frc971/electrical/README.md

This repo contains the electrical files for the 971 FRC team.
The files include PCBs and the electrical system diagrams.
The PCBs are created using KiCad.
