frc971/electrical/circuit-boards/Orin-NX-PCBs/MIPI2HDMI/README.md

Step file is made for mm and has .01mm accuracy.

Last Revision made on Nov 17 2023

For questions regarding the pcb or schematic contact Alex Lenkov or Scott Berman
