frc971/electrical/circuit-boards/IMU-2X-v3/IAM-20680HP-Orientation.png

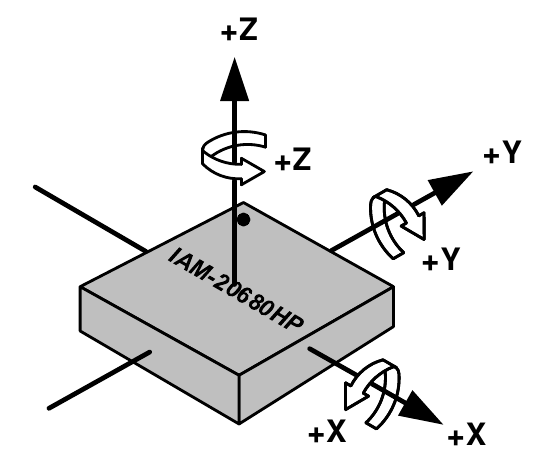
circuit-boards/IMU-2X-v3/IAM-20680HP-Orientation.png
