frc971/electrical/circuit-boards/IMU-2X-v3/SCHA63T-K03-Orientation.png

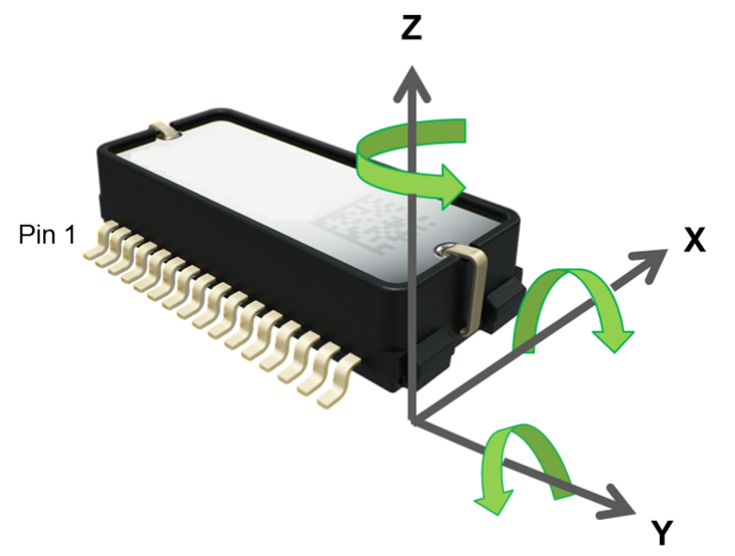
circuit-boards/IMU-2X-v3/SCHA63T-K03-Orientation.png
