frc971/electrical/circuit-boards/IMU-2X-v3/STM32G374CET6-Config.png

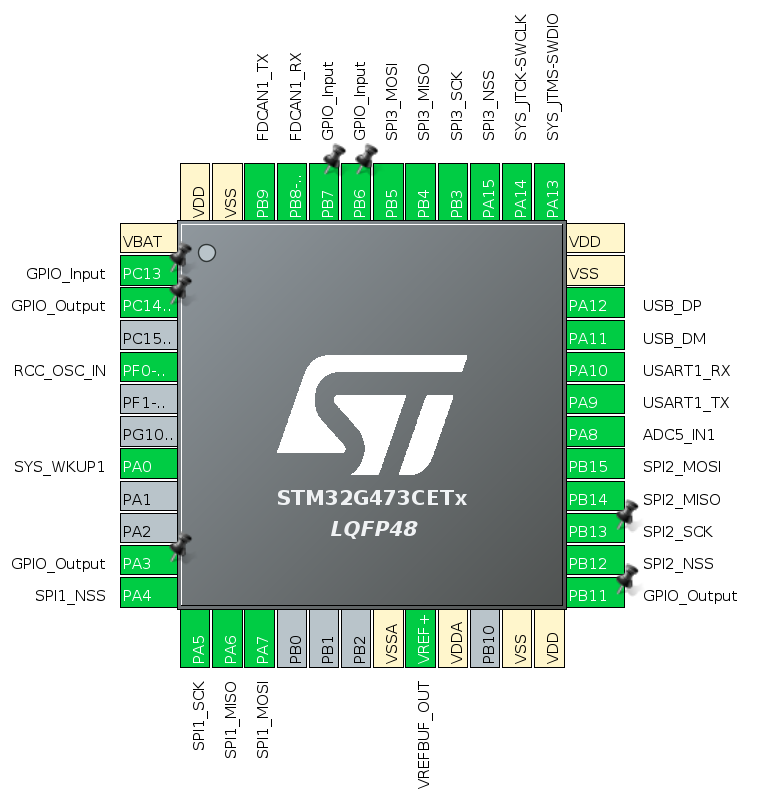
circuit-boards/IMU-2X-v3/STM32G374CET6-Config.png
