frc971/electrical/robots/2025/Driver Station/Harness Drawings/TX16S-Joystick-Input.png

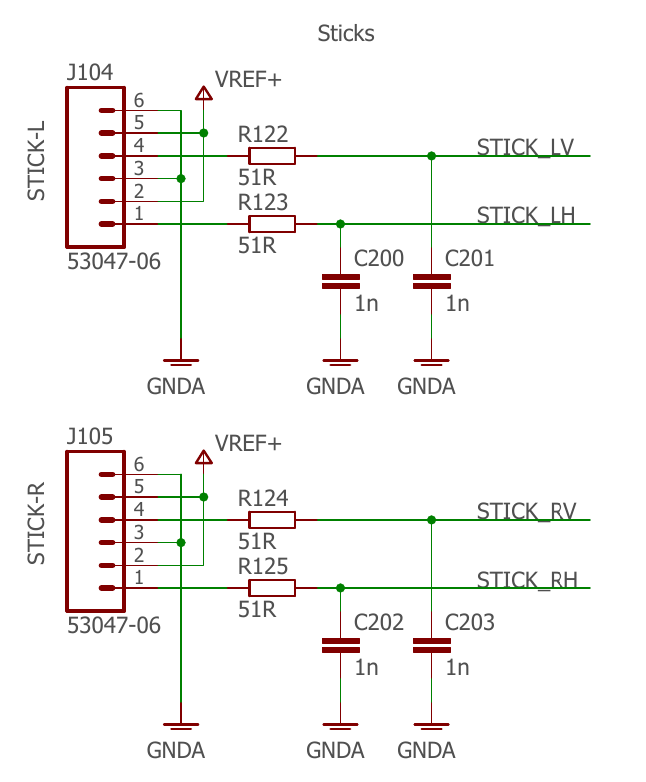
robots/2025/Driver Station/Harness Drawings/TX16S-Joystick-Input.png
