frc971/electrical/circuit-boards/IMU-2X-v3/Components/stm32-usb-c-pd-solutions-presentation.pdf

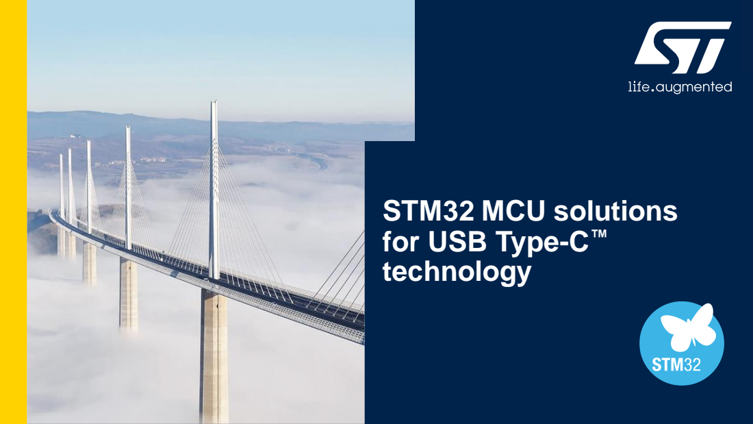
[picture p14: page 1]

STM32 MCU solutions
for USB Type-C™
technology

# Introduction to USB Type-C™ technology

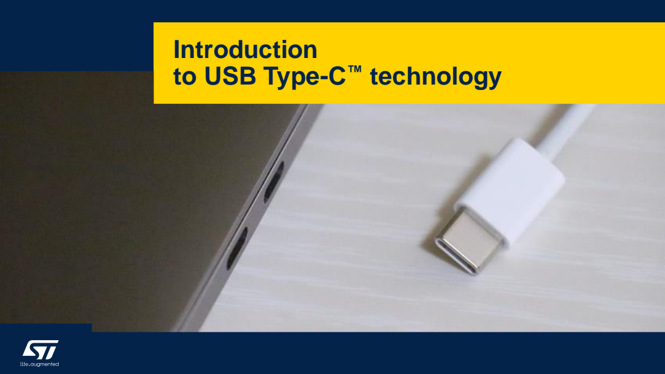
[picture p15: page 2]

# Visit our Wiki page on USB Type-C™

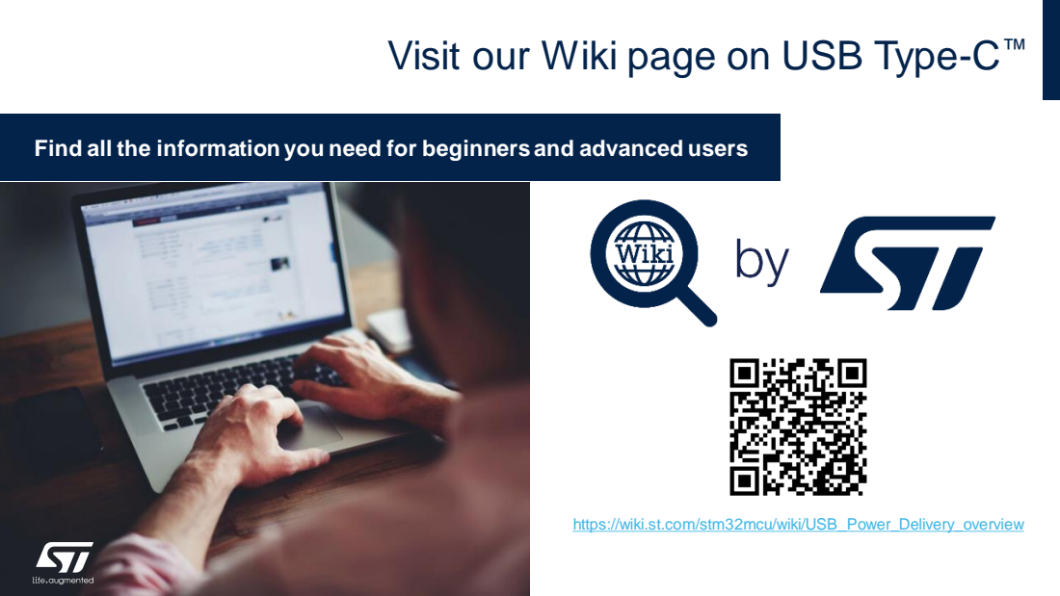
[picture p16: page 3]

Find all the information you need for beginners and advanced users

https://wiki.st.com/stm32mcu/wiki/USB_Power_Delivery_overview

# Main reasons to use USB Type-C™ in embedded devices

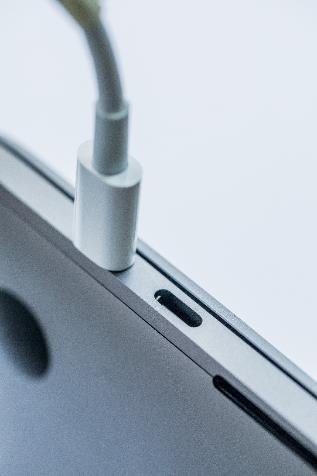
[picture p17: figure]

- Reversible, thinner and robust newest USB Type-C™ connector
- More interoperability: sink, source or dual role, while being host or device
- 15W @ 5V with Type-C only
- Up to 100W with USB Power Delivery (USB PD) 3.0 protocol
- Extend Power Range up to 240W @ 48V with USB PD 3.1
- Universal fast charging capability with PPS (Programming Power Supply)
- Separate channels for USB 2.0 (LS/FS/HS) and USB 3.x (SuperSpeed)
- Proprietary protocols are supported (DP, HDMI, Ethernet, Thunderbolt…)
- Device/source Authentication via USB PD (Vendor Define Messages)
- Firmware Update or Secure Firmware Install (SFI)
- Power swap capability (from sink to source or vise-versa)
- USB data swap capability (from device to host or vise versa as for OTG)

Purpose of the CC Channels: (Configuration & Communication channels): ➔ Manage the attachment of the
USB Type-C™ connector:
- Attach/detach and role management (Sink, Source, Dual Role Power) between two devices
- Discover and configure VBUS, VCONN
- Resolve cable orientation and twist connections to establish USB data bus routing
➔ Handle USB Power Delivery protocol

# USB Type-C™ pin outs functions

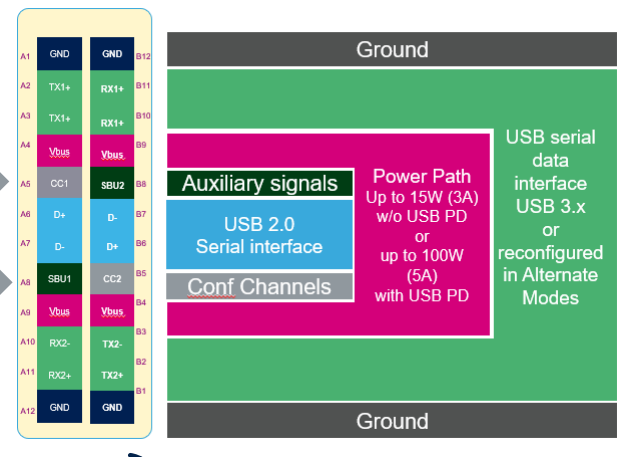
[picture p18: figure]

24-pin reversible USB Type-C™ receptacle

# USB Power Delivery

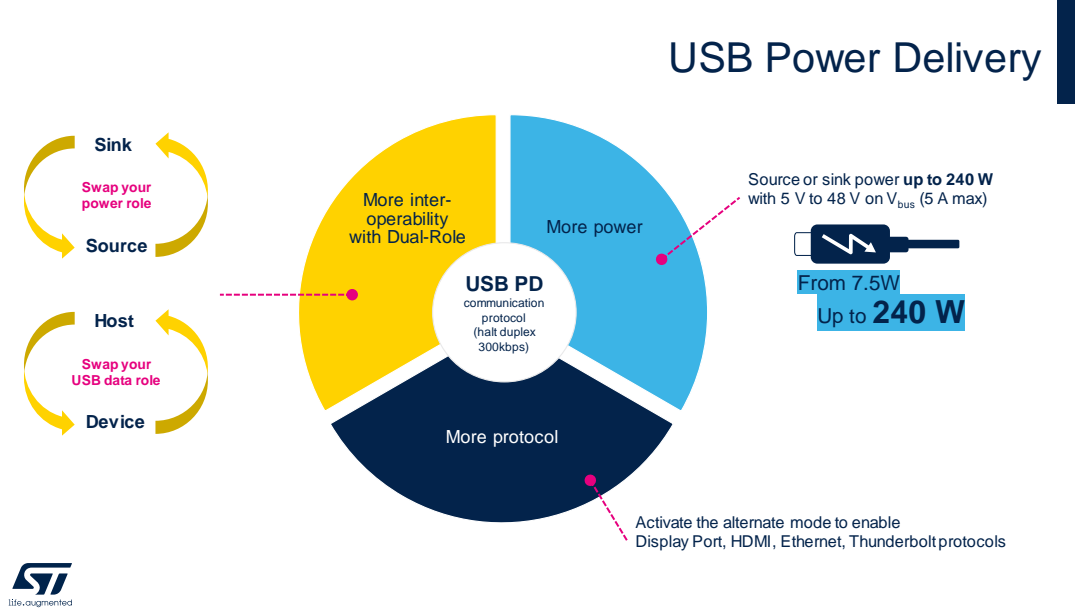
[picture p19: page 6]
More power; More protocol; USB PD; communication protocol (halt duplex 300kbps); Sink; Source; Swap your power role; Host; Device; From 7.5W

Source or sink power up to 240 W
with 5 V to 48 V on Vbus (5 A max)

More inter-
operability
with Dual-Role

Swap your
USB data role

Activate the alternate mode to enable
Display Port, HDMI, Ethernet, Thunderbolt protocols

# Main use-cases

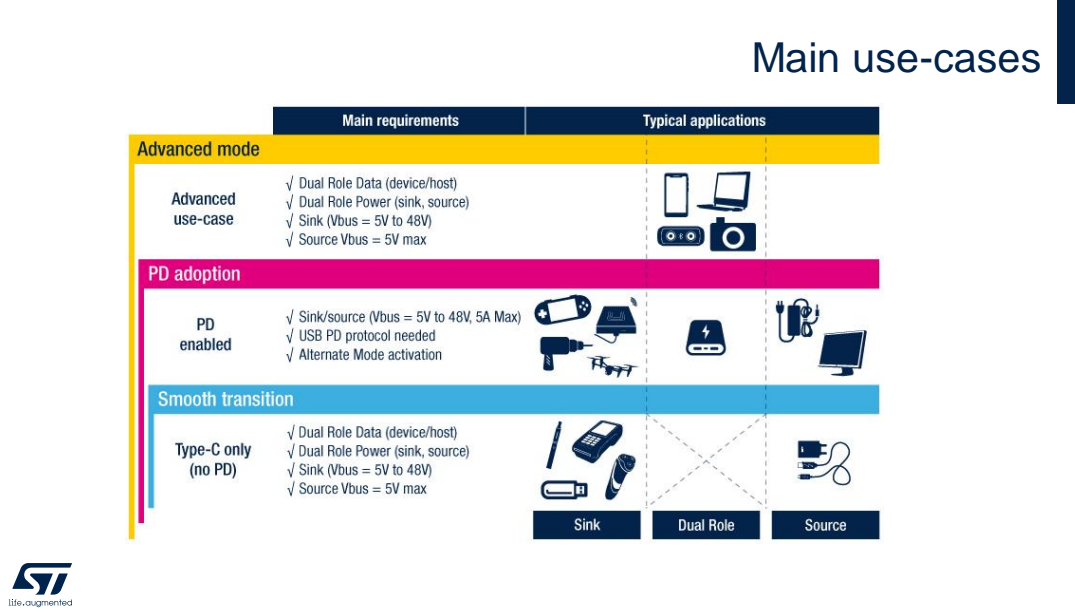
[picture p20: page 7]
Advanced mode; PD adoption; Smooth transition; Main requirements; Typical applications; Advanced use- case

• Dual Role Data (device/host) • Dual Role Power (sink, source) • Sink (Vbus = 5V to 48V) • Source Vbus = 5V max

PD enabled | • Sink/source (Vbus = 5v to 20v, 3A Max) • USB PD protocol needed • Alternate Mode activation

Type-C only (no PD) | • Connector reversibility • Attachment • Sink/source (Vbus = 5V, 3A Max) • USB 2.0 device or Host FS/HS Data

Sink | Dual Role | Source

- DRD is a category of devices such as smartphones and notebooks that can act as source or sink while being host or device for USB data communication purpose.
- It allows to extend interoperability by supporting advanced use-cases.
- Swap between power and data roles are done independently by using USB PD swap commands.
- DRD replaces and enhances “On-The-Go” becoming obsolete

# Dual Role Device (DRD)

Your Dual Role Device

Charger

no data

source

sink

Supply/recharge your device

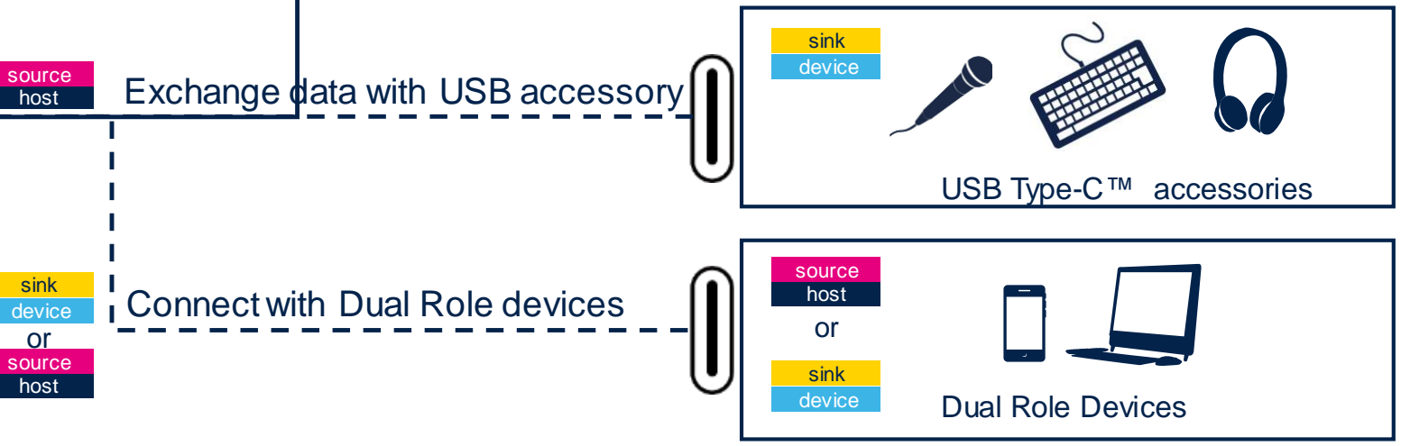
[picture p21: figure]
USB Type-C™ accessories; Dual Role Devices; device; sink; host; source; Exchange data with USB accessory; Connect with Dual Role devices

Sink

Source

Swap your
power role

Host

Device

Swap your
USB data role

# STM32 USB Type-C™ Solutions overview

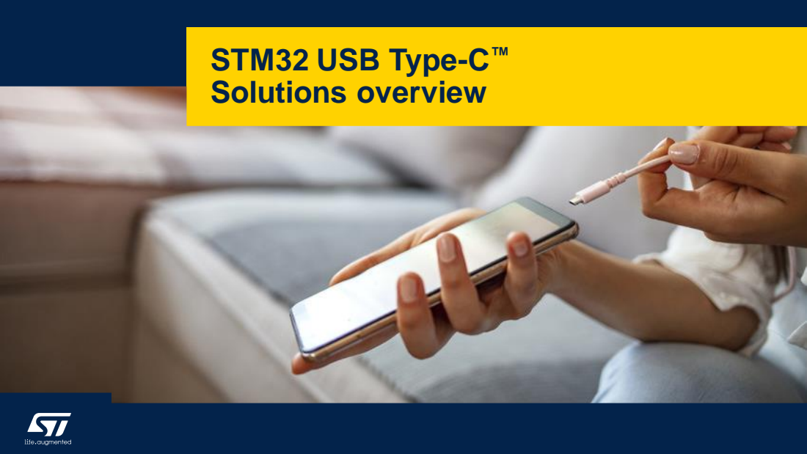
[picture p22: page 9]

# USB Type-C™ + PD3.1 Two solutions

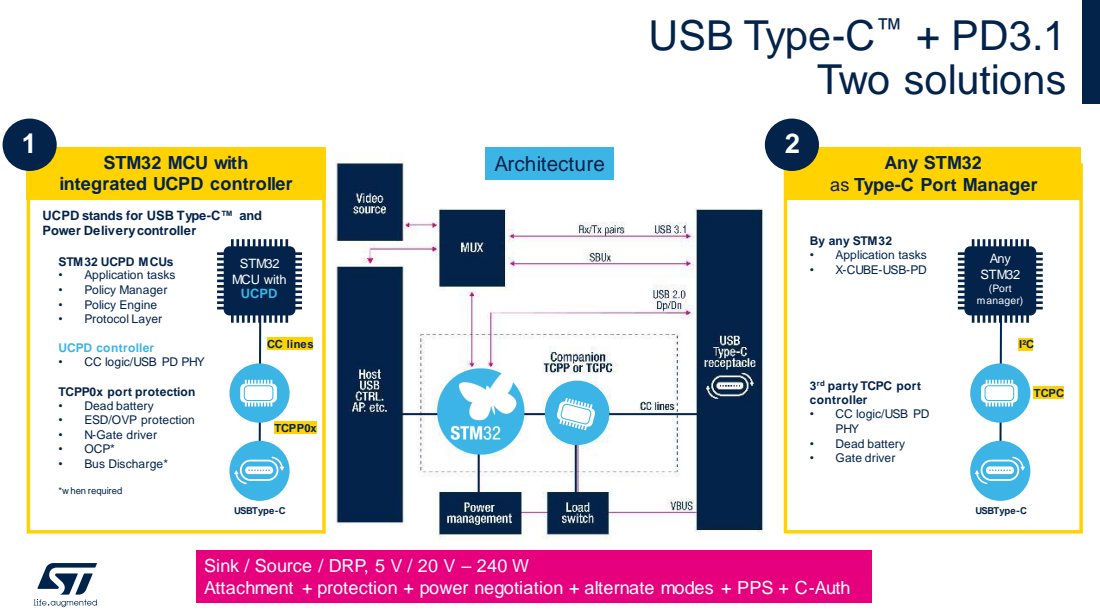
[picture p23: page 10]
Any STM32; STM32 UCPD MCUs • Application tasks • Policy Manager • Policy Engine • Protocol Layer; *w hen required; STM32 MCU with UCPD; CC lines; USBType-C; (Port manager); I²C; Architecture; TCPC; TCPP0x

STM32 MCU with
integrated UCPD controller

as Type-C Port Manager

UCPD stands for USB Type-C™ and
Power Delivery controller

By any STM32
• Application tasks
• X-CUBE-USB-PD

UCPD controller
• CC logic/USB PD PHY

TCPP0x port protection
• Dead battery
• ESD/OVP protection
• N-Gate driver
• OCP*
• Bus Discharge*

rd party TCPC port
controller
• CC logic/USB PD
PHY
• Gate driver

Sink / Source / DRP, 5 V / 20 V – 240 W
Attachment + protection + power negotiation + alternate modes + PPS + C-Auth

# Solution N°1: using STM32 MCU with integrated UCPD* controller

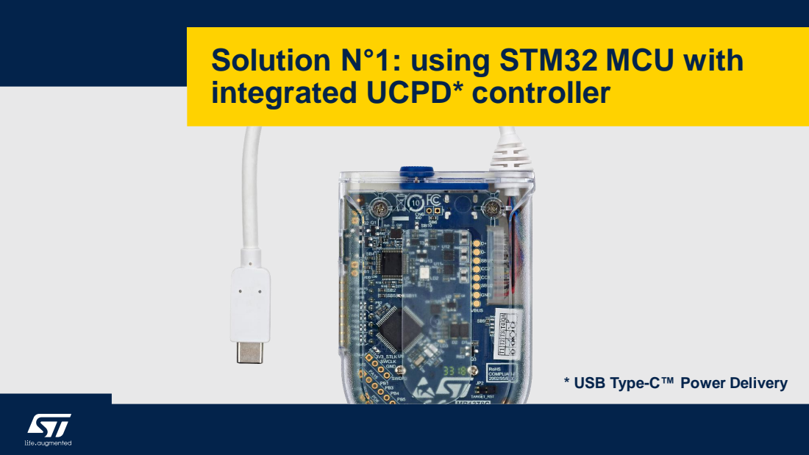
[picture p24: page 11]

* USB Type-C™ Power Delivery

# STM32, World 1st MCU with built-in UCPD controller

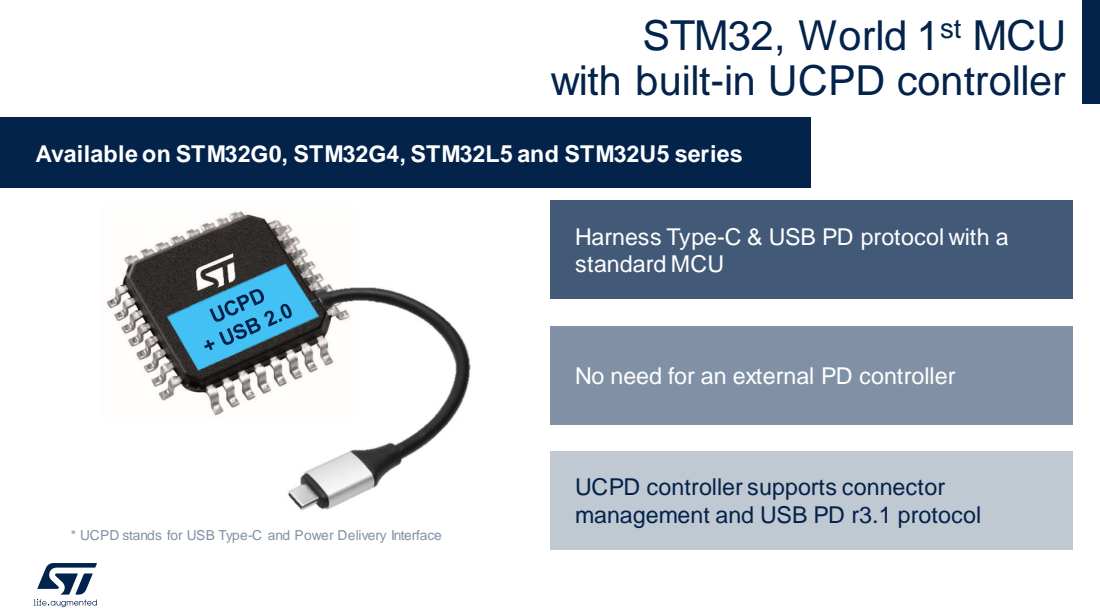
[picture p25: page 12]

Available on STM32G0, STM32G4, STM32L5 and STM32U5 series

Harness Type-C & USB PD protocol with a
standard MCU

No need for an external PD controller

UCPD controller supports connector
management and USB PD r3.1 protocol

* UCPD stands for USB Type-C and Power Delivery Interface

# Wide Range of STM32 UCPD MCUs

More than 411 Part Numbers propose UCPD
among STM32G0, STM32G4, STM32L5, STM32U5 series

1

st High Perf.
120 MHz, 90nm

2010

STM32F2

1

st High Perf.
Cortex-M4
168 MHz

2011

STM32F4

1

st Mixed Signal
DSP + Analog
STM32F3
Cortex-M4

Entry Cost
STM32F0
Cortex-M0

2012

STM32F0

STM32F3

Entry Cost
Ultra-low-power

2013

STM32L0

World 1st
Cortex-M7

2014

STM32F7

Leadership
Ultra-low-power
Cortex-M4
#1 ULP

447 ULPBench™

2015

STM32L4

#1

Performance
3224 CoreMark

Ultra-low-power
Excellence

2016

STM32L4+

STM32H7

Dual-core,
multiprotocol
and open radio

Introduction of
M33 Excellence
in ULP with
more security

Mainstream
Cortex-M0+
MCUs Efficiency
at its best!

2017/2018

STM32WB

STM32L5

STM32G0

2019

Dual-core
Microprocessor
among the STM32

World’s Most
Powerful MCU

STM32H7

STM32G4

STM32MP1

Mixed-signal
Cortex-M4
MCUs

2020

The world’s first
LoRa®-enabled
System-on-Chip

STM32WL

2007*/2009

World 1st
Cortex-M MCU

STM32F1*

World 1st
Cortex-M
Ultra-low-power

STM32L1

The flagship
ultra-low-power
MCUs

STM32U5

2021

# Find UCPD ready STM32 easily with STM32Finder app

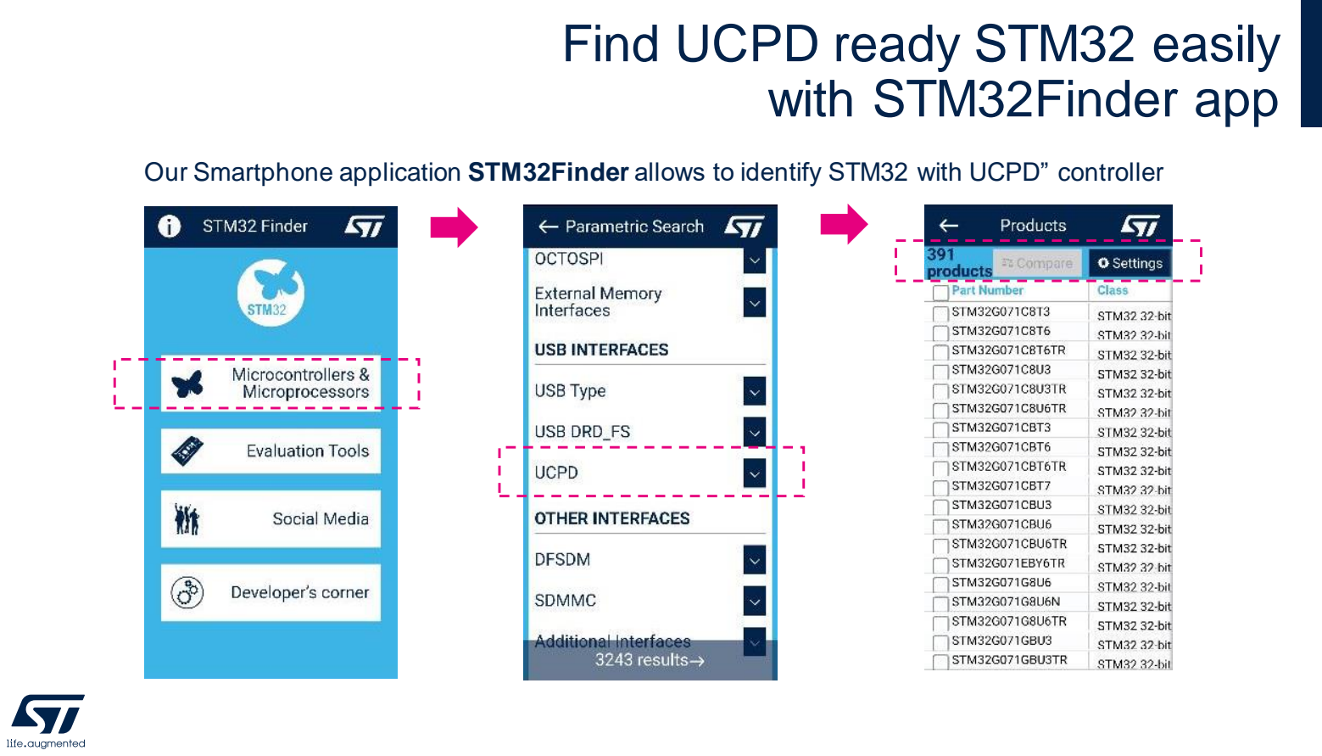
[picture p26: page 14]

Our Smartphone application STM32Finder allows to identify STM32 with UCPD” controller

# UCPD highlights

Example in STM32G0x1 access line

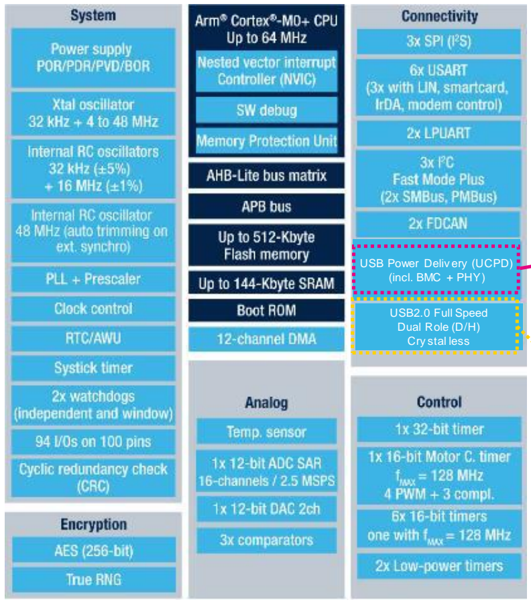
[picture p27: figure]
USB Power Deliv ery (UCPD) (incl. BMC + PHY); USB2.0 Full Speed Dual Role (D/H) Cry stal less

- Dual port certified solution (TID 227)
- Support sink, source and Dual Role
- CC logic control and voltage monitoring
- Built-in Rp/Rd and dead battery resistors
- USB PD transceiver PHY
- Digital BMC / CRC encoding/decoding
- Support Programming Power Supply (PPS)
- Enable Fast Role Swap signaling (FRS)

USB2.0 Dual Role Data interface

UCPD main features

- USB2.0 data interface (FS, HS)
- Dual-Role mode supported (Device/Host)
- Crystal-less

x 2

# Cost effective partitioning with USB Type-C™ Port Protection devices

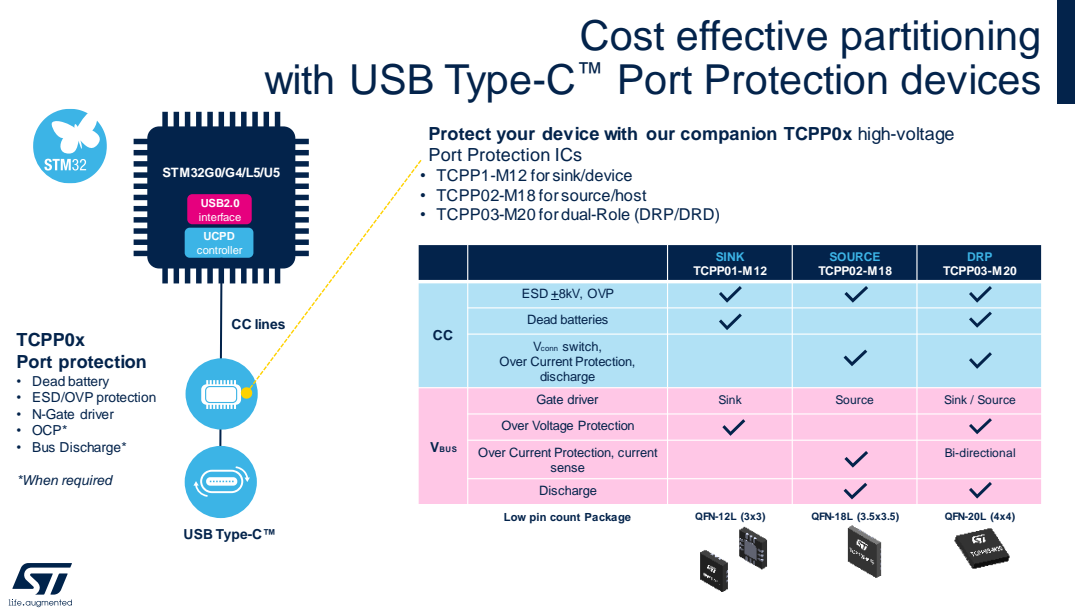
[picture p28: page 16]
STM32G0/G4/L5/U5; USB2.0 interface; UCPD controller; CC lines; USB Type-C™; *When required

Protect your device with our companion TCPP0x high-voltage
Port Protection ICs
• TCPP1-M12 for sink/device
• TCPP02-M18 for source/host
• TCPP03-M20 for dual-Role (DRP/DRD)

SINK TCPP01-M12 | SOURCE TCPP02-M18 | DRP TCPP03-M20

CC | ESD +8kV, OVP

Dead batteries

TCPP0x
Port protection
• Dead battery
• ESD/OVP protection
• N-Gate driver
• OCP*
• Bus Discharge*

Vconn switch, Over Current Protection, discharge

VBUS | Gate driver | Sink | Source | Sink / Source

Over Voltage Protection

Over Current Protection, current sense | | | Bi-directional

Discharge

Low pin count Package | QFN-12L (3x3) | QFN-18L (3.5x3.5) | QFN-20L (4x4)

# Sink with TCPP01-M12

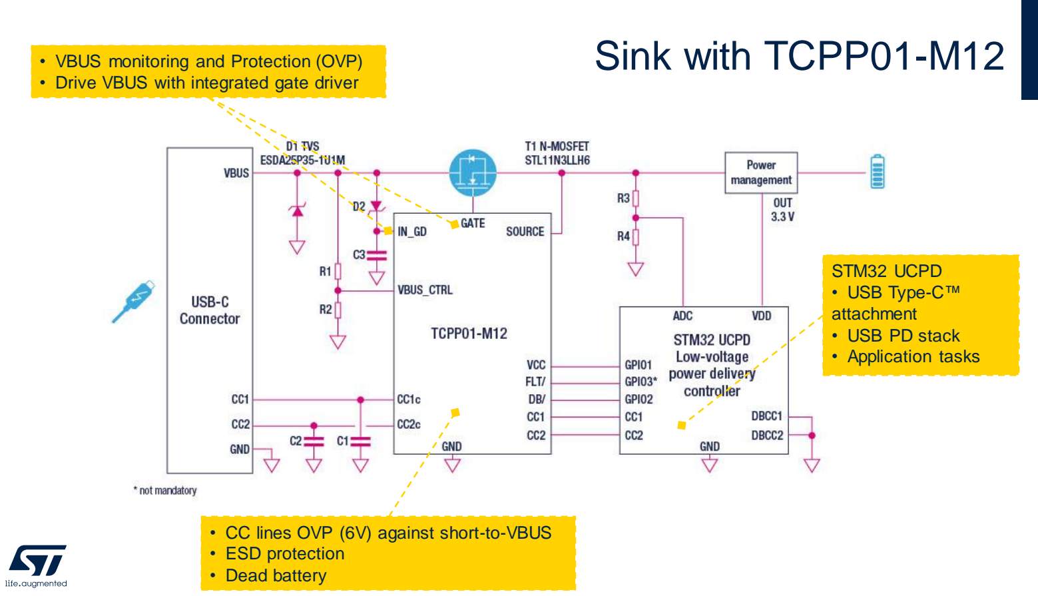
[picture p29: page 17]

- CC lines OVP (6V) against short-to-VBUS
- ESD protection
- Dead battery
- VBUS monitoring and Protection (OVP)
- Drive VBUS with integrated gate driver

STM32 UCPD
- USB Type-C™
attachment
- USB PD stack
- Application tasks

# Dual Role with TCPP03-M20

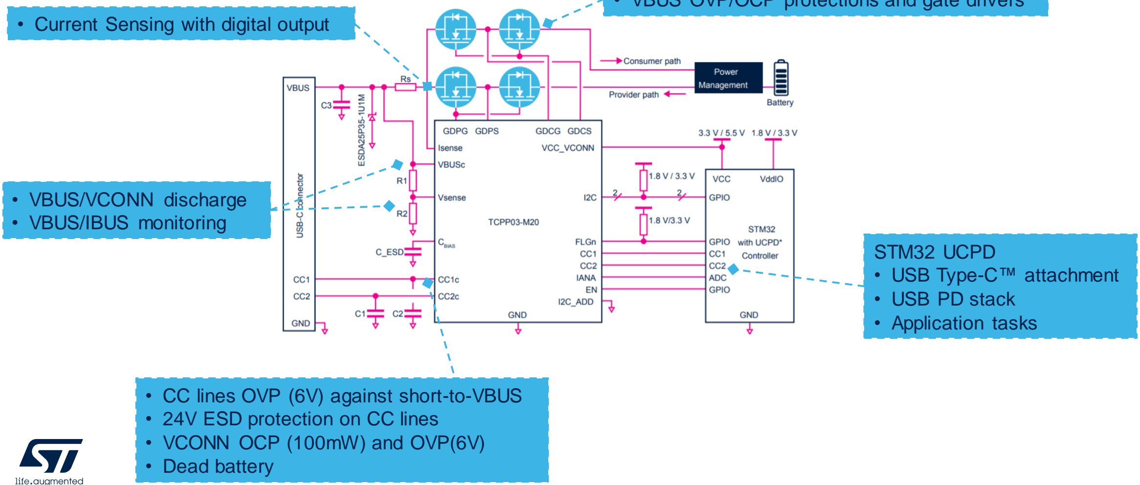
[picture p30: figure]
• 24V ESD protection on CC lines • VCONN OCP (100mW) and OVP(6V) • Dead battery; STM32 UCPD • USB Type-C™ attachment • USB PD stack • Application tasks; • VBUS/VCONN discharge • VBUS/IBUS monitoring; • Current Sensing with digital output

- CC lines OVP (6V) against short-to-VBUS
- VBUS OVP/OCP protections and gate drivers

# Source with TCPP02-M18

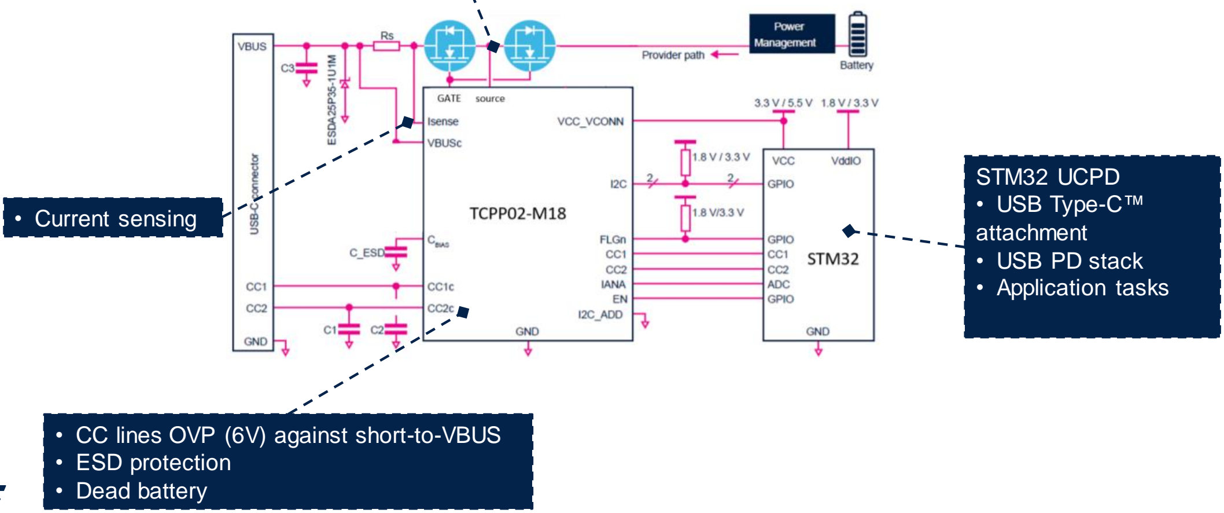
[picture p31: figure]
• ESD protection • Dead battery; STM32 UCPD • USB Type-C™ attachment • USB PD stack • Application tasks; • Current sensing

- CC lines OVP (6V) against short-to-VBUS
- VBUS monitoring, OVP/OCP protections
- Integrated gate driver
- Integrated discharge for VBUS and VCONN

# Quick evaluation with STM32 Nucleo USB Type-C™ expansion boards

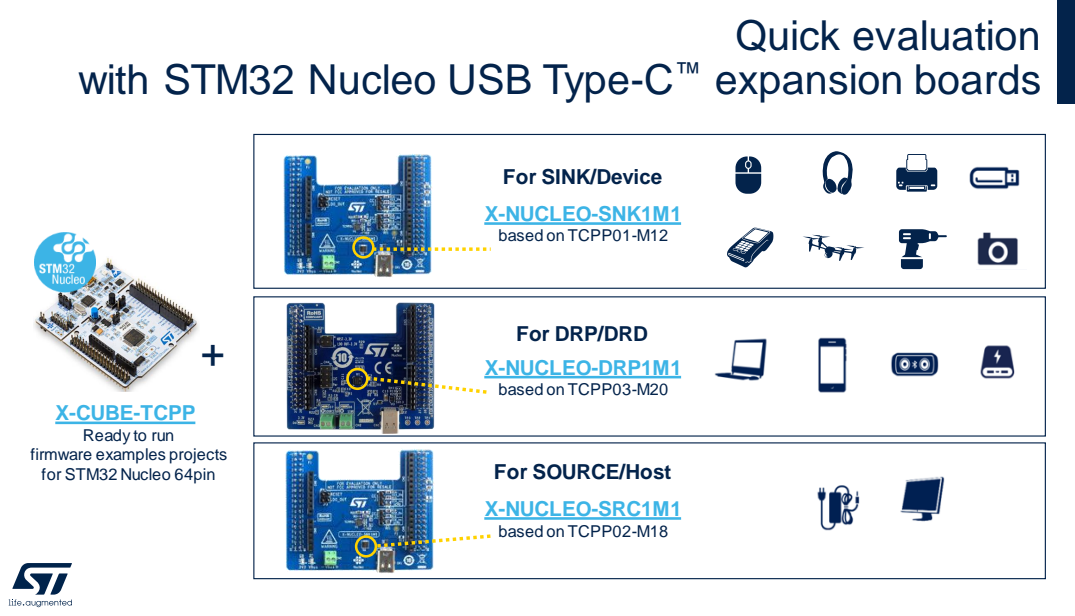
[picture p32: page 20]

For SINK/Device
X-NUCLEO-SNK1M1 (https://www.st.com/en/ecosystems/x-nucleo-snk1m1.html)
based on TCPP01-M12

For DRP/DRD
X-NUCLEO-DRP1M1 (https://www.st.com/content/st_com/en/products/ecosystems/stm32-open-development-environment/stm32-nucleo-expansion-boards/stm32-ode-connect-hw/x-nucleo-drp1m1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)
based on TCPP03-M20

X-CUBE-TCPP (https://www.st.com/en/embedded-software/x-cube-tcpp.html)
Ready to run

firmware examples projects
for STM32 Nucleo 64pin

For SOURCE/Host
X-NUCLEO-SRC1M1 (https://www.st.com/content/ccc/resource/technical/document/user_manual/group2/bf/f2/69/55/78/a6/47/1a/DM00841905/files/DM00841905.pdf/jcr:content/translations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)
based on TCPP02-M18

# Fast development with STM32Cube USB Type-C™ ecosystem

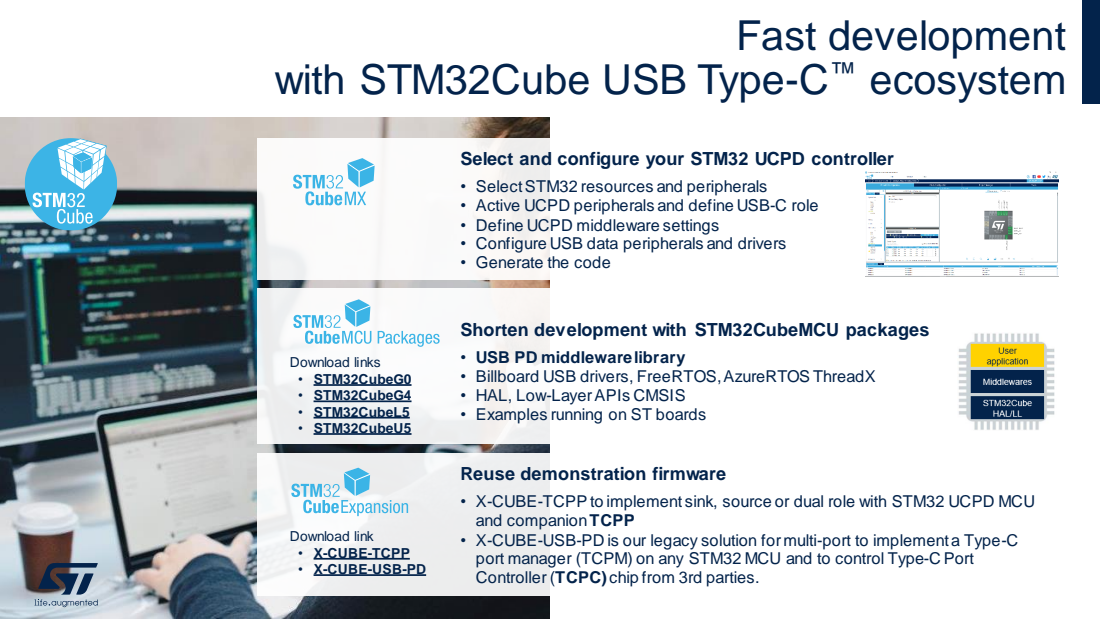
[picture p33: page 21]
Download links • STM32CubeG0 • STM32CubeG4 • STM32CubeL5 • STM32CubeU5; Controller (TCPC) chip from 3rd parties.

Select and configure your STM32 UCPD controller
• Select STM32 resources and peripherals
• Active UCPD peripherals and define USB-C role
• Define UCPD middleware settings
• Configure USB data peripherals and drivers
• Generate the code

Shorten development with STM32CubeMCU packages
• USB PD middleware library
• Billboard USB drivers, FreeRTOS, AzureRTOS ThreadX
• HAL, Low-Layer APIs CMSIS
• Examples running on ST boards

Reuse demonstration firmware
• X-CUBE-TCPP to implement sink, source or dual role with STM32 UCPD MCU
and companion TCPP
• X-CUBE-USB-PD is our legacy solution for multi-port to implement a Type-C
port manager (TCPM) on any STM32 MCU and to control Type-C Port

Download link
• X-CUBE-TCPP (https://www.st.com/en/embedded-software/x-cube-tcpp.html)
• X-CUBE-USB-PD (https://www.st.com/content/st_com/en/products/embedded-software/mcu-mpu-embedded-software/stm32-embedded-software/stm32cube-expansion-packages/x-cube-usb-pd.h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)

# Monitor your design with STM32 USB Type-C™ tools

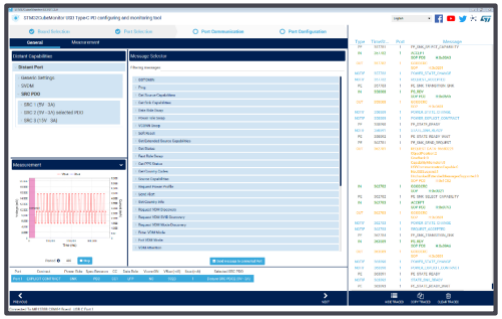
[picture p34: figure]

STM32CubeMonUCPD, (https://www.st.com/en/development-tools/stm32cubemonucpd.html) a free software monitoring and configuring tools for USB Type-C™ applications

- Support of USB Type-C™1.2 and USB PD r3.1
- Port configuration pane for PD setting, VDM, SOP, Source and Sink Capabilities
- Port communication pane for VBUS and IBUS monitoring, distant port capabilities, message selector, and real-time traces

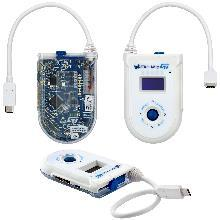
[picture p35: figure]

STM32G071B-DISCO (https://www.st.com/en/evaluation-tools/stm32g071b-disco.html) is a USB Type-C™ and PD sniffer

- Discover, display USB Type-C™power and feature capabilities of any host.
- Sniff USB PD data packets and display Vbus voltage, Ibus current
- Debug, configure and inject USB PD3.1 packet using STM32CubeMonitor UCPD

# Hardware tools & reference designs

SOLUTIONS | STM32F0 | STM32G0 | STM32G4 | STM32L5 | STM32U5
USB Type-C™ to DisplayPort™ adapter | STEVAL-USBC2DP (https://www.st.com/content/st_com/en/products/evaluation-tools/solution-evaluation-tools/communication-and-connectivity-solution-eval-boards/steval-usbc2dp.html)
TCPM/TCPC | ON-FUSB3-STM32 (https://www.st.com/content/st_com/en/products/evaluation-tools/product-evaluation-tools/mcu-mpu-eval-tools/stm32-mcu-mpu-eval-tools/stm32-3rd-party-evaluation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) (with 3rd party TCPC)
AC/DC USB PD Power Adapter | STEVAL-USBPD45C (https://www.st.com/content/st_com/en/products/evaluation-tools/solution-evaluation-tools/psu-and-converter-solution-eval-boards/steval-usbpd45c.html) (45W) | STEVAL-USBPD27S (https://www.st.com/content/st_com/en/products/evaluation-tools/solution-evaluation-tools/psu-and-converter-solution-eval-boards/steval-usbpd27s.html) (27W / PPS ready) STEVAL-2STPD01 (https://www.st.com/en/evaluation-tools/steval-2stpd01.html) (2x 60W)
USB Type-C™ Discovery kits | | STM32G071B-DISCO (https://www.st.com/content/st_com/en/products/evaluation-tools/product-evaluation-tools/mcu-mpu-eval-tools/stm32-mcu-mpu-eval-tools/stm32-discovery-kits/stm32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) (USB-C Sniffer/Analyzer) | B-G474E-DPOW1 (https://www.st.com/content/st_com/en/products/evaluation-tools/product-evaluation-tools/mcu-mpu-eval-tools/stm32-mcu-mpu-eval-tools/stm32-discovery-kits/b-g47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) 1 port DRP | STM32L562E-DK (https://www.st.com/en/evaluation-tools/stm32l562e-dk.html) 1 port SNK | B-U585I-IOT02A (https://www.st.com/en/evaluation-tools/b-u585i-iot02a.html) 1 port DRP
Evaluation boards | | STM32G0C1E-EV (https://www.st.com/content/st_com/en/products/evaluation-tools/product-evaluation-tools/mcu-mpu-eval-tools/stm32-mcu-mpu-eval-tools/stm32-eval-boards/stm32g08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) 1 port 45W DRP 1 port Sink | STM32G474E-EVAL (https://www.st.com/content/st_com/en/products/evaluation-tools/product-evaluation-tools/mcu-mpu-eval-tools/stm32-mcu-mpu-eval-tools/stm32-eval-boards/stm32g47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) featuring 1 port DRP | STM32L552E-EVAL (https://www.st.com/en/evaluation-tools/stm32l552e-ev.html) 1 port SNK | STM32U575I-EV (https://www.st.com/en/evaluation-tools/stm32u575i-ev.html) 1 port DRP
Nucleo board Nucleo shield | P-NUCLEO-USB002 (https://www.st.com/content/st_com/en/products/evaluation-tools/solution-evaluation-tools/communication-and-connectivity-solution-eval-boards/p-nucleo-usb002.h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) 1 port DRP with STM32F072RBT6 + STUSB1602 | X-NUCLEO-SNK1M1 (https://www.st.com/content/st_com/en/products/ecosystems/stm32-open-development-environment/stm32-nucleo-expansion-boards/stm32-ode-power-drive-hw/x-nucleo-us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) X-NUCLEO-DRP1M1 (https://www.st.com/content/st_com/en/products/ecosystems/stm32-open-development-environment/stm32-nucleo-expansion-boards/stm32-ode-connect-hw/x-nucleo-drp1m1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) X-NUCLEO-SRC1M1 (https://www.st.com/en/ecosystems/x-nucleo-src1m1.html) | X-NUCLEO-SNK1M1 X-NUCLEO-DRP1M1 (https://www.st.com/content/st_com/en/products/ecosystems/stm32-open-development-environment/stm32-nucleo-expansion-boards/stm32-ode-connect-hw/x-nucleo-drp1m1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) X-NUCLEO-SRC1M1 (https://www.st.com/en/ecosystems/x-nucleo-src1m1.html) | NUCLEO-L552ZE-Q (https://www.st.com/content/st_com/en/products/evaluation-tools/product-evaluation-tools/mcu-mpu-eval-tools/stm32-mcu-mpu-eval-tools/stm32-nucleo-boards/nucleo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) 1 port SNK | NUCLEO-U575ZI-Q (https://www.st.com/en/evaluation-tools/nucleo-u575zi-q.html) 1 port SNK

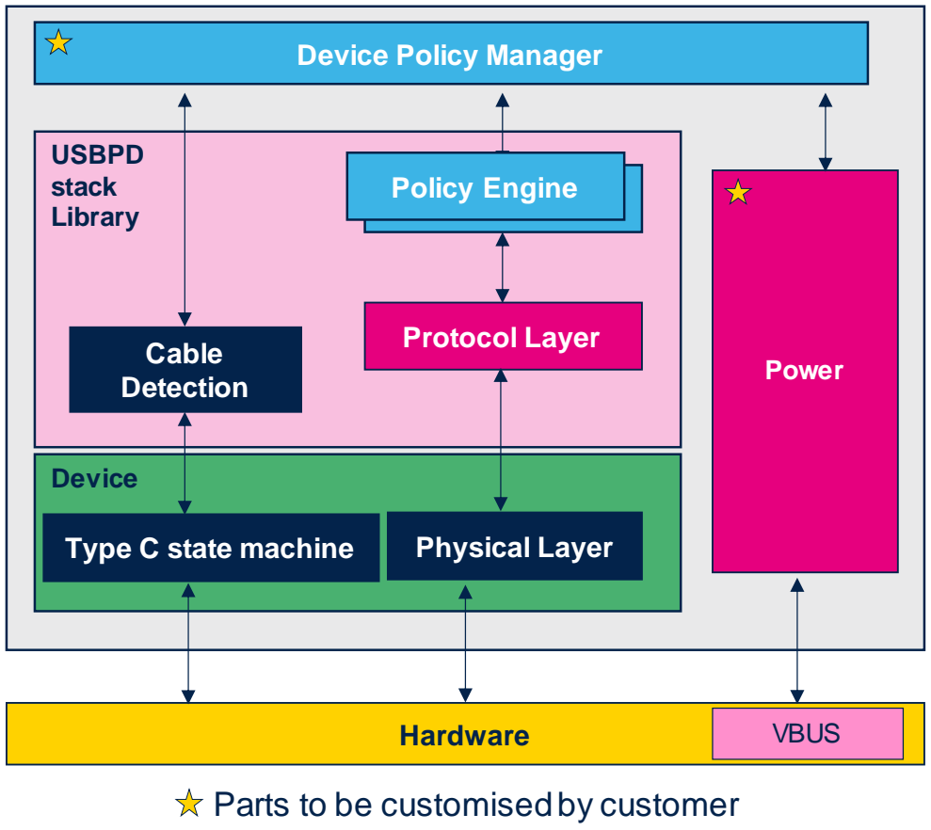
[picture p36: figure]
Device; Power; USBPD stack Library; Device Policy Manager; Policy Engine; Protocol Layer; Hardware; VBUS; Cable Detection; Type C state machine; Physical Layer; Parts to be customisedby customer

- Available in STM32CubeMCU packages
- Compliant with USB Type-C™ 1.2 and USB PD r3.1
- Embeds the Policy Engine, Protocol Layer, Physical Layer, USB-C port Control
- Applies for STM32 UCPD or TCPM/TCPC implementation
- Policy engine includes 3 state machines (SRC, SNK, cable).
- User application customization is done in the Device Policy manager
- A set of API (get VBUS, set VBUS) and utilities (tracer, low power manager, power monitor) are available for maximum of usability

# High level of customization with ST USBPD Middleware

# USB PD power adapter

### 27 W PD3.0/PPS Power adapter with STM32G0

Key Features
- Universal input mains voltage range
- Two fixed PDOs: 5V @ 5A, 9V @ 3A
- Two APDOs for PPS
- Adaptive synchronous rectification, MCU-driven
- Energy efficiency compliant with CoC Tier 2 and DoE Level VI
- Full Load Efficiency 89,4% at 230VAC input
- < 40 mW no-load standby power

Key Products
- Primary Side Controller: STCH03
- USB PD and SR Controller: STM32G0
- Primary MOSFET: STD7N65M6, Load Switch: STL11N3LLH6
- ESD and CC Lines protections + Gate Driver: TCPP01-M12

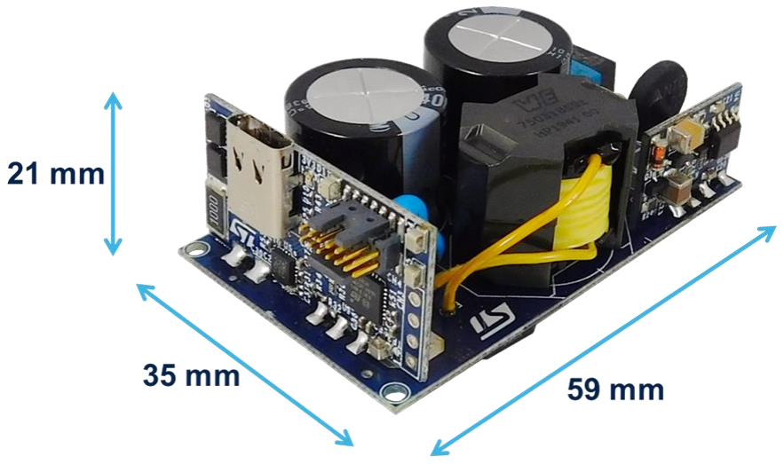
[picture p37: figure]

- High performance LDO: LDK320 | Board ref: STEVAL-USBPD27S (https://www.st.com/en/evaluation-tools/steval-2stpd01.html)

# Step by Step tutorial

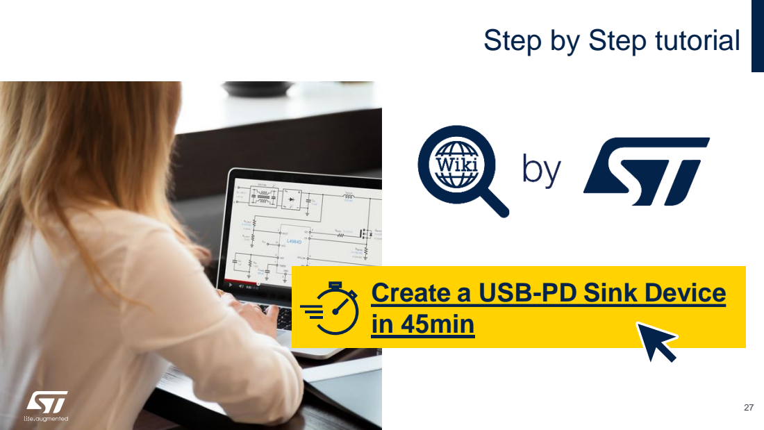
[picture p38: page 26]

Create a USB-PD Sink Device
in 45min (https://wiki.st.com/stm32mcu/wiki/STM32StepByStep:STM32_Advance_USB-Power_Delivery_Sink)

# Solution N°2 STM32 as Type-C Port Manager

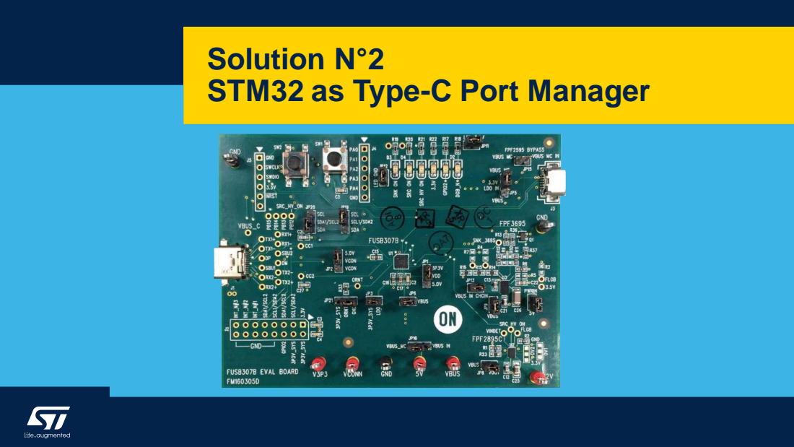
[picture p39: page 27]

# X-CUBE-USB-PD for Type-C Port Manager on any STM32

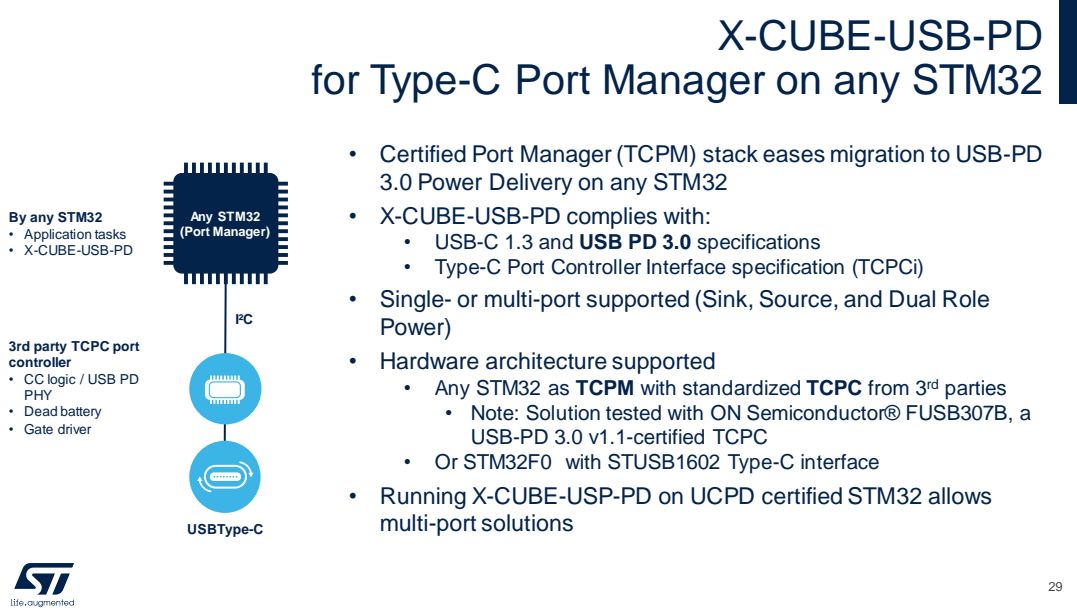
[picture p40: page 28]
Any STM32 (Port Manager); I²C; USBType-C

• Certified Port Manager (TCPM) stack eases migration to USB-PD
3.0 Power Delivery on any STM32
• X-CUBE-USB-PD complies with:
• USB-C 1.3 and USB PD 3.0 specifications
• Type-C Port Controller Interface specification (TCPCi)
• Single- or multi-port supported (Sink, Source, and Dual Role
Power)
• Hardware architecture supported
• Any STM32 as TCPM with standardized TCPC from 3rd parties
• Note: Solution tested with ON Semiconductor® FUSB307B, a
USB-PD 3.0 v1.1-certified TCPC

By any STM32
• Application tasks
• X-CUBE-USB-PD

3rd party TCPC port
controller
• CC logic / USB PD
PHY
• Dead battery
• Gate driver

• Or STM32F0 with STUSB1602 Type-C interface
• Running X-CUBE-USP-PD on UCPD certified STM32 allows
multi-port solutions

# Benefits of TCPM / TCPC split

Optimized HW/SW partitioning for single- or multi-port

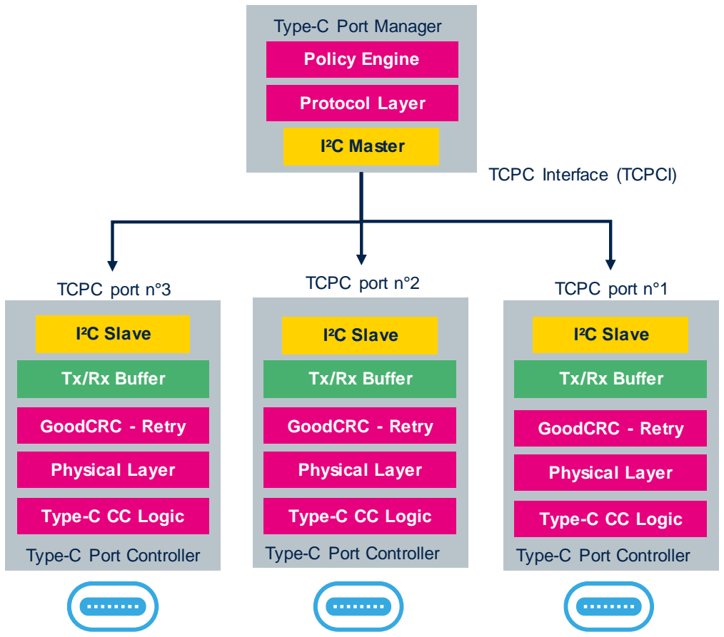
[picture p41: figure]
TCPC port n; TCPC port n°1; °2 TCPC port n°3; Tx/Rx Buffer; GoodCRC - Retry; Physical Layer; Type-C CC Logic; I²C Slave; Type-C Port Controller; I²C Master; Policy Engine; Protocol Layer; Type-C Port Manager; TCPC Interface (TCPCI)

- The STM32 provides a high customization and
flexibility to manage power policy, application layers.
- TCPCI interface provides a low pin count interconnect using Fast-Mode Plus I²C (1 MHz) bus, plus one alert line, and a comprehensive set of TCPC registers making stack porting across STM32 platform easier.
- TCPC provides the “Power Path” and integrate components with fast latency requirements as well as USB-C/PD PHY, Vconn, dead battery and protection.

# Features and memory footprint

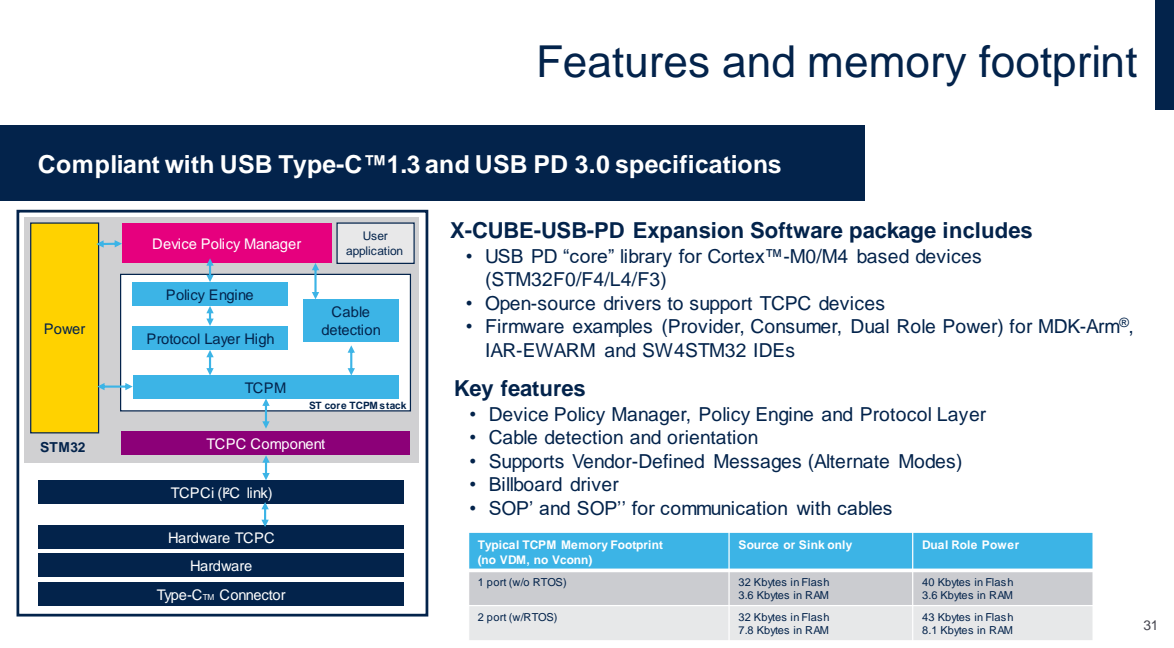
[picture p42: page 30]
Power; Device Policy Manager; User; application; TCPC Component; Hardware TCPC; Hardware; Policy Engine; Cable detection; TCPM; STM32

Compliant with USB Type-C™1.3 and USB PD 3.0 specifications

X-CUBE-USB-PD Expansion Software package includes
• USB PD “core” library for Cortex™-M0/M4 based devices
(STM32F0/F4/L4/F3)
• Open-source drivers to support TCPC devices
• Firmware examples (Provider, Consumer, Dual Role Power) for MDK-Arm®,
IAR-EWARM and SW4STM32 IDEs
Key features
• Device Policy Manager, Policy Engine and Protocol Layer
• Cable detection and orientation
• Supports Vendor-Defined Messages (Alternate Modes)
• Billboard driver
• SOP’ and SOP’’ for communication with cables

Protocol Layer High

ST core TCPM stack

TCPCi (I²C link)

Typical TCPM Memory Footprint (no VDM, no Vconn) | Source or Sink only | Dual Role Power

1 port (w/o RTOS) | 32 Kbytes in Flash 3.6 Kbytes in RAM | 40 Kbytes in Flash 3.6 Kbytes in RAM

Type-CTM Connector

2 port (w/RTOS) | 32 Kbytes in Flash 7.8 Kbytes in RAM | 43 Kbytes in Flash 8.1 Kbytes in RAM

# STM32F072 Type-C port manager evaluation board

TCPM/TCPC evaluation board

Key features

- 1 USB Type-C™ port
- Sink, Source, and DRP capability
- STM32F072CBT6, 32-bit Arm® Cortex®-M0 MCU as TCPM
- ON Semiconductor® FUSB307B Type-C port controller
- On-board power management and dedicated power connector to interface with an external power supply
- Order one kit (149$ range): Click here (https://www.onsemi.com/support/evaluation-board/fusb307bgevb)

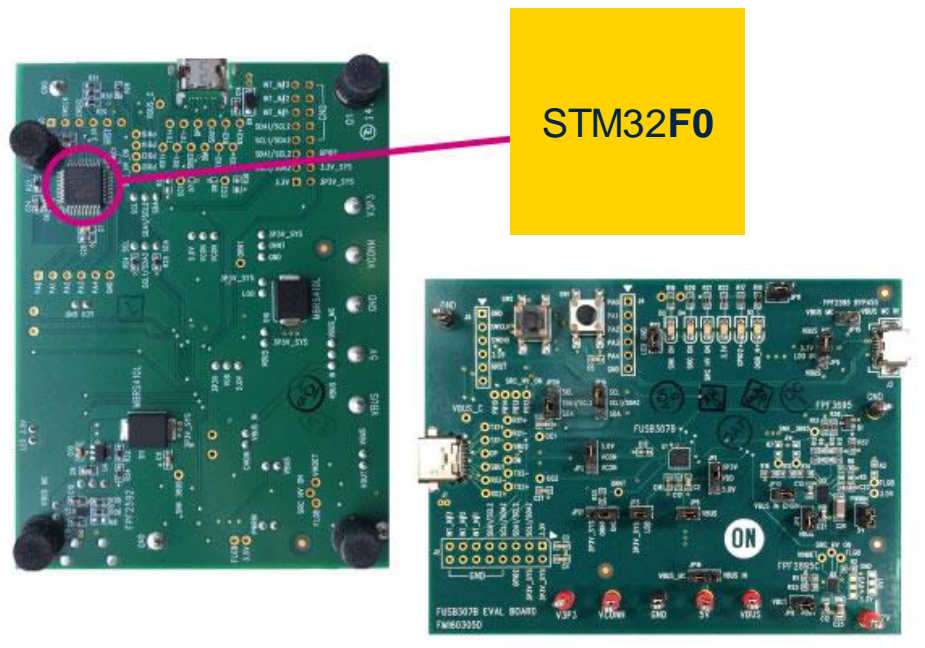
[picture p43: figure]
STM32F0

Board ref: ON-FUSB3-STM32 (https://www.st.com/en/evaluation-tools/on-fusb3-stm32.html)

# Releasing your creativity

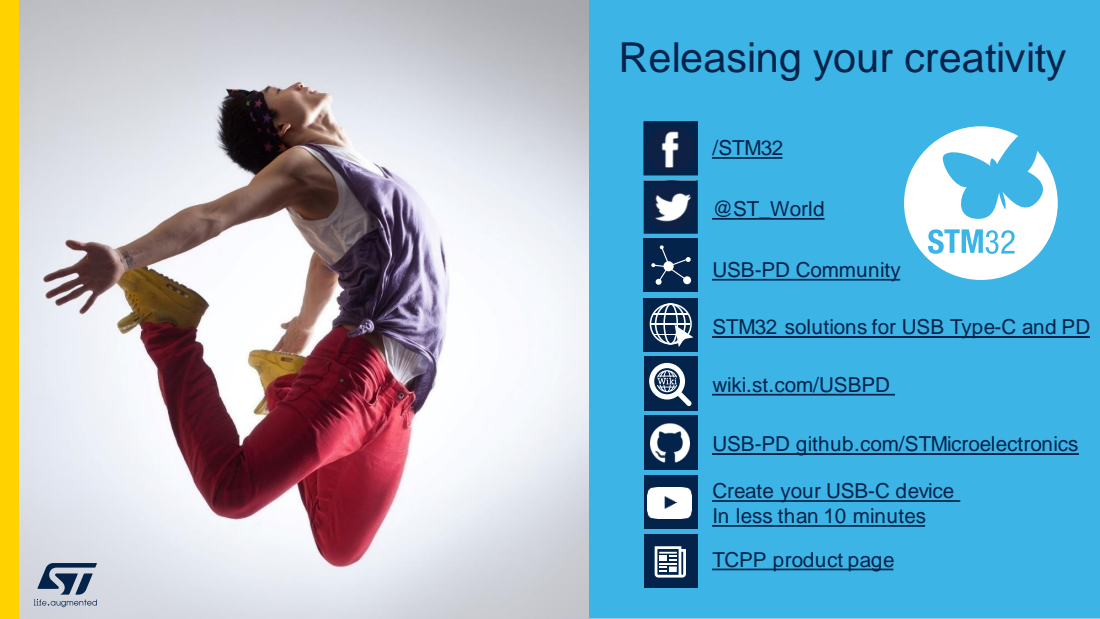
[picture p44: page 32]
@ST_World; /STM32

USB-PD Community (https://community.st.com/s/topic/0TO0X0000003bIOWAY/usb-pd)

STM32 solutions for USB Type-C and PD (https://www.st.com/content/st_com/en/ecosystems/stm32-usb-c.html?ecmp=tt21056_gl_link_may2021)

wiki.st.com/USBPD (https://wiki.st.com/stm32mcu/wiki/Category:USB_Power_Delivery)

USB-PD github.com/STMicroelectronics (https://github.com/STMicroelectronics/x-cube-usb-pd)

Create your USB-C device
In less than 10 minutes (https://www.youtube.com/watch?v=Z_Sn6CBbz-k)

TCPP product page (https://www.st.com/content/st_com/en/products/protection-devices/esd-protection/usb-port-protection/tcpp01-m12.html)

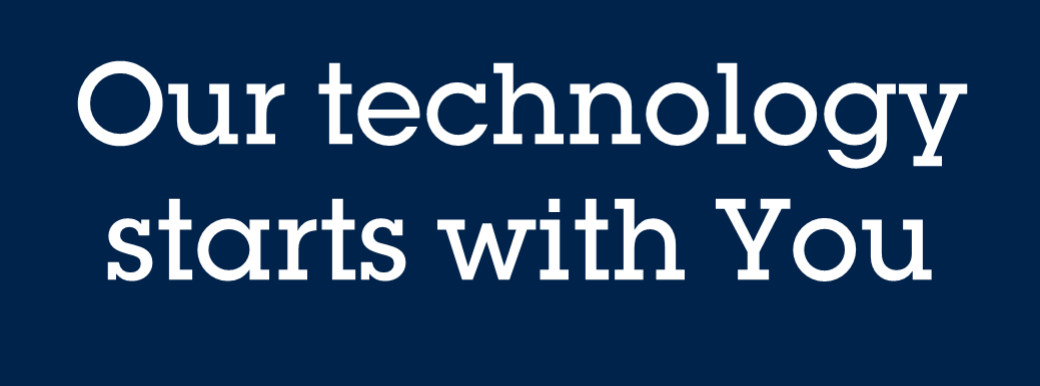
[picture p45: figure]
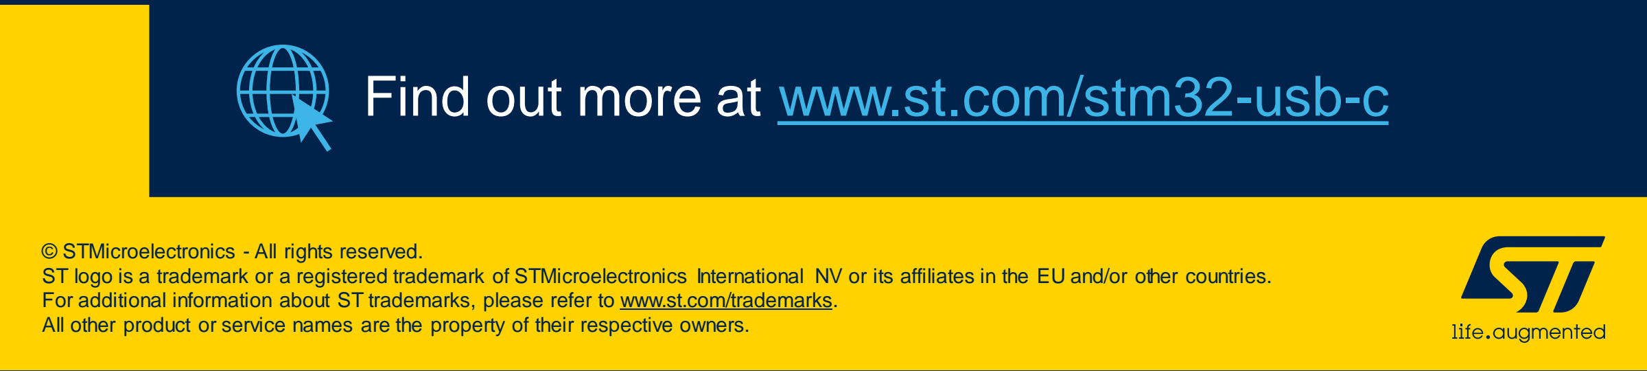
[picture p46: figure]
Find out more at www.st.com/stm32-usb-c

© STMicroelectronics - All rights reserved.
ST logo is a trademark or a registered trademark of STMicroelectronics International NV or its affiliates in the EU and/or other countries. For additional information about ST trademarks, please refer to www.st.com/trademarks.
All other product or service names are the property of their respective owners.
