frc971/electrical/circuit-boards/led-ring-driver/kicad/led-ring-driver-BOM.xlsx

Source: | /home/scott/dev/git/971-Robot-Code/motors/led-ring-driver/kicad/led-ring-driver.kicad_sch
Date: | Sun 23 Jan 2022 02:52:23 PM PST
Tool: | Eeschema 6.0.1-79c1e3a40b~116~ubuntu20.04.1
Generator: | /usr/share/kicad/plugins/bom_csv_grouped_by_value.py
Component Count: | 101
Individual Components:
Item | Qty | Reference(s) | Value | LibPart | Footprint | Datasheet | MFG | P/N | Distributor | Link
1 | 1 | C1 | 270uF 25V | Device:C_Polarized_US | led-ring-driver:CAPPRD500W60D1000H950 | https://industrial.panasonic.com/cdbs/www-data/pdf/RDD0000/RDD0000C1240.pdf | Panasonic | EEH-AZF1E271 | Digikey | https://www.digikey.com/en/products/detail/panasonic-electronic-components/EEH-AZF1E271/9603602
2 | 8 | C2, C3, C14, C16, C17, C18, C19, C20 | 10uF | Device:C | Capacitor_SMD:C_1206_3216Metric | https://ds.yuden.co.jp/TYCOMPAS/ut/detail?pn=MSAST319LB5106MTNA01&u=M | Taiyo Yuden | TMK316ABJ106MD-T | Digikey | https://www.digikey.com/en/products/detail/taiyo-yuden/TMK316ABJ106MD-T/6563537
3 | 2 | C4, C11 | 470pF | Device:C | Capacitor_SMD:C_0805_2012Metric | ~ | KYOCERA AVX | 08055A471JAT2A | Digikey | https://www.digikey.com/en/products/detail/kyocera-avx/08055A471JAT2A/563434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
4 | 1 | C5 | DNI | Device:C | Capacitor_SMD:C_0805_2012Metric | ~
5 | 5 | C6, C7, C8, C9, C10 | 0.1uF | Device:C | Capacitor_SMD:C_0805_2012Metric | ~ | TDK | C2012X7R2A104K125AA | Digikey | https://www.digikey.com/en/products/detail/tdk-corporation/C2012X7R2A104K125AA/569044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
6 | 3 | C12, C13, C15 | 1.0uF | Device:C | Capacitor_SMD:C_0805_2012Metric | ~ | TDK Corporation | CGA4J3X7R1E105K125AB | Digikey | https://www.digikey.com/en/products/detail/tdk-corporation/CGA4J3X7R1E105K125AB/2443165
7 | 1 | D1 | B330-13-F | Device:D_Schottky | Diode_SMD:D_SMC | https://www.diodes.com/assets/Datasheets/ds30923.pdf | Diodes Inc | B330-13-F | Digikey | https://www.digikey.com/en/products/detail/diodes-incorporated/B330-13-F/725014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
8 | 1 | D2 | 12V | Device:D_Zener | Diode_SMD:D_SMB | https://www.mccsemi.com/pdf/Products/SMBJ5338B-SMBJ5388B(SMB).pdf | Micro Commercial | SMBJ5349B-TP | Digikey | https://www.digikey.com/en/products/detail/micro-commercial-co/SMBJ5349B-TP/1636171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
9 | 16 | D3, D4, D5, D6, D7, D8, D9, D10, D11, D12, D13, D14, D15, D16, D17, D18 | GREEN | Device:LED | LED_SMD:LED_PLCC_2835 | https://www.inolux-corp.com/datasheet/SMDLED/Mono%20Color%20Top%20View/IN-P23CTKG_V1.0.pdf | Inolux | IN-P23CTKG | Digikey | https://www.digikey.com/en/products/detail/inolux/IN-P23CTKG/14555716?s=N4IgTCBcDaIJIDkC0AFMBmAwgFQNIHEQBdAXyA
10 | 1 | D19 | PWM | Device:LED | LED_SMD:LED_1206_3216Metric | ~ | Wurth Elektronik | 150120RS75000 | Digikey | https://www.digikey.com/en/products/detail/w%C3%BCrth-elektronik/150120RS75000/4489939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
11 | 1 | D20 | DIS | Device:LED | LED_SMD:LED_1206_3216Metric | ~ | Wurth Elektronik | 150120RS75000 | Digikey | https://www.digikey.com/en/products/detail/w%C3%BCrth-elektronik/150120RS75000/4489939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
12 | 1 | D21 | PWR | Device:LED | LED_SMD:LED_1206_3216Metric | ~ | Wurth Elektronik | 150120RS75000 | Digikey | https://www.digikey.com/en/products/detail/w%C3%BCrth-elektronik/150120RS75000/4489939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
13 | 2 | D22, D23 | CDBW0520L-G | Device:D_Schottky | Diode_SMD:D_SOD-123 | https://www.comchiptech.com/admin/files/product/CDBW0520L-HF%20Thru824572.%20CDBW0540-HF%20RevA.pdf | Comchip | CDBW0520L-G | Digikey | https://www.digikey.com/en/products/detail/comchip-technology/CDBW0520L-G/1979670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
14 | 1 | J1 | 430450601 | led-ring-driver:430450601 | led-ring-driver:430450601 | https://media.digikey.com/pdf/Data%20Sheets/Molex%20PDFs/PK-70873-05xx_1_N3.pdf | Molex | 430450601 | Digikey | https://www.digikey.com/en/products/detail/molex/0430450601/2421555?s=N4IgTCBcDaICwGYAMcCsSBsSCMIC6AvkA
15 | 1 | L1 | 6.8uH | Device:L_Iron | led-ring-driver:SRP3020C-1R0M | https://www.bourns.com/docs/product-datasheets/srp3020c.pdf | Bourns | SRP3020C-6R8M | Digikey | https://www.digikey.com/en/products/detail/bourns-inc/SRP3020C-6R8M/11633628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
16 | 1 | Q1 | SI4116DY-T1-GE3 | Device:Q_NMOS_SGD | Package_SO:SO-8_3.9x4.9mm_P1.27mm | https://www.vishay.com/docs/69837/si4116dy.pdf | Vishay | SI4116DY-T1-GE3 | Digikey | https://www.digikey.com/en/products/detail/vishay-siliconix/SI4116DY-T1-GE3/1978839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
17 | 8 | Q2, Q4, Q5, Q6, Q8, Q9, Q10, Q11 | SMMBT3904LT3G | Device:Q_NPN_BEC | Package_TO_SOT_SMD:SOT-23 | https://www.onsemi.com/pdf/datasheet/mmbt3904lt1-d.pdf | onsemi | SMMBT3904LT3G | Digikey | https://www.digikey.com/en/products/detail/onsemi/SMMBT3904LT3G/4849075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
18 | 1 | Q3 | SI4143DY-T1-GE3 | Device:Q_PMOS_SGD | Package_SO:SOIC-8_3.9x4.9mm_P1.27mm | https://www.vishay.com/docs/63242/si4143dy.pdf | Vishay | SI4143DY-T1-GE3 | Digikey | https://www.digikey.com/en/products/detail/vishay-siliconix/SI4143DY-T1-GE3/6834464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
19 | 1 | Q7 | 2N7002 | Device:Q_NMOS_GSD | Package_TO_SOT_SMD:SOT-23 | https://ww1.microchip.com/downloads/en/DeviceDoc/2N7002-N-Channel-Enhancement-Mode-Vertical-DMOS-FET-Data-Sheet-20005797A.pdf | Microchip | 2N7002-G | Digikey | https://www.digikey.com/en/products/detail/microchip-technology/2N7002-G/4902722
20 | 22 | R1, R4, R6, R7, R8, R9, R10, R11, R12, R13, R14, R15, R18, R19, R23, R24, R25, R27, R29, R30, R36, R38 | 1.0k | Device:R | Resistor_SMD:R_0805_2012Metric | ~ | Stackpole Electronics | RMCF0805FT1K00 | Digikey | https://www.digikey.com/en/products/detail/stackpole-electronics-inc/RMCF0805FT1K00/1760090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
21 | 1 | R2 | 90m | Device:R | Resistor_SMD:R_1206_3216Metric | ~ | Vishay Dale | WSL1206R0900FEA | Digikey | https://www.digikey.com/en/products/detail/vishay-dale/WSL1206R0900FEA/712500
22 | 2 | R3, R5 | 30k | Device:R | Resistor_SMD:R_0805_2012Metric | ~ | Stackpole Electronics | RMCF0805FT30K0 | Digikey | https://www.digikey.com/en/products/detail/stackpole-electronics-inc/RMCF0805FT30K0/1760543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
23 | 1 | R16 | 9.09k | Device:R | Resistor_SMD:R_0805_2012Metric | ~ | Stackpole Electronics Inc | RMCF0805FG9K09 | Digikey | https://www.digikey.com/en/products/detail/stackpole-electronics-inc/RMCF0805FG9K09/1713416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
24 | 3 | R17, R20, R21 | 100k | Device:R | Resistor_SMD:R_0805_2012Metric | ~ | Stackpole Electronics Inc | RMCF0805FG100K | Digikey | https://www.digikey.com/en/products/detail/stackpole-electronics-inc/RMCF0805FG100K/1712614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
25 | 4 | R22, R28, R31, R32 | 10.0R | Device:R | Resistor_SMD:R_0805_2012Metric | ~ | Stackpole Electronics Inc | RNCP0805FTD10R0 | Digikey | https://www.digikey.com/en/products/detail/stackpole-electronics-inc/RNCP0805FTD10R0/2240197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
26 | 4 | R26, R33, R35, R39 | 10k | Device:R | Resistor_SMD:R_0805_2012Metric | ~ | Stackpole Electronics Inc | RMCF0805FT10K0 | Digikey | https://www.digikey.com/en/products/detail/stackpole-electronics-inc/RMCF0805FT10K0/1760676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
27 | 1 | R34 | 909R | Device:R | Resistor_SMD:R_0805_2012Metric | ~ | Stackpole Electronics Inc | RMCF0805FT909R | Digikey | https://www.digikey.com/en/products/detail/stackpole-electronics-inc/RMCF0805FT909R/1760266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
28 | 1 | R37 | 100R | Device:R | Resistor_SMD:R_0805_2012Metric | ~ | Stackpole Electronics Inc | RMCF0805FT100R | Digikey | https://www.digikey.com/en/products/detail/stackpole-electronics-inc/RMCF0805FT100R/1760711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
29 | 1 | U1 | MIC2196YM | led-ring-driver:MIC2196YM | Package_SO:SO-8_3.9x4.9mm_P1.27mm | https://ww1.microchip.com/downloads/en/DeviceDoc/mic2196.pdf | Microchip | MIC2196YM | Digikey | https://www.digikey.com/en/products/detail/microchip-technology/MIC2196YM/1028178
30 | 4 | U2, U3, U4, U5 | TLV272QDRG4Q1 | Amplifier_Operational:LM358 | Package_SO:SO-8_3.9x4.9mm_P1.27mm | https://www.ti.com/lit/ds/symlink/tlv272-q1.pdf?HQS=dis-dk-null-digikeymode-dsf-pf-null-wwe&ts=1642359927314 | Texas Instruments | TLV272QDRG4Q1 | Digikey | https://www.digikey.com/en/products/detail/texas-instruments/TLV272QDRG4Q1/1906768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
31 | 1 | U6 | TL751L05CD | led-ring-driver:TL751L05CD | Package_SO:SO-8_3.9x4.9mm_P1.27mm | https://www.ti.com/lit/ds/slvs017u/slvs017u.pdf | Texas Instruments | TL751L05CD | Digikey | https://www.digikey.com/en/products/detail/texas-instruments/TL751L05CD/373210
