frc971/electrical/circuit-boards/RPI-Power-Boards/RspBuckBoost/bom/pi4Power.ods

QTY | RefDes | Value | Part Number | Manufacturer
4 | C100 | 68uF 25V | 870025574003 | Wurth Electronik
 | C108 | 68uF 25V | 870025574003 | Wurth Electronik
 | C109 | 68uF 25V | 870025574003 | Wurth Electronik
 | C200 | 68uF 25V | 870025574003 | Wurth Electronik
2 | C102 | 10nF 10% | C0805C103K3RACTU | Kemet
 | C202 | 10nF 10% | C0805C103K3RACTU | Kemet
1 | C103 | 22pF 5% | C0805C220J5GACTU | Kemet
4 | C104 | 6.8nF 10% | C0805C682K5RACTU | Kemet
 | C110 | 6.8nF 10% | C0805C682K5RACTU | Kemet
 | C111 | 6.8nF 10% | C0805C682K5RACTU | Kemet
 | C112 | 6.8nF 10% | C0805C682K5RACTU | Kemet
3 | C106 | 0.1uF 10% | GMK212BJ104KGHT | Taiyo Yuden
 | C201 | 0.1uF 10% | GMK212BJ104KGHT | Taiyo Yuden
 | C203 | 0.1uF 10% | GMK212BJ104KGHT | Taiyo Yuden
7 | C101 | 4.7uF 10% | GRM219R6YA475KA73D | Murata
 | C101 | 4.7uF 10% | GRM219R6YA475KA73D | Murata
 | C105 | 4.7uF 10% | GRM219R6YA475KA73D | Murata
 | C107 | 4.7uF 10% | GRM219R6YA475KA73D | Murata
 | C300 | 4.7uF 10% | GRM219R6YA475KA73D | Murata
 | C301 | 4.7uF 10% | GRM219R6YA475KA73D | Murata
 | C302 | 4.7uF 10% | GRM219R6YA475KA73D | Murata
1 | C204 | 330uF 16V | RL81C331MDN1KX | Nichicon
1 | D101 | 5.6V | 3SMAJ5919B-TP | Micro Commercial
2 | D104 | Green LED | LG R971-KN-1 | OSRAM
 | D202 | Green LED | LG R971-KN-1 | OSRAM
3 | D102 | MBRB4030G | MBRB4030G | On Semi
 | D103 | MBRB4030G | MBRB4030G | On Semi
 | D201 | MBRB4030G | MBRB4030G | On Semi
1 | D100 | 16V | SMDJ16A | Littelfuse
1 | D300 | Schottky 30V,1A | SS13FL | On Semi
1 | J100 |  | 1824440000 | Weidmuller
1 | J200 | HEADER40_2 | ESQ-120-44-T-D | Samtec
1 | L100 | 2.8uH | SPM12565XT-2R8M150 | TDK
1 | L200 | 13uH | 7443551131 | Wurth Electronik
1 | L300 | CLF7045NIT-330M-D | 33 uH | TDK
1 | Q100 | Si4842BDY | Si4842BDY | Vishay Siliconix
4 | R102 | 10.0k 1% | RC0805FR-0710KL | Yageo
 | R104 | 10.0k 1% | RC0805FR-0710KL | Yageo
 | R200 | 10.0k 1% | RC0805FR-0710KL | Yageo
 | R300 | 10.0k 1% | RC0805FR-0710KL | Yageo
1 | R103 | 22.0k 1% | RC0805FR-0722KL | Yageo
1 | R100 | 26.1k 1% | RC0805FR-0726K1L | Yageo
1 | R107 | 2.00k 1% | RC0805FR-072KL | Yageo
1 | R201 | 499R 1% | RC0805FR-07499RL | Yageo
1 | R101 | 71.5k 1% | RC0805FR-0771K5L | Yageo
1 | R105 | 80.6k 1% | RC0805FR-0780K6L | Yageo
1 | R106 | 10 mOhm | WSL1206R0100FEA | Vishay-Dale
1 | R301 | 0R150 | WSL1206R1500FEA | Vishay-Dale
1 | U100 |  | LTC1871EMS | Analog Devices
1 | U200 |  | LM2678S-5.0 | Texas Instruments
1 | U300 |  | AL8808WT-7 | Diodes Inc.
