frc971/electrical/circuit-boards/Orin-NX-PCBs/NX-ButtonInterface-v3/Output-Files/Assembly-Files/NX-ButtonInterface-bom.csv

Item | QUANTITY | Reference | Value | MFG | MFG P/N | DIST | DIST P/N
1 | 1 | J1 | NX CONTROL & UART | Sullins Connector Solutions | PPTC181LFBN-RC | Digikey | S7016-ND
2 | 2 | J2,J4 | -- mixed values --
