frc971/electrical/circuit-boards/driver-station/driver-station-button-connector/Output-Files/Assembly-Files/button_adapter-bom-11Feb2024.csv

Item | Qty | Reference(s) | Value | DIST | DIST P/N | MFG | MFG P/N
1 | 1 | J1 | BUTTON |  |  | Sanwa | OBSF-30
2 | 1 | J2 | MOLEX 2PIN | Digikey | WM14786-ND | Molex | 0705550071
