frc971/electrical/circuit-boards/connector_boards/CAN_Terminator/Output-Files/Assembly-Files/CAN_terminator-bom-28Jan2024.csv

Item | Qty | Reference(s) | Value | DIST | DIST P/N | MFG | MFG P/N
1 | 1 | J1 | 2 pin molex sl right angle | Digikey | WM4175-ND | Molex | 70555-0036
2 | 1 | R1 | 120 ohm | Digikey | 311-120CRCT-ND | YAGEO | RC0805FR-07120RL
