frc971/electrical/circuit-boards/IMU-2X-v3/Components/E-SWITCH-TL3301AF260QG.pdf

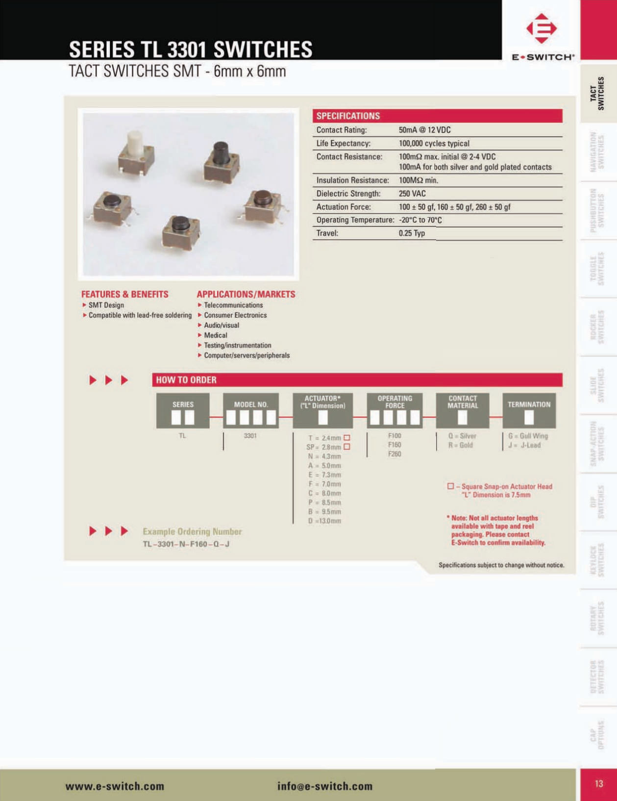
[picture p59: page 1]
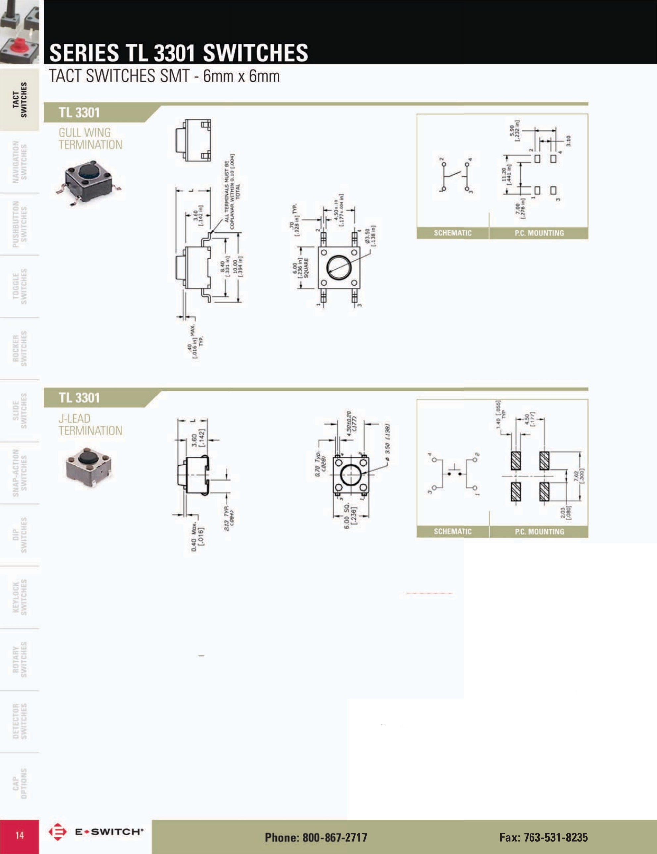
[picture p60: page 2]
