frc971/electrical/circuit-boards/connector_boards/TEE-CAN-SL/Output-Files/Assembly-Files/TEE-CAN-SL-bom.csv

Item | QUANTITY | Reference | Value | MFG | MFG P/N | DIST | DIST P/N
1 | 4 | J1-J4 | 0705410036 | MOLEX | 0705410036 | DIGIKEY | WM14049-ND
