frc971/electrical/circuit-boards/tools/kraken-pwm-controller/Output-Files/Assembly-Files/kraken-pwm-controller-bom.csv

Item | QUANTITY | Reference | Value | MFG | MFG P/N | DIST | DIST P/N
1 | 17 | C1,C3,H1-H4,J1-J5,RV1-RV3,U1,U2,U4 | -- mixed values -- | -- mixed values --
