frc971/electrical/tools/CNC-router/RouterEstop/Components/7i37tacolo-500x500.png

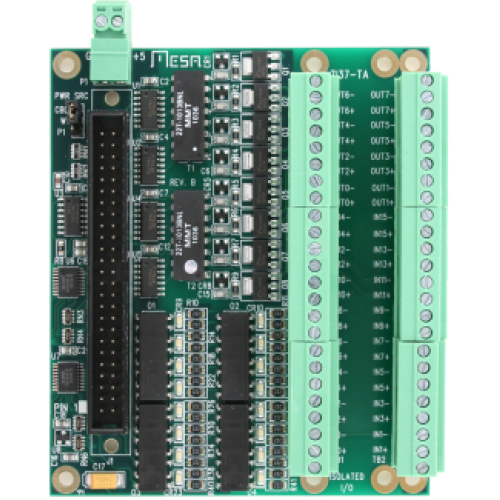
tools/CNC-router/RouterEstop/Components/7i37tacolo-500x500.png
