frc971/electrical/circuit-boards/connector_boards/CAN_Terminator/CAN_terminator-drl_map.dxf

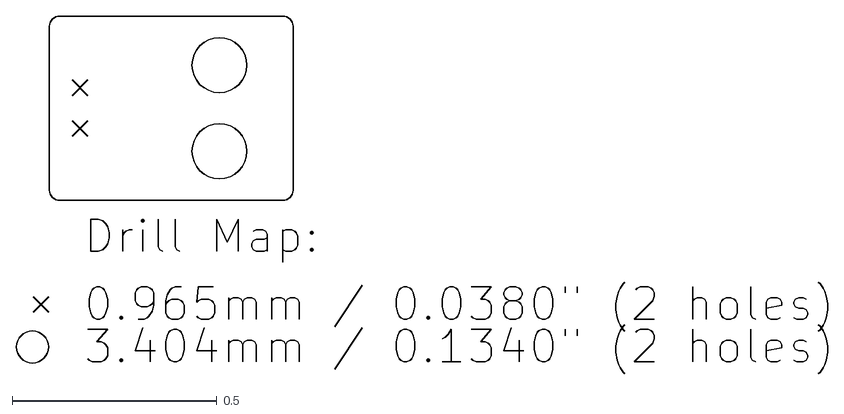
[picture p62: CAD file, 2024-01-29]
circuit-boards/connector_boards/CAN_Terminator/CAN_terminator-drl_map.dxf
1.98 x 0.874
