frc971/electrical/circuit-boards/connector_boards/encoder_adapter/3d-model/CRCW08051K20FKEAC.STEP

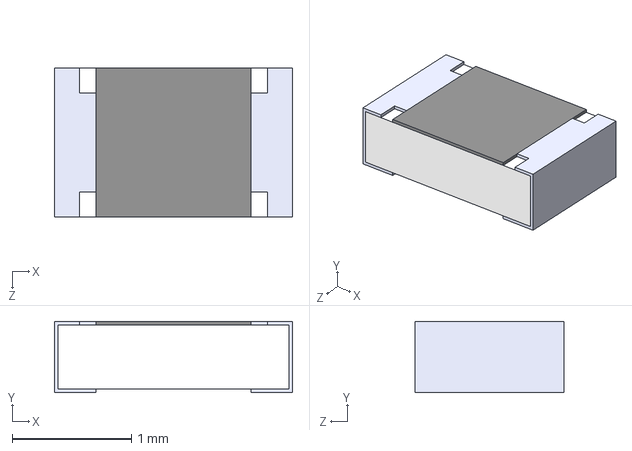
[picture p63: CAD file, 2023-12-23]
circuit-boards/connector_boards/encoder_adapter/3d-model/CRCW08051K20FKEAC.STEP
2.00 x 0.6 x 1.25 mm
