frc971/electrical/circuit-boards/connector_boards/kraken-can-adapter-V2/kraken-can-adapter-drl_map.dxf

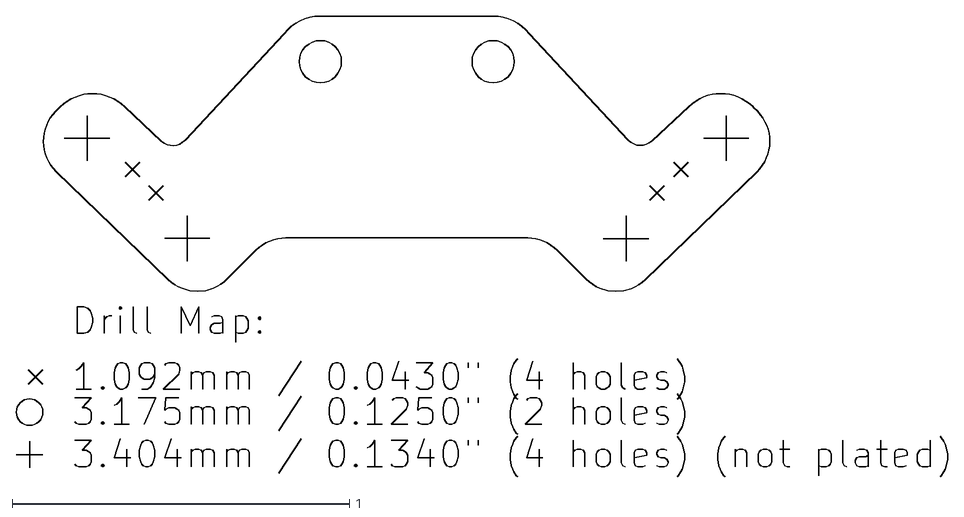
[picture p64: CAD file, 2024-06-22]
circuit-boards/connector_boards/kraken-can-adapter-V2/kraken-can-adapter-drl_map.dxf
2.76 x 1.37
