frc971/electrical/circuit-boards/connector_boards/kraken-power-adapter/kraken-power-adapter-drl_map.dxf

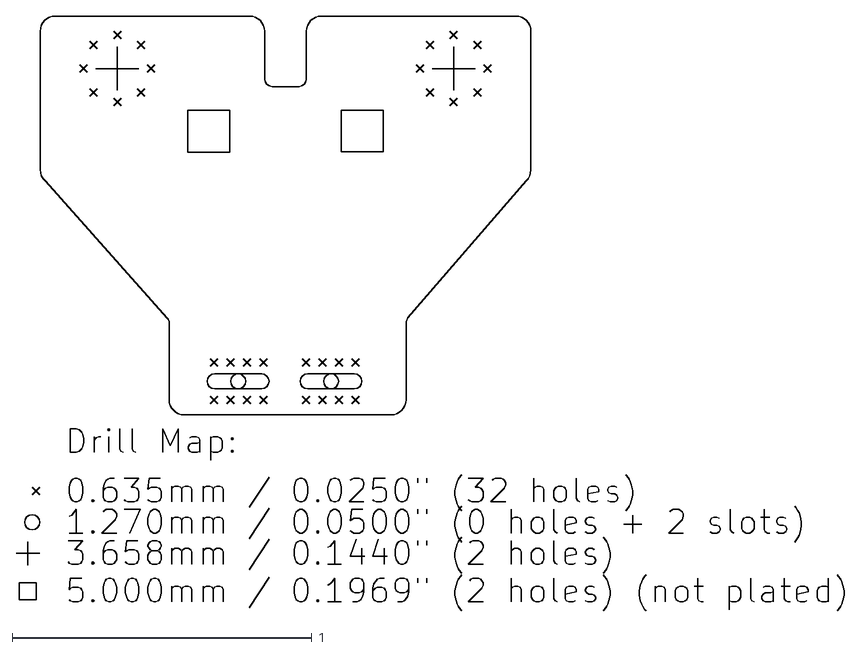
[picture p65: CAD file, 2024-01-02]
circuit-boards/connector_boards/kraken-power-adapter/kraken-power-adapter-drl_map.dxf
2.76 x 1.98
