frc971/electrical/circuit-boards/connector_boards/Kraken_Adapter_Boards_V3/Kraken_Adapter_Boards_V3.step

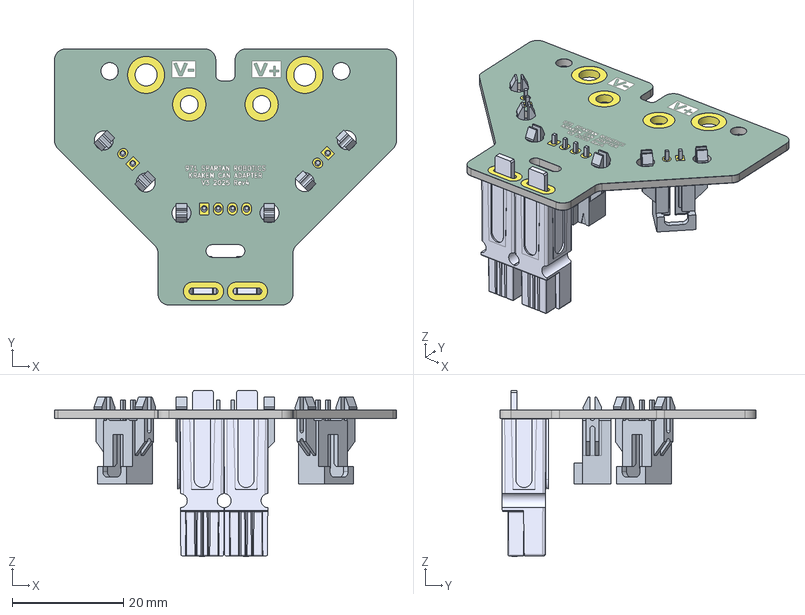
[picture p66: CAD file, 2026-10-19]
circuit-boards/connector_boards/Kraken_Adapter_Boards_V3/Kraken_Adapter_Boards_V3.step
61.4 x 46.0 x 29.8 mm
Kraken_Adapter_Boards_V3_copper
Kraken_Adapter_Boards_V3_silkscreen
Kraken_Adapter_Boards_V3_soldermask
Kraken_Adapter_Boards_V3_PCB
