frc971/electrical/circuit-boards/connector_boards/MiniPowerDistribution-V2/PowerDistribution-drl_map.dxf

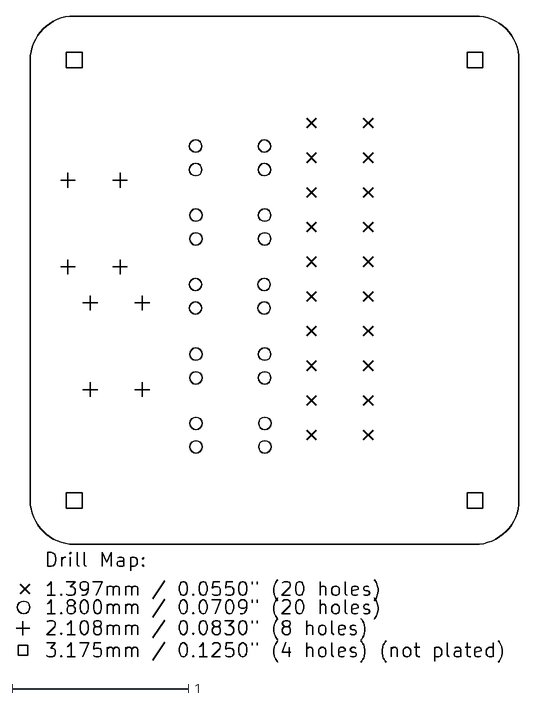
[picture p67: CAD file, 2024-10-12]
circuit-boards/connector_boards/MiniPowerDistribution-V2/PowerDistribution-drl_map.dxf
2.86 x 3.67
