frc971/electrical/circuit-boards/connector_boards/potentiometer_adapter/3d models/Bourns-3547.step

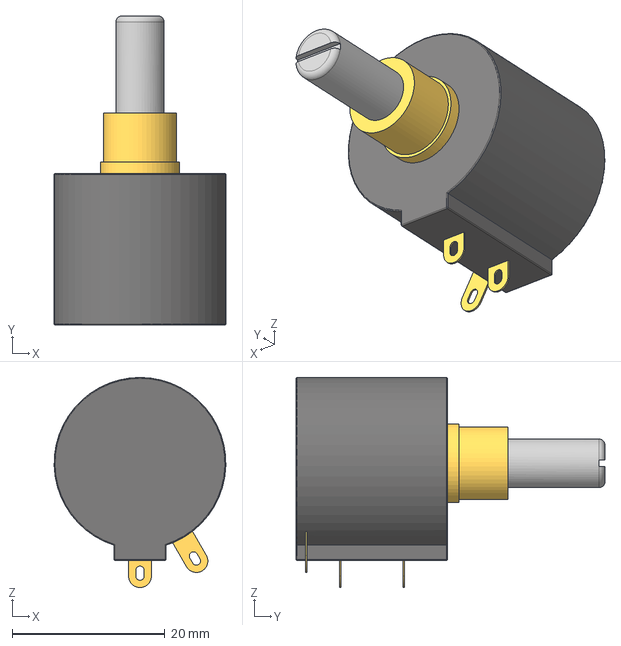
[picture p68: CAD file, 2023-12-23]
circuit-boards/connector_boards/potentiometer_adapter/3d models/Bourns-3547.step
22.5 x 40.4 x 27.5 mm
