frc971/electrical/circuit-boards/connector_boards/TEE-CAN-SL/TEE-CAN-SL-drl_map.dxf

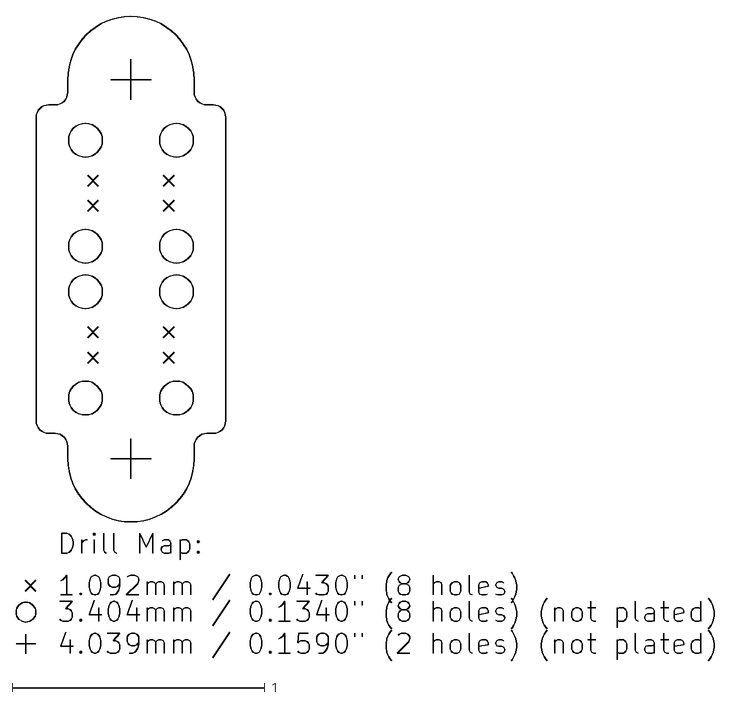
[picture p69: CAD file, 2024-10-12]
circuit-boards/connector_boards/TEE-CAN-SL/TEE-CAN-SL-drl_map.dxf
2.76 x 2.55
