frc971/electrical/circuit-boards/driver-station/driver-station-button-connector/3dModels/sanwa obsf-30-g.STEP

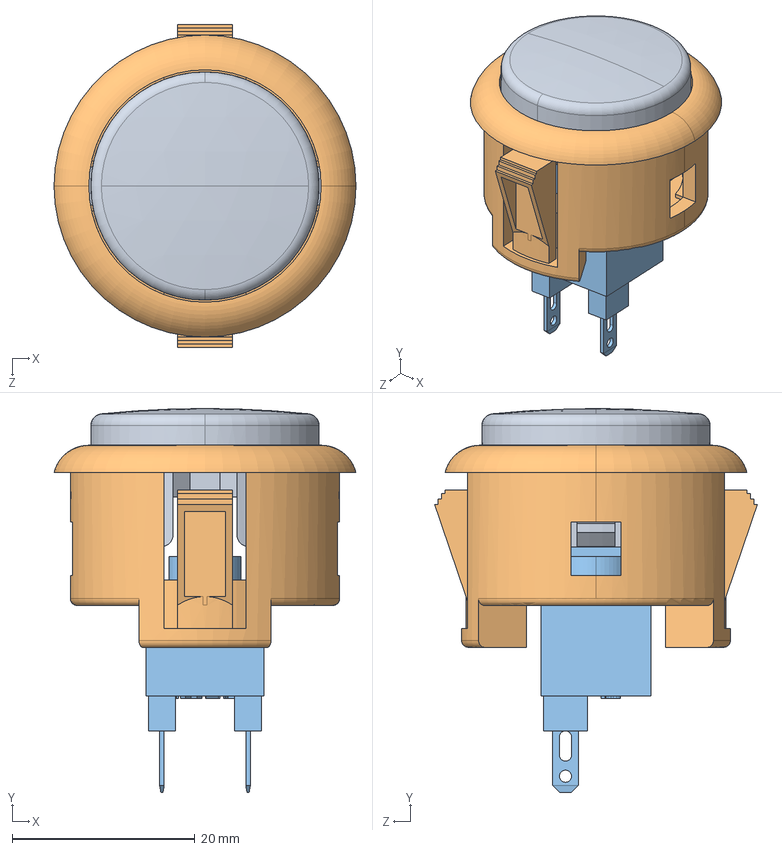
[picture p70: CAD file, 2024-02-12]
circuit-boards/driver-station/driver-station-button-connector/3dModels/sanwa obsf-30-g.STEP
33.0 x 42.0 x 35.3 mm
top_cap
base
microswitch
