frc971/electrical/circuit-boards/hall-switch-v2/HallSwitch-drl_map.dxf

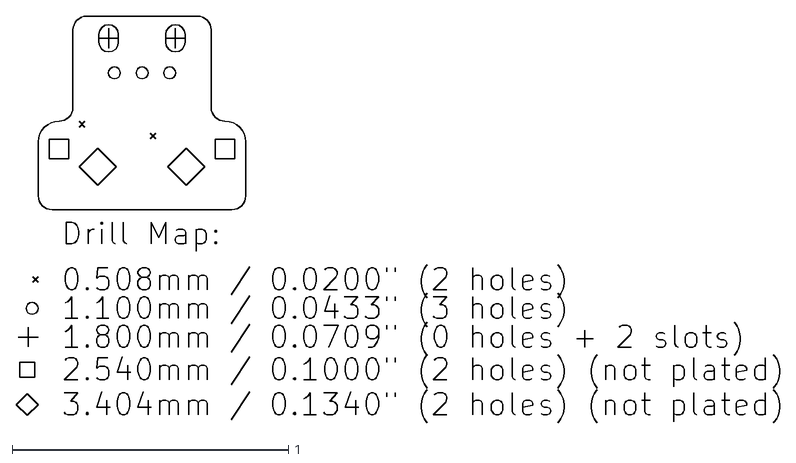
[picture p71: CAD file, 2024-10-12]
circuit-boards/hall-switch-v2/HallSwitch-drl_map.dxf
2.76 x 1.47
