frc971/electrical/circuit-boards/IMU-2X-v3/IMU-2X-drl_map.dxf

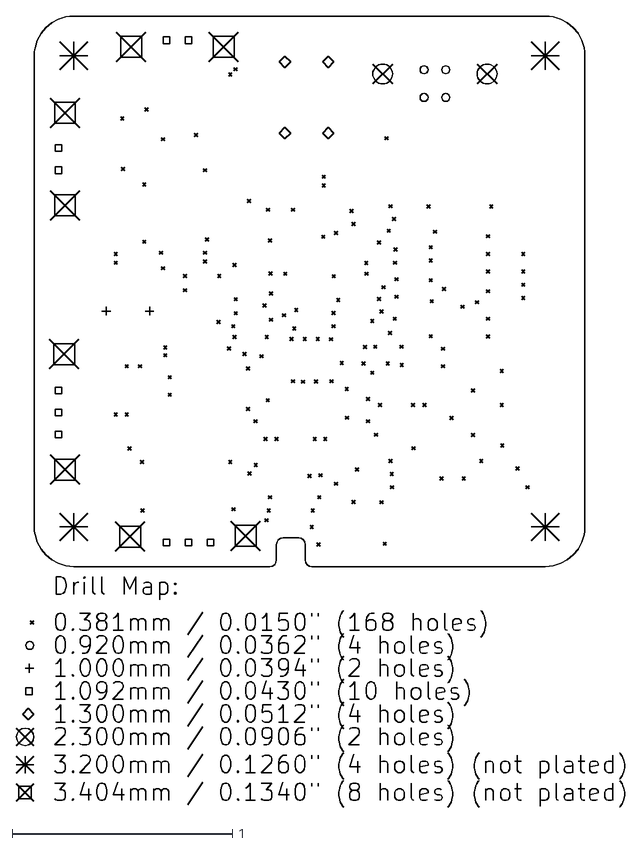
[picture p72: CAD file, 2023-12-31]
circuit-boards/IMU-2X-v3/IMU-2X-drl_map.dxf
2.76 x 3.59
