frc971/electrical/circuit-boards/led-ring-driver/kicad/components/3D_Step/SRP3020C-1R0M_BRN.step

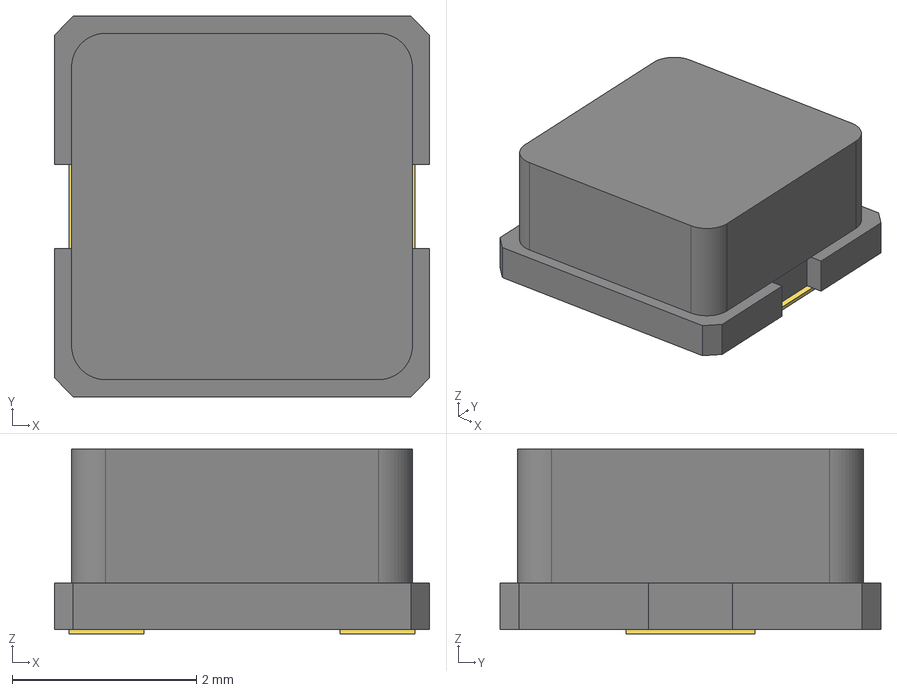
[picture p73: CAD file, 2023-12-23]
circuit-boards/led-ring-driver/kicad/components/3D_Step/SRP3020C-1R0M_BRN.step
4.07 x 4.13 x 2.01 mm
