frc971/electrical/circuit-boards/Orin-NX-PCBs/NX-ButtonInterface-v3/NX-ButtonInterface-drl_map.dxf

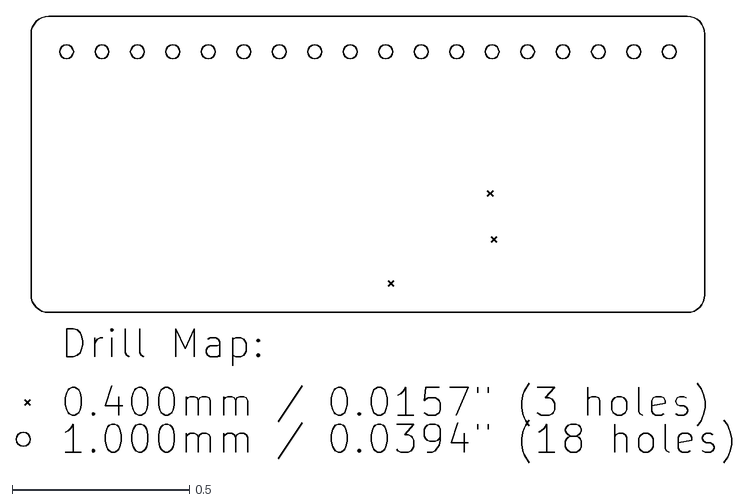
[picture p74: CAD file, 2024-08-17]
circuit-boards/Orin-NX-PCBs/NX-ButtonInterface-v3/NX-ButtonInterface-drl_map.dxf
2.02 x 1.26
