frc971/electrical/circuit-boards/Orin-NX-PCBs/NX-IndicatorBoard-V2/3dModels/Lumex-LPF-C012303S.stp

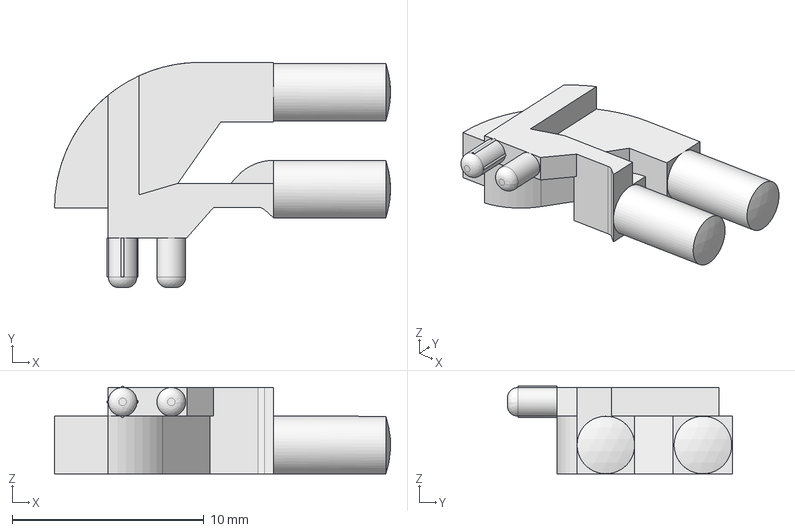
[picture p75: CAD file, 2024-07-28]
circuit-boards/Orin-NX-PCBs/NX-IndicatorBoard-V2/3dModels/Lumex-LPF-C012303S.stp
17.5 x 11.8 x 4.56 mm
