frc971/electrical/circuit-boards/Orin-NX-PCBs/NX-J401-Adapter-v3/3dModels/Dialight.step

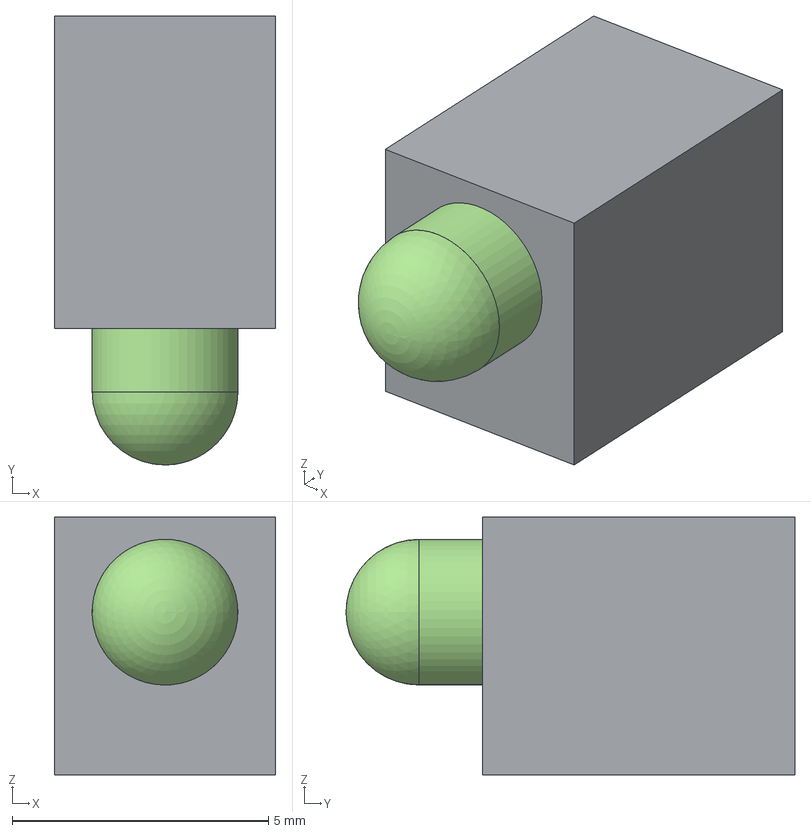
[picture p76: CAD file, 2024-08-05]
circuit-boards/Orin-NX-PCBs/NX-J401-Adapter-v3/3dModels/Dialight.step
4.32 x 8.76 x 5.03 mm
