frc971/electrical/circuit-boards/Orin-NX-PCBs/NX-J401-Adapter-v3/Components/1-1734248-5/1-1734248-5.step

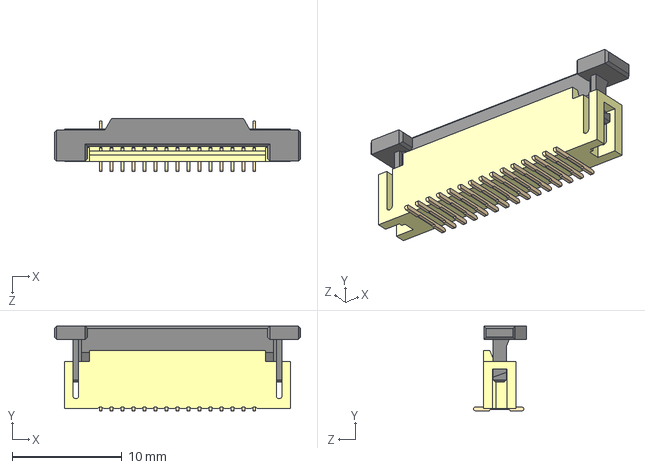
[picture p77: CAD file, 2023-12-22]
circuit-boards/Orin-NX-PCBs/NX-J401-Adapter-v3/Components/1-1734248-5/1-1734248-5.step
22.4 x 7.70 x 4.85 mm
