frc971/electrical/circuit-boards/Orin-NX-PCBs/NX-J401-Adapter-v3/Components/IHLP6767GZER4R7M11/STEP/IHLP6767GZ.step

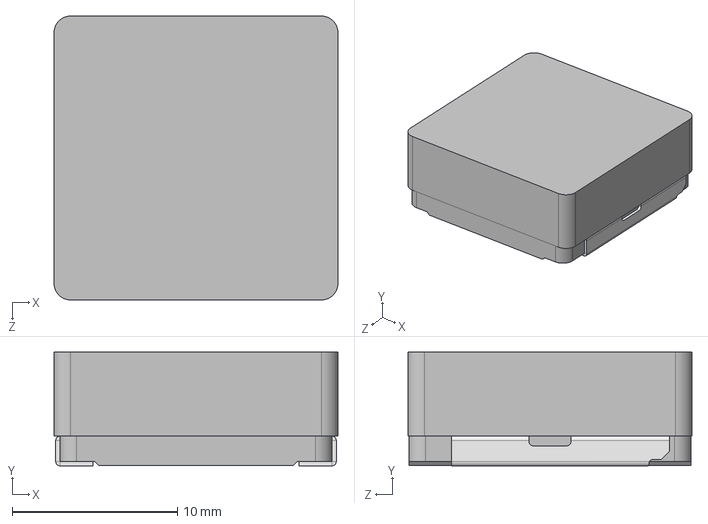
[picture p78: CAD file, 2023-12-22]
circuit-boards/Orin-NX-PCBs/NX-J401-Adapter-v3/Components/IHLP6767GZER4R7M11/STEP/IHLP6767GZ.step
17.2 x 6.88 x 17.2 mm
