frc971/electrical/circuit-boards/Orin-NX-PCBs/NX-J401-Adapter-v3/NX-J401-Adapter-drl_map.dxf

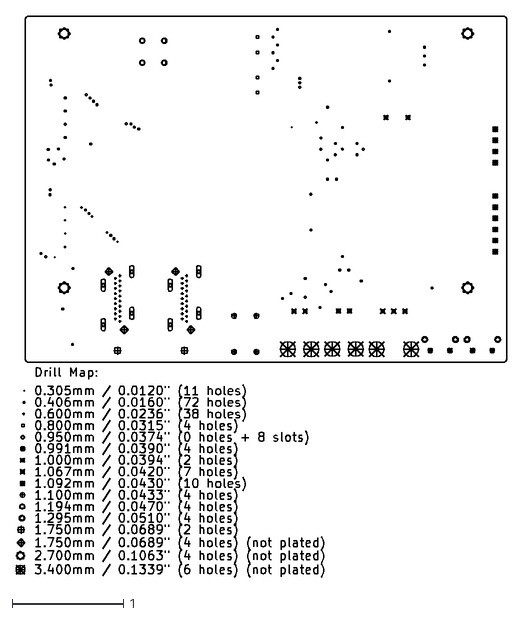
[picture p79: CAD file, 2024-08-18]
circuit-boards/Orin-NX-PCBs/NX-J401-Adapter-v3/NX-J401-Adapter-drl_map.dxf
4.41 x 5.04
