frc971/electrical/circuit-boards/RPI-Power-Boards/RockPI-Power-Board/3dModels/IHLP2020CZ.step

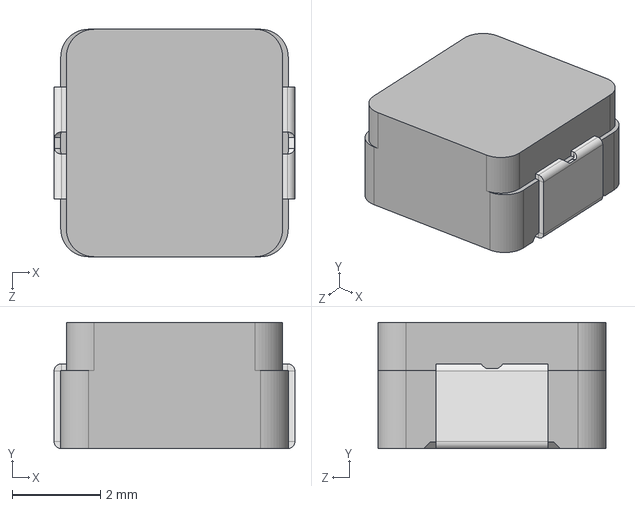
[picture p80: CAD file, 2023-12-23]
circuit-boards/RPI-Power-Boards/RockPI-Power-Board/3dModels/IHLP2020CZ.step
5.45 x 2.86 x 5.15 mm
