frc971/electrical/circuit-boards/RPI-Power-Boards/RockPI-Power-Board/Components/heatsink-1225-al-1.stp

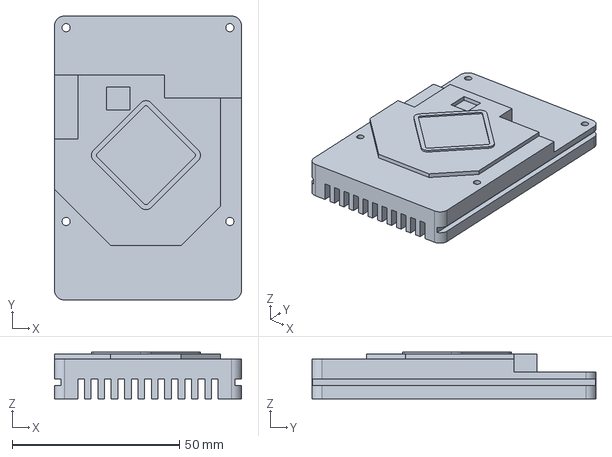
[picture p81: CAD file, 2023-12-23]
circuit-boards/RPI-Power-Boards/RockPI-Power-Board/Components/heatsink-1225-al-1.stp
56.0 x 85.0 x 14.0 mm
