frc971/electrical/circuit-boards/shaft-encoders/mag-encoder/mag-encoder-drl_map.dxf

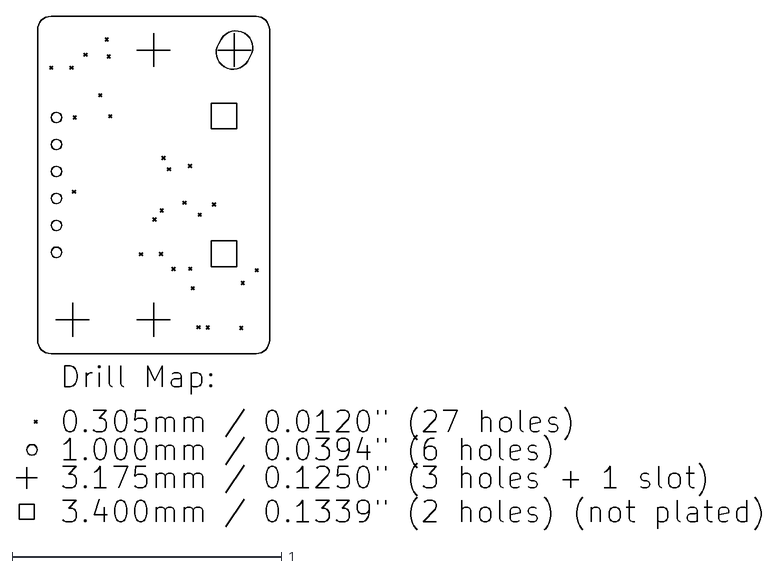
[picture p82: CAD file, 2024-08-26]
circuit-boards/shaft-encoders/mag-encoder/mag-encoder-drl_map.dxf
2.76 x 1.90
