frc971/electrical/circuit-boards/shaft-encoders/mag-encoder2/mag-encoder-drl_map.dxf

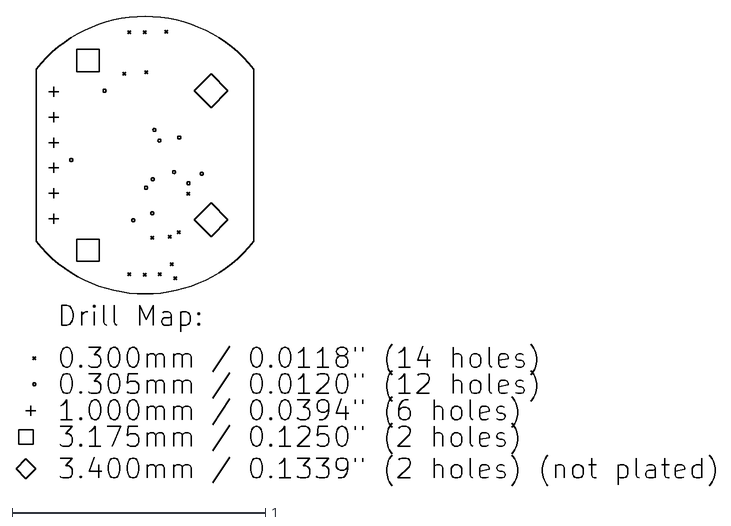
[picture p84: CAD file, 2024-08-31]
circuit-boards/shaft-encoders/mag-encoder2/mag-encoder-drl_map.dxf
2.76 x 1.85
