frc971/electrical/circuit-boards/shaft-encoders/mag-encoder3/mag-encoder-NPTH-drl_map.dxf

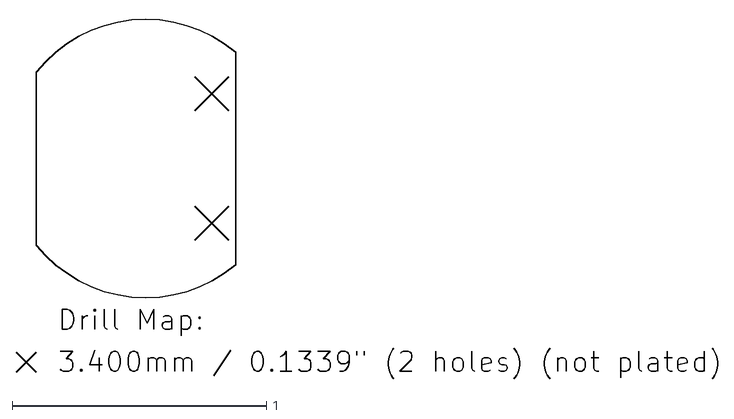
[picture p85: CAD file, 2024-10-25]
circuit-boards/shaft-encoders/mag-encoder3/mag-encoder-NPTH-drl_map.dxf
2.76 x 1.43
