frc971/electrical/circuit-boards/shaft-encoders/mag-encoder4/3dModels/BQA0014A.stp

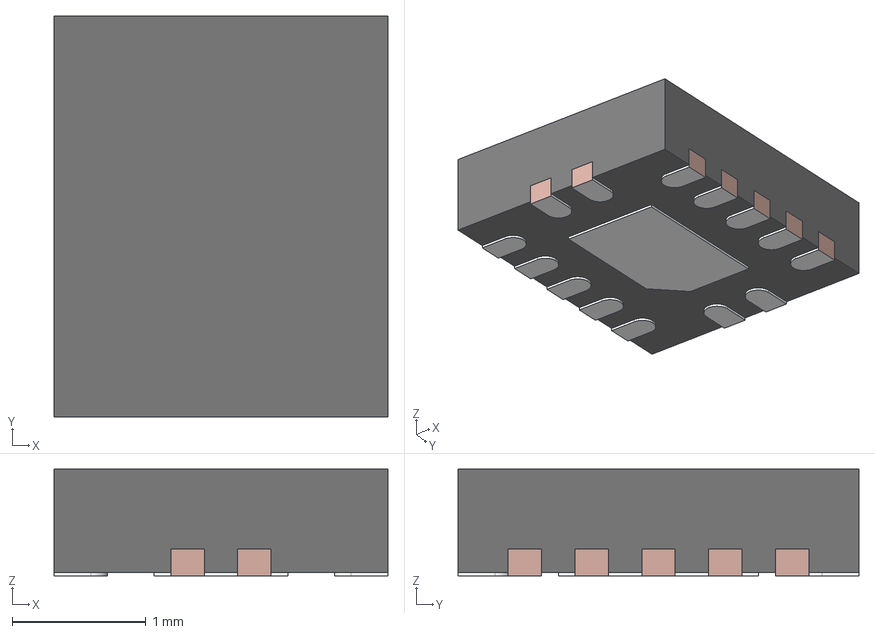
[picture p86: CAD file, 2024-11-25]
circuit-boards/shaft-encoders/mag-encoder4/3dModels/BQA0014A.stp
2.50 x 3.00 x 0.8 mm
FRAME
