frc971/electrical/circuit-boards/tools/kraken-pwm-controller/3dmodels/PJ-102AH.step

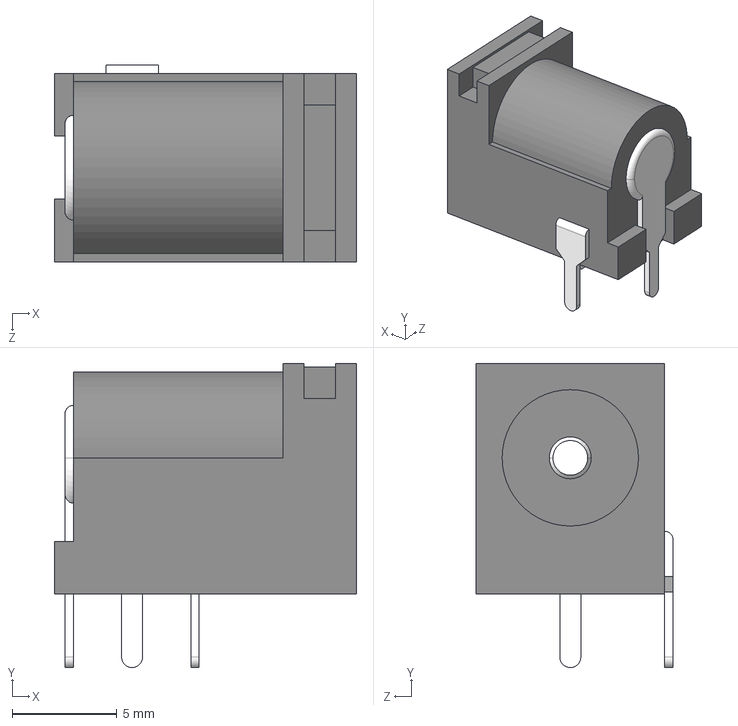
[picture p87: CAD file, 2024-07-30]
circuit-boards/tools/kraken-pwm-controller/3dmodels/PJ-102AH.step
14.4 x 14.5 x 9.40 mm
