frc971/electrical/circuit-boards/connector_boards/encoder_adapter/3d-model/S1-X-250-X-B-D.STEP

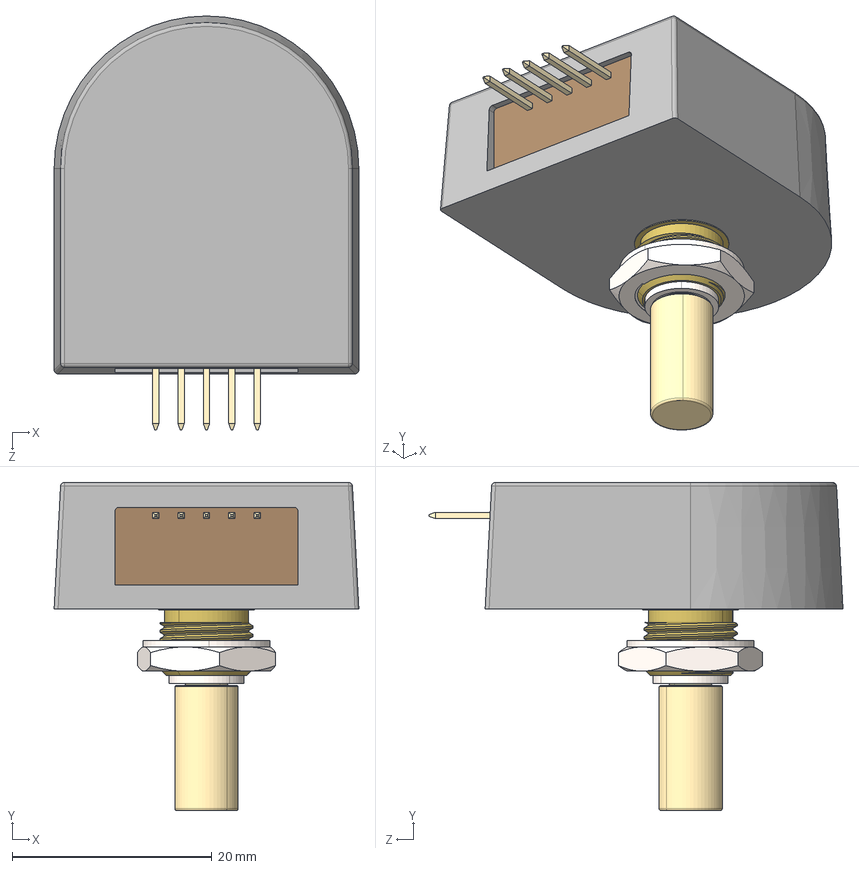
[picture p88: CAD file, 2023-12-23]
circuit-boards/connector_boards/encoder_adapter/3d-model/S1-X-250-X-B-D.STEP
30.5 x 32.8 x 41.4 mm
