frc971/electrical/circuit-boards/connector_boards/kraken-can-adapter-V2/Kraken-back.dxf

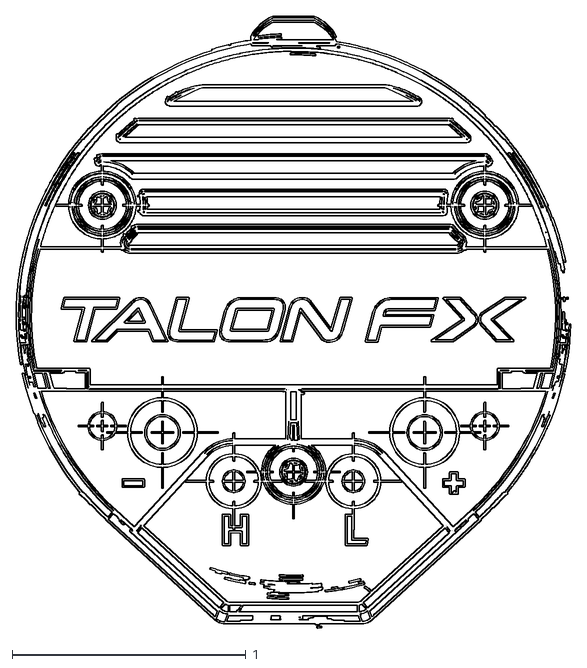
[picture p89: CAD file, 2023-12-31]
circuit-boards/connector_boards/kraken-can-adapter-V2/Kraken-back.dxf
2.37 x 2.62
