frc971/electrical/circuit-boards/connector_boards/kraken-power-adapter/kraken-power-adapter.step

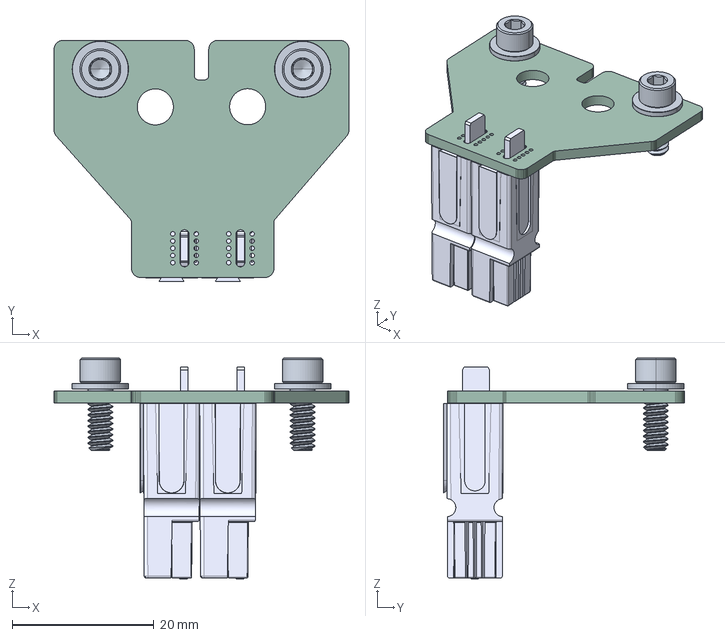
[picture p90: CAD file, 2023-12-31]
circuit-boards/connector_boards/kraken-power-adapter/kraken-power-adapter.step
41.6 x 34.0 x 31.1 mm
kraken-power-adapter PCB
