frc971/electrical/circuit-boards/IMU-2X-v3/3D-Models/SOD128.step

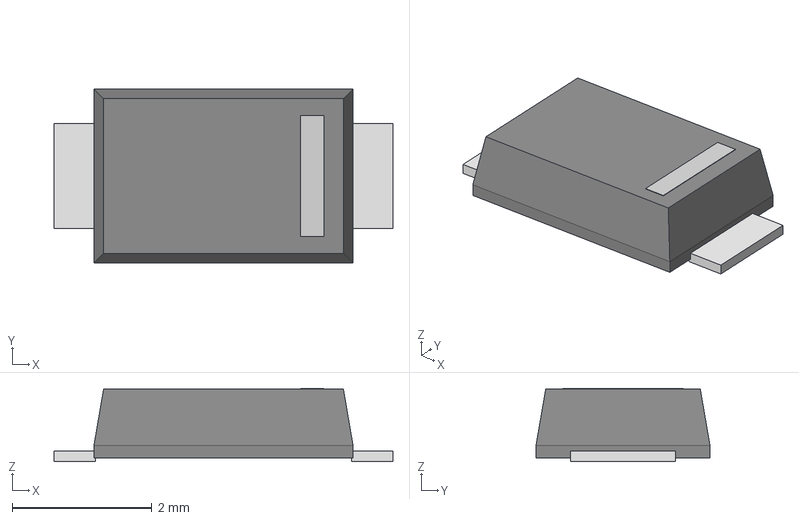
[picture p92: CAD file, 2023-12-23]
circuit-boards/IMU-2X-v3/3D-Models/SOD128.step
4.85 x 2.49 x 1.05 mm
