frc971/electrical/circuit-boards/Orin-NX-PCBs/NX-ButtonInterface-v3/3dModels/IHLP1212BZ-11.step

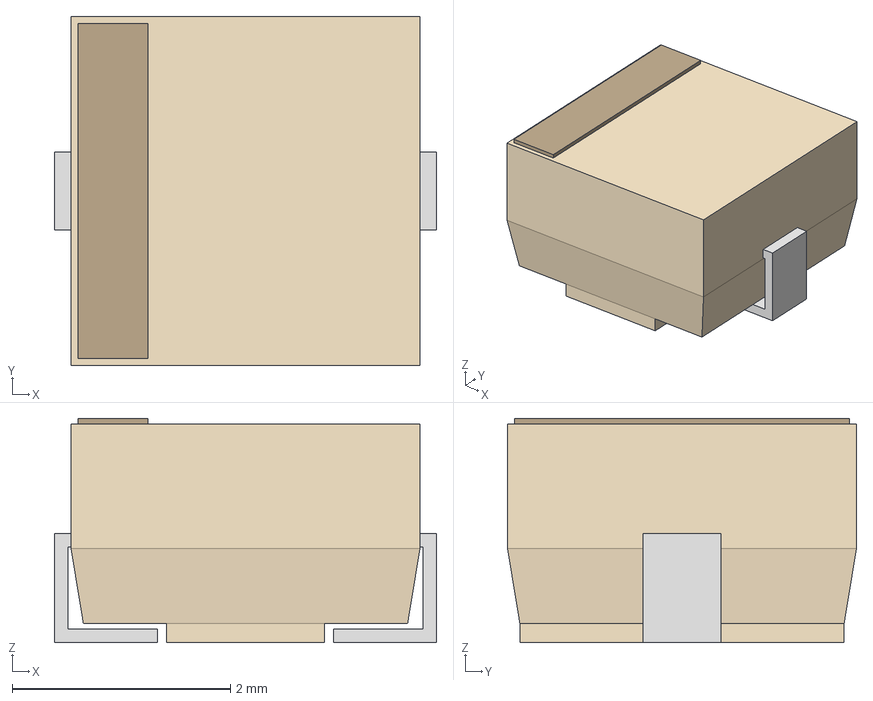
[picture p93: CAD file, 2023-12-23]
circuit-boards/Orin-NX-PCBs/NX-ButtonInterface-v3/3dModels/IHLP1212BZ-11.step
3.51 x 3.20 x 2.06 mm
