frc971/electrical/circuit-boards/Orin-NX-PCBs/NX-IndicatorBoard-V2/3dModels/Microchip-VDFN14_QBB_MCH.step

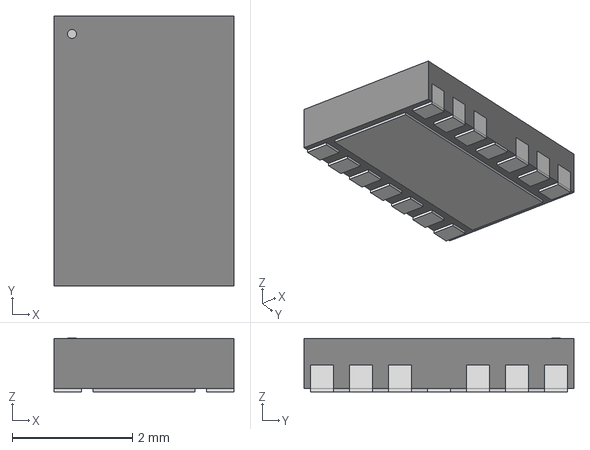
[picture p94: CAD file, 2024-07-14]
circuit-boards/Orin-NX-PCBs/NX-IndicatorBoard-V2/3dModels/Microchip-VDFN14_QBB_MCH.step
3.00 x 4.50 x 0.892 mm
