frc971/electrical/circuit-boards/Orin-NX-PCBs/NX-J401-Adapter-v3/3dModels/Vishay-IHLE5050FH.STEP

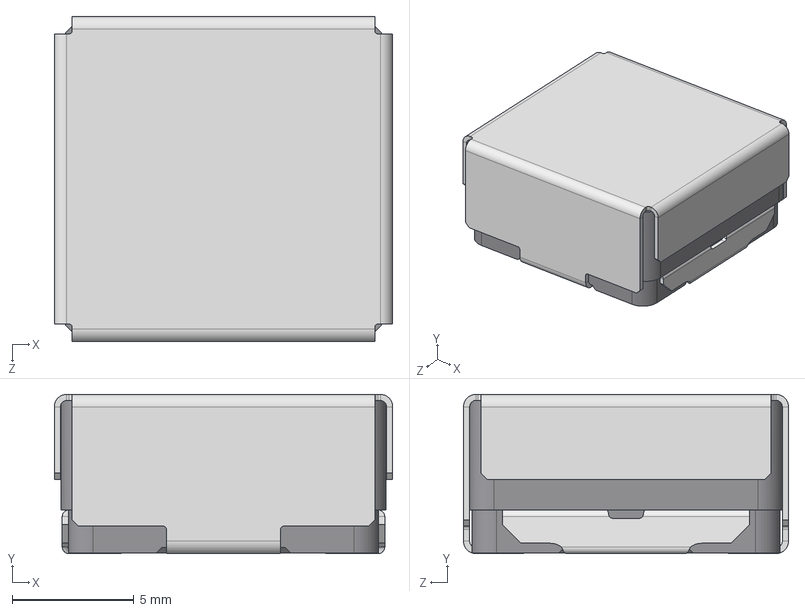
[picture p95: CAD file, 2024-07-20]
circuit-boards/Orin-NX-PCBs/NX-J401-Adapter-v3/3dModels/Vishay-IHLE5050FH.STEP
13.9 x 6.55 x 13.4 mm
