frc971/electrical/circuit-boards/shaft-encoders/mag-encoder3/mag-encoder-PTH-drl_map.dxf

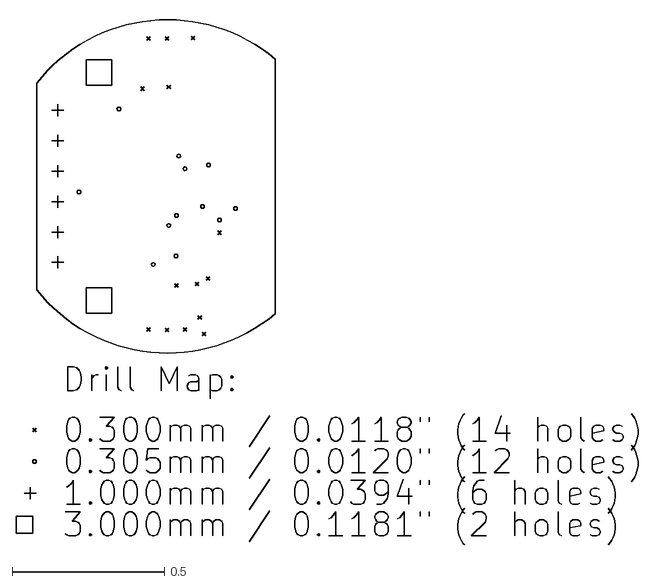
[picture p96: CAD file, 2024-10-25]
circuit-boards/shaft-encoders/mag-encoder3/mag-encoder-PTH-drl_map.dxf
2.04 x 1.74
