frc971/electrical/circuit-boards/shaft-encoders/mag-encoder4/3dModels/onsemi-SC75.step

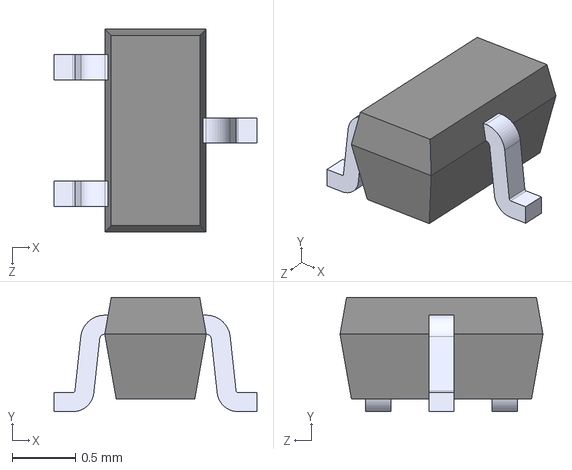
[picture p97: CAD file, 2024-08-26]
circuit-boards/shaft-encoders/mag-encoder4/3dModels/onsemi-SC75.step
1.60 x 0.9 x 1.60 mm
