frc971/electrical/circuit-boards/tools/kraken-pwm-controller/3dmodels/PTV09A-4020F-B104.stp

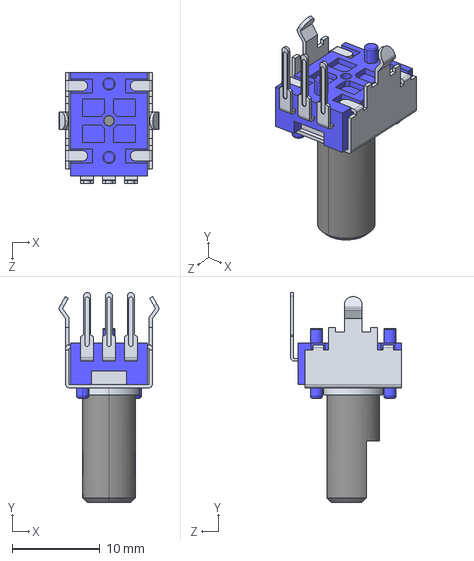
[picture p98: CAD file, 2024-07-30]
circuit-boards/tools/kraken-pwm-controller/3dmodels/PTV09A-4020F-B104.stp
11.4 x 24.0 x 12.7 mm
PTV09A-4X20F-XXXCX_2
PTV09A-4X20F-XXXCX
