frc971/electrical/circuit-boards/connector_boards/kraken-can-adapter-V2/3dModels/1335G1 IN HSG.STEP

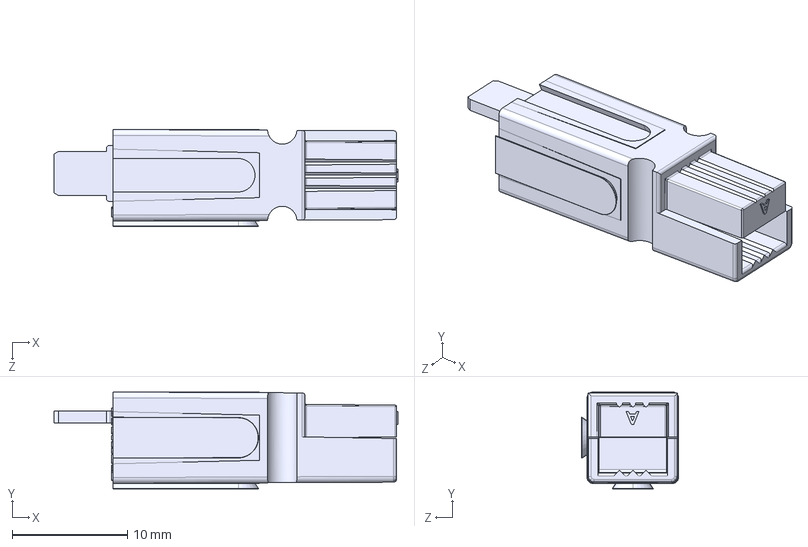
[picture p99: CAD file, 2023-12-31]
circuit-boards/connector_boards/kraken-can-adapter-V2/3dModels/1335G1 IN HSG.STEP
29.8 x 8.41 x 8.41 mm
