frc971/electrical/circuit-boards/IMU-2X-v3/3D-Models/SCHA63T-K03-05.step

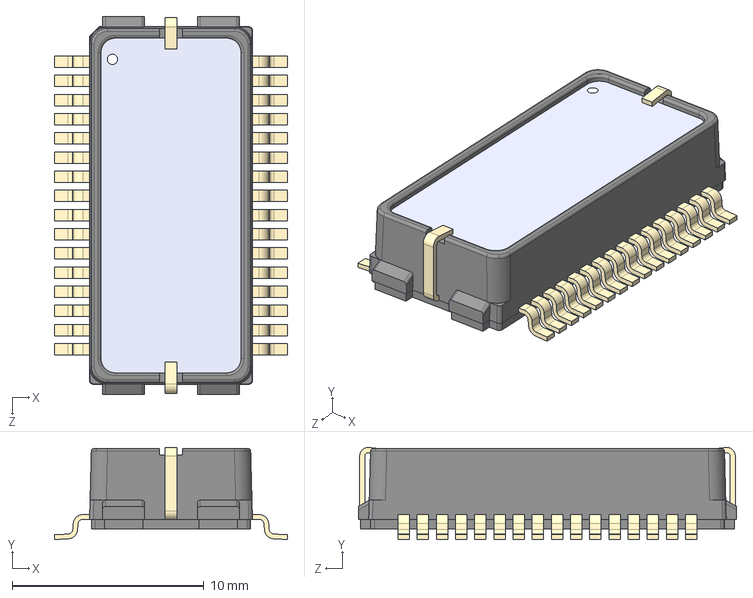
[picture p100: CAD file, 2023-12-23]
circuit-boards/IMU-2X-v3/3D-Models/SCHA63T-K03-05.step
12.2 x 4.80 x 19.7 mm
