frc971/electrical/circuit-boards/led-ring-driver/kicad/components/3D_Step/EEHAZF1E271.step

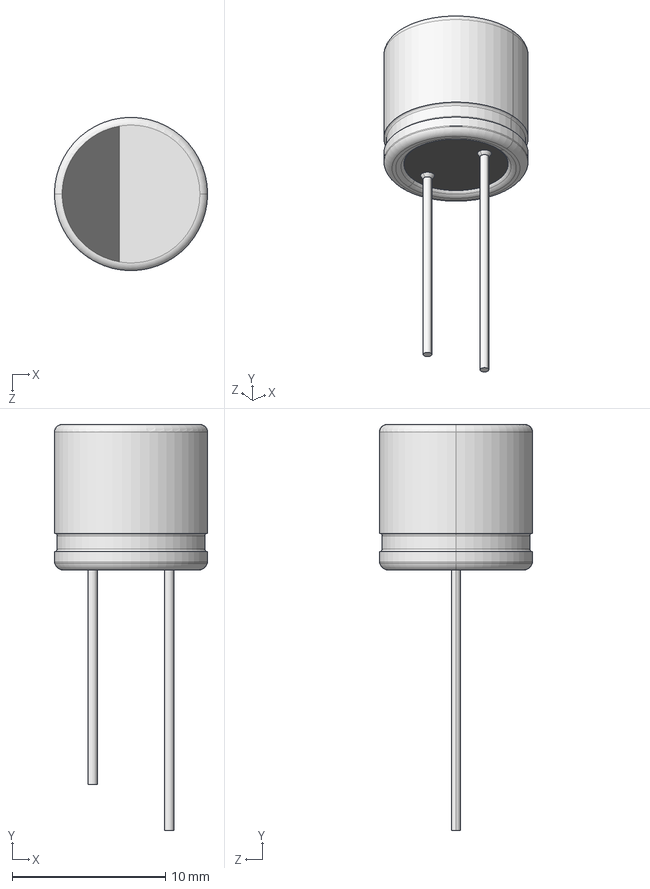
[picture p101: CAD file, 2023-12-23]
circuit-boards/led-ring-driver/kicad/components/3D_Step/EEHAZF1E271.step
10.0 x 26.5 x 10.0 mm
