frc971/electrical/circuit-boards/Orin-NX-PCBs/NX-IndicatorBoard-V2/3dModels/Samtec-ESQ-120-XX-X-D-XX.step

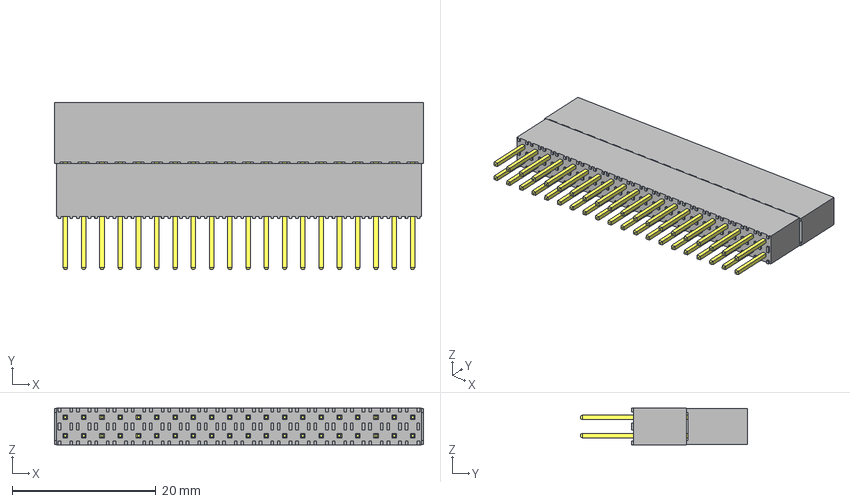
[picture p102: CAD file, 2024-07-14]
circuit-boards/Orin-NX-PCBs/NX-IndicatorBoard-V2/3dModels/Samtec-ESQ-120-XX-X-D-XX.step
51.3 x 23.2 x 5.08 mm
ESQ-120-34-G-D_socket
ESQ-120-34-G-D_pins
ESQ-120-34-G-D2_pins
ESQ-120-34-G-D-LL_bpins
