frc971/electrical/circuit-boards/Orin-NX-PCBs/NX-J401-Adapter-v3/3dModels/Molex-2086581051.stp

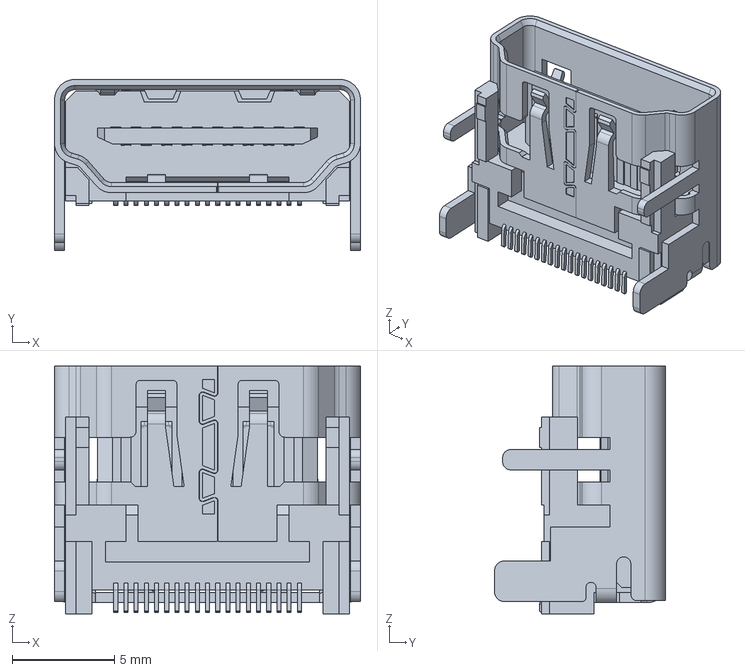
[picture p103: CAD file, 2024-07-16]
circuit-boards/Orin-NX-PCBs/NX-J401-Adapter-v3/3dModels/Molex-2086581051.stp
15.0 x 8.38 x 12.2 mm
