frc971/electrical/circuit-boards/shaft-encoders/mag-encoder4/3dModels/SOT765-1.step

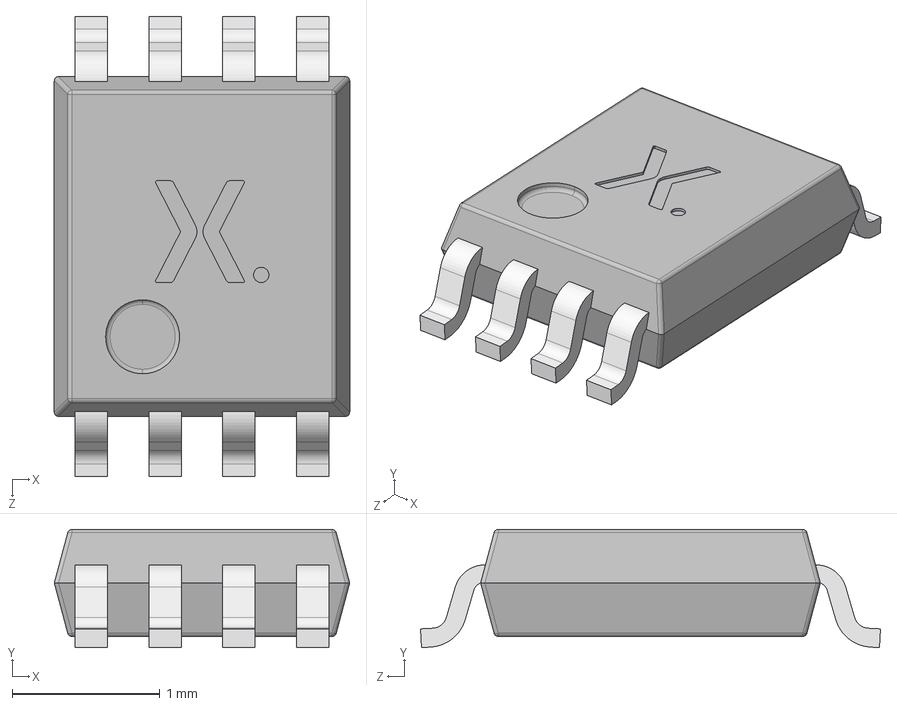
[picture p105: CAD file, 2024-08-21]
circuit-boards/shaft-encoders/mag-encoder4/3dModels/SOT765-1.step
2.00 x 0.8 x 3.11 mm
SOT765 Mold body
SOT765 Lead x 8
