frc971/electrical/circuit-boards/tools/kraken-pwm-controller/3dmodels/CFR_RB3_7.2X7.5X3.5_L7.4H7.6T3.6S5LL18F0.55.step

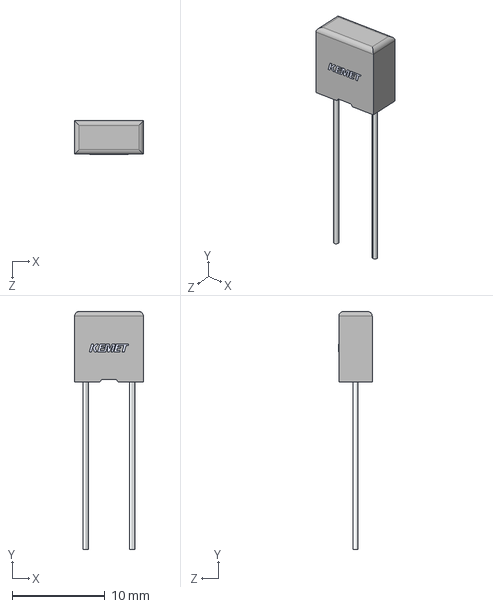
[picture p106: CAD file, 2024-07-30]
circuit-boards/tools/kraken-pwm-controller/3dmodels/CFR_RB3_7.2X7.5X3.5_L7.4H7.6T3.6S5LL18F0.55.step
7.40 x 25.6 x 3.60 mm
