frc971/electrical/circuit-boards/IMU-2X-v3/3D-Models/TE-5787834-2-c-3d.stp

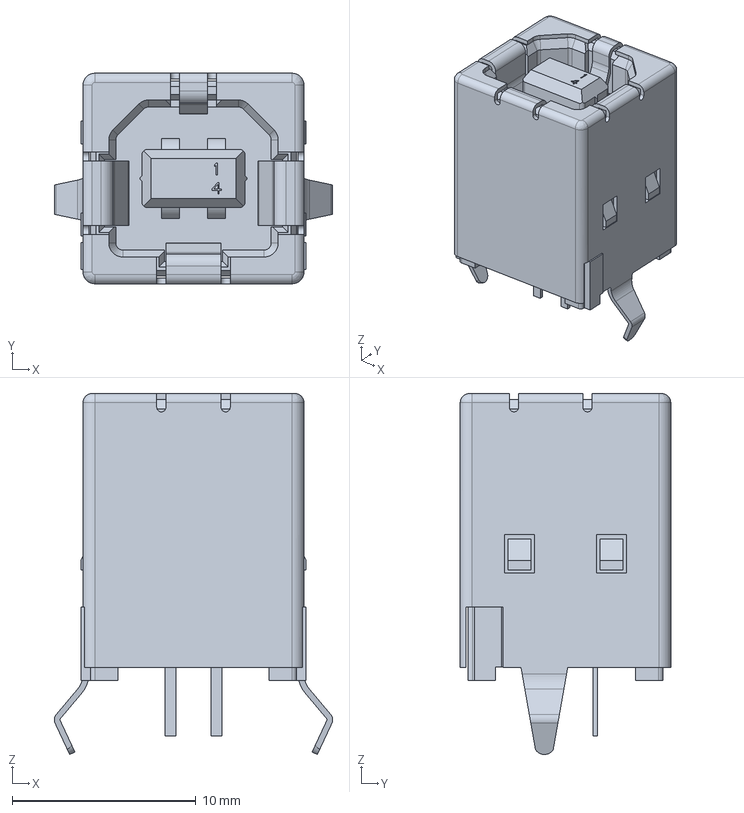
[picture p107: CAD file, 2023-12-23]
circuit-boards/IMU-2X-v3/3D-Models/TE-5787834-2-c-3d.stp
15.1 x 11.5 x 19.6 mm
