frc971/electrical/circuit-boards/led-ring-driver/kicad/components/3D_Step/LUXEON_2835_20160407_STEP.STEP

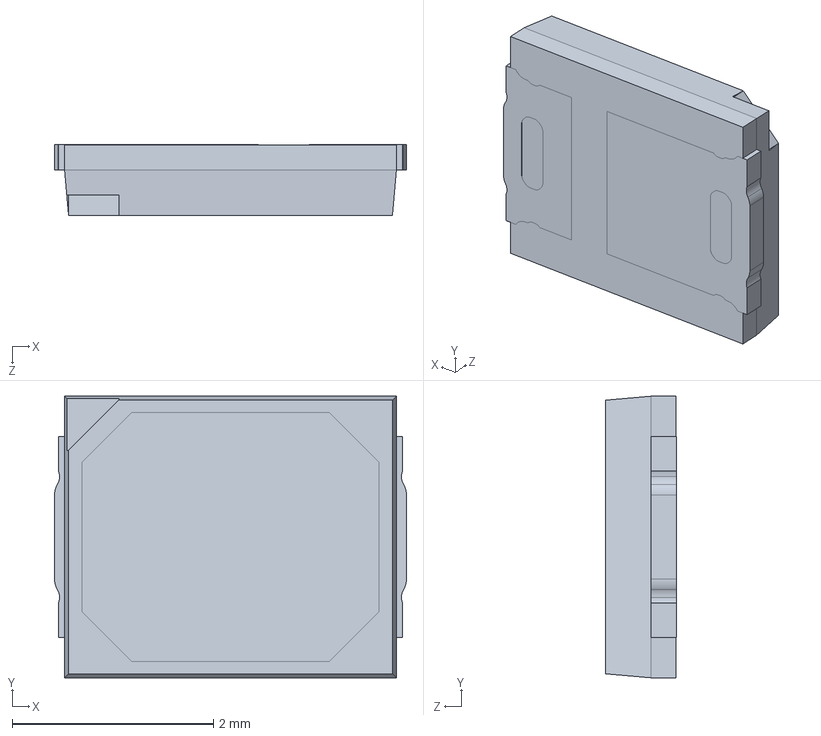
[picture p108: CAD file, 2023-12-23]
circuit-boards/led-ring-driver/kicad/components/3D_Step/LUXEON_2835_20160407_STEP.STEP
3.50 x 2.80 x 0.701 mm
