frc971/electrical/circuit-boards/Orin-NX-PCBs/NX-IndicatorBoard-V2/3dModels/NXP-DHVQFN-20.step

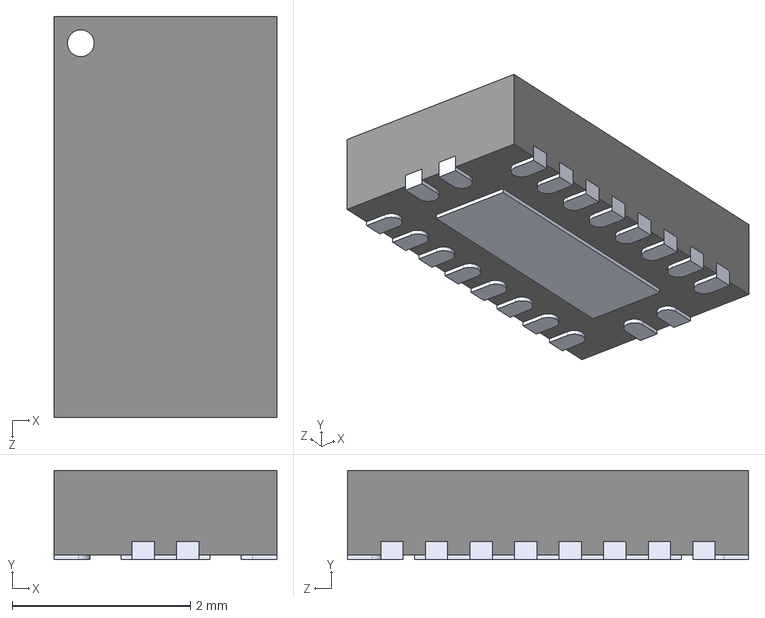
[picture p109: CAD file, 2024-07-14]
circuit-boards/Orin-NX-PCBs/NX-IndicatorBoard-V2/3dModels/NXP-DHVQFN-20.step
2.50 x 1.00 x 4.50 mm
