frc971/electrical/circuit-boards/Orin-NX-PCBs/NX-J401-Adapter-v3/3dModels/Switchcraft-RAVHD19ETR.STEP

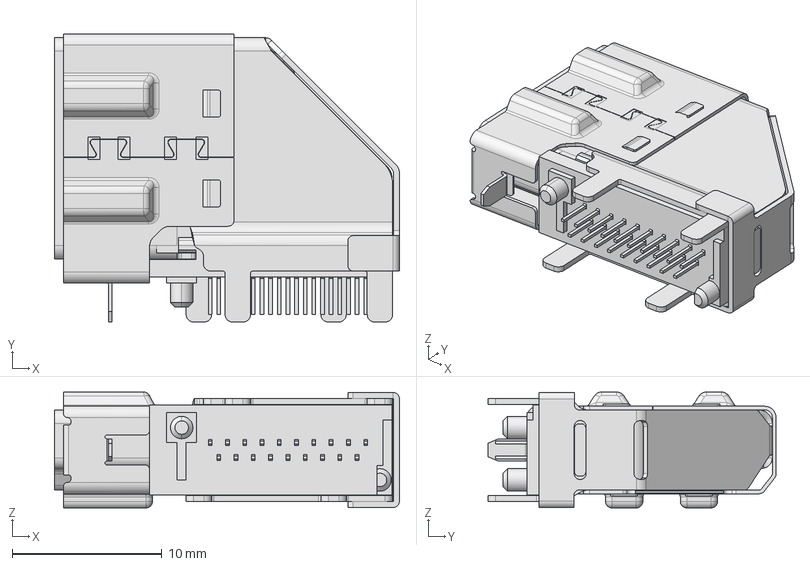
[picture p110: CAD file, 2024-07-16]
circuit-boards/Orin-NX-PCBs/NX-J401-Adapter-v3/3dModels/Switchcraft-RAVHD19ETR.STEP
23.1 x 19.3 x 7.75 mm
