frc971/electrical/circuit-boards/RPI-Power-Boards/RockPI-Power-Board/3dModels/SH-7010TA.stp

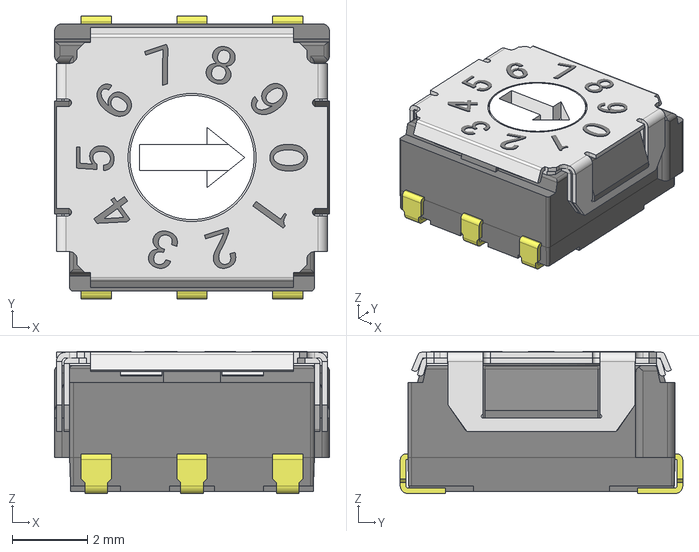
[picture p111: CAD file, 2023-12-23]
circuit-boards/RPI-Power-Boards/RockPI-Power-Board/3dModels/SH-7010TA.stp
7.30 x 7.50 x 3.77 mm
SH-700-Without knob (Minus slot)
SH-7010A_body
