frc971/electrical/circuit-boards/shaft-encoders/mag-encoder4/3dModels/Molex-015912055.stp

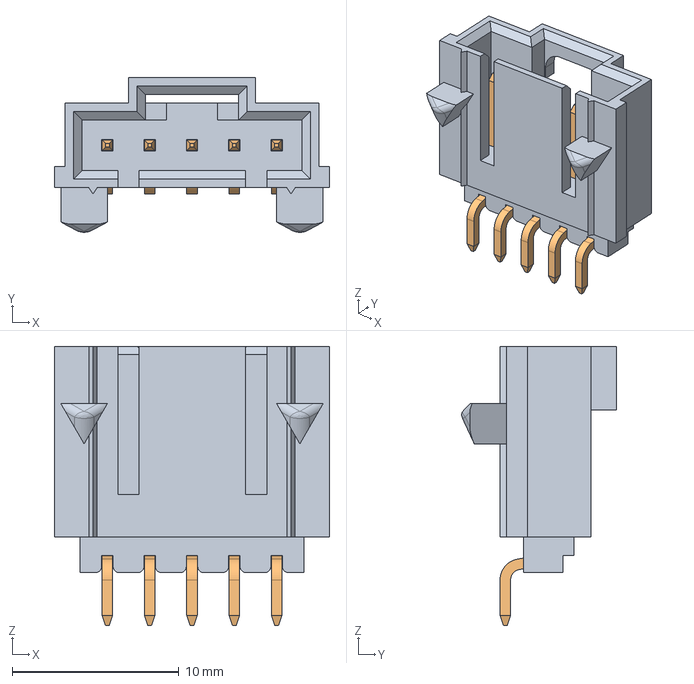
[picture p112: CAD file, 2024-08-21]
circuit-boards/shaft-encoders/mag-encoder4/3dModels/Molex-015912055.stp
16.5 x 9.29 x 16.8 mm
