frc971/electrical/circuit-boards/IMU-2X-v3/3D-Models/TL3301AF100QG--3DModel-STEP-520916.STEP

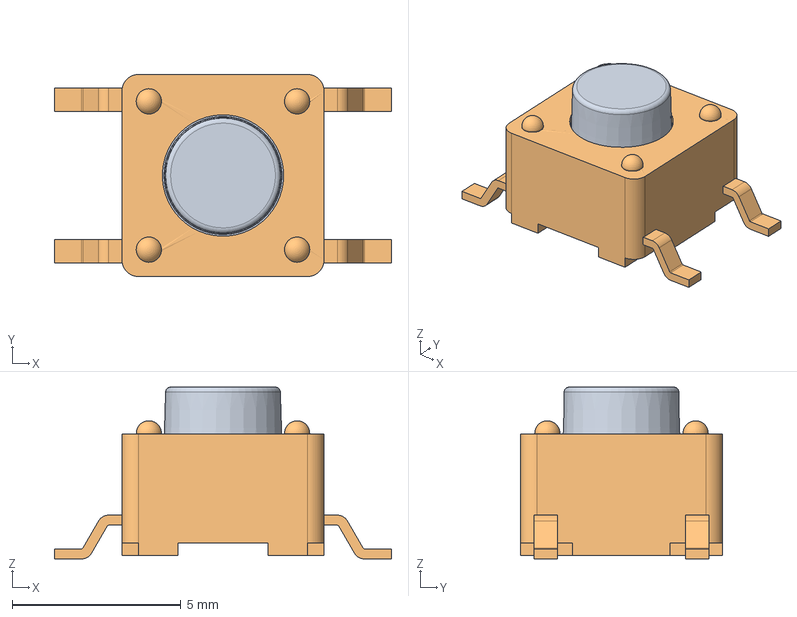
[picture p113: CAD file, 2023-12-23]
circuit-boards/IMU-2X-v3/3D-Models/TL3301AF100QG--3DModel-STEP-520916.STEP
10.0 x 6.00 x 5.10 mm
