frc971/electrical/circuit-boards/Orin-NX-PCBs/NX-IndicatorBoard-V2/3dModels/Molex-705430039.stp

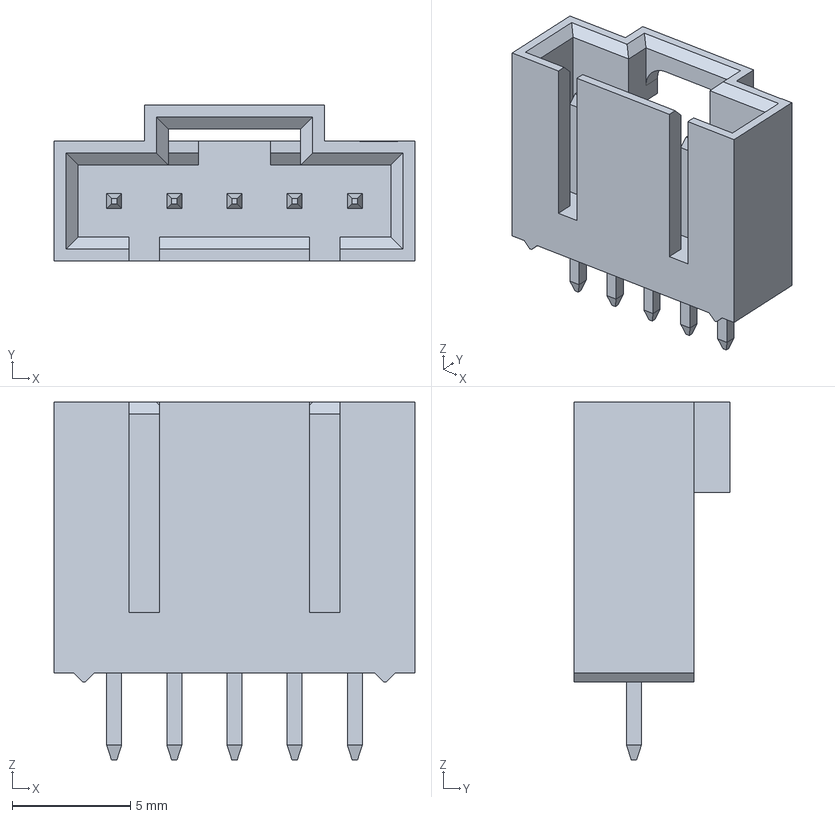
[picture p114: CAD file, 2024-07-14]
circuit-boards/Orin-NX-PCBs/NX-IndicatorBoard-V2/3dModels/Molex-705430039.stp
15.2 x 6.60 x 15.1 mm
