frc971/electrical/circuit-boards/Orin-NX-PCBs/NX-J401-Adapter-v3/3dModels/Bourns-SRP1265A series.stp

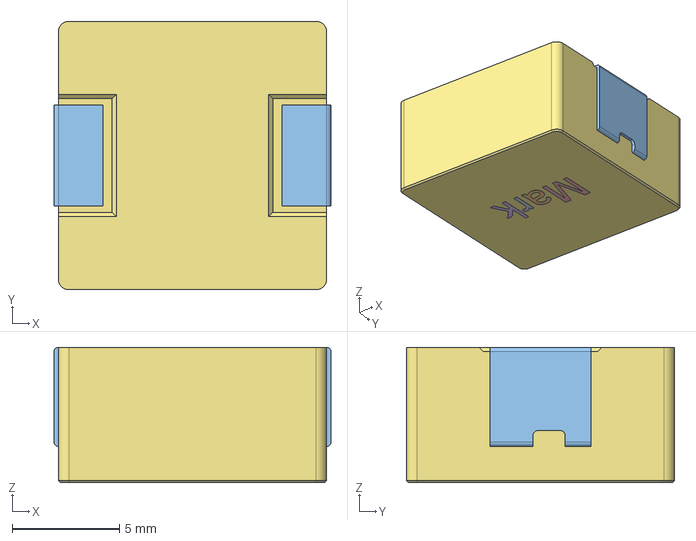
[picture p115: CAD file, 2024-07-16]
circuit-boards/Orin-NX-PCBs/NX-J401-Adapter-v3/3dModels/Bourns-SRP1265A series.stp
12.9 x 12.5 x 6.30 mm
