frc971/electrical/circuit-boards/IMU-2X-v3/3D-Models/CNC-Tech-3220-14-0300-00.step

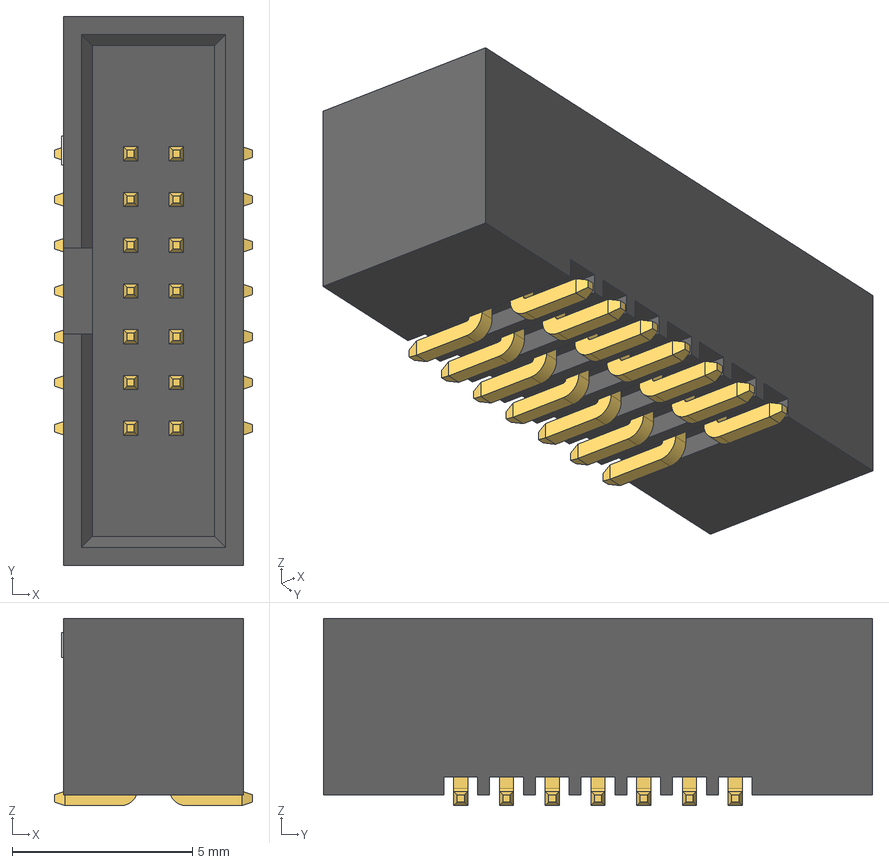
[picture p116: CAD file, 2023-12-23]
circuit-boards/IMU-2X-v3/3D-Models/CNC-Tech-3220-14-0300-00.step
5.50 x 15.2 x 5.20 mm
