frc971/electrical/circuit-boards/Orin-NX-PCBs/NX-J401-Adapter-v3/3dModels/BM02B-SRSS-TB.STEP

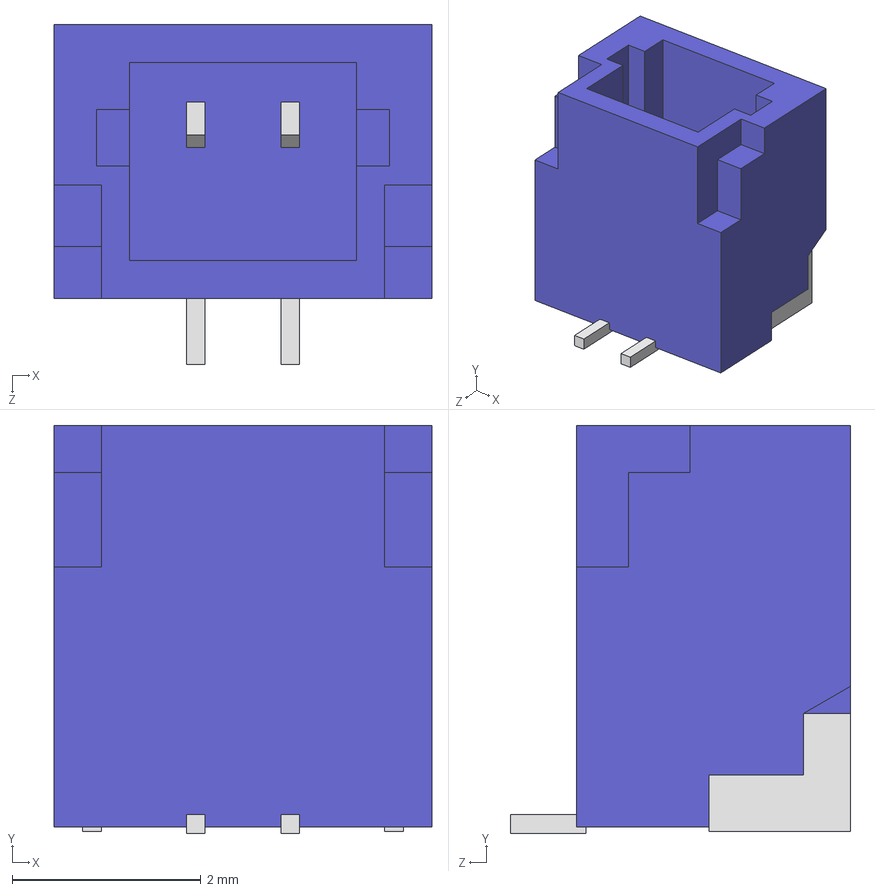
[picture p117: CAD file, 2023-12-31]
circuit-boards/Orin-NX-PCBs/NX-J401-Adapter-v3/3dModels/BM02B-SRSS-TB.STEP
4.00 x 4.32 x 3.60 mm
