frc971/electrical/circuit-boards/IMU-2X-v3/3D-Models/Wago-2604-3102.stp

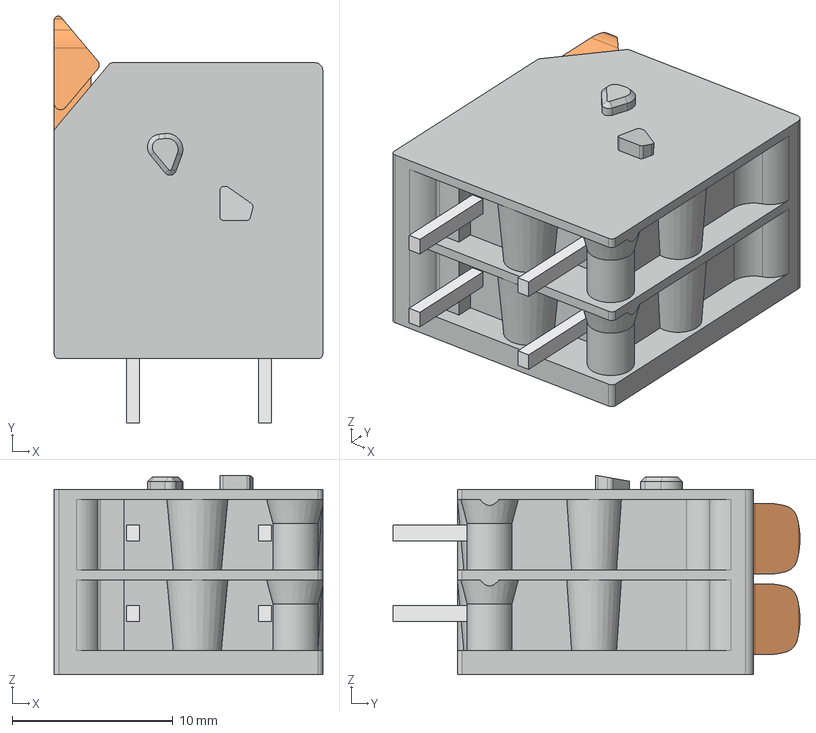
[picture p118: CAD file, 2023-12-23]
circuit-boards/IMU-2X-v3/3D-Models/Wago-2604-3102.stp
16.7 x 25.3 x 12.4 mm
