frc971/electrical/circuit-boards/Orin-NX-PCBs/NX-IndicatorBoard-V2/3dModels/ECS-5032MV-400-CN-TR.STEP

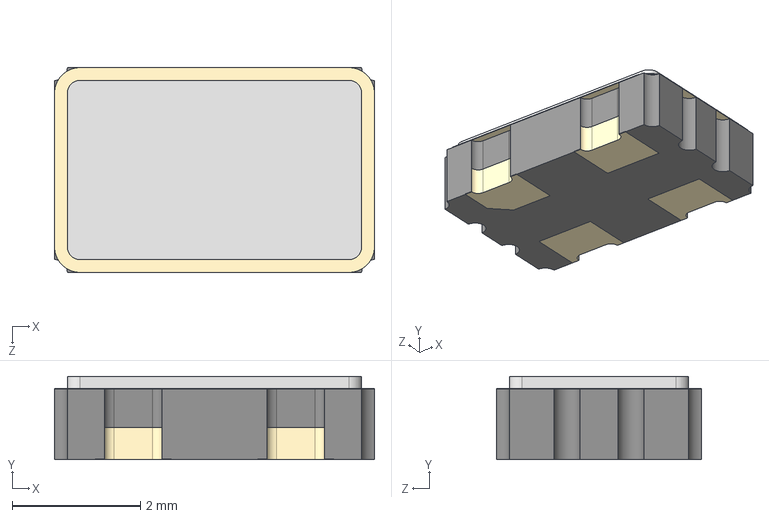
[picture p119: CAD file, 2023-12-23]
circuit-boards/Orin-NX-PCBs/NX-IndicatorBoard-V2/3dModels/ECS-5032MV-400-CN-TR.STEP
5.00 x 1.30 x 3.20 mm
