frc971/electrical/circuit-boards/IMU-2X-v3/3D-Models/IHLP2525CZ.STEP

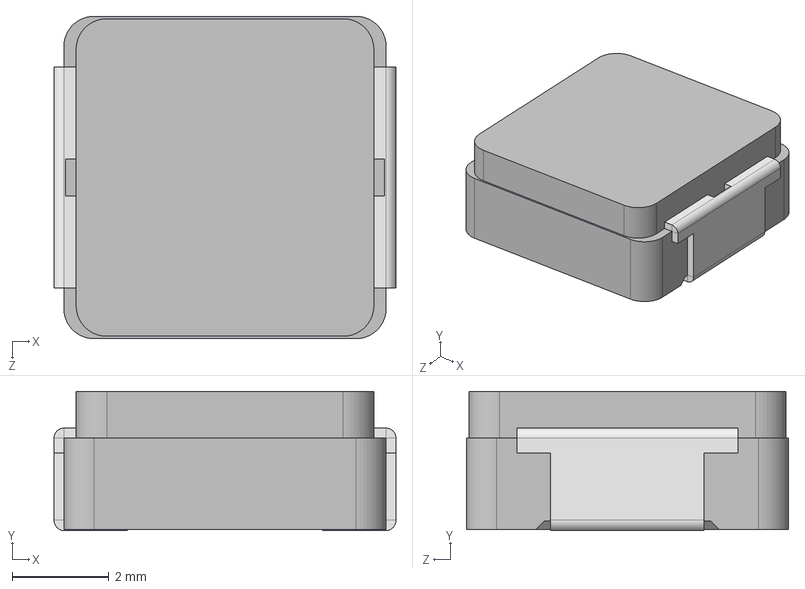
[picture p120: CAD file, 2023-12-23]
circuit-boards/IMU-2X-v3/3D-Models/IHLP2525CZ.STEP
7.08 x 2.88 x 6.67 mm
