frc971/electrical/circuit-boards/Orin-NX-PCBs/NX-IndicatorBoard-V2/3dModels/Lumex-LPF-C013301S.STEP

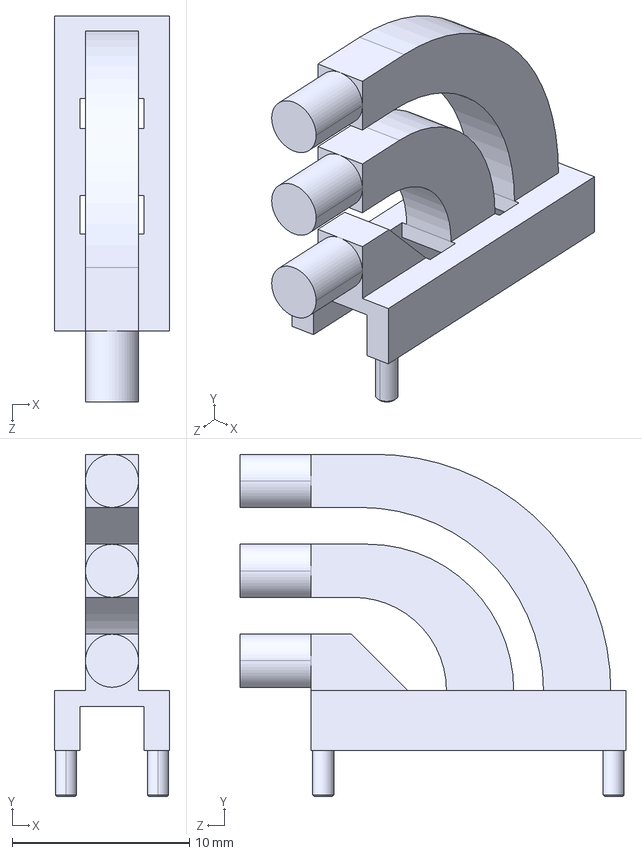
[picture p121: CAD file, 2023-12-23]
circuit-boards/Orin-NX-PCBs/NX-IndicatorBoard-V2/3dModels/Lumex-LPF-C013301S.STEP
6.50 x 19.3 x 21.8 mm
