frc971/electrical/circuit-boards/Orin-NX-PCBs/NX-J401-Adapter-v3/3dModels/TL1105VFxxxx.stp

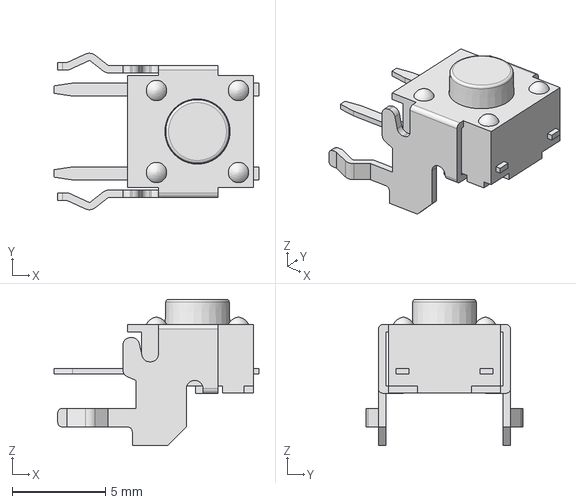
[picture p122: CAD file, 2023-12-23]
circuit-boards/Orin-NX-PCBs/NX-J401-Adapter-v3/3dModels/TL1105VFxxxx.stp
11.0 x 8.40 x 7.85 mm
