frc971/electrical/circuit-boards/Orin-NX-PCBs/NX-IndicatorBoard-V2/3dModels/IND_IHLP-1212BZ_VIS.step

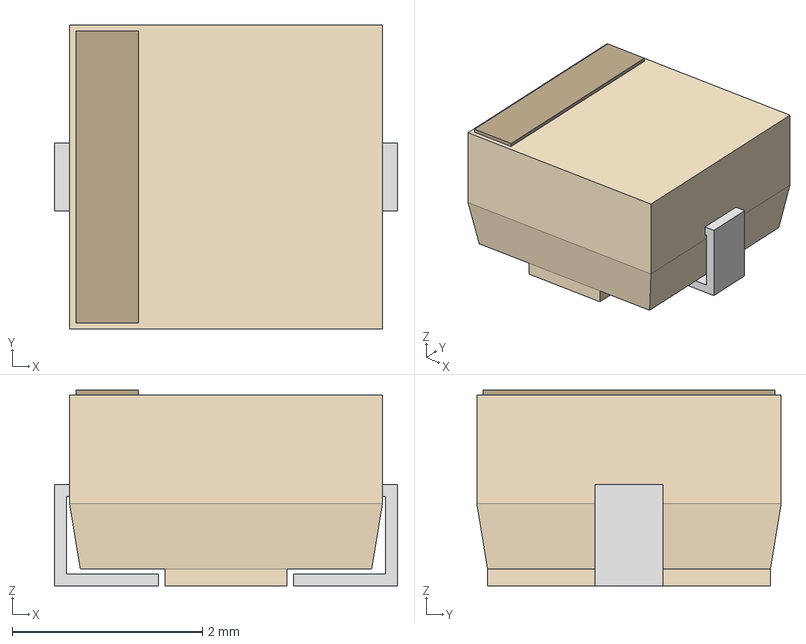
[picture p123: CAD file, 2023-12-23]
circuit-boards/Orin-NX-PCBs/NX-IndicatorBoard-V2/3dModels/IND_IHLP-1212BZ_VIS.step
3.61 x 3.20 x 2.06 mm
