frc971/electrical/circuit-boards/Orin-NX-PCBs/NX-IndicatorBoard-V2/3dModels/Kingbright-APTD3216.STEP

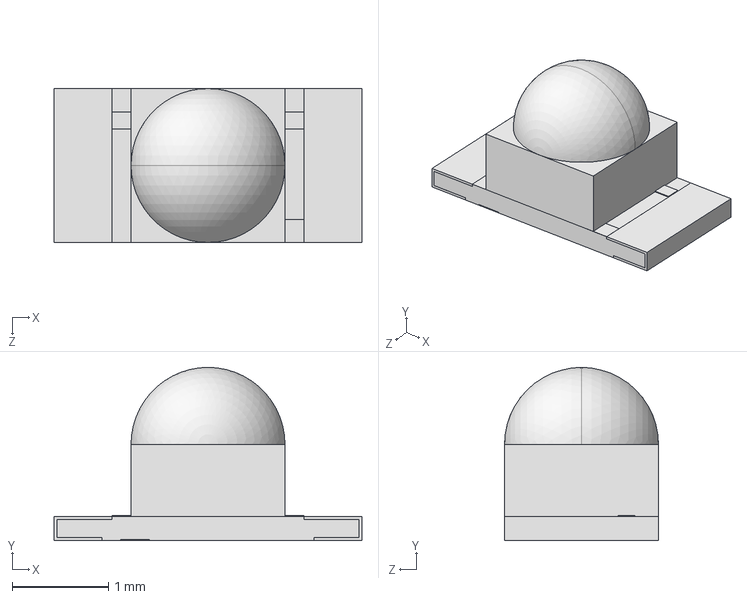
[picture p124: CAD file, 2023-12-23]
circuit-boards/Orin-NX-PCBs/NX-IndicatorBoard-V2/3dModels/Kingbright-APTD3216.STEP
3.20 x 1.80 x 1.60 mm
