frc971/electrical/circuit-boards/Orin-NX-PCBs/NX-J401-Adapter-v3/3dModels/Wurth_691406510002B (rev1).stp

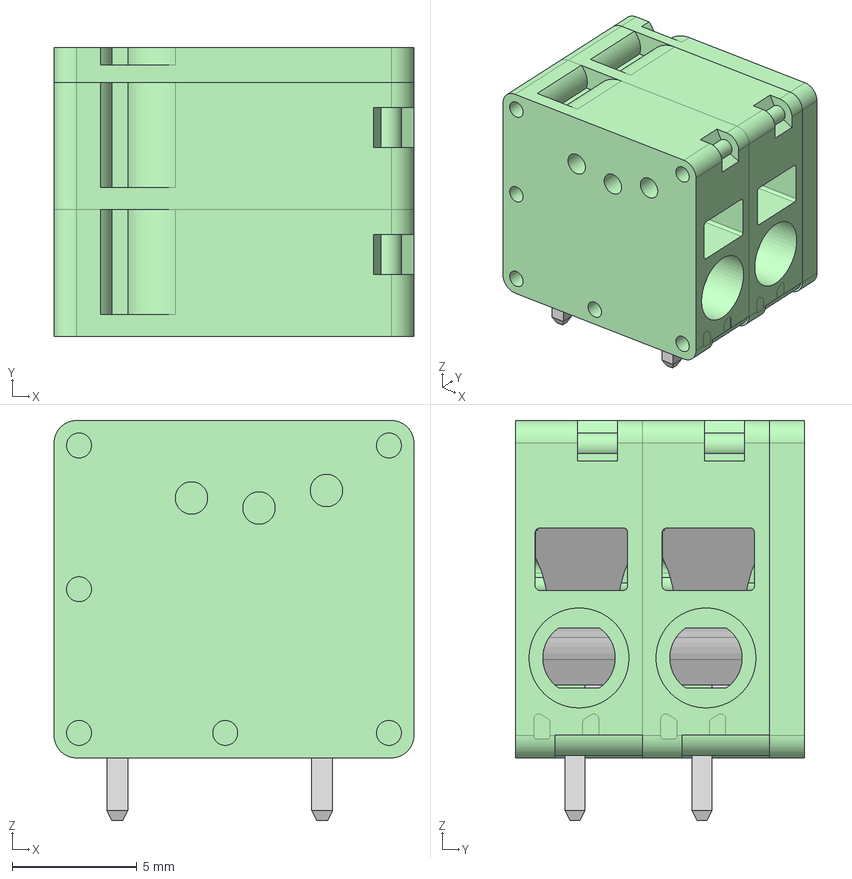
[picture p125: CAD file, 2023-12-22]
circuit-boards/Orin-NX-PCBs/NX-J401-Adapter-v3/3dModels/Wurth_691406510002B (rev1).stp
14.4 x 11.6 x 16.0 mm
6914065100xxB_body x 2
6914065100xxB_terminal x 2
6914065100xxB_spring x 2
6914065100xxB_cover
