frc971/electrical/circuit-boards/Orin-NX-PCBs/NX-J401-Adapter-v3/3dModels/SunLED-XZxxxx55W-8.step

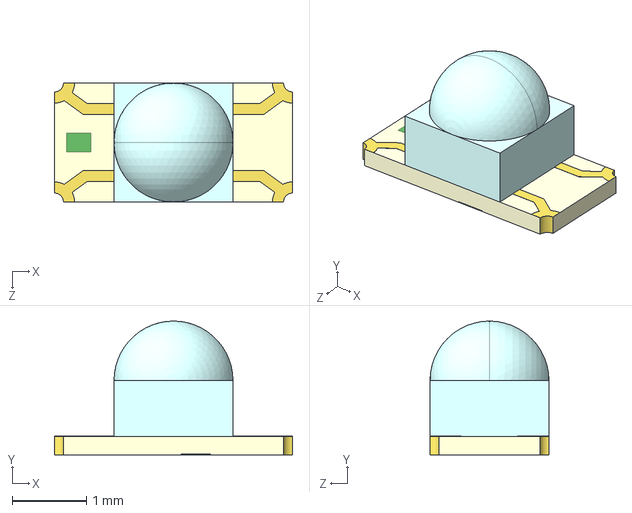
[picture p126: CAD file, 2023-12-22]
circuit-boards/Orin-NX-PCBs/NX-J401-Adapter-v3/3dModels/SunLED-XZxxxx55W-8.step
3.20 x 1.80 x 1.60 mm
