frc971/electrical/circuit-boards/Orin-NX-PCBs/NX-J401-Adapter-v3/3dModels/BM04B-SRSS-TB.STEP

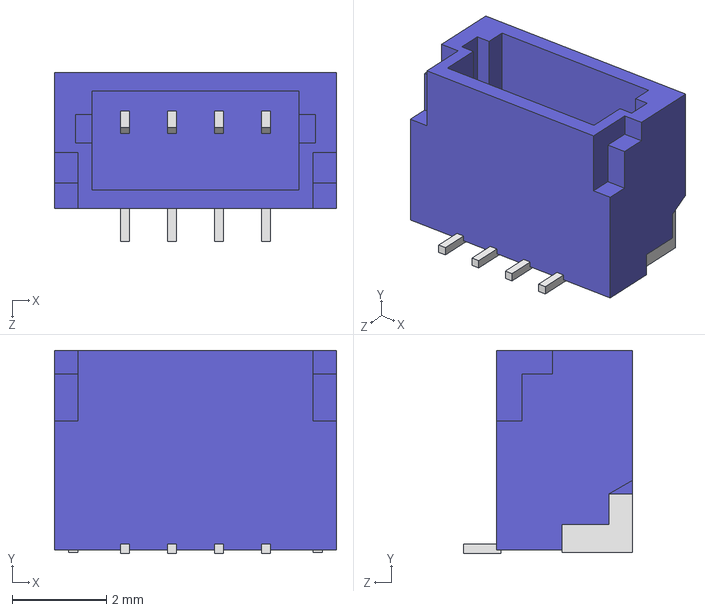
[picture p127: CAD file, 2023-12-22]
circuit-boards/Orin-NX-PCBs/NX-J401-Adapter-v3/3dModels/BM04B-SRSS-TB.STEP
6.00 x 4.32 x 3.60 mm
