frc971/electrical/circuit-boards/Orin-NX-PCBs/NX-J401-Adapter-v3/3dModels/2601-1102.stp

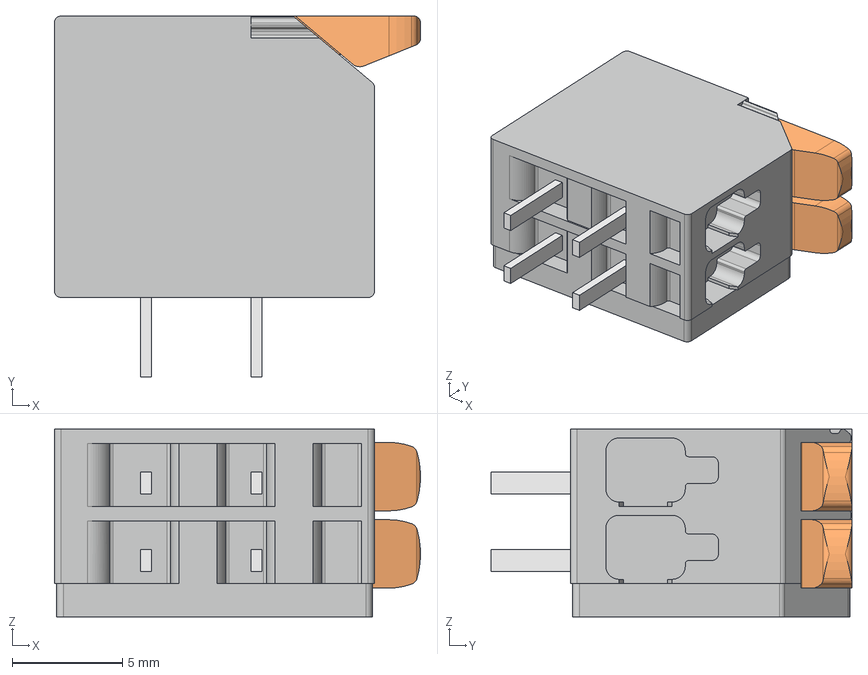
[picture p128: CAD file, 2023-12-22]
circuit-boards/Orin-NX-PCBs/NX-J401-Adapter-v3/3dModels/2601-1102.stp
16.6 x 16.4 x 8.50 mm
