frc971/electrical/circuit-boards/Orin-NX-PCBs/NX-J401-Adapter-v3/3dModels/TE-c-5499913-2-b-3d.stp

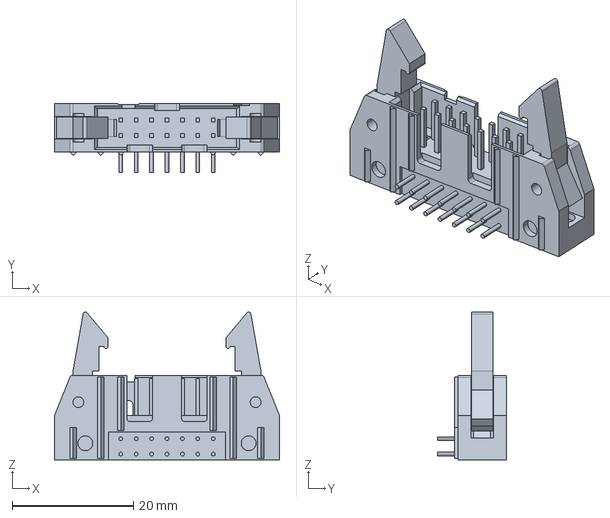
[picture p129: CAD file, 2023-12-22]
circuit-boards/Orin-NX-PCBs/NX-J401-Adapter-v3/3dModels/TE-c-5499913-2-b-3d.stp
37.1 x 11.3 x 24.4 mm
