frc971/electrical/circuit-boards/Orin-NX-PCBs/NX-J401-Adapter-v3/3dModels/Wurth_691408720002B (rev1).stp

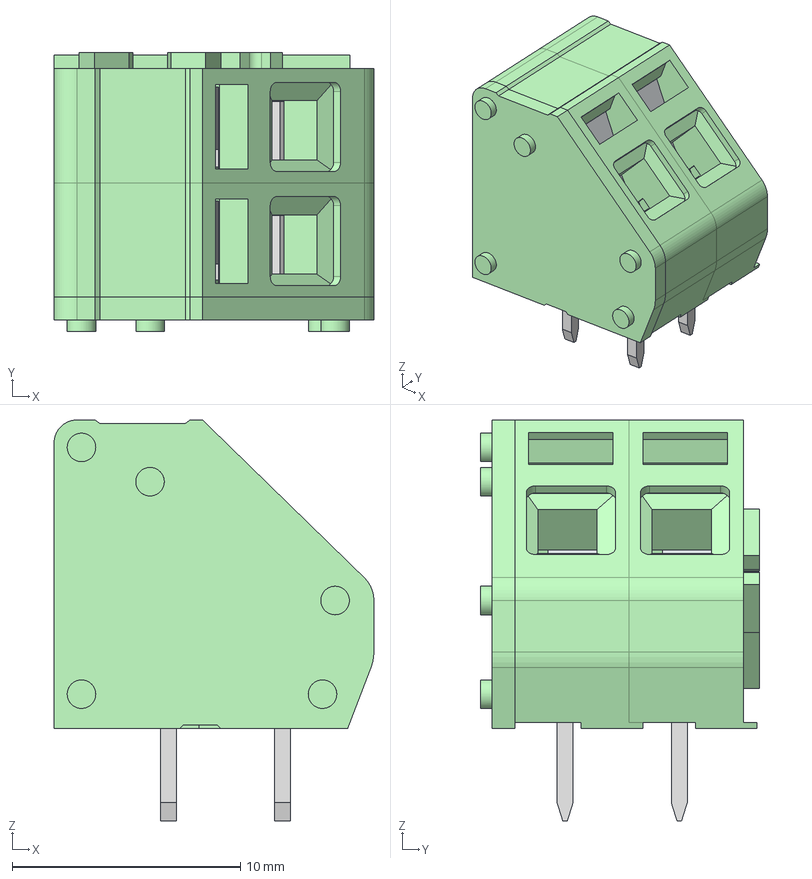
[picture p130: CAD file, 2023-12-22]
circuit-boards/Orin-NX-PCBs/NX-J401-Adapter-v3/3dModels/Wurth_691408720002B (rev1).stp
14.0 x 12.2 x 17.6 mm
6914087200xxB_body x 2
6914087200xxB_terminal x 2
6914087200xxB_spring x 2
6914087200xxB_cover
