frc971/electrical/circuit-boards/Orin-NX-PCBs/NX-J401-Adapter-v3/3dModels/VSON8-DQJ0008A.stp

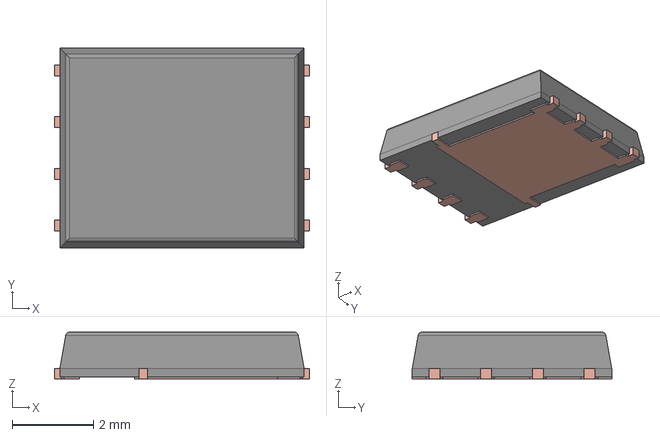
[picture p131: CAD file, 2023-12-22]
circuit-boards/Orin-NX-PCBs/NX-J401-Adapter-v3/3dModels/VSON8-DQJ0008A.stp
6.26 x 4.90 x 1.15 mm
FRAME
MOLD
