frc971/electrical/circuit-boards/Orin-NX-PCBs/NX-J401-Adapter-v3/3dModels/BM05B-SURS-TF.STEP

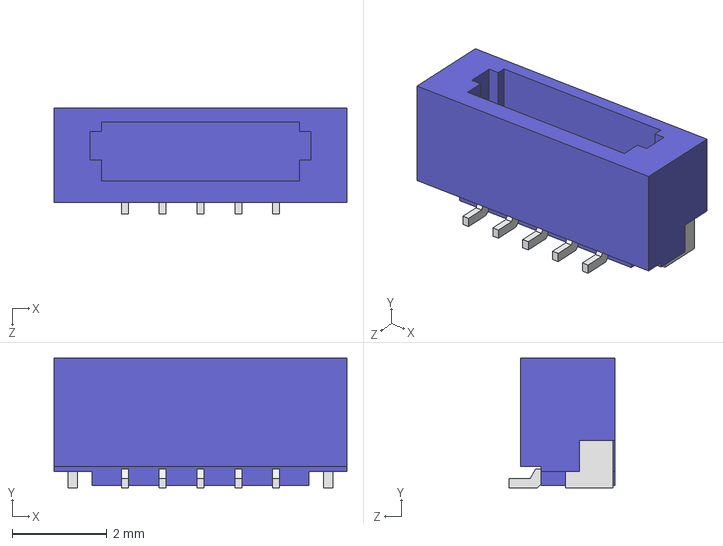
[picture p132: CAD file, 2023-12-22]
circuit-boards/Orin-NX-PCBs/NX-J401-Adapter-v3/3dModels/BM05B-SURS-TF.STEP
6.20 x 2.75 x 2.25 mm
