frc971/electrical/(list of files, cad)

Other CAD files:
circuit-boards/IMU-2X-v3/3D-Models/705410002.stp
circuit-boards/Orin-NX-PCBs/NX-ButtonInterface-v3/3dModels/705410006.stp
circuit-boards/Orin-NX-PCBs/NX-ButtonInterface-v3/3dModels/705430003.stp
circuit-boards/Orin-NX-PCBs/NX-ButtonInterface-v3/3dModels/705430006.stp
circuit-boards/Orin-NX-PCBs/NX-IndicatorBoard-V2/3dModels/705430036.stp
circuit-boards/Orin-NX-PCBs/NX-J401-Adapter-v2/3dModels/BM02B-SURS-TF.STEP
circuit-boards/Orin-NX-PCBs/NX-J401-Adapter-v3/3dModels/705410001.stp
circuit-boards/Orin-NX-PCBs/NX-J401-Adapter-v3/3dModels/705430001.stp
circuit-boards/Orin-NX-PCBs/NX-J401-Adapter-v3/3dModels/705430005.stp
circuit-boards/Orin-NX-PCBs/NX-J401-Adapter-v3/3dModels/705550001.stp
circuit-boards/Orin-NX-PCBs/NX-J401-Adapter-v3/3dModels/705550002.stp
circuit-boards/Orin-NX-PCBs/NX-J401-Adapter-v3/3dModels/705550003.stp
circuit-boards/Orin-NX-PCBs/NX-J401-Adapter-v3/3dModels/705550005.stp
circuit-boards/Orin-NX-PCBs/NX-J401-Adapter-v3/3dModels/m20-7812045_asm.stp
circuit-boards/RPI-Power-Boards/RockPI-Power-Board/3dModels/705550011.stp
circuit-boards/RPI-Power-Boards/RockPI-Power-Board/3dModels/744031001_Download_STP_WE-TPC-3816_rev1.stp
circuit-boards/connector_boards/CAN_Hub/3d Models/JS102011CQN.stp
circuit-boards/connector_boards/CAN_Terminator/3D model/70555-0036_stp/705550036.stp
circuit-boards/connector_boards/MAG_encoder_adapter/3D models/20021521-00010XXLFc.stp
circuit-boards/connector_boards/RRIB2/3dModels/705410004.stp
circuit-boards/connector_boards/TEE-CAN-SL/3dModels/70541-0036.stp
circuit-boards/connector_boards/encoder_adapter/3d-model/150080AS75000_Download_STP_WL-SMCW-0805_rev1.stp
circuit-boards/connector_boards/encoder_adapter/3d-model/705410074.stp
circuit-boards/connector_boards/kraken-can-adapter-V2/3dModels/93465A103_Brass Socket Head Screw.STEP
circuit-boards/connector_boards/kraken-can-adapter-V2/3dModels/93465A147_Brass Socket Head Screw.STEP
circuit-boards/connector_boards/kraken-can-adapter-V2/3dModels/93661A115_Copper SAE Washer.STEP
circuit-boards/connector_boards/kraken-can-adapter-V2/3dModels/93701A250_Steel Pan Head Torx Screws.STEP
circuit-boards/connector_boards/kraken-can-adapter-V2/3dModels/97565A113_Copper Mil. Spec. Washer.STEP
circuit-boards/connector_boards/kraken-can-adapter-V2/3dModels/97715A424_Brass Button Head Hex Drive Screws.STEP
circuit-boards/connector_boards/kraken-can-adapter/kraken-can-adapter-drl_map.dxf
circuit-boards/connector_boards/kraken-can-adapter/kraken-can-adapter.step
circuit-boards/connector_boards/kraken-power-adapter/3dModels/92916A325_Brass Washer.STEP
circuit-boards/driver-station/ButtonBd2-v2/3dModels/705410003.stp
circuit-boards/driver-station/ButtonBd2-v2/3dModels/705410005.stp
circuit-boards/driver-station/ButtonBd2-v2/3dModels/705410007.stp
circuit-boards/driver-station/ButtonBd2-v2/3dModels/705410009.stp
circuit-boards/driver-station/ButtonBd2-v2/3dModels/705430007.stp
circuit-boards/driver-station/ButtonBd2-v2/3dModels/m20-7811245_asm.stp
circuit-boards/hall-effect/3D-models/015913034.stp
circuit-boards/hall-switch-v2/3d-Models/70555-0037.step
circuit-boards/led-ring-driver/kicad/components/3D_Step/430450601.stp
circuit-boards/shaft-encoders/mag-encoder4/3dModels/70555-0005--3DModel-STEP-361473.STEP
circuit-boards/tools/kraken-pwm-controller/3dmodels/705510001.stp
