frc971/electrical/circuit-boards/IMU-2X-v3/Output-Files/Design-Files/IMU-2X-sch.pdf

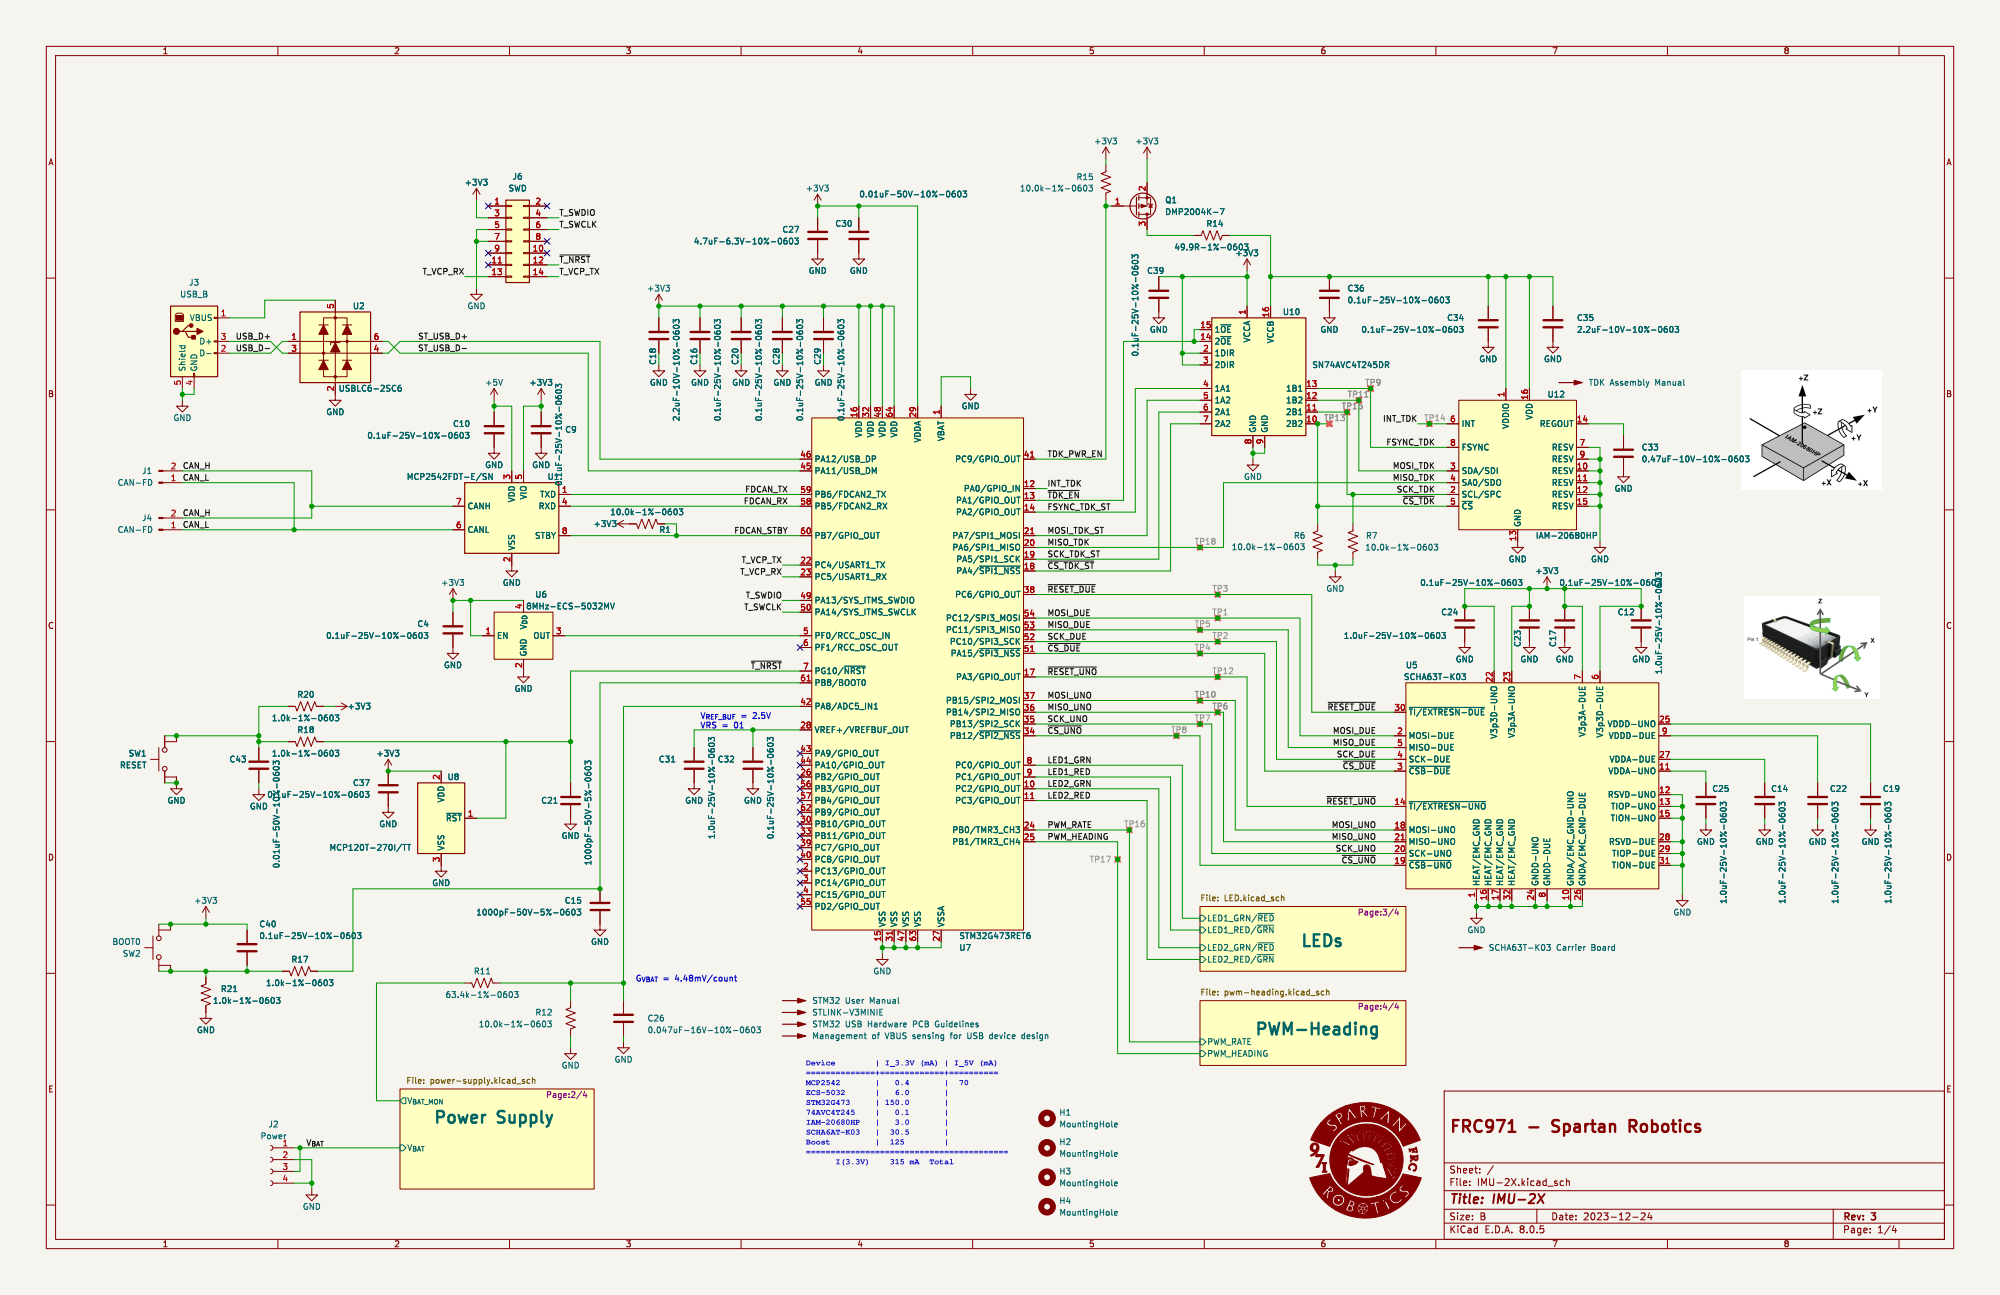
[picture p133: page 1]

1 RESV 10 RESV 11 RESV 12 GND 13 REGOUT 14 RESV 15 VDD 16 SCL/SPC 2 SDA/SDI 3 SA0/SDO 4 ~{CS} 5 RESV 9

2 OUT 3 V_{DD} 4 C9 0.1uF-25V-10%-0603 GND GND

1 VSS 15 VDD 16 PA3/GPIO_OUT 17 PA4/~{SPI1_NSS}18 PA5/SPI1_SCK 19 PA6/SPI1_MISO 20 PA7/SPI1_MOSI 21 PC4/USART1_TX 22 PC5/USART1_RX 23 VSSA 27 VREF+/VREFBUF_OUT 28 VDDA 29 VSS 31 VDD 32

5 CANL 6 CANH 7 STBY 8 MCP2542FDT-E/SN U1 GND

1 GNDA/EMC_GND-UNO 10 VDDA-UNO

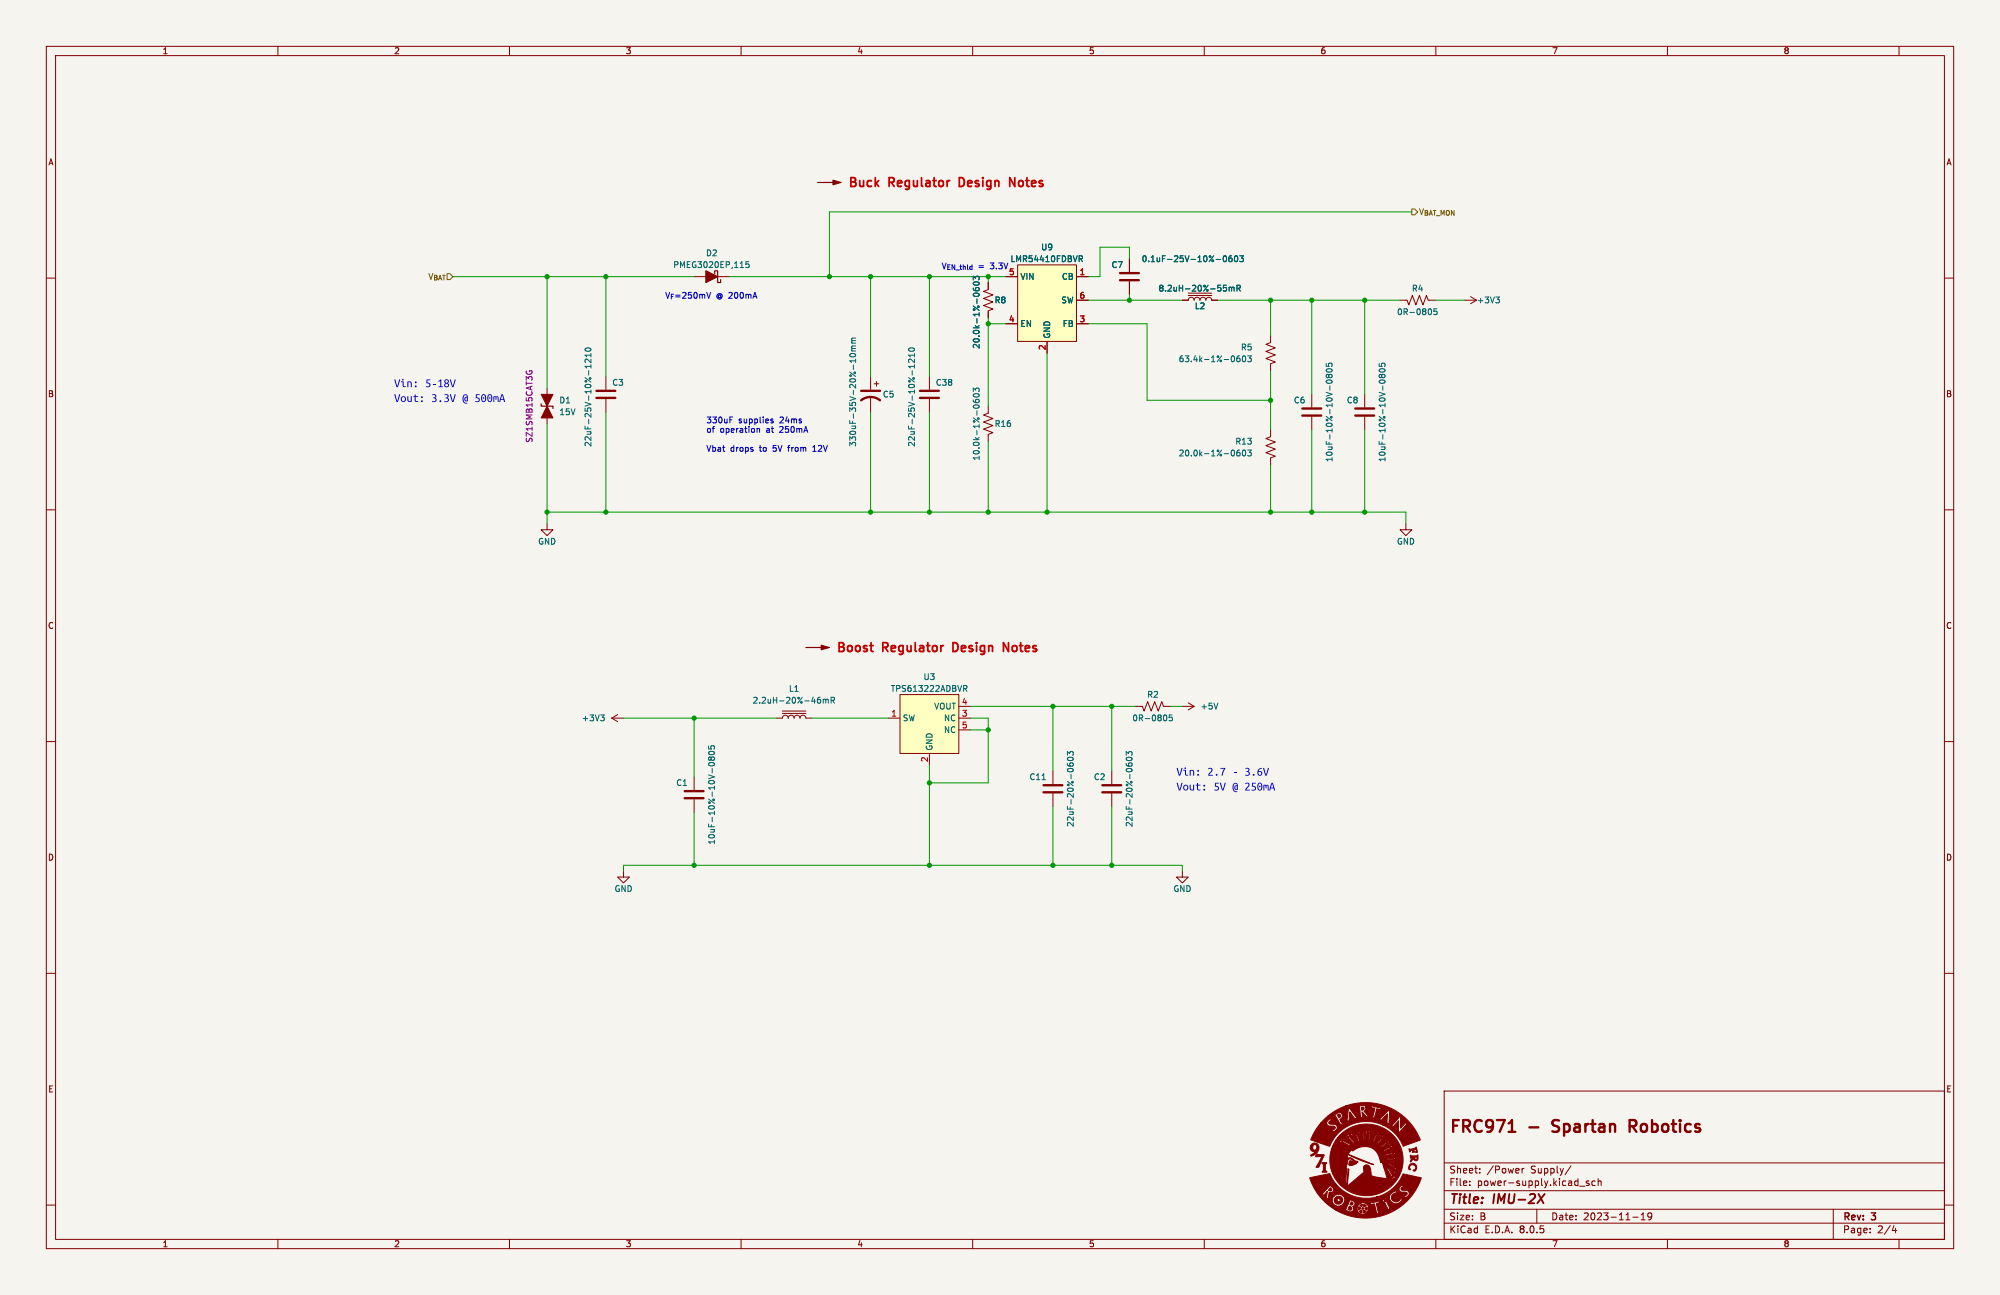
[picture p134: page 2]

2 FB 3 EN 4 VIN 5 SW 6

Vbat drops to 5V from 12V Vin: 5-18V
Vout: 3.3V @500mA

2 NC 3 VOUT 4 NC 5 U3 TPS613222ADBVR Boost Regulator Design Notes

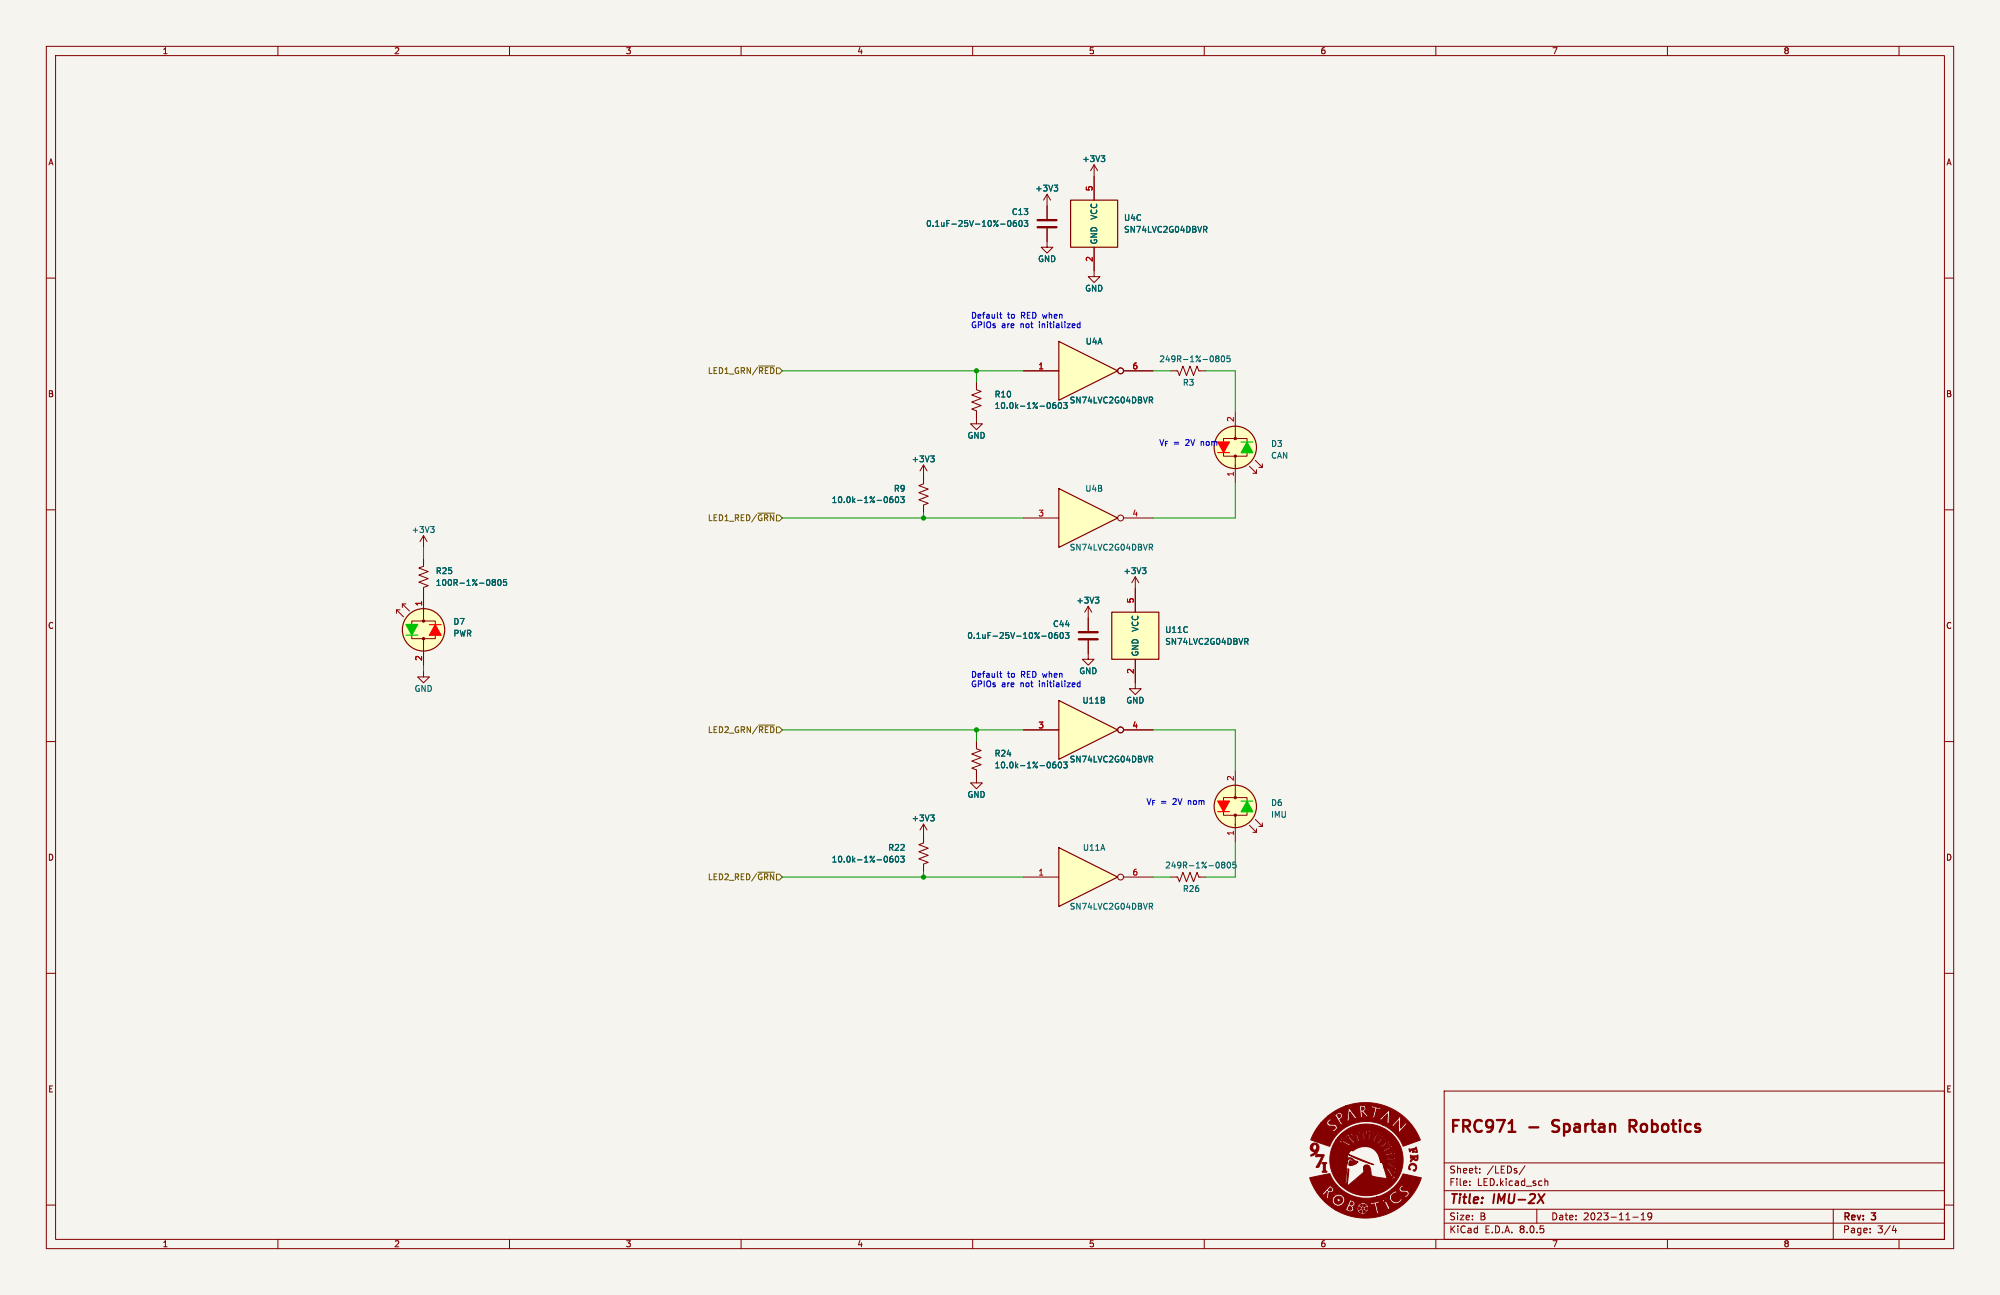
[picture p135: page 3]

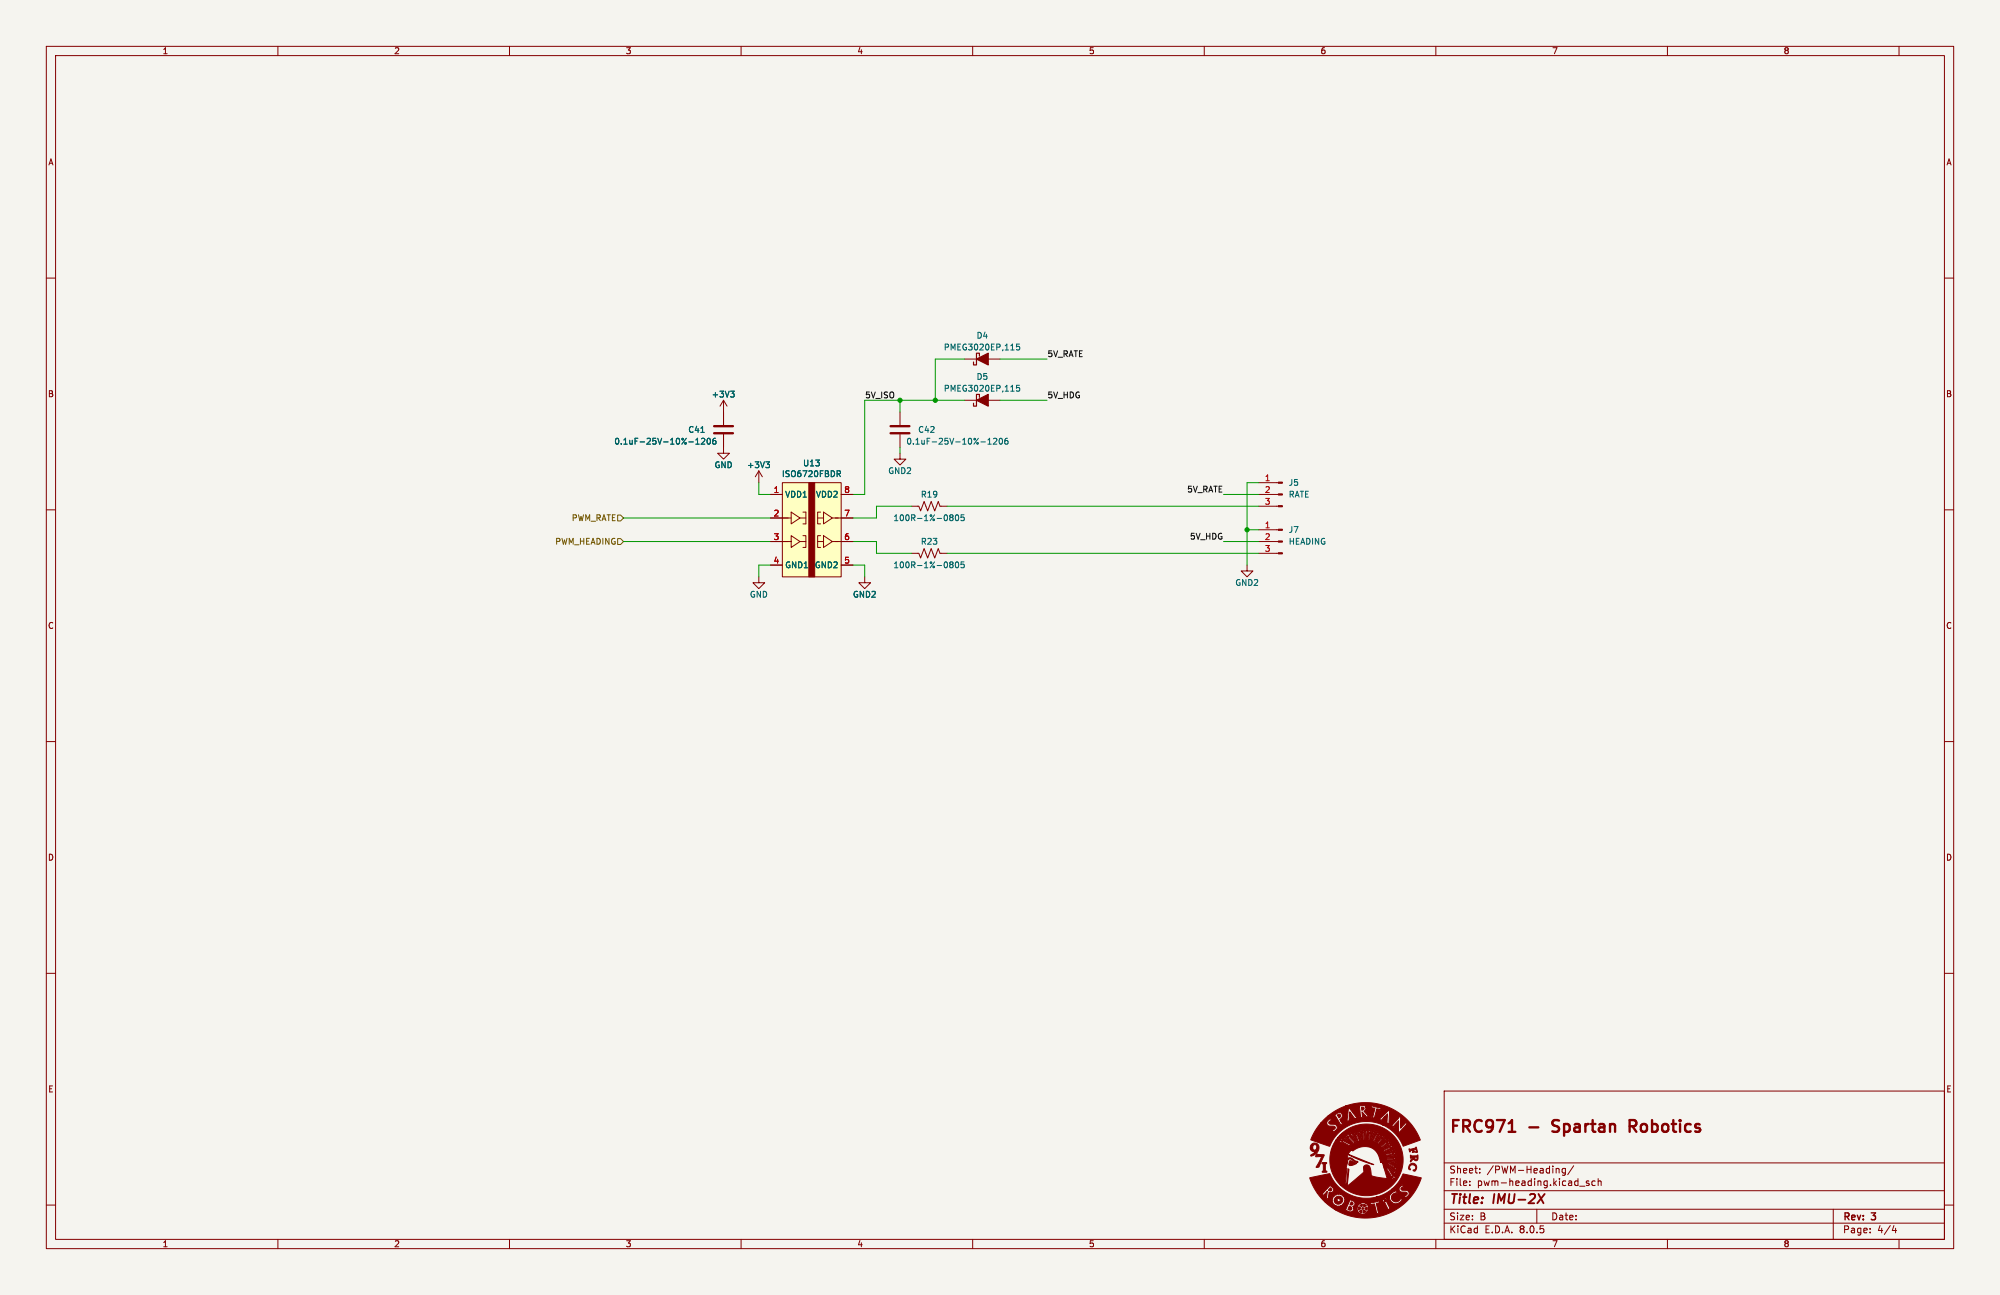
[picture p136: page 4]

File: pwm-heading.kicad_sch Sheet: /PWM-Heading/
