frc971/electrical/circuit-boards/IMU-2X-v3/Components/CNC-Tech--3220-XX-0300-00_.pdf

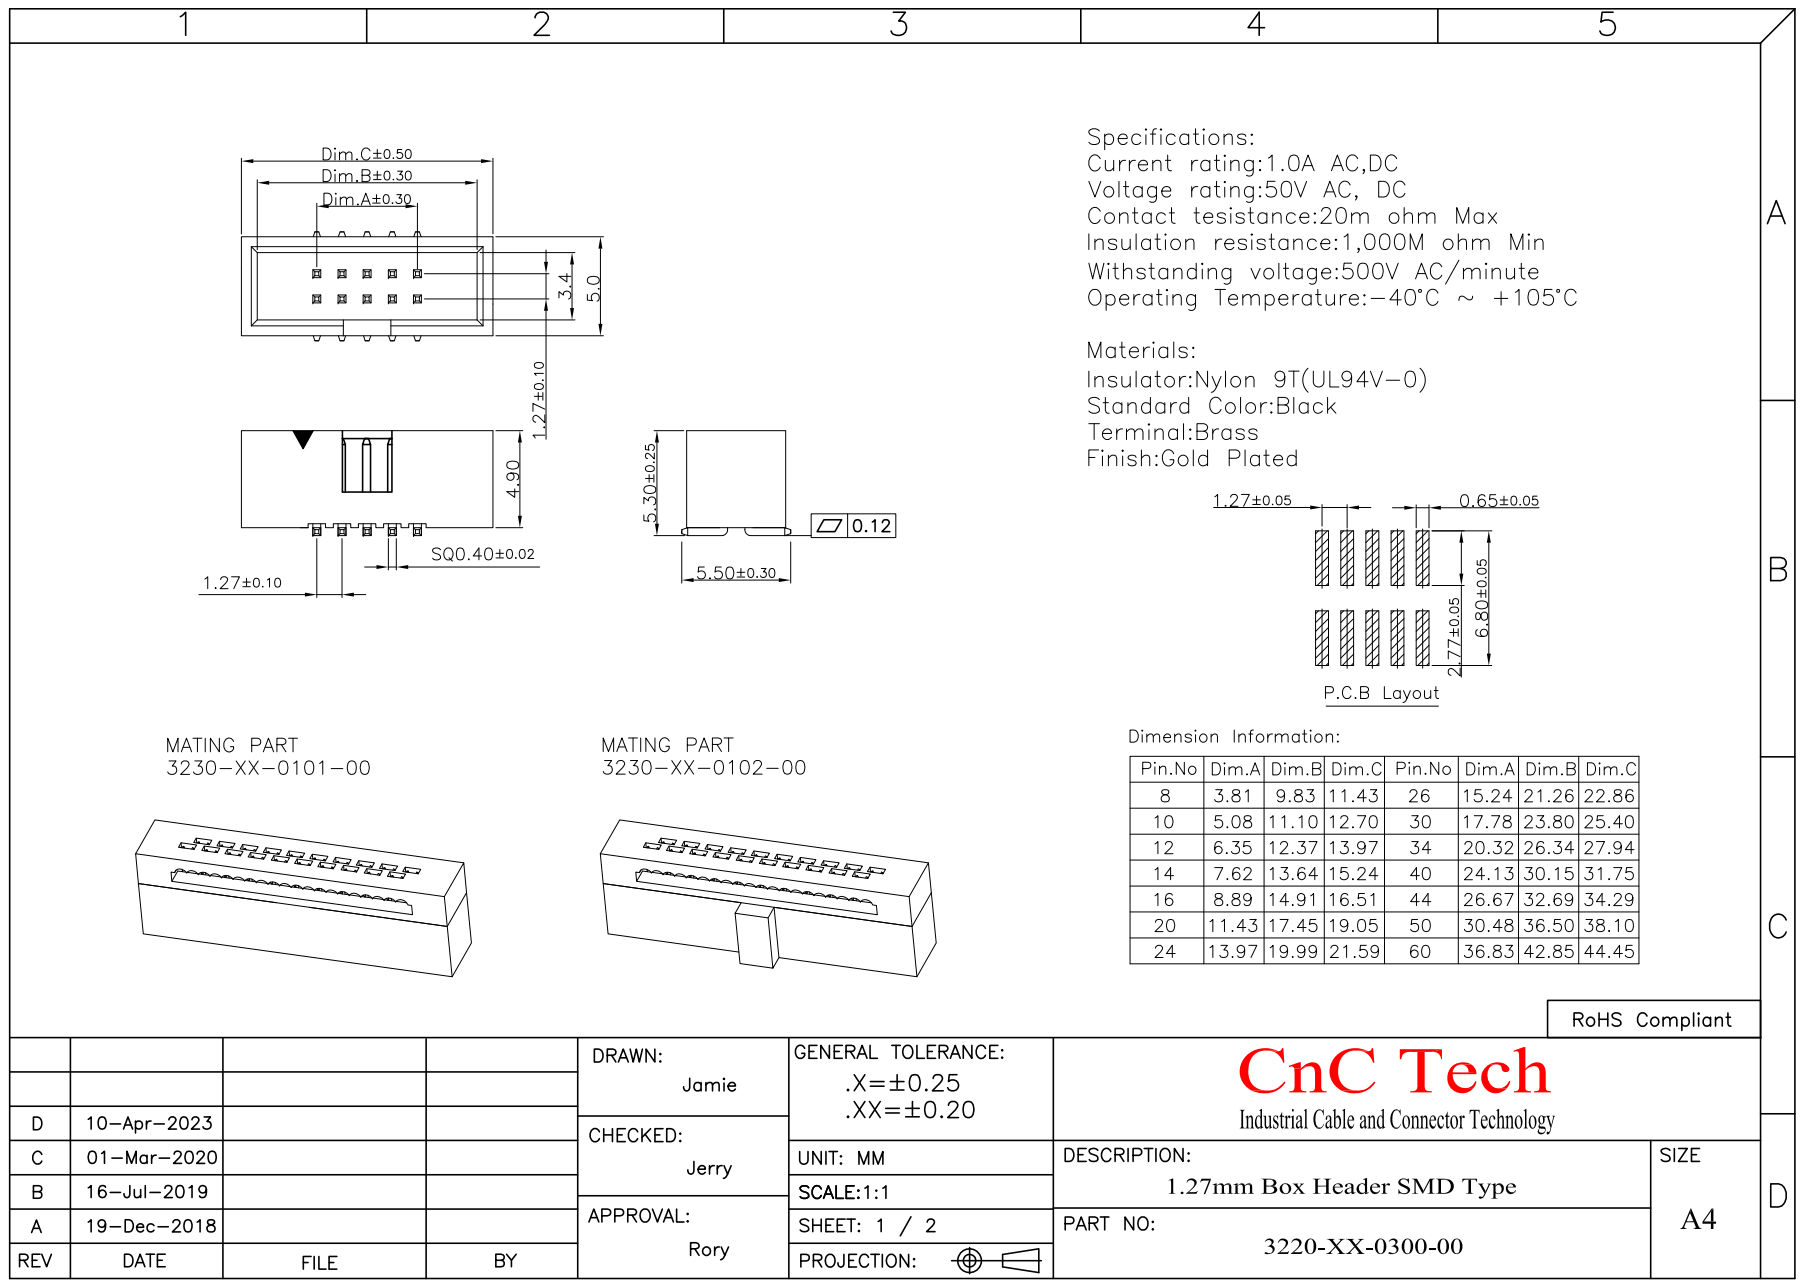
[picture p137: page 1]

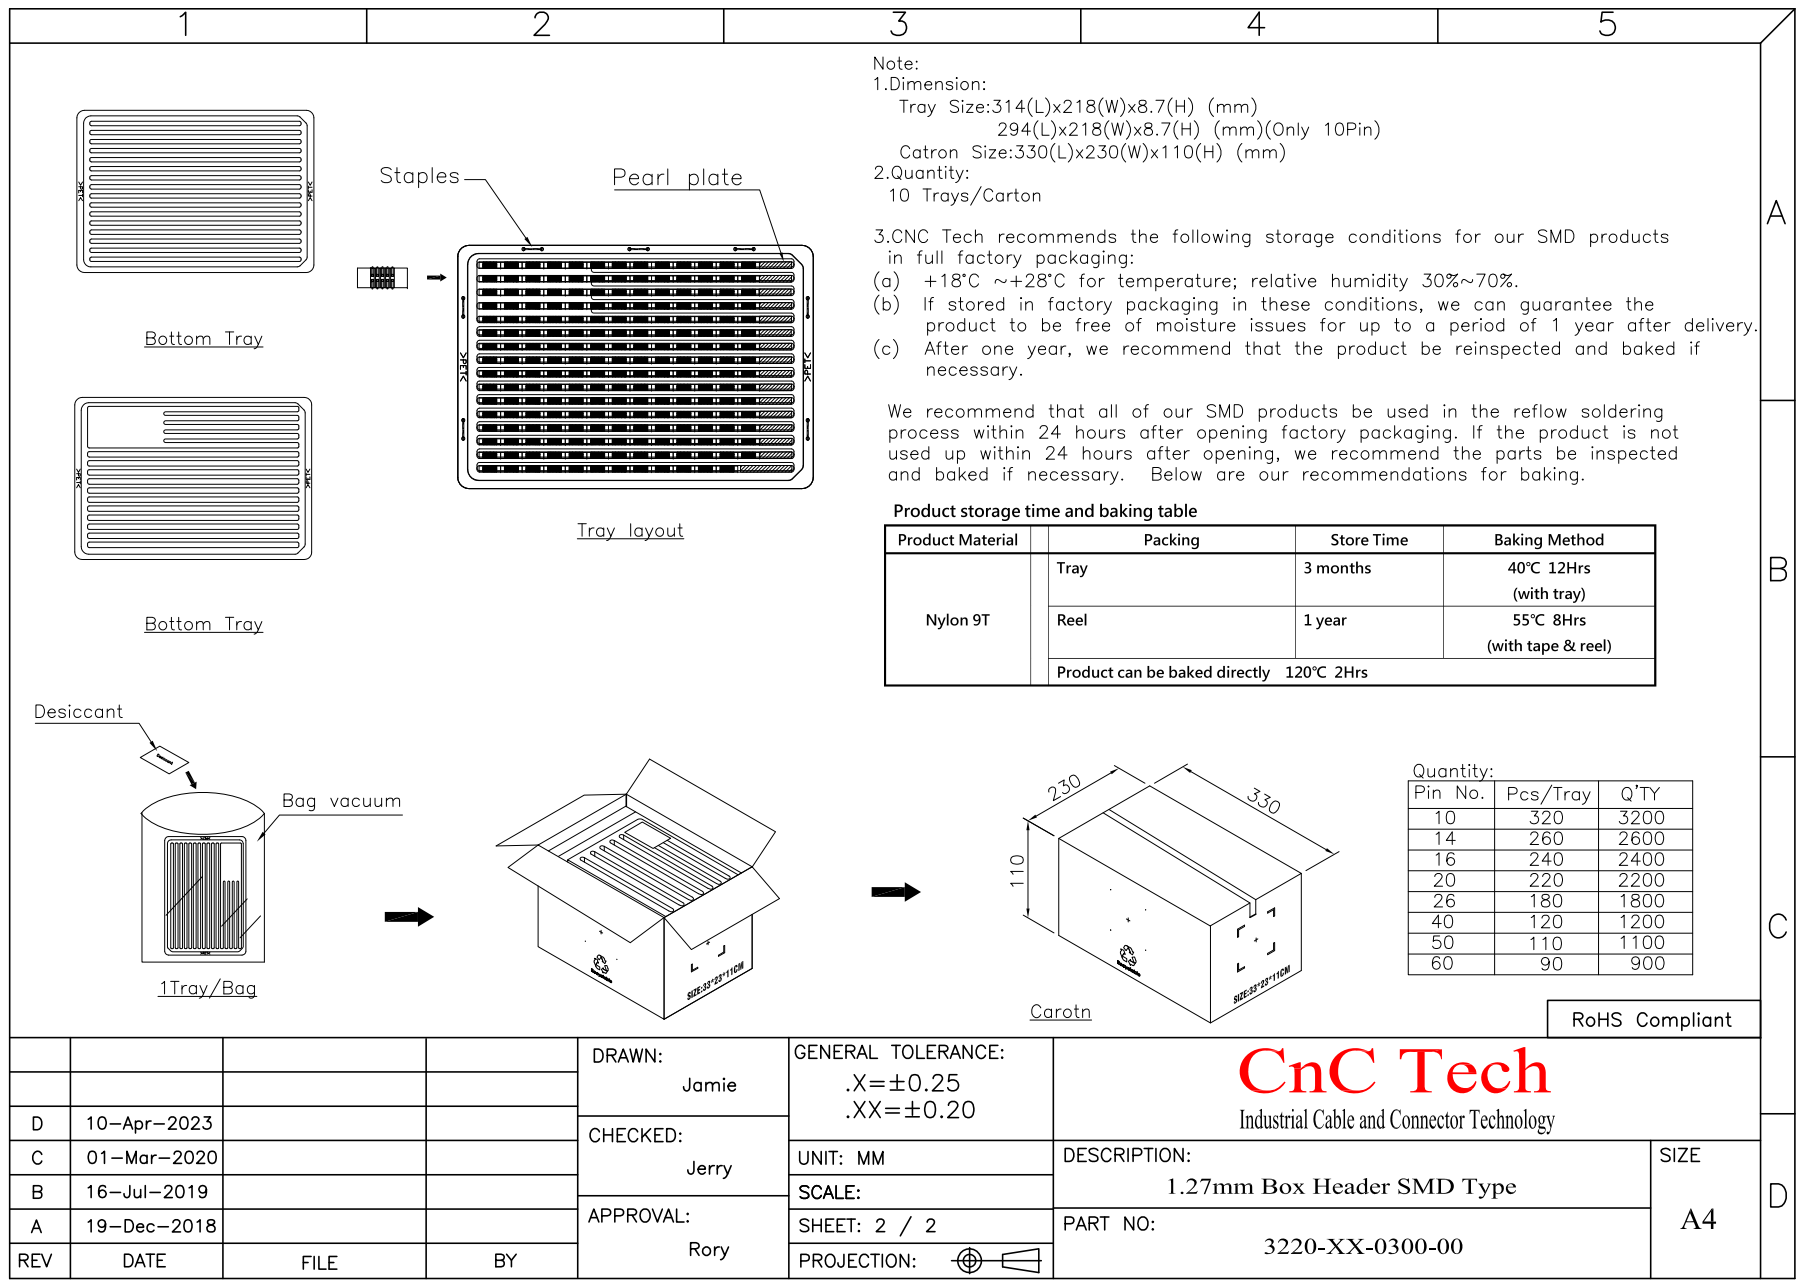
[picture p138: page 2]
