frc971/electrical/circuit-boards/IMU-2X-v3/Components/Molex 70541-series-drawing.pdf

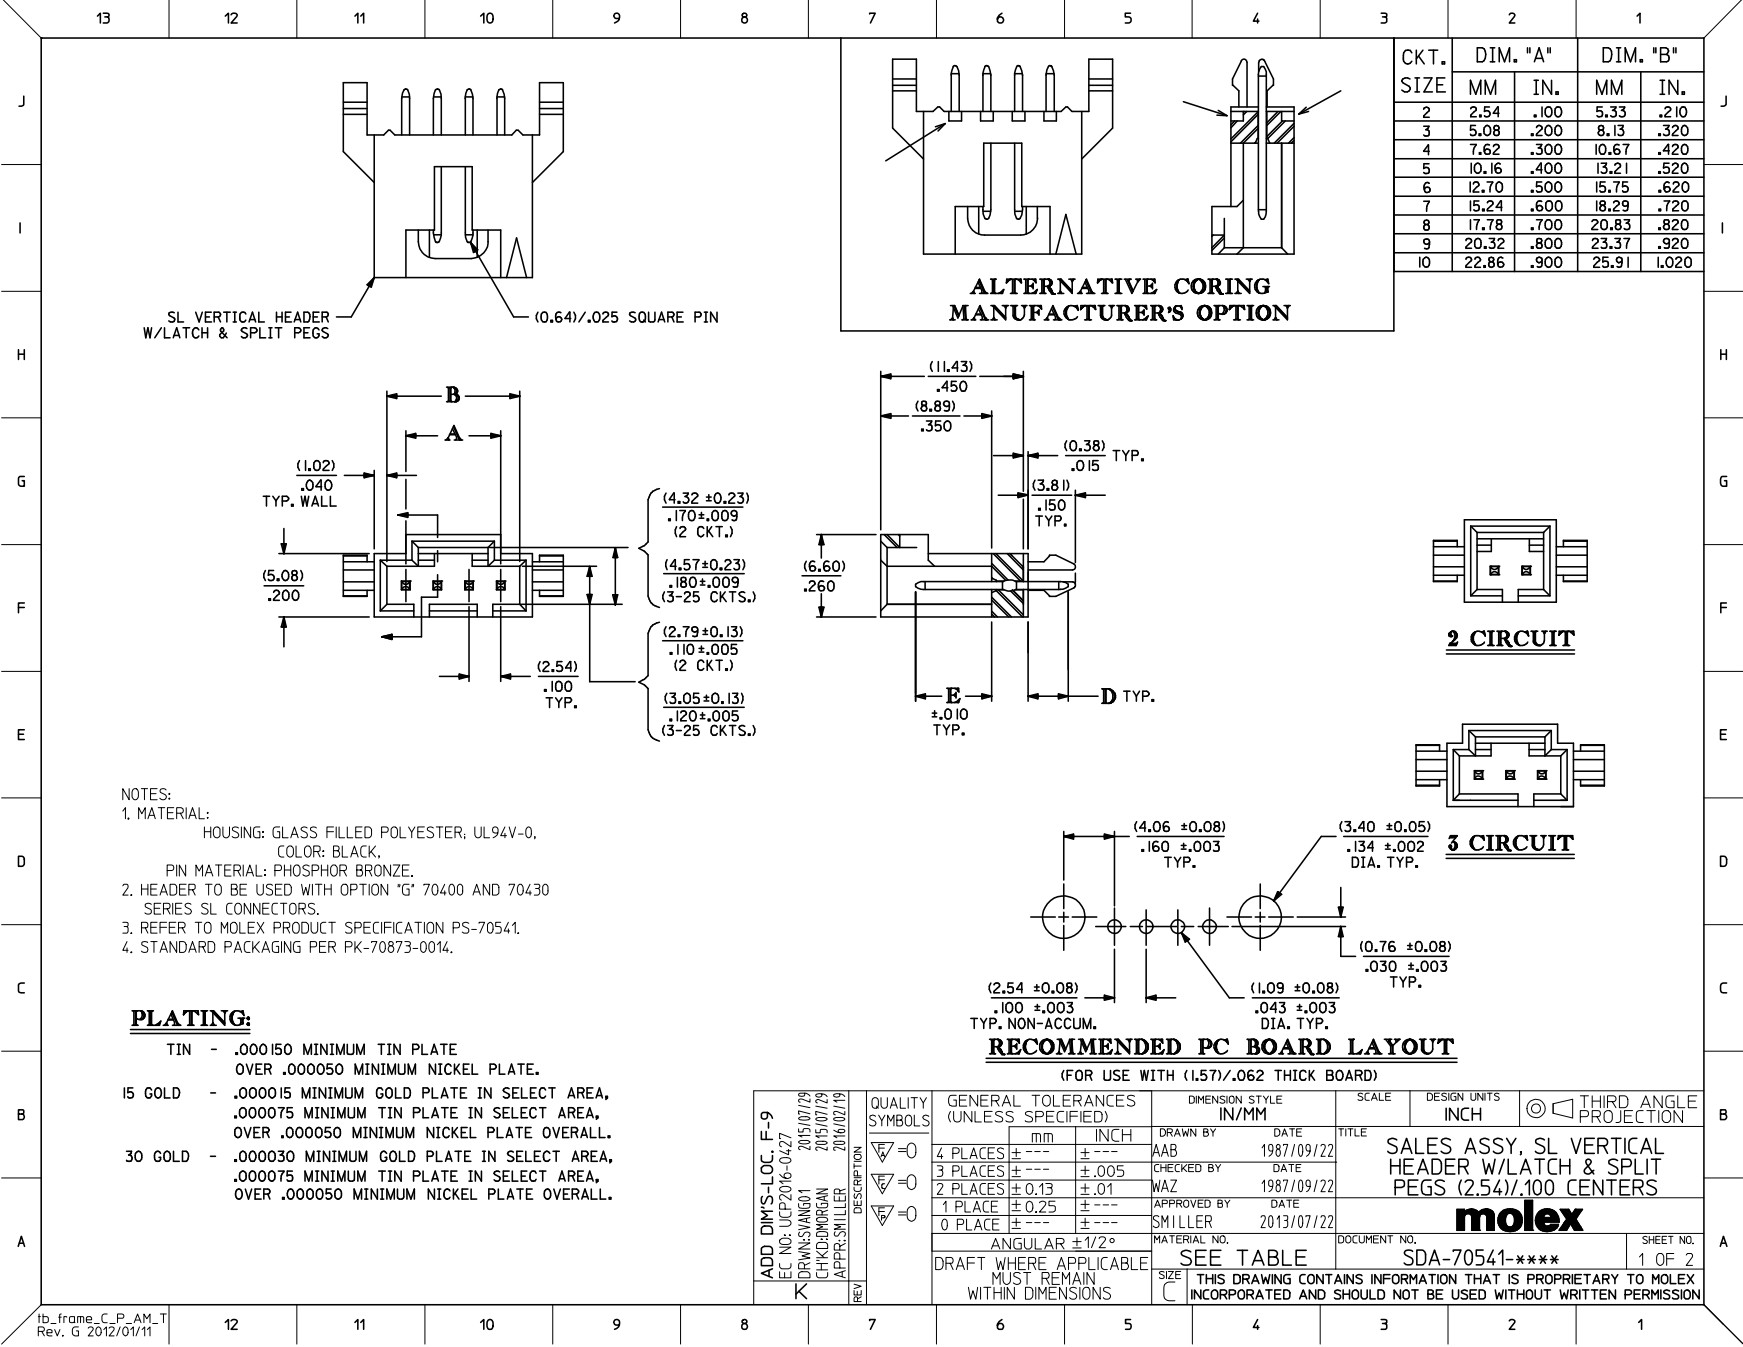
[picture p139: page 1]

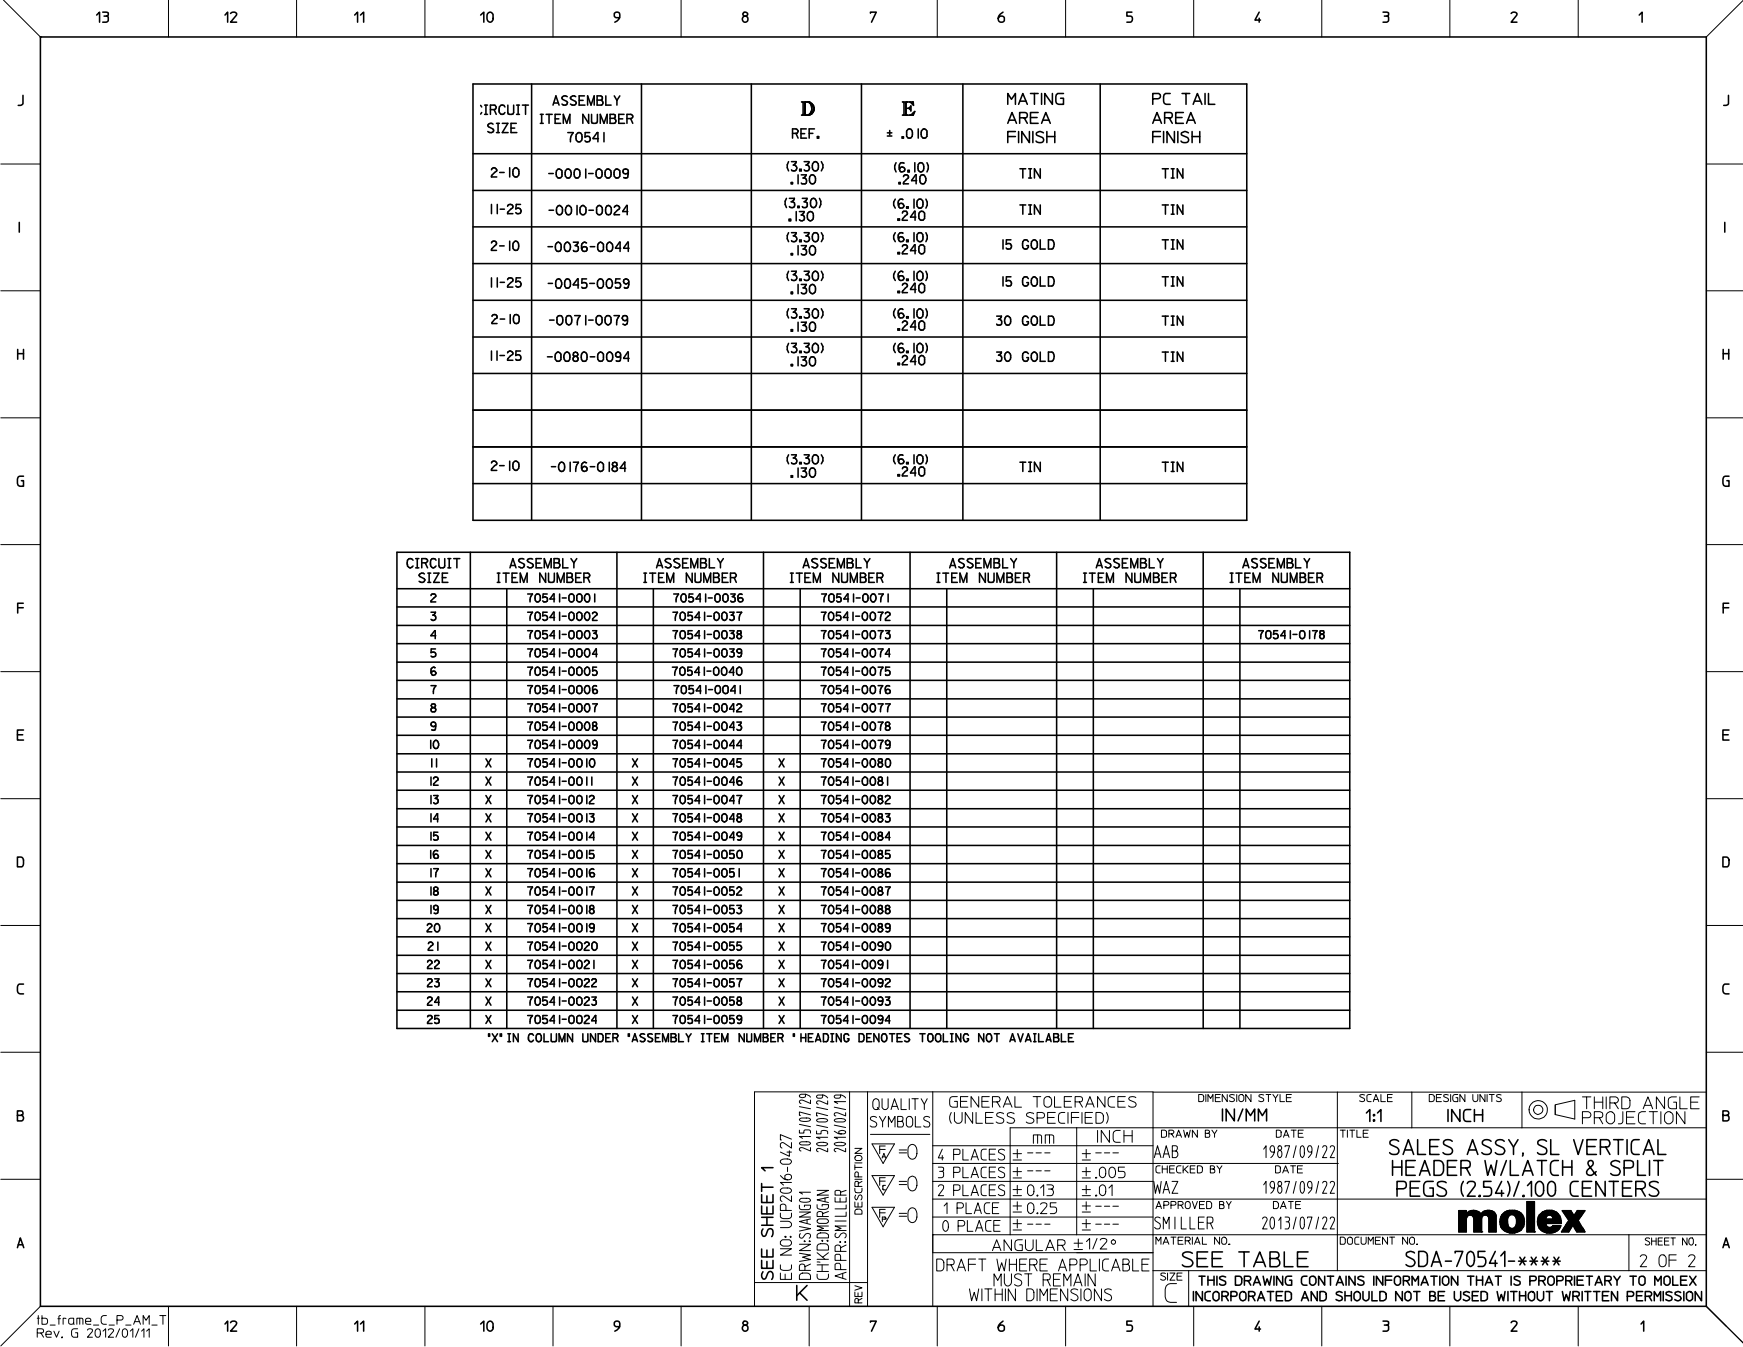
[picture p140: page 2]

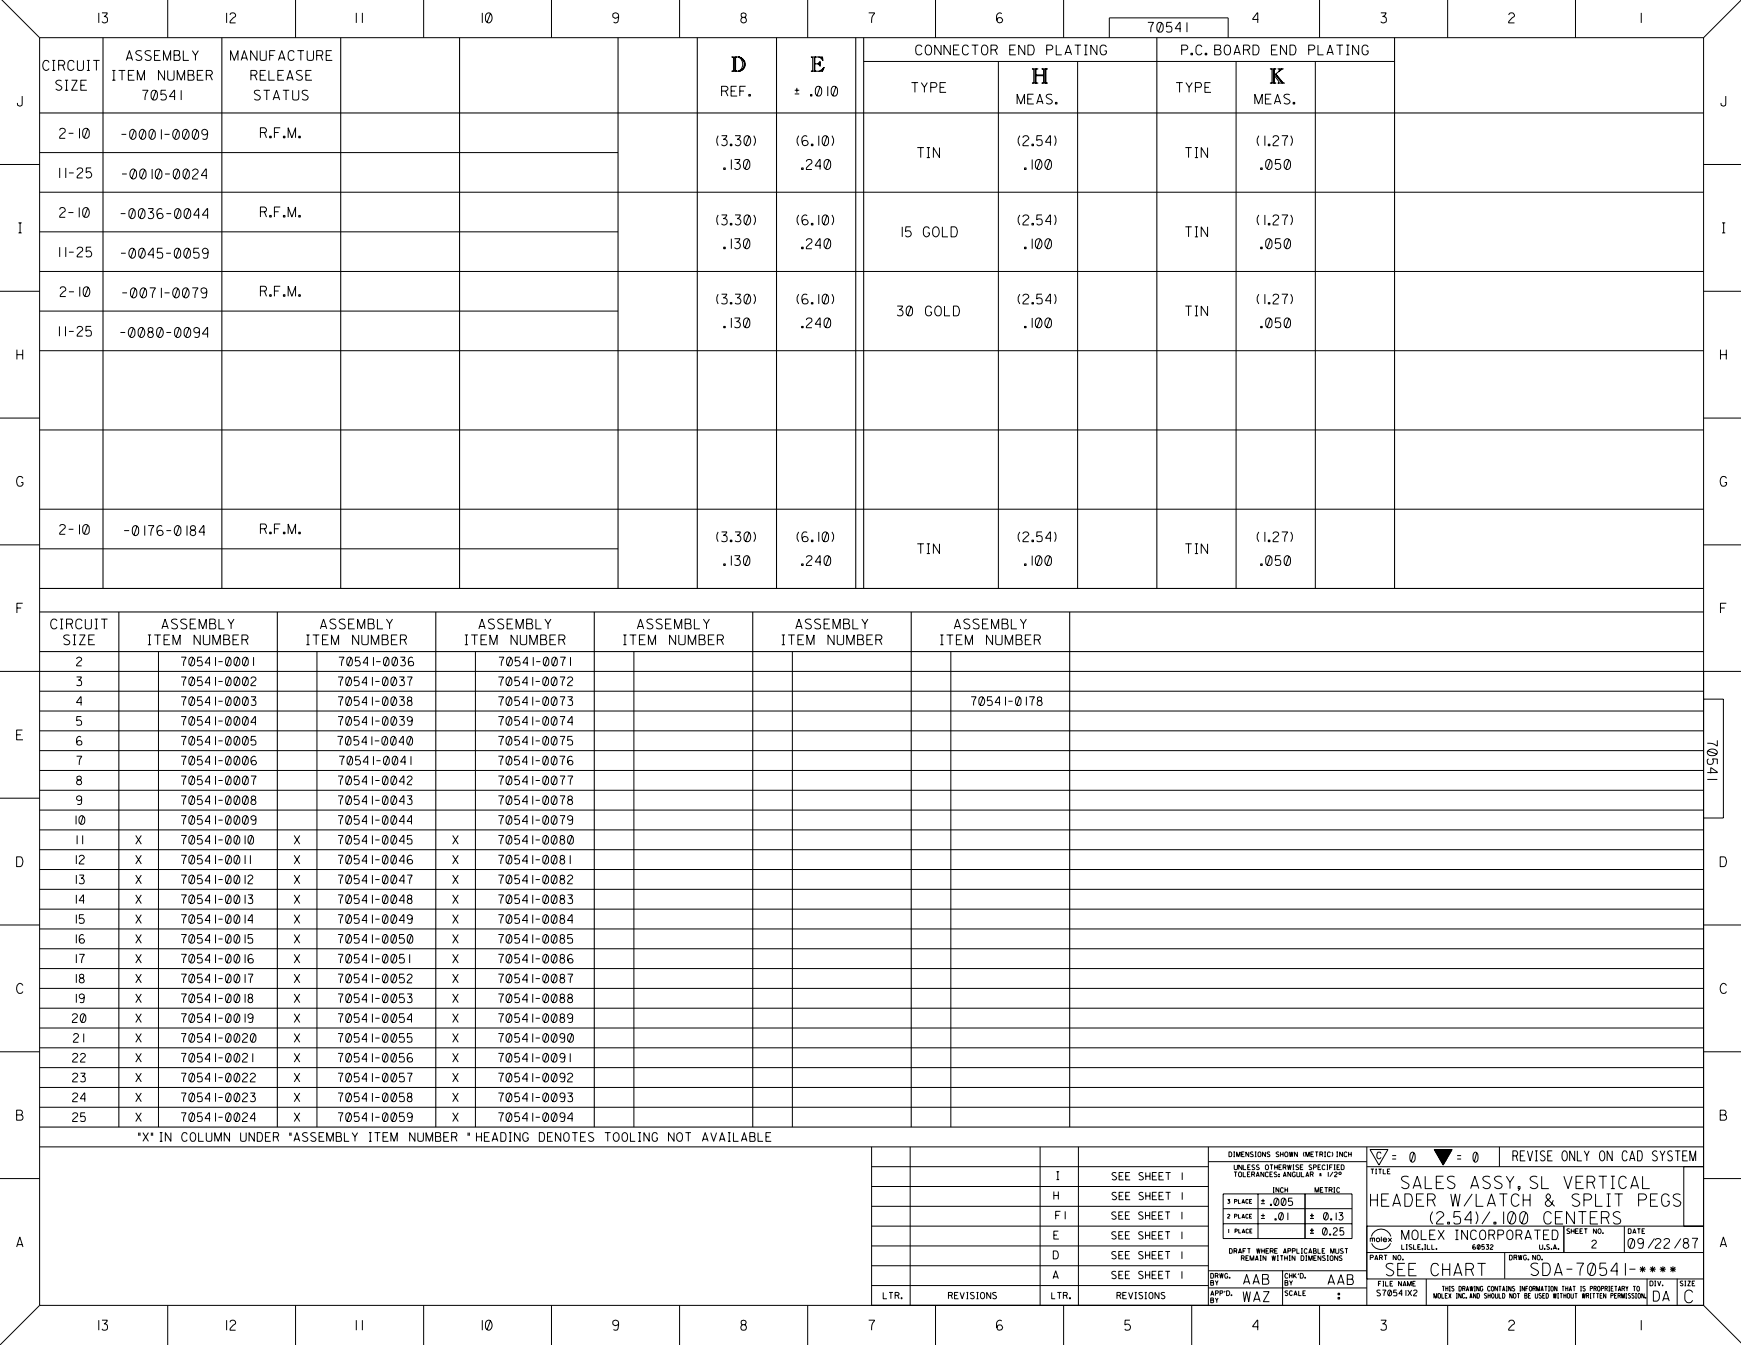
[picture p141: page 3]
