frc971/electrical/circuit-boards/IMU-2X-v3/Components/TE-5787834-2.pdf

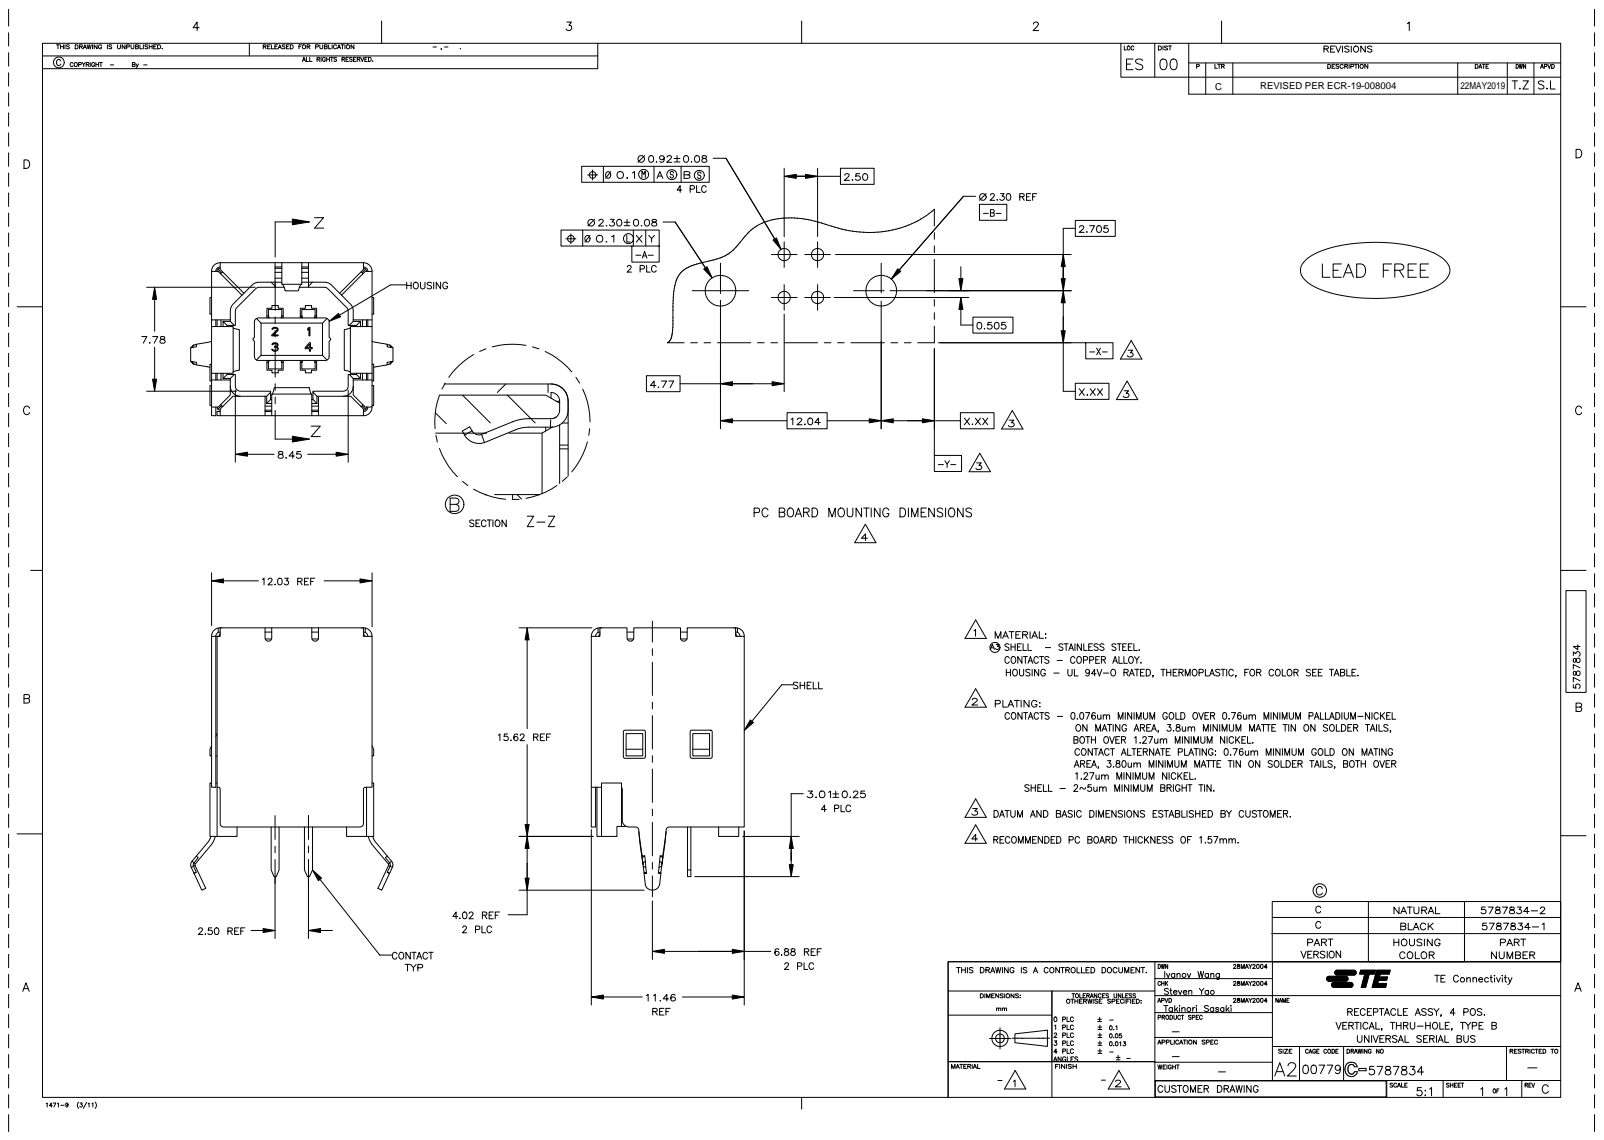
[picture p142: page 1]
REVISED PER ECR-19-008004; 22MAY2019
