frc971/electrical/circuit-boards/hall-switch-v2/Output-Files/Assembly-Files/HallSwitch-assy.pdf

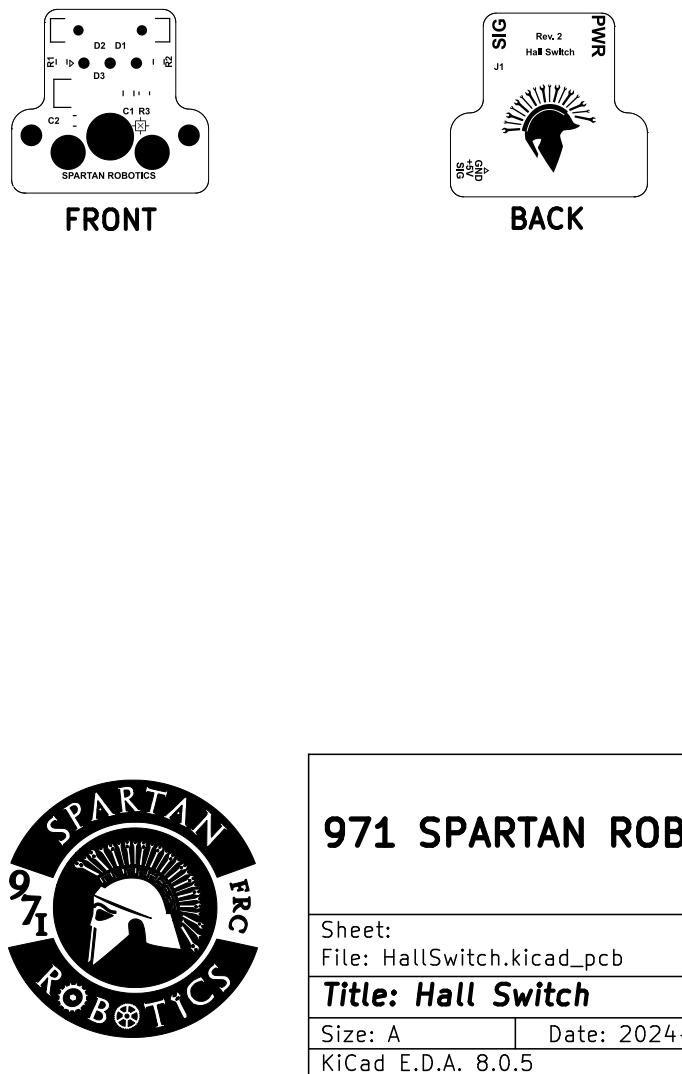
[picture p143: page 1]
