frc971/electrical/circuit-boards/hall-switch-v2/Output-Files/Design-Files/HallSwitch-sch.pdf

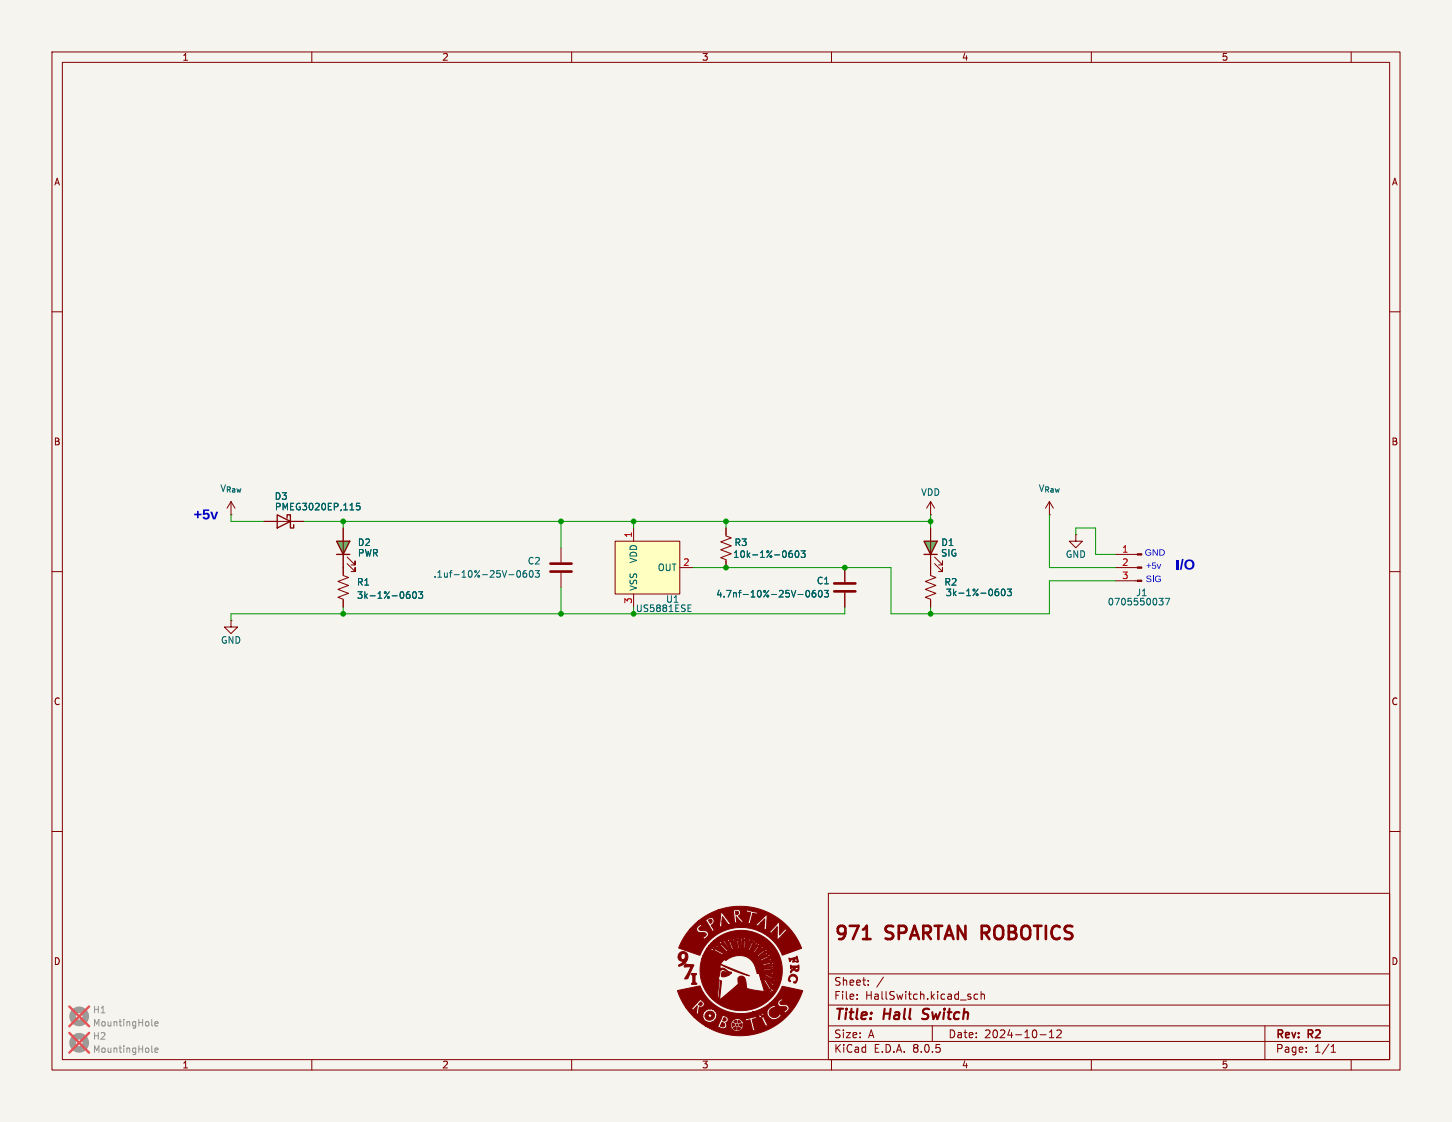
[picture p144: page 1]
