frc971/electrical/circuit-boards/IMU-2X-v3/Output-Files/Assembly-Files/IMU-2X-assy.pdf

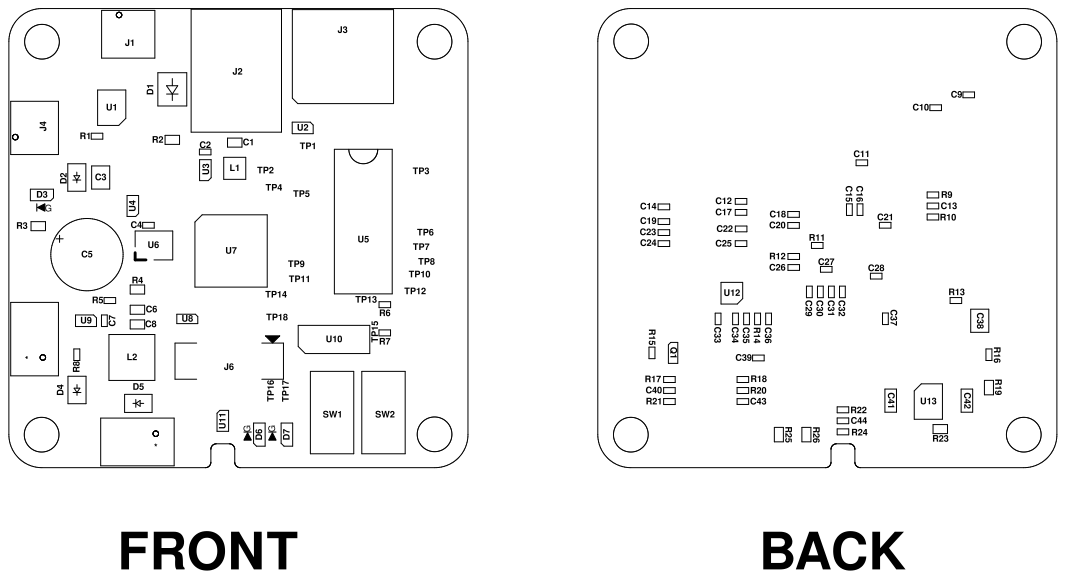
[picture p145: page 1]
