frc971/electrical/circuit-boards/Orin-NX-PCBs/NX-IndicatorBoard-V2/Components/Lumex-2x-LightPipe-LPF-C012303S.pdf

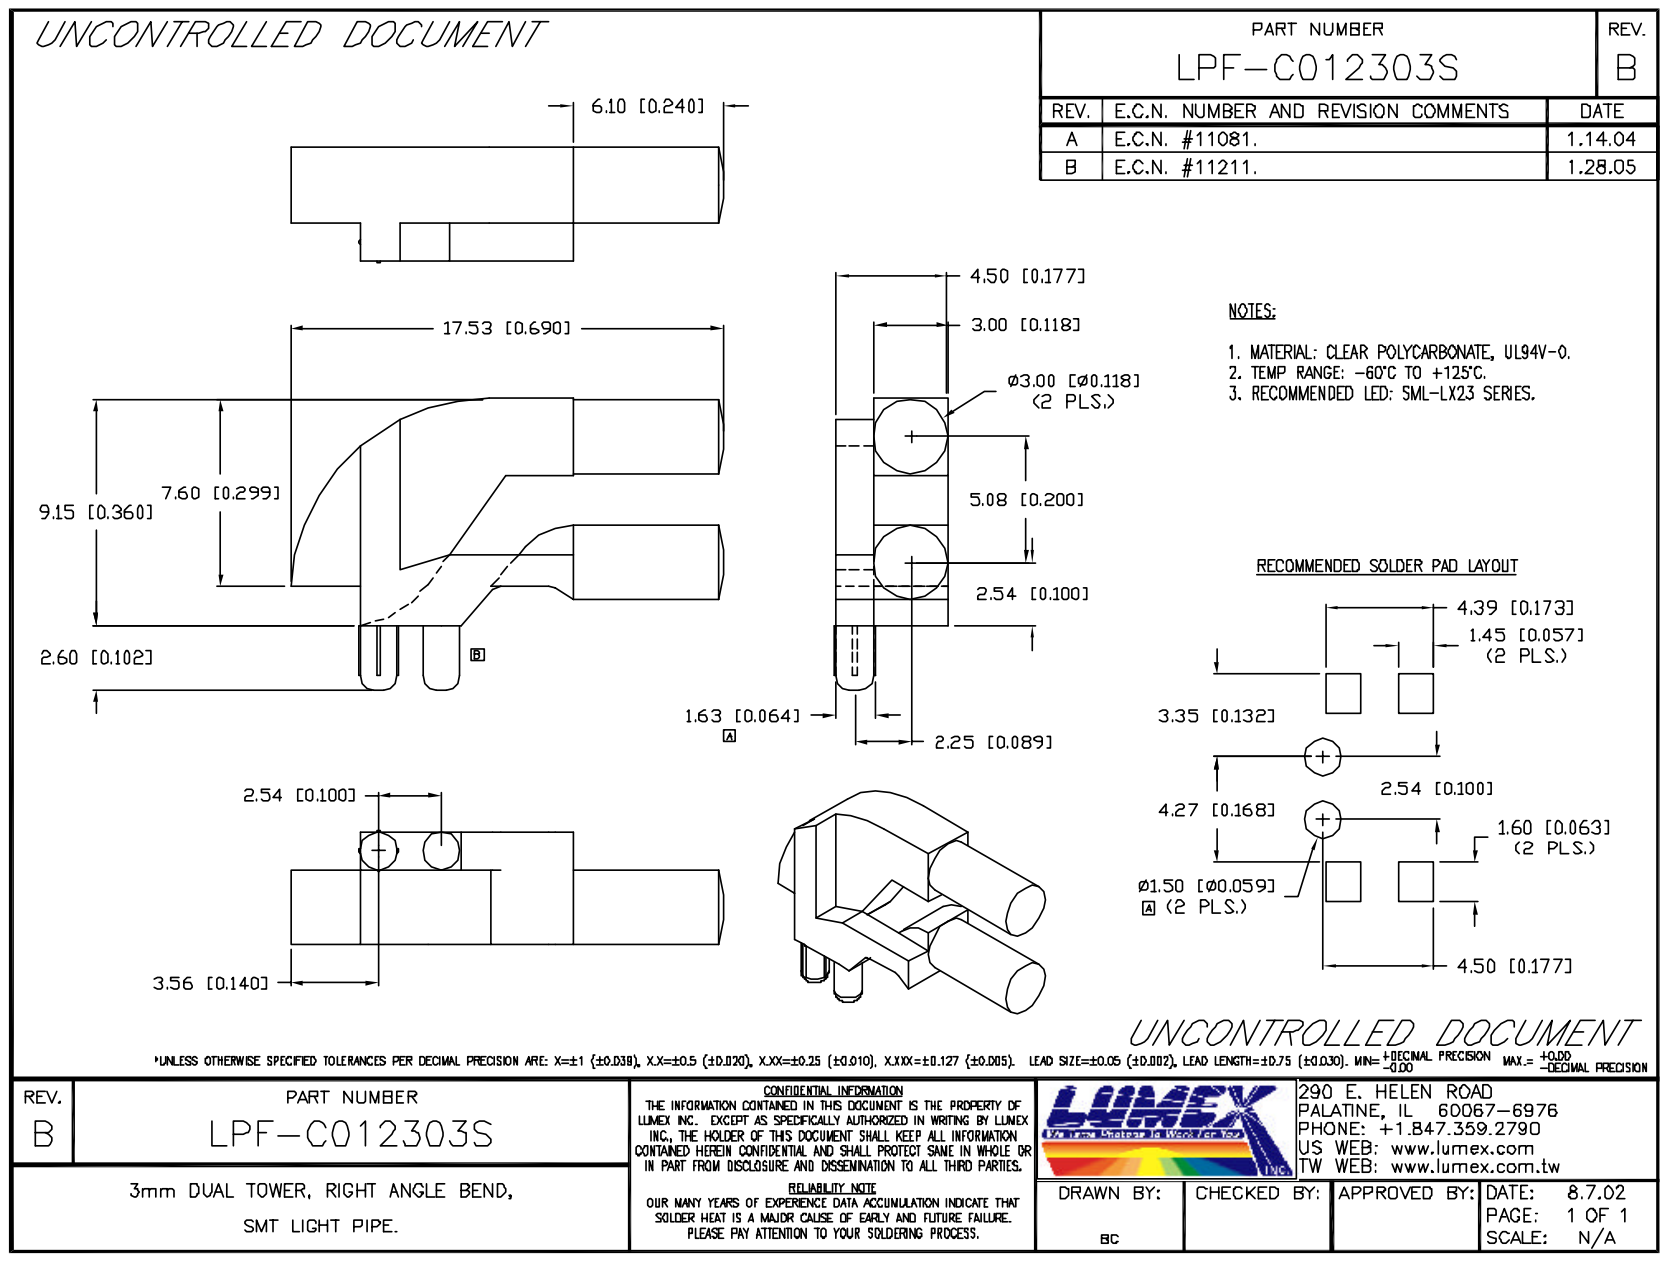
[picture p146: page 1]
