frc971/electrical/(list of files, drawings)

Other design files:
circuit-boards/RPI-Power-Boards/RspBuckBoost/RspPiPS.pcb
circuit-boards/RPI-Power-Boards/RspBuckBoostv2/RspPiPS.pcb
circuit-boards/RPI-Power-Boards/RspBuckBoostv3/RspPiPS.pcb
