frc971/electrical/circuit-boards/connector_boards/Kraken_Adapter_Boards_V3/Kraken_Adapter_Boards_V3.kicad_pcb

## KiCad design circuit-boards/connector_boards/Kraken_Adapter_Boards_V3/Kraken_Adapter_Boards_V3.kicad_pcb (2026-10-19)

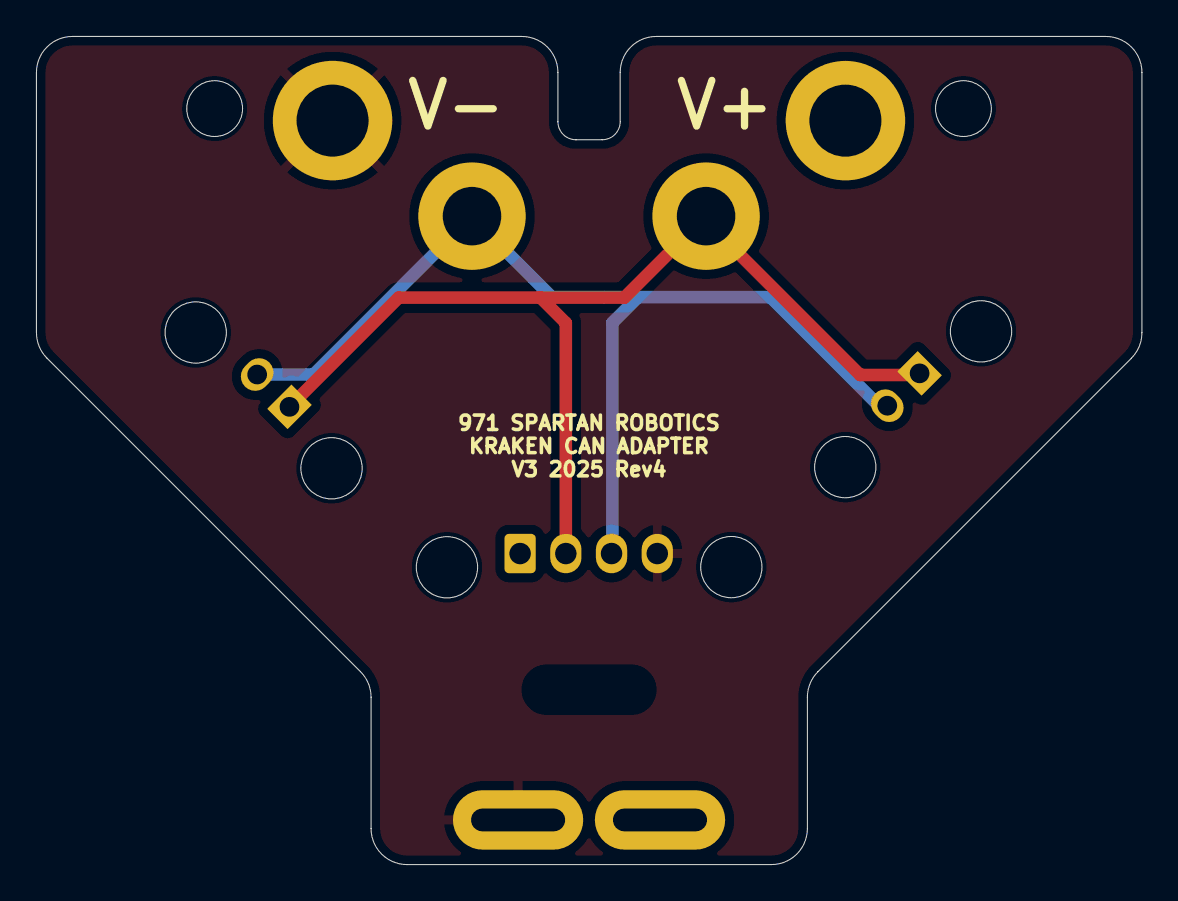
[picture p147: board Kraken_Adapter_Boards_V3.kicad_pcb from above]

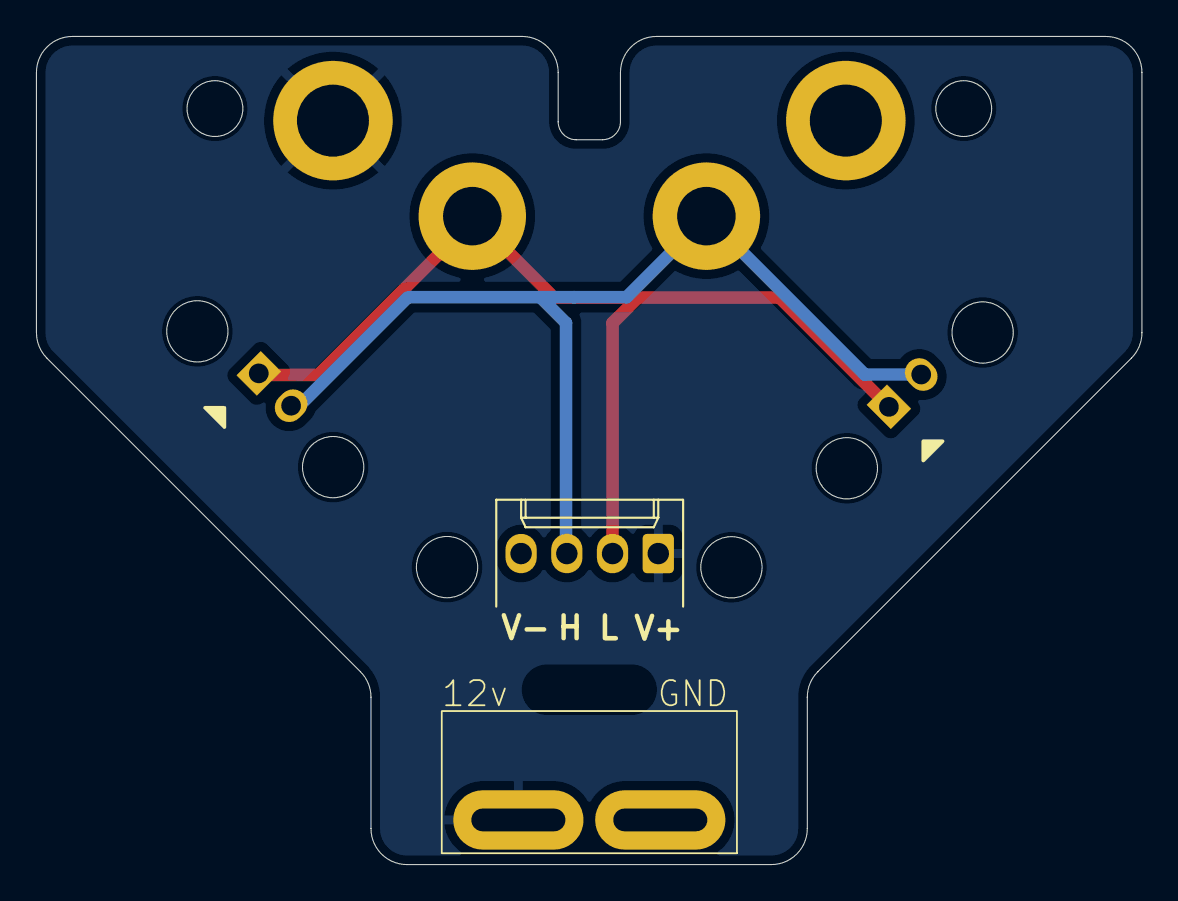
[picture p148: board Kraken_Adapter_Boards_V3.kicad_pcb from below]

Board: 2 copper layers, 61.4 x 46.0 mm, 10 parts (4 on the bottom side), 4 nets.

Parts:
J3: can_l_mount; can_x60
J4: can_h_mount; can_x60
J7: pwr_mount; pwr_krk
J8: gnd_mount; pwr_krk
M8: enclosure mount; pwr_krk
M8#2: mount; pwr_krk
anderson1: pwr_output; krk_pwr_board_housing
molex1: can_output; Molex_KK-254_AE-6410-02A_1x02_P2.54mm_Vertical_lock_mod
molex2: can_input; Molex_KK-254_AE-6410-02A_1x02_P2.54mm_Vertical_lock_mod
molex3: can_pwr_node_housing; Molex_KK-254_AE-6410-04A_1x04_P2.54mm_Vertical

Connections:
+12V: J7.1, anderson1.2, molex3.1
/can_h: J4.1, molex1.2, molex2.2, molex3.3
/can_l: J3.1, molex1.1, molex2.1, molex3.2
GND: J8.1, anderson1.1, molex3.4
