frc971/electrical/circuit-boards/shaft-encoders/mag-encoder4/mag-encoder.kicad_pcb

## KiCad design circuit-boards/shaft-encoders/mag-encoder4/mag-encoder.kicad_pcb (2024-12-07)

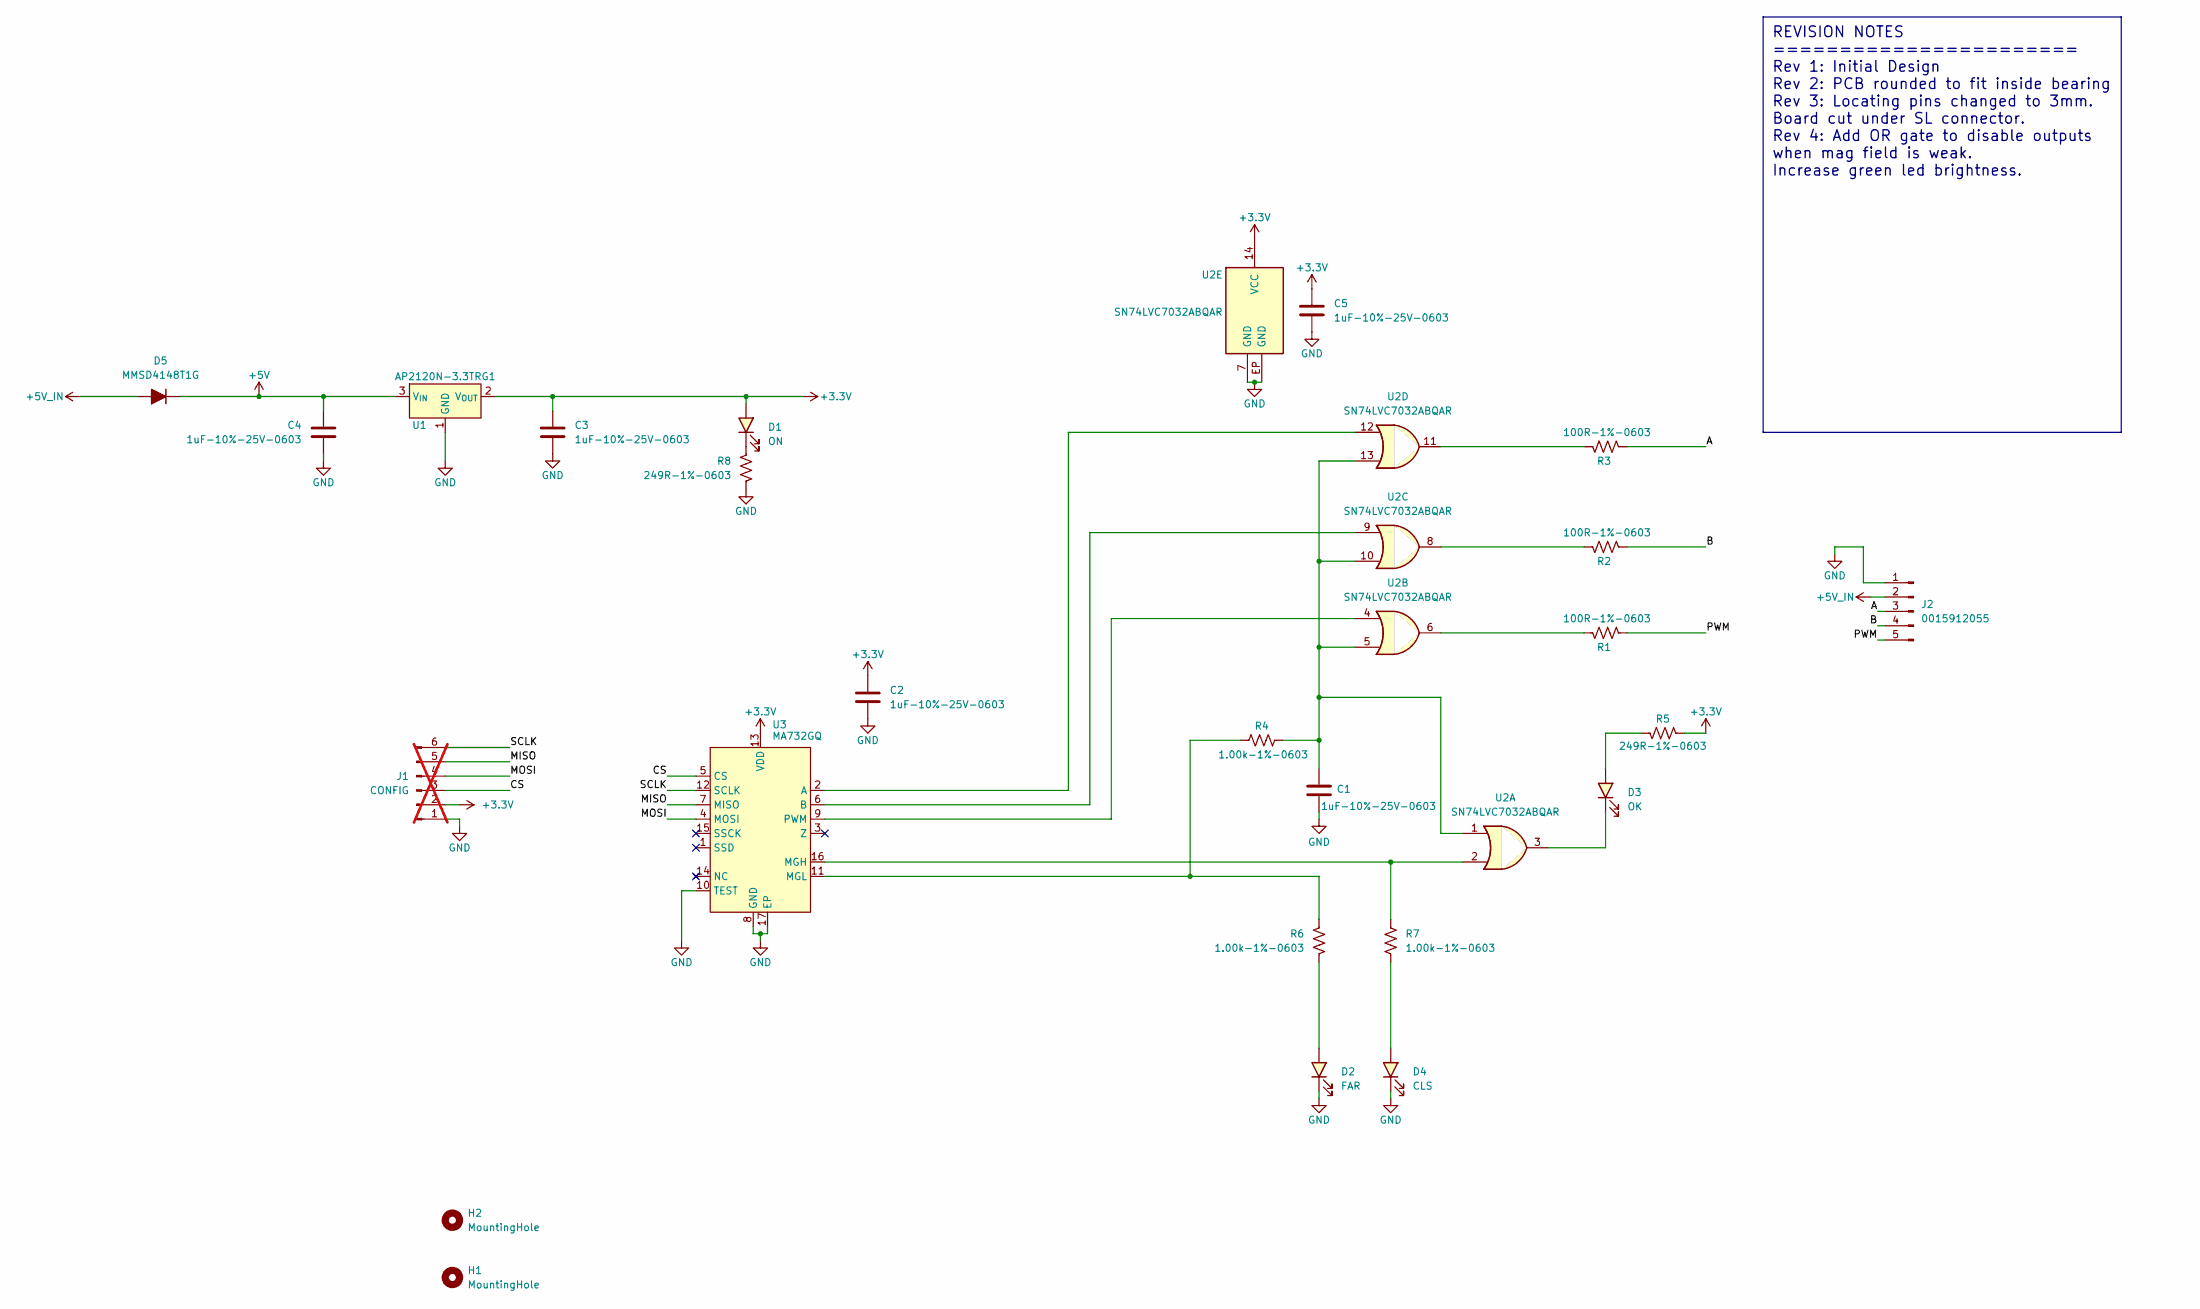
[picture p149: schematic mag-encoder.kicad_sch, Mag Encoder]

Parts:
C1, C2, C3, C4, C5: 1uF-10%-25V-0603; C_0603_1608Metric; MFG P/N 06033C105KAT2A
D1: ON; LED_0603_1608Metric; MFG P/N 150060VS75000
D2: FAR; LED_0603_1608Metric; MFG P/N 150060RS75000
D3: OK; LED_0603_1608Metric; MFG P/N 150060VS75000
D4: CLS; LED_0603_1608Metric; MFG P/N 150060YS75000
D5: MMSD4148T1G; D_SOD-123; MFG P/N MMSD4148T1G
H1, H2: MountingHole; pin-0.100
J1: CONFIG; PinHeader_1x06_P2.54mm_Vertical; not fitted
J2: 0015912055; Molex-70634-0039; MFG P/N 0015912055
R1, R2, R3: 100R-1%-0603; R_0603_1608Metric; MFG P/N RC0603FR-07100RL
R4, R6, R7: 1.00k-1%-0603; R_0603_1608Metric; MFG P/N RC0603FR-071KL
R5, R8: 249R-1%-0603; R_0603_1608Metric; MFG P/N RC0603FR-07249RL
U1: AP2120N-3.3TRG1; SOT-23; MFG P/N AP2120N-3.3TRG1
U2: SN74LVC7032ABQAR; TI-WQFN-14-1EP_2.5x3mm_EP_1x1.5mm; MFG P/N SN74LVC7032ABQAR
U3: MA732GQ; QFN-16-1EP_3x3mm_P0.5mm_EP1.7x1.7mm; MFG P/N MA732GQ-Z

Connections:
+3.3V: C2.1, C3.1, C5.1, D1.2 (A), J1.2, R5.1, U1.2 (V_{OUT}), U2.14 (VCC), U3.13 (VDD)
+5V: C4.1, D5.1 (K), U1.3 (V_{IN})
+5V_IN: D5.2 (A), J2.2
/A: J2.3, R3.2
/B: J2.4, R2.2
/CS: J1.3, U3.5 (CS)
/MISO: J1.5, U3.7 (MISO)
/MOSI: J1.4, U3.4 (MOSI)
/PWM: J2.5, R1.2
/SCLK: J1.6, U3.12 (SCLK)
GND: C1.2, C2.2, C3.2, C4.2, C5.2, D2.1 (K), D4.1 (K), J1.1, J2.1, R8.2, U1.1 (GND), U2.7 (GND), U2.EP (GND), U3.8 (GND), U3.10 (TEST), U3.17 (EP)
unnamed: C1.1, R4.2, U2.1, U2.5, U2.10, U2.13
unnamed: D1.1 (K), R8.1
unnamed: D2.2 (A), R6.2
unnamed: D3.2 (A), R5.2
unnamed: D3.1 (K), U2.3
unnamed: D4.2 (A), R7.2
unnamed: R1.1, U2.6
unnamed: R2.1, U2.8
unnamed: R3.1, U2.11
unnamed: U2.12, U3.2 (A)
unnamed: U2.9, U3.6 (B)
unnamed: R7.1, U2.2, U3.16 (MGH)
unnamed: R4.1, R6.1, U3.11 (MGL)
unnamed: U2.4, U3.9 (PWM)

Notes on the sheet:
REVISION NOTES ======================= Rev 1: Initial Design Rev 2: PCB rounded to fit inside bearing Rev 3: Locating pins changed to 3mm. Board cut under SL connector. Rev 4: Add OR gate to disable outputs when mag field is weak. Increase green led brightness.

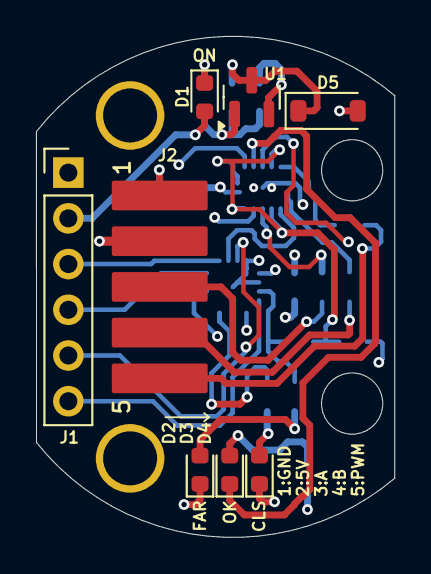
[picture p150: board circuit-boards/shaft-encoders/mag-encoder4/mag-encoder.kicad_pcb from above]

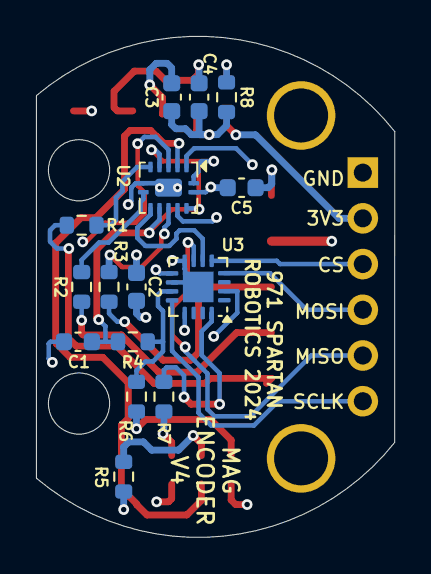
[picture p151: board circuit-boards/shaft-encoders/mag-encoder4/mag-encoder.kicad_pcb from below]

Board: 4 copper layers, 19.9 x 27.8 mm, 25 parts (15 on the bottom side), 25 nets.
