frc971/electrical/circuit-boards/Orin-NX-PCBs/NX-ButtonInterface-v3/NX-ButtonInterface.kicad_pcb

## KiCad design circuit-boards/Orin-NX-PCBs/NX-ButtonInterface-v3/NX-ButtonInterface.kicad_pcb (2024-11-11)

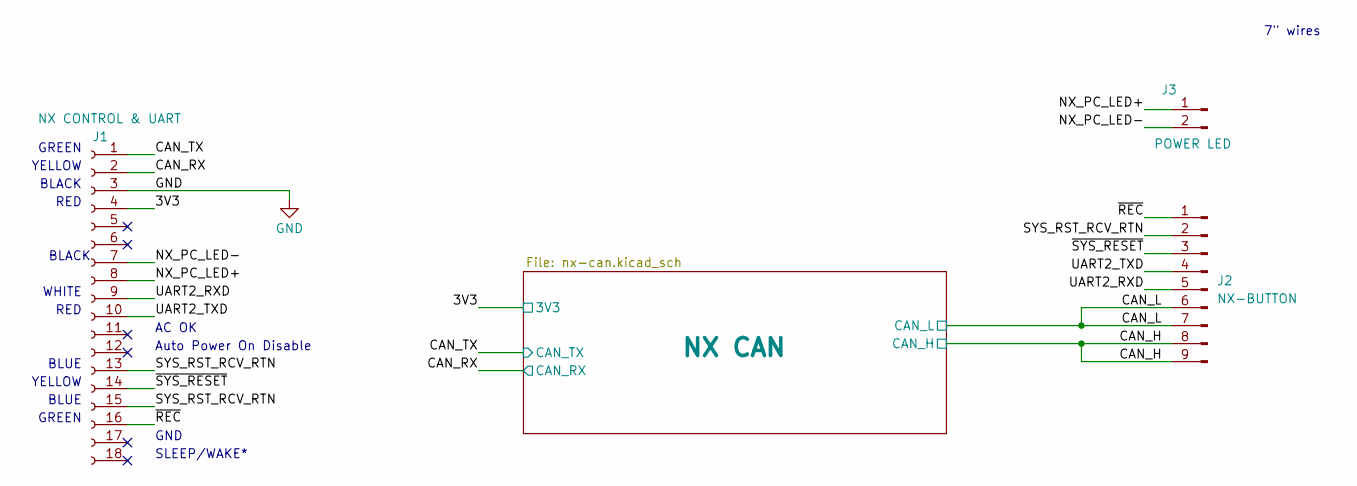
[picture p152: schematic NX-ButtonInterface.kicad_sch, NX Button Interface V3]

Parts:
J1: NX CONTROL & UART; PinSocket_1x18_P2.54mm_Vertical; MFG P/N PPTC181LFBN-RC
J2: NX-BUTTON; 9-pin-solder-pads
J3: POWER LED; 2-pin-solder-pads

Connections:
/3V3: J1.4; also elsewhere on the board
/CAN_H: J2.8, J2.9; also elsewhere on the board
/CAN_L: J2.6, J2.7; also elsewhere on the board
/CAN_RX: J1.2; also elsewhere on the board
/CAN_TX: J1.1; also elsewhere on the board
/NX_PC_LED+: J1.8, J3.1
/NX_PC_LED-: J1.7, J3.2
/SYS_RST_RCV_RTN: J1.13, J1.15, J2.2
/UART2_RXD: J1.9, J2.5
/UART2_TXD: J1.10, J2.4
/~REC: J1.16, J2.1
/~SYS_RESET: J1.14, J2.3
GND: J1.3; also elsewhere on the board

Notes on the sheet:
RED
YELLOW
GREEN
BLACK
WHITE
BLUE
7" wires
AC OK
GND
Auto Power On Disable
SLEEP/WAKE*

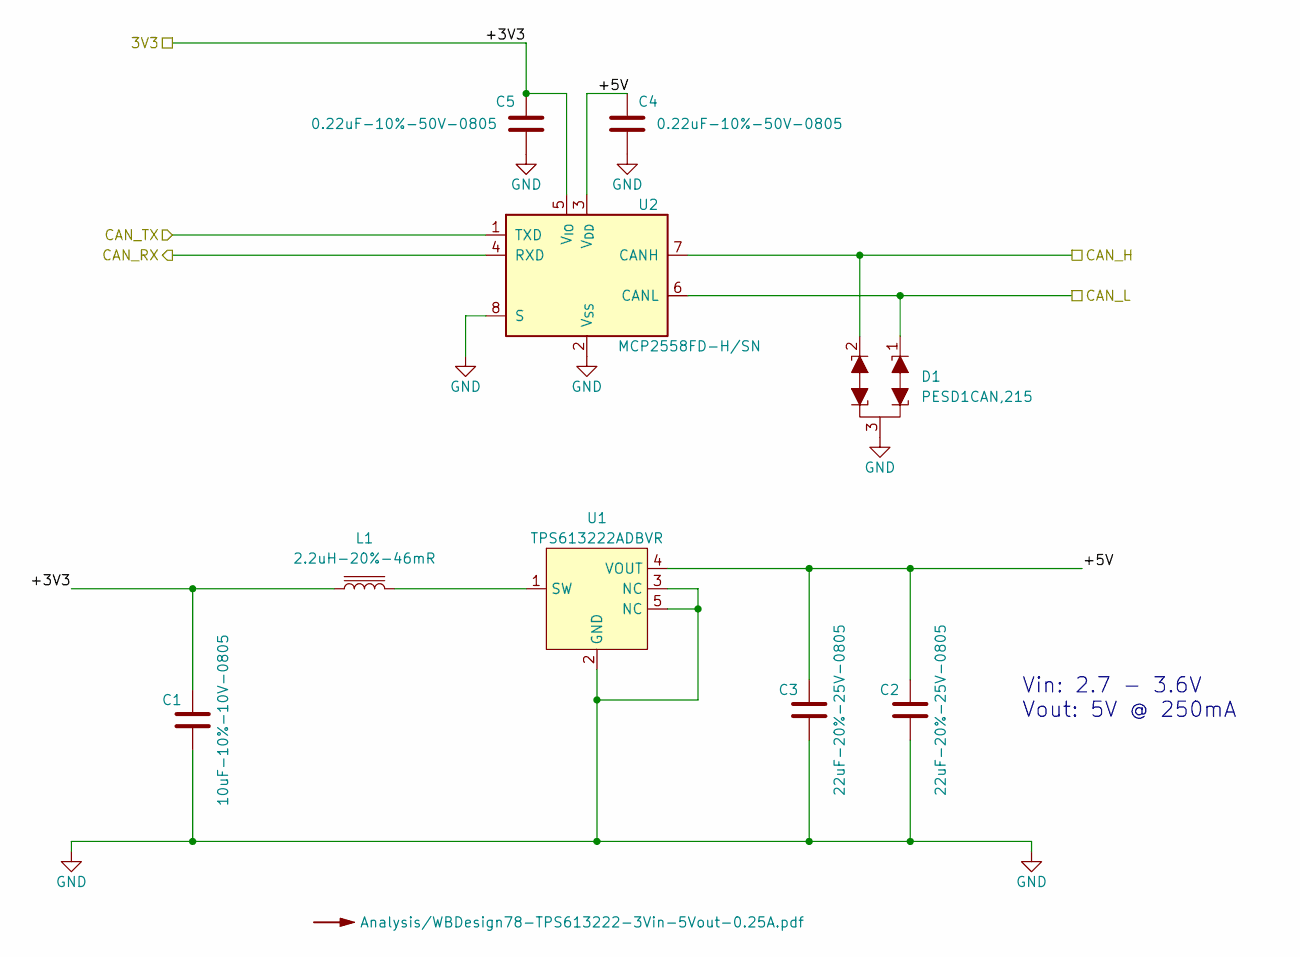
[picture p153: schematic nx-can.kicad_sch, NX Button Interface V3]

Parts:
C1: 10uF-10%-10V-0805; C_0805_2012Metric; MFG P/N C0805C106K8PAC7800
C2, C3: 22uF-20%-25V-0805; C_0805_2012Metric; MFG P/N CL21A226MAYNNNE
C4, C5: 0.22uF-10%-50V-0805; C_0805_2012Metric; MFG P/N C0805C224K5RAC7800
D1: PESD1CAN; SOT-23; MFG P/N PESD1CAN,215
L1: 2.2uH-20%-46mR; L_Vishay_IHLP-1212; MFG P/N IHLP1212BZER2R2M11
U1: TPS613222ADBVR; SOT-23-5; MFG P/N TPS613222ADBVR
U2: MCP2558FD-H/SN; SOIC-8_3.9x4.9mm_P1.27mm; MFG P/N MCP2558FD-H/SN

Connections:
/3V3: C1.1, C5.1, L1.1, U2.5 (V_{IO}); also elsewhere on the board
/CAN_H: D1.2 (K1), U2.7 (CANH); also elsewhere on the board
/CAN_L: D1.1 (K1), U2.6 (CANL); also elsewhere on the board
/CAN_RX: U2.4 (RXD); also elsewhere on the board
/CAN_TX: U2.1 (TXD); also elsewhere on the board
/NX CAN/+5V: C2.1, C3.1, C4.1, U1.4 (VOUT), U2.3 (V_{DD})
GND: C1.2, C2.2, C3.2, C4.2, C5.2, D1.3 (KK), U1.2 (GND), U1.3 (NC), U1.5 (NC), U2.2 (V_{SS}), U2.8 (S); also elsewhere on the board
unnamed: L1.2, U1.1 (SW)

Notes on the sheet:
Vin: 2.7 - 3.6V Vout: 5V @ 250mA

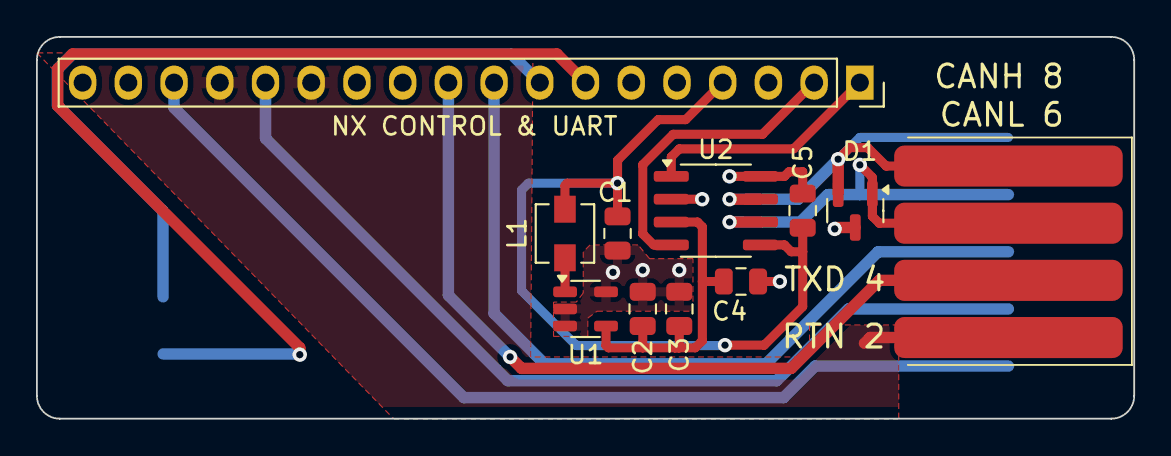
[picture p154: board circuit-boards/Orin-NX-PCBs/NX-ButtonInterface-v3/NX-ButtonInterface.… from above]

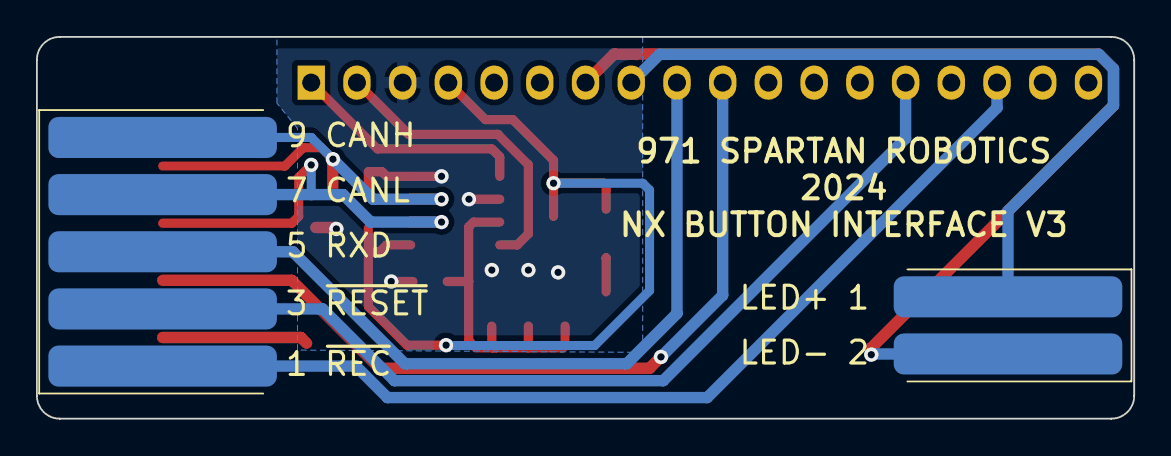
[picture p155: board circuit-boards/Orin-NX-PCBs/NX-ButtonInterface-v3/NX-ButtonInterface.… from below]

Board: 2 copper layers, 61.0 x 21.2 mm, 12 parts (2 on the bottom side), 15 nets.
