frc971/electrical/circuit-boards/shaft-encoders/mag-encoder3/mag-encoder.kicad_pcb

## KiCad design circuit-boards/shaft-encoders/mag-encoder3/mag-encoder.kicad_pcb (2024-10-25, an earlier design)

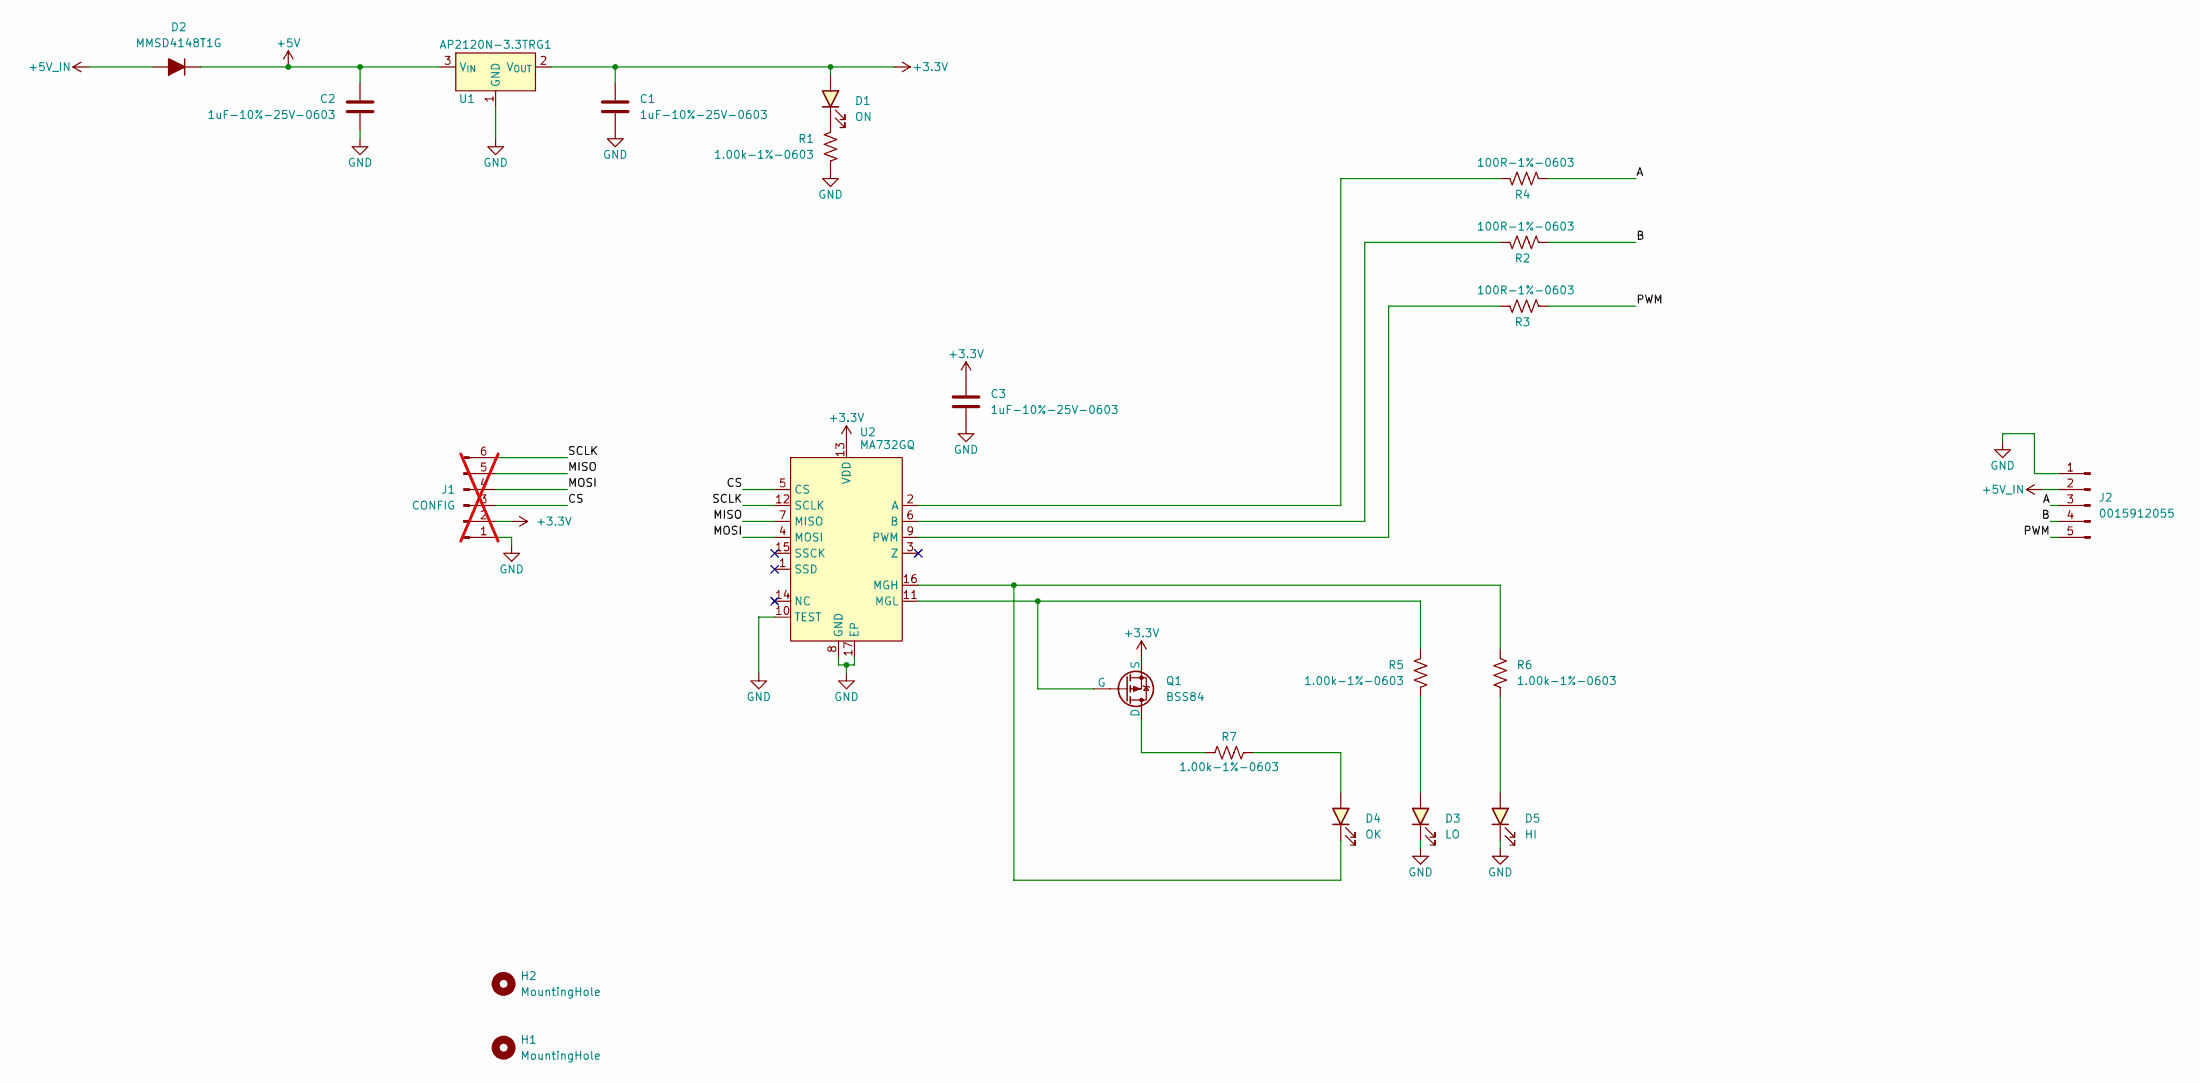
[picture p156: schematic mag-encoder.kicad_sch, Mag Encoder]

Parts:
C1, C2, C3: 1uF-10%-25V-0603; C_0603_1608Metric; MFG P/N 06033C105KAT2A
D1: ON; LED_0603_1608Metric; MFG P/N 150060YS75000
D2: MMSD4148T1G; D_SOD-123; MFG P/N MMSD4148T1G
D3: LO; LED_0603_1608Metric; MFG P/N 150060RS75000
D4: OK; LED_0603_1608Metric; MFG P/N 150060VS75000
D5: HI; LED_0603_1608Metric; MFG P/N 150060RS75000
H1, H2: MountingHole; pin-0.100
J1: CONFIG; PinHeader_1x06_P2.54mm_Vertical; not fitted
J2: 0015912055; Molex-70634-0039; MFG P/N 0015912055
Q1: BSS84; SOT-23; MFG P/N BSS84
R1, R5, R6, R7: 1.00k-1%-0603; R_0603_1608Metric; MFG P/N RC0603FR-071KL
R2, R3, R4: 100R-1%-0603; R_0603_1608Metric; MFG P/N RC0603FR-07100RL
U1: AP2120N-3.3TRG1; SOT-23; MFG P/N AP2120N-3.3TRG1
U2: MA732GQ; QFN-16-1EP_3x3mm_P0.5mm_EP1.7x1.7mm; MFG P/N MA732GQ-Z

Connections:
+3.3V: C1.1, C3.1, D1.2 (A), J1.2, Q1.2 (S), U1.2 (V_{OUT}), U2.13 (VDD)
+5V: C2.1, D2.1 (K), U1.3 (V_{IN})
+5V_IN: D2.2 (A), J2.2
/A: J2.3, R4.2
/B: J2.4, R2.2
/CS: J1.3, U2.5 (CS)
/MISO: J1.5, U2.7 (MISO)
/MOSI: J1.4, U2.4 (MOSI)
/PWM: J2.5, R3.2
/SCLK: J1.6, U2.12 (SCLK)
GND: C1.2, C2.2, C3.2, D3.1 (K), D5.1 (K), J1.1, J2.1, R1.2, U1.1 (GND), U2.8 (GND), U2.10 (TEST), U2.17 (EP)
unnamed: D1.1 (K), R1.1
unnamed: D3.2 (A), R5.2
unnamed: D4.2 (A), R7.2
unnamed: D4.1 (K), R6.1, U2.16 (MGH)
unnamed: D5.2 (A), R6.2
unnamed: Q1.3 (D), R7.1
unnamed: Q1.1 (G), R5.1, U2.11 (MGL)
unnamed: R4.1, U2.2 (A)
unnamed: R2.1, U2.6 (B)
unnamed: R3.1, U2.9 (PWM)

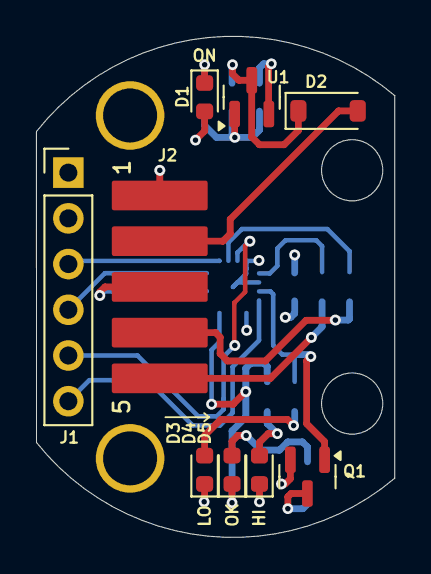
[picture p157: board circuit-boards/shaft-encoders/mag-encoder3/mag-encoder.kicad_pcb from above]

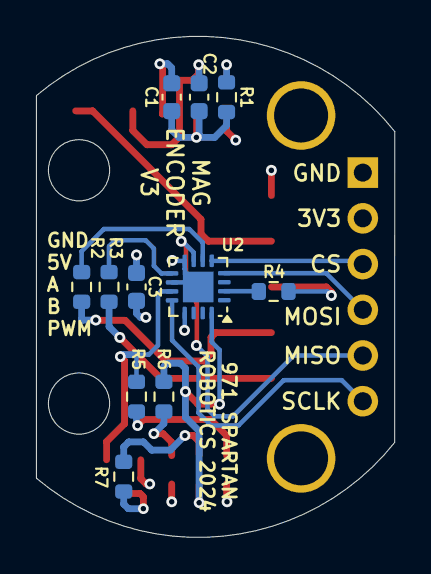
[picture p158: board circuit-boards/shaft-encoders/mag-encoder3/mag-encoder.kicad_pcb from below]

Board: 4 copper layers, 19.9 x 27.8 mm, 22 parts (11 on the bottom side), 21 nets.
