frc971/electrical/circuit-boards/connector_boards/PowerDistribution-V2/PowerDistribution.kicad_pcb

## KiCad design circuit-boards/connector_boards/PowerDistribution-V2/PowerDistribution.kicad_pcb (2024-10-19)

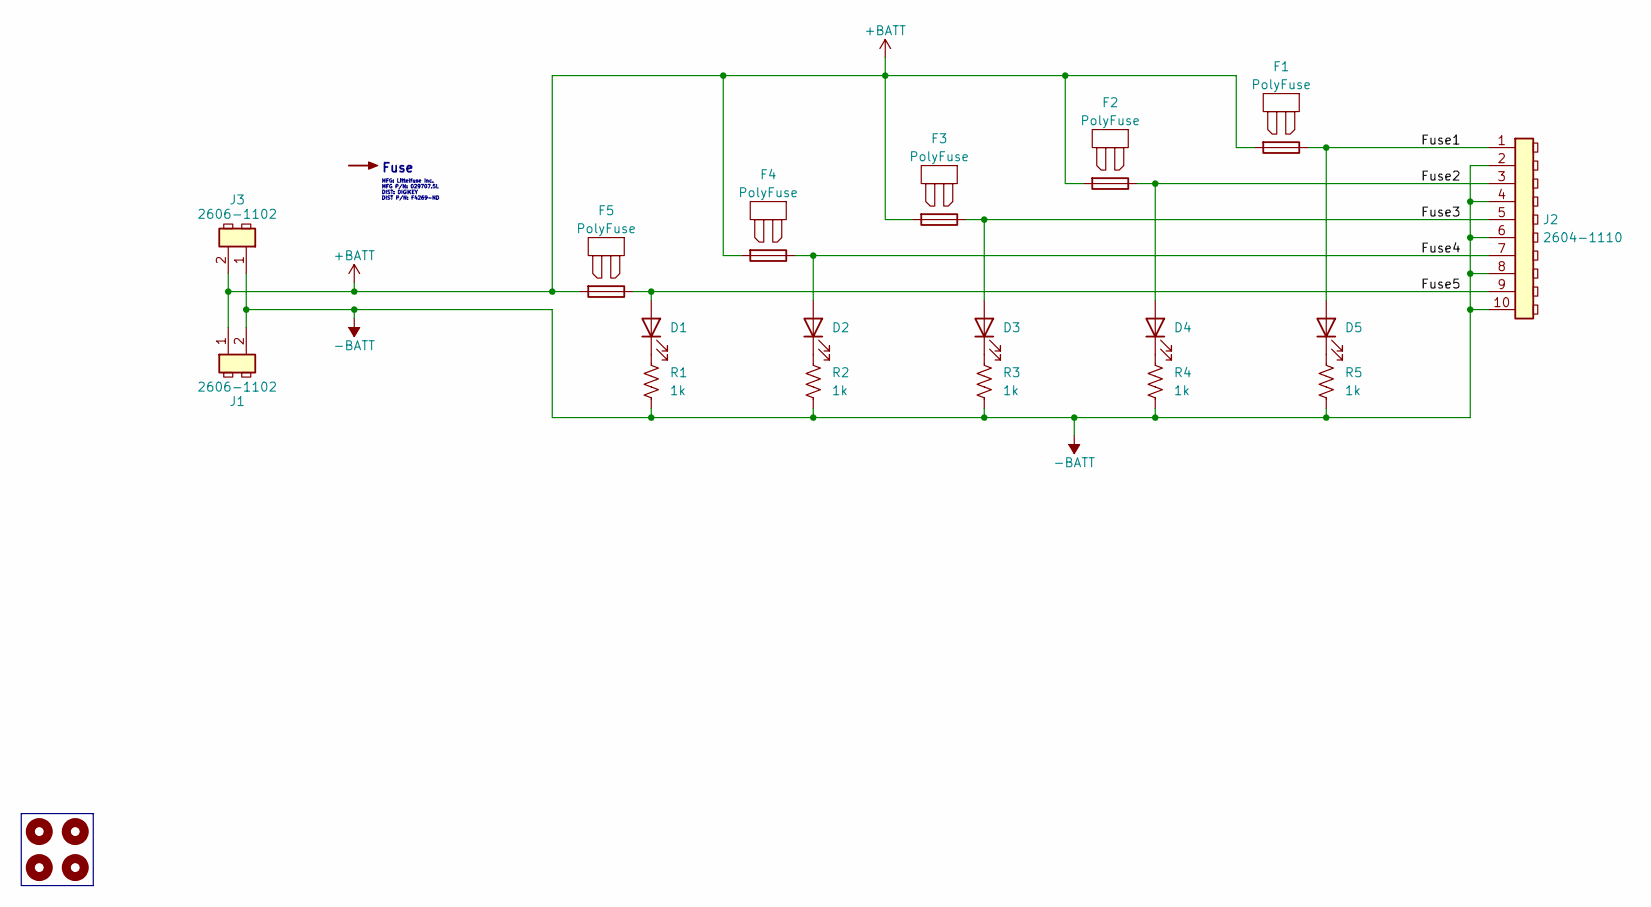
[picture p159: schematic PowerDistribution.kicad_sch, Power Distribution]

Parts:
D1, D2, D3, D4, D5: QTLP651C4TR; LED_1206_3216Metric_Pad1.42x1.75mm_HandSolder; MFG P/N QTLP651C4TR
F1, F2, F3, F4, F5: PolyFuse; FUSE_3568; MFG P/N 3568
H1, H2, H5, H6: MountingHole; MountingHole_2.2mm_M2_DIN965_Pad
J1, J3: 2606-1102; 2606-1102&slash_000-005; MFG P/N 2606-1102
J2: 2604-1110; MFG P/N 2604-1110
R1, R2, R3, R4, R5: 1k; R_1206_3216Metric_Pad1.30x1.75mm_HandSolder; MFG P/N RMCF1206FT1K00

Connections:
+BATT: F1.2, F2.2, F3.2, F4.2, F5.2, J1.1, J3.2
-BATT: J1.2, J2.2, J2.4, J2.6, J2.8, J2.10, J3.1, R1.2, R2.2, R3.2, R4.2, R5.2
/Fuse1: D5.2 (A), F1.1, J2.1
/Fuse2: D4.2 (A), F2.1, J2.3
/Fuse3: D3.2 (A), F3.1, J2.5
/Fuse4: D2.2 (A), F4.1, J2.7
/Fuse5: D1.2 (A), F5.1, J2.9
unnamed: D1.1 (K), R1.1
unnamed: D2.1 (K), R2.1
unnamed: D3.1 (K), R3.1
unnamed: D4.1 (K), R4.1
unnamed: D5.1 (K), R5.1

Notes on the sheet:
Fuse
MFG: Littelfuse Inc. MFG P/N: 029707.5L DIST: DIGIKEY DIST P/N: F4269-ND

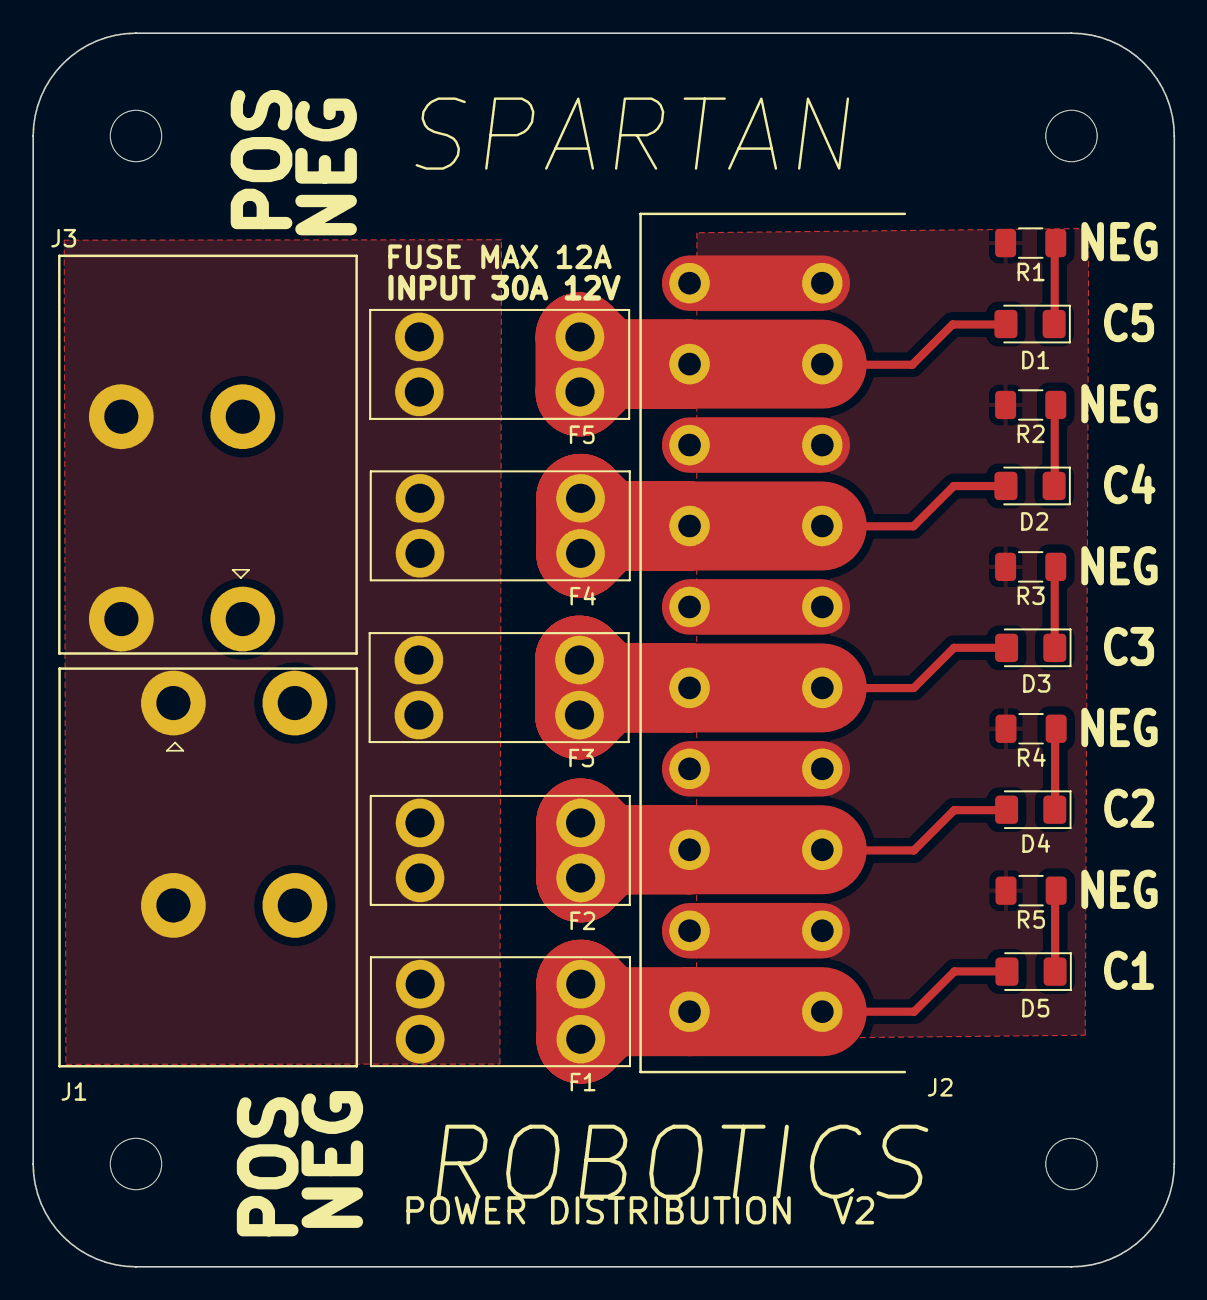
[picture p160: board PowerDistribution.kicad_pcb from above]

Board: 2 copper layers, 70.5 x 76.2 mm, 22 parts (0 on the bottom side), 12 nets.
