frc971/electrical/circuit-boards/hall-switch-v2/HallSwitch.kicad_pcb

## KiCad design circuit-boards/hall-switch-v2/HallSwitch.kicad_pcb (2024-10-15)

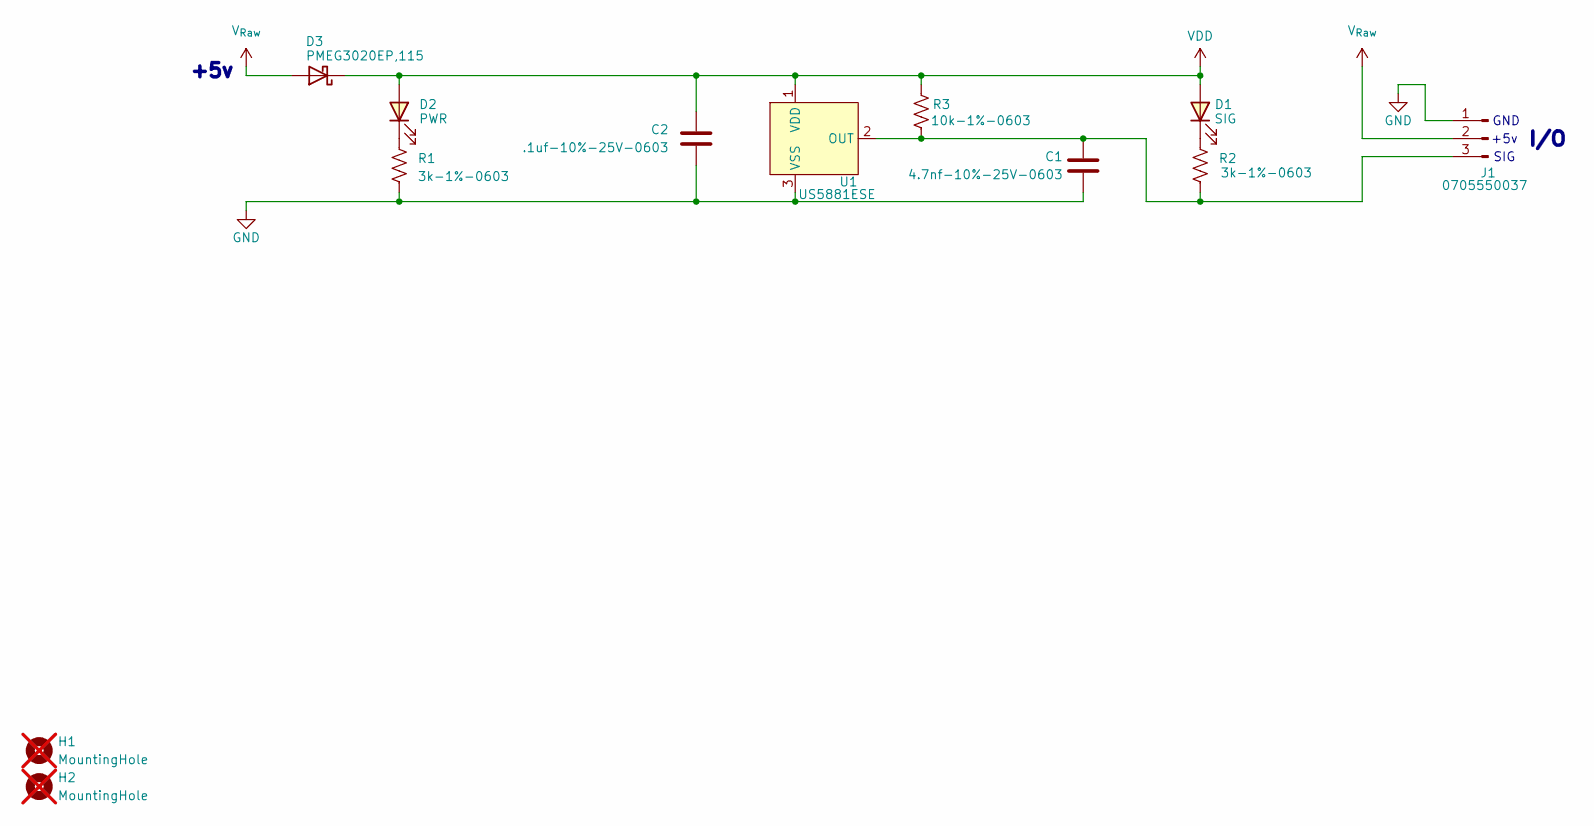
[picture p161: schematic HallSwitch.kicad_sch, Hall Switch]

Parts:
C1: 4.7nf-10%-25V-0603; C_0603_1608Metric; MFG P/N C0603C472K3RAC7867
C2: .1uf-10%-25V-0603; C_0603_1608Metric; MFG P/N C0603C104K3RAC7867
D1: SIG; LED_1206_3216Metric; MFG P/N XZVG55W-A2RT
D2: PWR; LED_1206_3216Metric; MFG P/N XZVG55W-A2RT
D3: PMEG3020EP,115; D_SOD-128; MFG P/N 1727-5836-1-ND
H1, H2: MountingHole; MountingHole_2.1mm; not fitted
J1: 0705550037; 70555-0037; MFG P/N 0705550037
R1, R2: 3k-1%-0603; R_0603_1608Metric; MFG P/N ERA-3AEB302VRMCF0603FT3K00
R3: 10k-1%-0603; R_0603_1608Metric; MFG P/N RC0603FR-0710KL
U1: US5881ESE; SOT-23-3; MFG P/N US5881ESE-AAA-000-RECT-ND

Connections:
GND: C1.2, C2.2, J1.1, R1.2, U1.3 (VSS)
unnamed: D1.1 (K), R2.1
unnamed: D2.1 (K), R1.1
unnamed: C1.1, J1.3, R2.2, R3.2, U1.2 (OUT)
VDD: C2.1, D1.2 (A), D2.2 (A), D3.1 (K), R3.1, U1.1 (VDD)
V_{Raw}: D3.2 (A), J1.2

Notes on the sheet:
GND
SIG
+5v
I/O
+5v

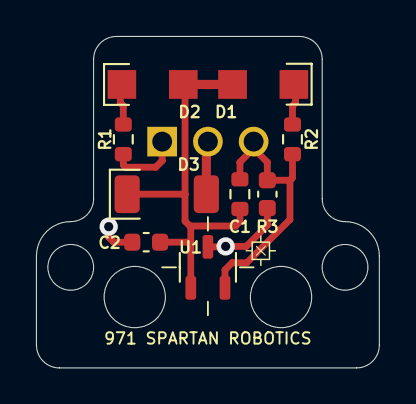
[picture p162: board HallSwitch.kicad_pcb from above]

Board: 2 copper layers, 19.1 x 18.4 mm, 12 parts (1 on the bottom side), 6 nets.
