frc971/electrical/circuit-boards/connector_boards/TEE-CAN-SL/TEE-CAN-SL.kicad_pcb

## KiCad design circuit-boards/connector_boards/TEE-CAN-SL/TEE-CAN-SL.kicad_pcb (2024-10-12)

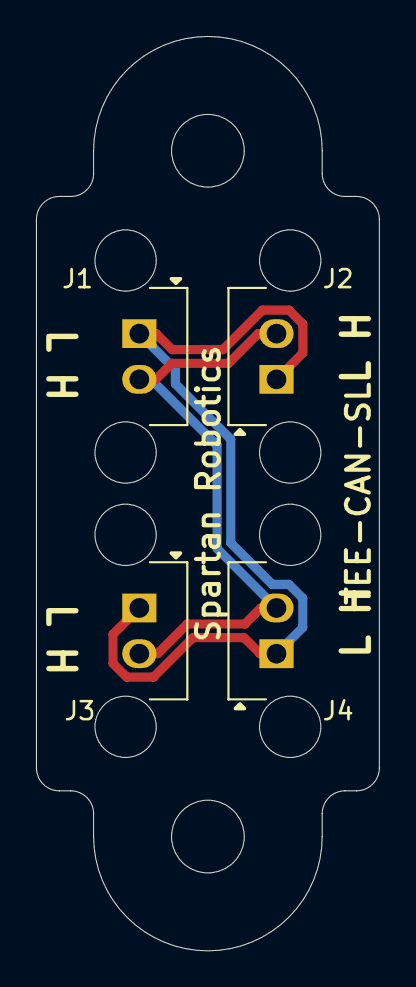
[picture p163: board TEE-CAN-SL.kicad_pcb from above]

Board: 2 copper layers, 19.1 x 50.8 mm, 6 parts (0 on the bottom side), 2 nets.

Parts:
H1, H2: MountingHole; MountingHole_2.1mm
J1, J2, J3, J4: Conn_01x02_Pin; 70541-0036

Connections:
/CAN_H: J1.2, J2.2, J3.2, J4.2
/CAN_L: J1.1, J2.1, J3.1, J4.1
