frc971/electrical/circuit-boards/shaft-encoders/mag-encoder/mag-encoder.kicad_pcb

## KiCad design circuit-boards/shaft-encoders/mag-encoder/mag-encoder.kicad_pcb (2024-08-26, an earlier design)

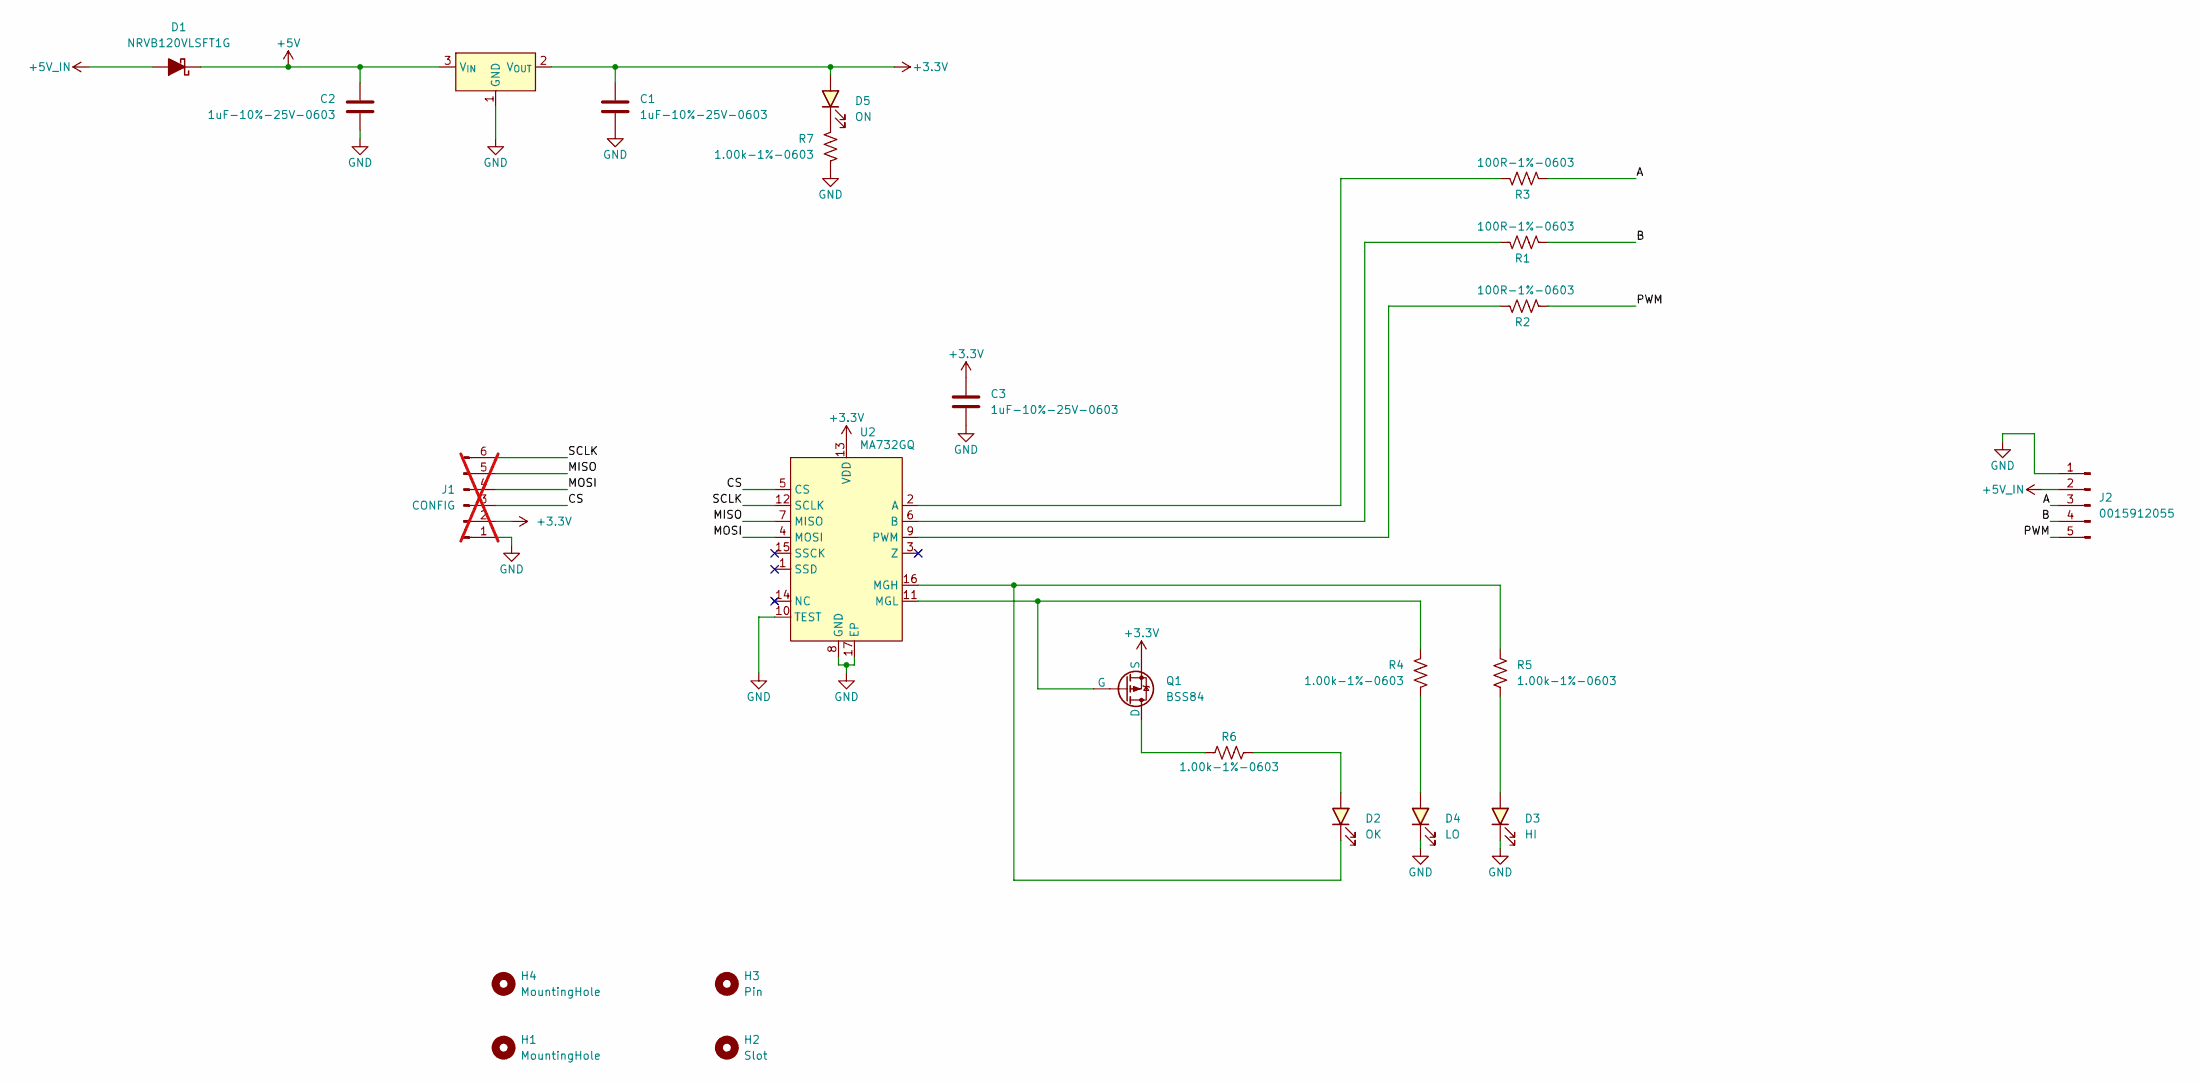
[picture p164: schematic mag-encoder.kicad_sch, Mag Encoder]

Parts:
C1, C2, C3: 1uF-10%-25V-0603; C_0603_1608Metric; MFG P/N 06033C105KAT2A
D1: NRVB120VLSFT1G; D_SOD-123F; MFG P/N NRVB120VLSFT1G
D2: OK; LED_0603_1608Metric; MFG P/N 150060GS75000
D3: HI; LED_0603_1608Metric; MFG P/N 150060RS75000
D4: LO; LED_0603_1608Metric; MFG P/N 150060RS75000
D5: ON; LED_0603_1608Metric; MFG P/N 150060GS75000
H1, H4: MountingHole; MountingHole_3.2mm_M3
H2: Slot; pin-0.100
H3: Pin; pin-0.100
J1: CONFIG; PinHeader_1x06_P2.54mm_Vertical; not fitted
J2: 0015912055; Molex-70634-0039; MFG P/N 0015912055
Q1: BSS84; SOT-23; MFG P/N BSS84
R1, R2, R3: 100R-1%-0603; R_0603_1608Metric; MFG P/N RC0603FR-07100RL
R4, R5, R6, R7: 1.00k-1%-0603; R_0603_1608Metric; MFG P/N RC0603FR-071KL
U1: AP2120N-3.3TRG1; SOT-23; MFG P/N AP2120N-3.3TRG1
U2: MA732GQ; QFN-16-1EP_3x3mm_P0.5mm_EP1.7x1.7mm; MFG P/N MA732GQ-Z

Connections:
+3.3V: C1.1, C3.1, D5.2 (A), J1.2, Q1.2 (S), U1.2 (V_{OUT}), U2.13 (VDD)
+5V: C2.1, D1.1 (K), U1.3 (V_{IN})
+5V_IN: D1.2 (A), J2.2
/A: J2.3, R3.2
/B: J2.4, R1.2
/CS: J1.3, U2.5 (CS)
/MISO: J1.5, U2.7 (MISO)
/MOSI: J1.4, U2.4 (MOSI)
/PWM: J2.5, R2.2
/SCLK: J1.6, U2.12 (SCLK)
GND: C1.2, C2.2, C3.2, D3.1 (K), D4.1 (K), J1.1, J2.1, R7.2, U1.1 (GND), U2.8 (GND), U2.10 (TEST), U2.17 (EP)
unnamed: D2.2 (A), R6.2
unnamed: D2.1 (K), R5.1, U2.16 (MGH)
unnamed: D3.2 (A), R5.2
unnamed: D4.2 (A), R4.2
unnamed: D5.1 (K), R7.1
unnamed: Q1.3 (D), R6.1
unnamed: Q1.1 (G), R4.1, U2.11 (MGL)
unnamed: R3.1, U2.2 (A)
unnamed: R1.1, U2.6 (B)
unnamed: R2.1, U2.9 (PWM)

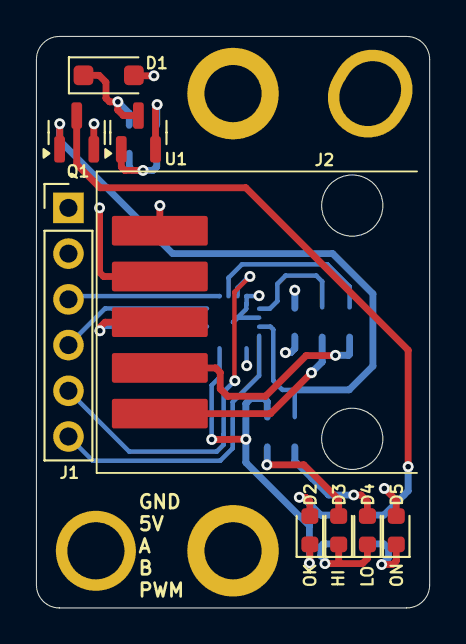
[picture p165: board circuit-boards/shaft-encoders/mag-encoder/mag-encoder.kicad_pcb from above]

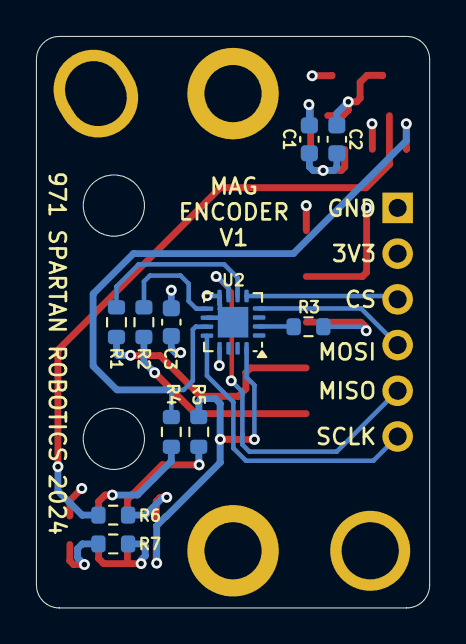
[picture p166: board circuit-boards/shaft-encoders/mag-encoder/mag-encoder.kicad_pcb from below]

Board: 4 copper layers, 21.8 x 31.8 mm, 24 parts (11 on the bottom side), 21 nets.
