frc971/electrical/circuit-boards/Orin-NX-PCBs/NX-J401-Adapter-v3/NX-J401-Adapter.kicad_pcb

## KiCad design circuit-boards/Orin-NX-PCBs/NX-J401-Adapter-v3/NX-J401-Adapter.kicad_pcb (2024-08-18)

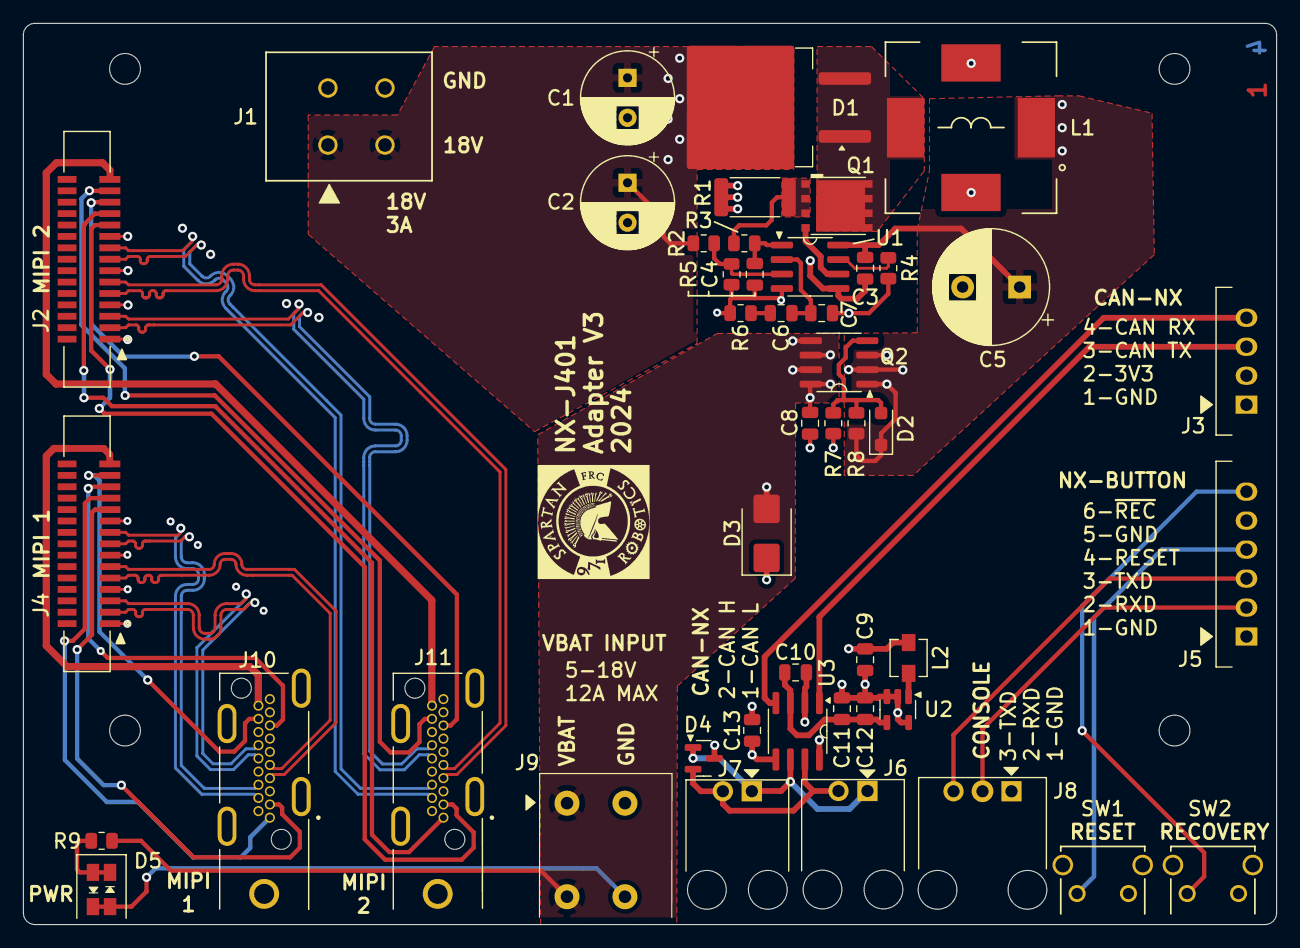
[picture p167: board NX-J401-Adapter.kicad_pcb from above]

Board: 4 copper layers, 109.9 x 79.0 mm, 51 parts (0 on the bottom side), 51 nets.

Parts:
C1, C2: 82uF 35V; CP_Radial_D8.0mm_P3.50mm
C3, C6, C10, C13: 0.22uF-10%-50V-0805; C_0805_2012Metric
C4: 10pF-5%-50V-0805; C_0805_2012Metric
C5: 330uF 35V; CP_Radial_D10.0mm_P5.00mm
C7: 0.01uF-10%-50V-0805; C_0805_2012Metric
C8, C11, C12: 22uF-20%-25V-0805; C_0805_2012Metric
C9: 10uF-10%-10V-0805; C_0805_2012Metric
D1: STPS20M100SG-TR; TO-263-2
D2: 15V; D_SOD-123F
D3: 15V; D_SMB
D4: PESD1CAN; SOT-23
D5: PWR; LED-Dialight-5913001858F
H1, H2, H3, H4: MountingHole; MountingHole_2.7mm_M2.5
J1: 18V_OUT; CONN_69140872_WRE
J2, J4: MIPI; TE_1-1734248-5
J3: CAN-NX; 70543-0003
J5: NX-BUTTON; 70543-0005
J6, J7: CAN-NX; 70555-0001
J8: CONSOLE; 70555-0002
J9: Power; Wurth-691406510002B
J10, J11: HDMI; SWITCHCRAFT_RAVHD19ETR
L1: 4.7 uH-8m-20%; INDUCTOR_IHLE-5050FH-Vishay
L2: 2.2uH-20%-46mR; L_Vishay_IHLP-1212
Q1: CSD16322Q5; TI-SON5x6
Q2: SI4483ADY-T1-GE3; SOIC-8_3.9x4.9mm_P1.27mm
R1: 4.0m-1%-2512; R_2512_6332Metric
R2: 14.0k-1%-0805; R_0805_2012Metric
R3: 100R-1%-0805; R_0805_2012Metric
R4: 59.0k-1%-0805; R_0805_2012Metric
R5, R6, R7: 1.05k-1%-0805; R_0805_2012Metric
R8: 20.0k-1%-0805; R_0805_2012Metric
R9: 4.99k-1%-0805; R_0805_2012Metric
SW1: RESET; SW_TL1105VF100Q_EWI
SW2: RECOVERY; SW_TL1105VF100Q_EWI
U1: LM3478MA; SOIC-8_3.9x4.9mm_P1.27mm
U2: TPS613222ADBVR; SOT-23-5
U3: MCP2558FD-H/SN; SOIC-8_3.9x4.9mm_P1.27mm

Connections:
/3V3_CAN: C9.1, C13.1, J3.2, L2.1, U3.5 (V_{IO})
/+18V_OUT: C1.1, C2.1, D1.2 (K), J1.1, R2.2
/CAN_H: D4.2 (K1), J6.2, J7.2, U3.7 (CANH)
/CAN_L: D4.1 (K1), J6.1, J7.1, U3.6 (CANL)
/CAN_RX: J3.4, U3.4 (RXD)
/CAN_TX: J3.3, U3.1 (TXD)
/MIPI-HDMI-1/CAM_3V3: J4.15, J10.18 (+5V)
/MIPI-HDMI-1/CAM_CK_N: J4.8, J10.6 (D1-)
/MIPI-HDMI-1/CAM_CK_P: J4.9, J10.4 (D1+)
/MIPI-HDMI-1/CAM_D0_N: J4.2, J10.12 (CK-)
/MIPI-HDMI-1/CAM_D0_P: J4.3, J10.10 (CK+)
/MIPI-HDMI-1/CAM_D1_N: J4.5, J10.9 (D0-)
/MIPI-HDMI-1/CAM_D1_P: J4.6, J10.7 (D0+)
/MIPI-HDMI-1/CAM_MCLK: J4.12, J10.1 (D2+)
/MIPI-HDMI-1/CAM_SCL: J4.13, J10.15 (SCL)
/MIPI-HDMI-1/CAM_SDA: J4.14, J10.16 (SDA)
/MIPI-HDMI-1/GND_MIPI: J4.1, J4.4, J4.7, J4.10, J10.2 (D2S), J10.5 (D1S), J10.8 (D0S), J10.11 (CKS), J10.17 (GND), J10.SH
/MIPI-HDMI-1/PWR_DN_LS: J4.11, J10.3 (D2-)
/MIPI-HDMI-2/CAM_3V3: J2.15, J11.18 (+5V)
/MIPI-HDMI-2/CAM_CK_N: J2.8, J11.6 (D1-)
/MIPI-HDMI-2/CAM_CK_P: J2.9, J11.4 (D1+)
/MIPI-HDMI-2/CAM_D0_N: J2.2, J11.12 (CK-)
/MIPI-HDMI-2/CAM_D0_P: J2.3, J11.10 (CK+)
/MIPI-HDMI-2/CAM_D1_N: J2.5, J11.9 (D0-)
/MIPI-HDMI-2/CAM_D1_P: J2.6, J11.7 (D0+)
/MIPI-HDMI-2/CAM_MCLK: J2.12, J11.1 (D2+)
/MIPI-HDMI-2/CAM_SCL: J2.13, J11.15 (SCL)
/MIPI-HDMI-2/CAM_SDA: J2.14, J11.16 (SDA)
/MIPI-HDMI-2/GND_MIPI: J2.1, J2.4, J2.7, J2.10, J11.2 (D2S), J11.5 (D1S), J11.8 (D0S), J11.11 (CKS), J11.17 (GND), J11.SH
/MIPI-HDMI-2/PWR_DN_LS: J2.11, J11.3 (D2-)
/NX CAN/+5V: C10.1, C11.1, C12.1, U2.4 (VOUT), U3.3 (V_{DD})
/Power Supply/Q_S: Q1.1 (S), Q1.2 (S), Q1.3 (S), R1.2, R3.1
/Power Supply/SW: D1.1 (A), D1.3 (A), L1.2, Q1.5 (D)
/Power Supply/V_IN: C3.1, C5.1, D2.1 (K), L1.1, Q2.1 (S), Q2.2 (S), Q2.3 (S), R8.2, U1.8 (V_{IN})
/RTN: J5.1, J5.5, J8.1, SW1.2, SW2.2
/UART2_RXD: J5.2, J8.2
/UART2_TXD: J5.3, J8.3
/V_BAT: C8.1, D3.2 (A2), J9.1, Q2.5 (D), Q2.6 (D), Q2.7 (D), Q2.8 (D), R9.2
/~REC: J5.6, SW2.1
/~SYS_RESET: J5.4, SW1.1
GND: C1.2, C2.2, C3.2, C4.2, C5.2, C7.2, C8.2, D3.1 (A1), D5.2 (RedA), D5.4 (Green-K), J1.2, J9.2, L1.3, L1.4, R1.1, R4.1, R5.1, R6.1, R7.1, U1.4 (AGND), U1.5 (PGND)
GNDD: C9.2, C10.2, C11.2, C12.2, C13.2, D4.3 (KK), J3.1, U2.2 (GND), U2.3 (NC), U2.5 (NC), U3.2 (V_{SS}), U3.8 (S)
unnamed: C6.2, R6.2
unnamed: D2.2 (A), Q2.4 (G), R7.2, R8.1
unnamed: D5.1 (Red-K), D5.3 (Green-A), R9.1
unnamed: Q1.4 (G), U1.6 (DR)
unnamed: C6.1, C7.1, U1.2 (COMP)
unnamed: R4.2, U1.7 (FA/SD)
unnamed: R2.1, R5.2, U1.3 (FB)
unnamed: C4.1, R3.2, U1.1 (I_{SEN})
unnamed: L2.2, U2.1 (SW)
