frc971/electrical/circuit-boards/Orin-NX-PCBs/NX-IndicatorBoard-V2/NX-IndicatorBoard.kicad_pcb

## KiCad design circuit-boards/Orin-NX-PCBs/NX-IndicatorBoard-V2/NX-IndicatorBoard.kicad_pcb (2024-08-05)

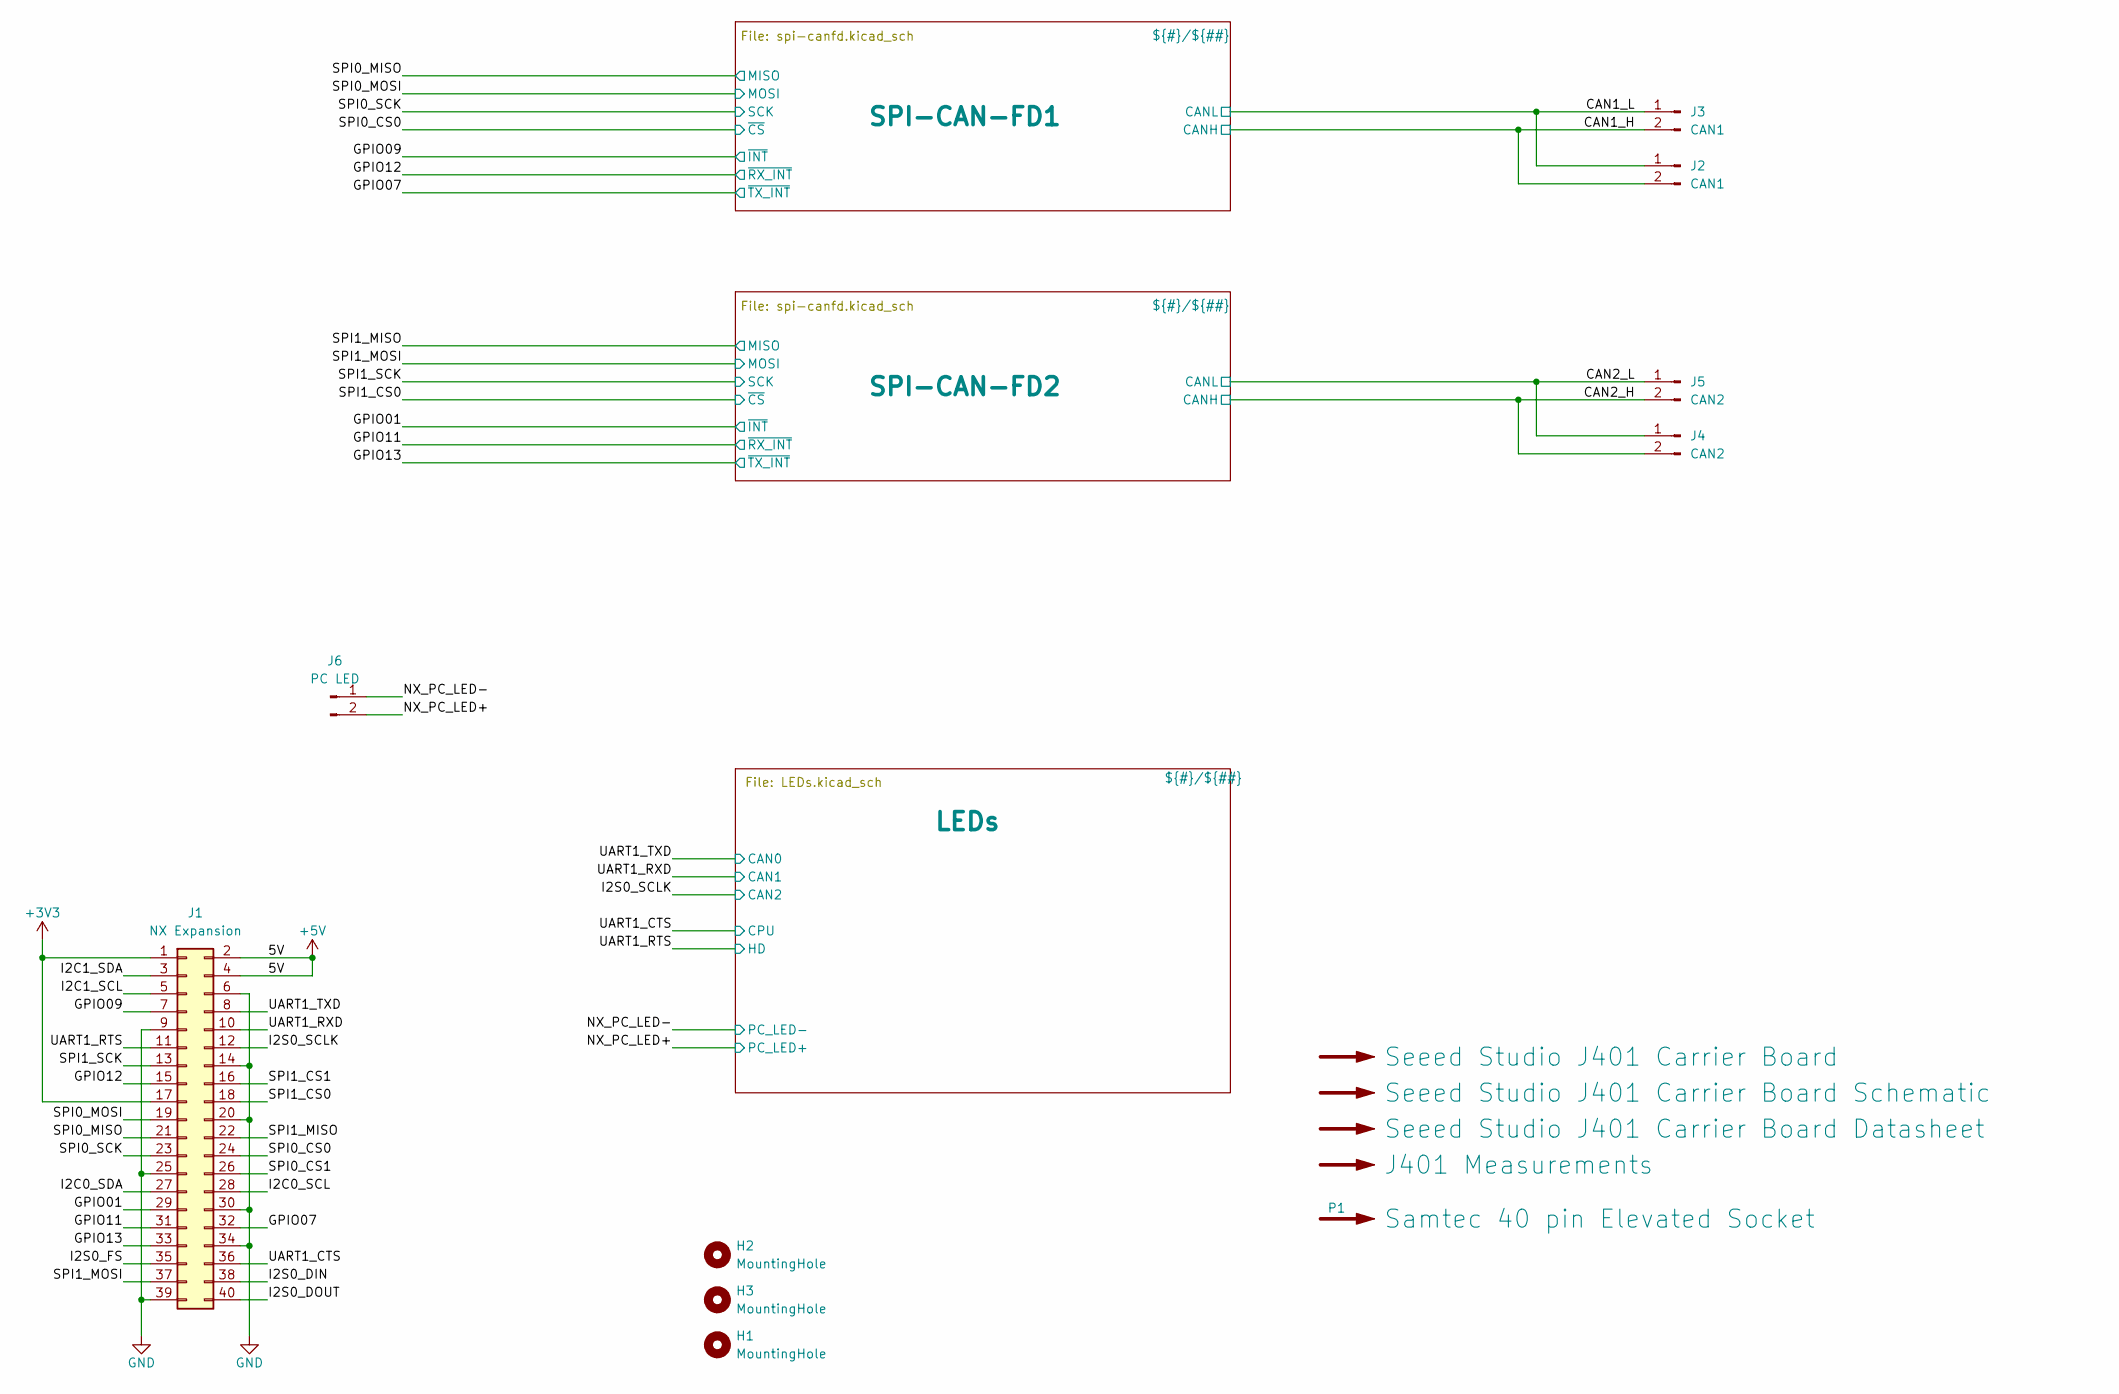
[picture p168: schematic NX-IndicatorBoard.kicad_sch, NX Indicator Board V2]

Parts:
H1, H2, H3: MountingHole; MountingHole_2.7mm_M2.5_Pad
J1: NX Expansion; M20-782045; MFG P/N M20-7812045
J2, J3: CAN1; 70555-0001; MFG P/N 0705550036
J4, J5: CAN2; 70555-0001; MFG P/N 0705550036
J6: PC LED; 70543-0001; MFG P/N 0705430036
P1: Samtec 40 pin Elevated Socket; MFG P/N ESQ-120-34-G-D

Connections:
+3V3: J1.1, J1.17; also elsewhere on the board
+5V: J1.2, J1.4; also elsewhere on the board
/CAN1_H: J2.2, J3.2; also elsewhere on the board
/CAN1_L: J2.1, J3.1; also elsewhere on the board
/CAN2_H: J4.2, J5.2; also elsewhere on the board
/CAN2_L: J4.1, J5.1; also elsewhere on the board
/GPIO01: J1.29; also elsewhere on the board
/GPIO07: J1.32; also elsewhere on the board
/GPIO09: J1.7; also elsewhere on the board
/GPIO11: J1.31; also elsewhere on the board
/GPIO12: J1.15; also elsewhere on the board
/GPIO13: J1.33; also elsewhere on the board
/I2C0_SCL: J1.28
/I2C0_SDA: J1.27
/I2C1_SCL: J1.5
/I2C1_SDA: J1.3
/I2S0_DIN: J1.38
/I2S0_DOUT: J1.40
/I2S0_FS: J1.35
/I2S0_SCLK: J1.12; also elsewhere on the board
/NX_PC_LED+: J6.2; also elsewhere on the board
/NX_PC_LED-: J6.1; also elsewhere on the board
/SPI0_CS0: J1.24; also elsewhere on the board
/SPI0_CS1: J1.26
/SPI0_MISO: J1.21; also elsewhere on the board
/SPI0_MOSI: J1.19; also elsewhere on the board
/SPI0_SCK: J1.23; also elsewhere on the board
/SPI1_CS0: J1.18; also elsewhere on the board
/SPI1_CS1: J1.16
/SPI1_MISO: J1.22; also elsewhere on the board
/SPI1_MOSI: J1.37; also elsewhere on the board
/SPI1_SCK: J1.13; also elsewhere on the board
/UART1_CTS: J1.36; also elsewhere on the board
/UART1_RTS: J1.11; also elsewhere on the board
/UART1_RXD: J1.10; also elsewhere on the board
/UART1_TXD: J1.8; also elsewhere on the board
GND: J1.6, J1.9, J1.14, J1.20, J1.25, J1.30, J1.34, J1.39; also elsewhere on the board

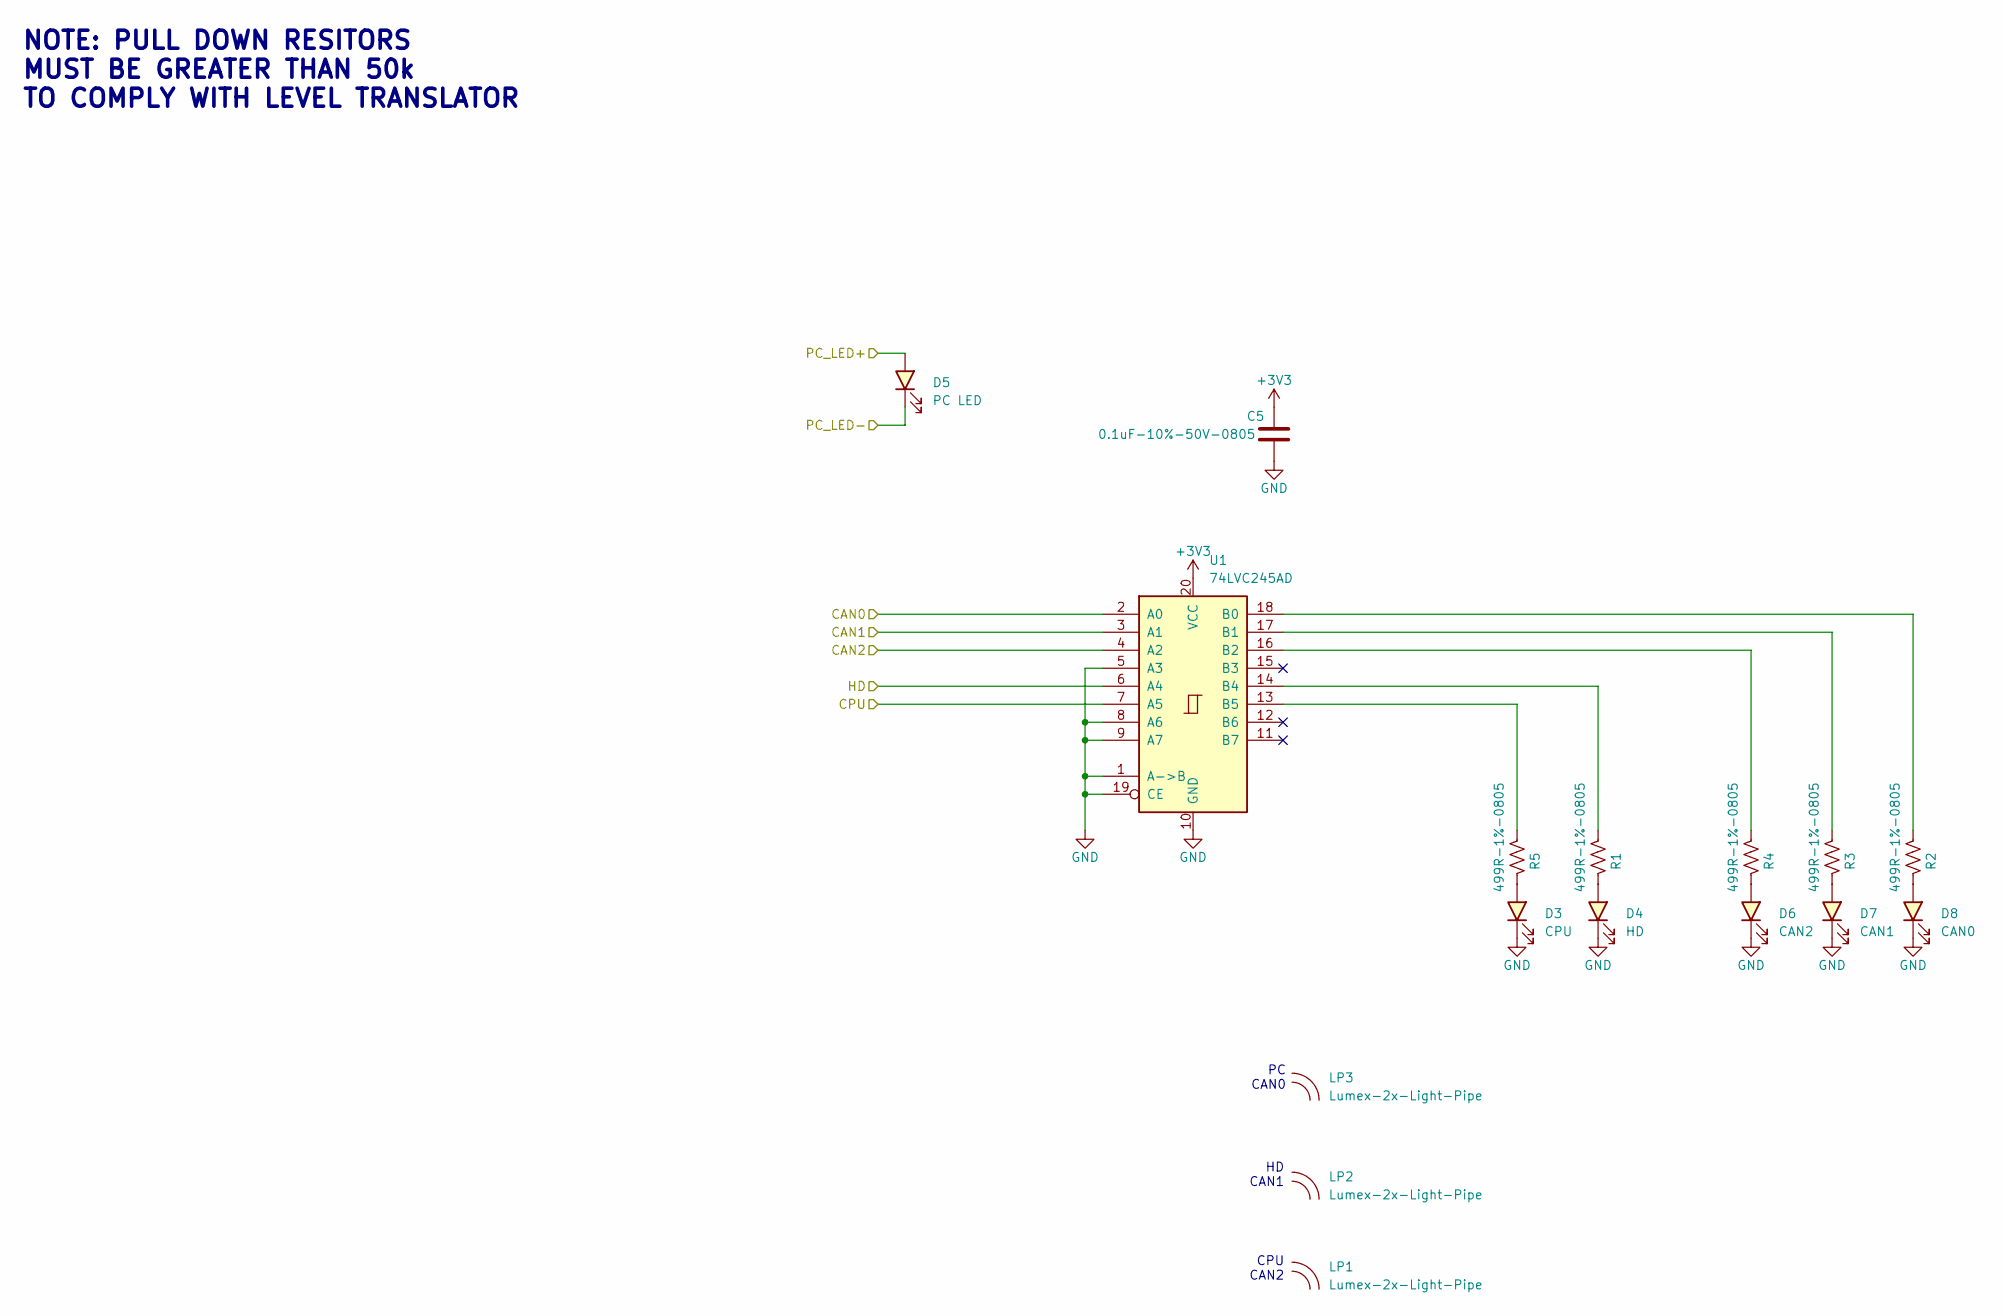
[picture p169: schematic LEDs.kicad_sch, NX Indicator Board V2]

Parts:
C5: 0.1uF-10%-50V-0805; C_0805_2012Metric; MFG P/N CC0805KRX7R9BB104
D3: CPU; LED_1206_3216Metric; MFG P/N QTLP650D4TR
D4: HD; LED_1206_3216Metric; MFG P/N QTLP650D4TR
D5: PC LED; LED_1206_3216Metric; MFG P/N QTLP650D4TR
D6: CAN2; LED_1206_3216Metric; MFG P/N QTLP650D4TR
D7: CAN1; LED_1206_3216Metric; MFG P/N QTLP650D4TR
D8: CAN0; LED_1206_3216Metric; MFG P/N QTLP650D4TR
LP1, LP2, LP3: Lumex-2x-Light-Pipe; Lumex-LPF-C012303S; MFG P/N LPF-C012303S
R1, R2, R3, R4, R5: 499R-1%-0805; R_0805_2012Metric; MFG P/N RC0805FR-07499RL
U1: 74LVC245AD; SO-20_12.8x7.5mm_P1.27mm; MFG P/N 74LVC245AD,118

Connections:
+3V3: C5.1, U1.20 (VCC); also elsewhere on the board
/I2S0_SCLK: U1.4 (A2); also elsewhere on the board
/NX_PC_LED+: D5.2 (A); also elsewhere on the board
/NX_PC_LED-: D5.1 (K); also elsewhere on the board
/UART1_CTS: U1.7 (A5); also elsewhere on the board
/UART1_RTS: U1.6 (A4); also elsewhere on the board
/UART1_RXD: U1.3 (A1); also elsewhere on the board
/UART1_TXD: U1.2 (A0); also elsewhere on the board
GND: C5.2, D3.1 (K), D4.1 (K), D6.1 (K), D7.1 (K), D8.1 (K), U1.1 (A->B), U1.5 (A3), U1.8 (A6), U1.9 (A7), U1.10 (GND), U1.19 (CE); also elsewhere on the board
unnamed: D3.2 (A), R5.1
unnamed: D4.2 (A), R1.1
unnamed: D6.2 (A), R4.1
unnamed: D7.2 (A), R3.1
unnamed: D8.2 (A), R2.1
unnamed: R2.2, U1.18 (B0)
unnamed: R3.2, U1.17 (B1)
unnamed: R4.2, U1.16 (B2)
unnamed: R1.2, U1.14 (B4)
unnamed: R5.2, U1.13 (B5)

Notes on the sheet:
CPU CAN2
PC CAN0
HD CAN1
NOTE: PULL DOWN RESITORS MUST BE GREATER THAN 50k TO COMPLY WITH LEVEL TRANSLATOR

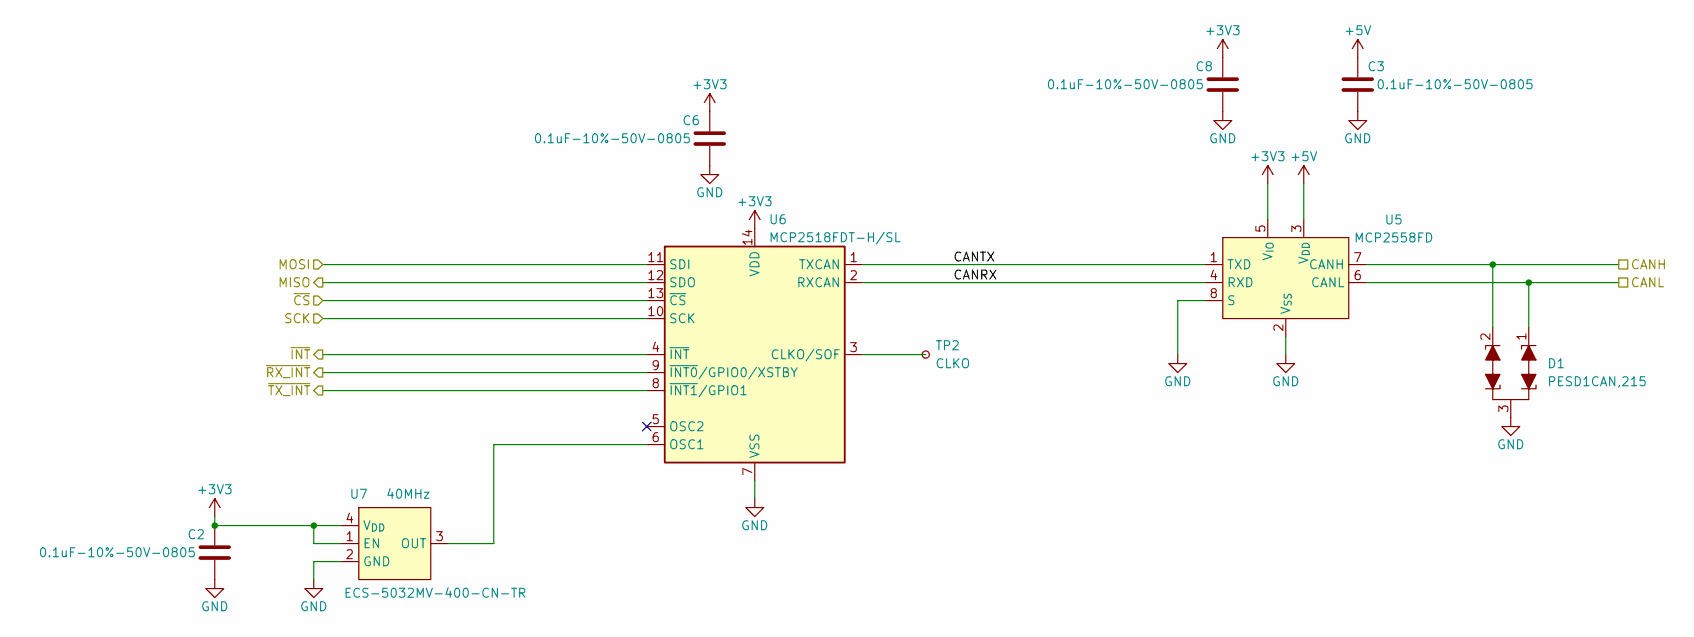
[picture p170: schematic spi-canfd.kicad_sch, NX Indicator Board V2]

Parts:
C2, C3, C6, C8: 0.1uF-10%-50V-0805; C_0805_2012Metric; MFG P/N CC0805KRX7R9BB104
D1: PESD1CAN; SOT-23; MFG P/N PESD1CAN,215
TP2: CLKO; TestPoint_THTPad_D1.0mm_Drill0.5mm
U5: MCP2558FD; SO-8_3.9x4.9mm_P1.27mm; MFG P/N MCP2558FD-H/SN
U6: MCP2518FDT-H/SL; SO-14_3.9x8.65mm_P1.27mm; MFG P/N MCP2518FDT-H/SL
U7: 40MHz; ECS-5032MV; MFG P/N ECS-5032MV-400-CN-TR

Connections:
+3V3: C2.1, C6.1, C8.1, U5.5 (V_{IO}), U6.14 (VDD), U7.1 (EN), U7.4 (V_{DD}); also elsewhere on the board
+5V: C3.1, U5.3 (V_{DD}); also elsewhere on the board
/CAN2_H: D1.2 (K1), U5.7 (CANH); also elsewhere on the board
/CAN2_L: D1.1 (K1), U5.6 (CANL); also elsewhere on the board
/GPIO01: U6.4 (~INT); also elsewhere on the board
/GPIO11: U6.9 (~INT0/GPIO0/XSTBY); also elsewhere on the board
/GPIO13: U6.8 (~INT1/GPIO1); also elsewhere on the board
/SPI1_CS0: U6.13 (~CS); also elsewhere on the board
/SPI1_MISO: U6.12 (SDO); also elsewhere on the board
/SPI1_MOSI: U6.11 (SDI); also elsewhere on the board
/SPI1_SCK: U6.10 (SCK); also elsewhere on the board
/SPI-CAN-FD2/CANRX: U5.4 (RXD), U6.2 (RXCAN)
/SPI-CAN-FD2/CANTX: U5.1 (TXD), U6.1 (TXCAN)
GND: C2.2, C3.2, C6.2, C8.2, D1.3 (KK), U5.2 (V_{SS}), U5.8 (S), U6.7 (VSS), U7.2 (GND); also elsewhere on the board
unnamed: TP2.1, U6.3 (CLKO/SOF)
unnamed: U6.6 (OSC1), U7.3 (OUT)

Parts of its further copies:
C1, C4, C7, C9: 0.1uF-10%-50V-0805; C_0805_2012Metric; MFG P/N CC0805KRX7R9BB104
D2: PESD1CAN; SOT-23; MFG P/N PESD1CAN,215
TP1: CLKO; TestPoint_THTPad_D1.0mm_Drill0.5mm
U2: MCP2558FD; SO-8_3.9x4.9mm_P1.27mm; MFG P/N MCP2558FD-H/SN
U3: MCP2518FDT-H/SL; SO-14_3.9x8.65mm_P1.27mm; MFG P/N MCP2518FDT-H/SL
U4: 40MHz; ECS-5032MV; MFG P/N ECS-5032MV-400-CN-TR

Connections of its further copies:
+3V3: C1.1, C7.1, C9.1, U2.5 (V_{IO}), U3.14 (VDD), U4.1 (EN), U4.4 (V_{DD}); also elsewhere on the board
+5V: C4.1, U2.3 (V_{DD}); also elsewhere on the board
/CAN1_H: D2.2 (K1), U2.7 (CANH); also elsewhere on the board
/CAN1_L: D2.1 (K1), U2.6 (CANL); also elsewhere on the board
/GPIO07: U3.8 (~INT1/GPIO1); also elsewhere on the board
/GPIO09: U3.4 (~INT); also elsewhere on the board
/GPIO12: U3.9 (~INT0/GPIO0/XSTBY); also elsewhere on the board
/SPI0_CS0: U3.13 (~CS); also elsewhere on the board
/SPI0_MISO: U3.12 (SDO); also elsewhere on the board
/SPI0_MOSI: U3.11 (SDI); also elsewhere on the board
/SPI0_SCK: U3.10 (SCK); also elsewhere on the board
/SPI-CAN-FD1/CANRX: U2.4 (RXD), U3.2 (RXCAN)
/SPI-CAN-FD1/CANTX: U2.1 (TXD), U3.1 (TXCAN)
GND: C1.2, C4.2, C7.2, C9.2, D2.3 (KK), U2.2 (V_{SS}), U2.8 (S), U3.7 (VSS), U4.2 (GND); also elsewhere on the board
unnamed: TP1.1, U3.3 (CLKO/SOF)
unnamed: U3.6 (OSC1), U4.3 (OUT)

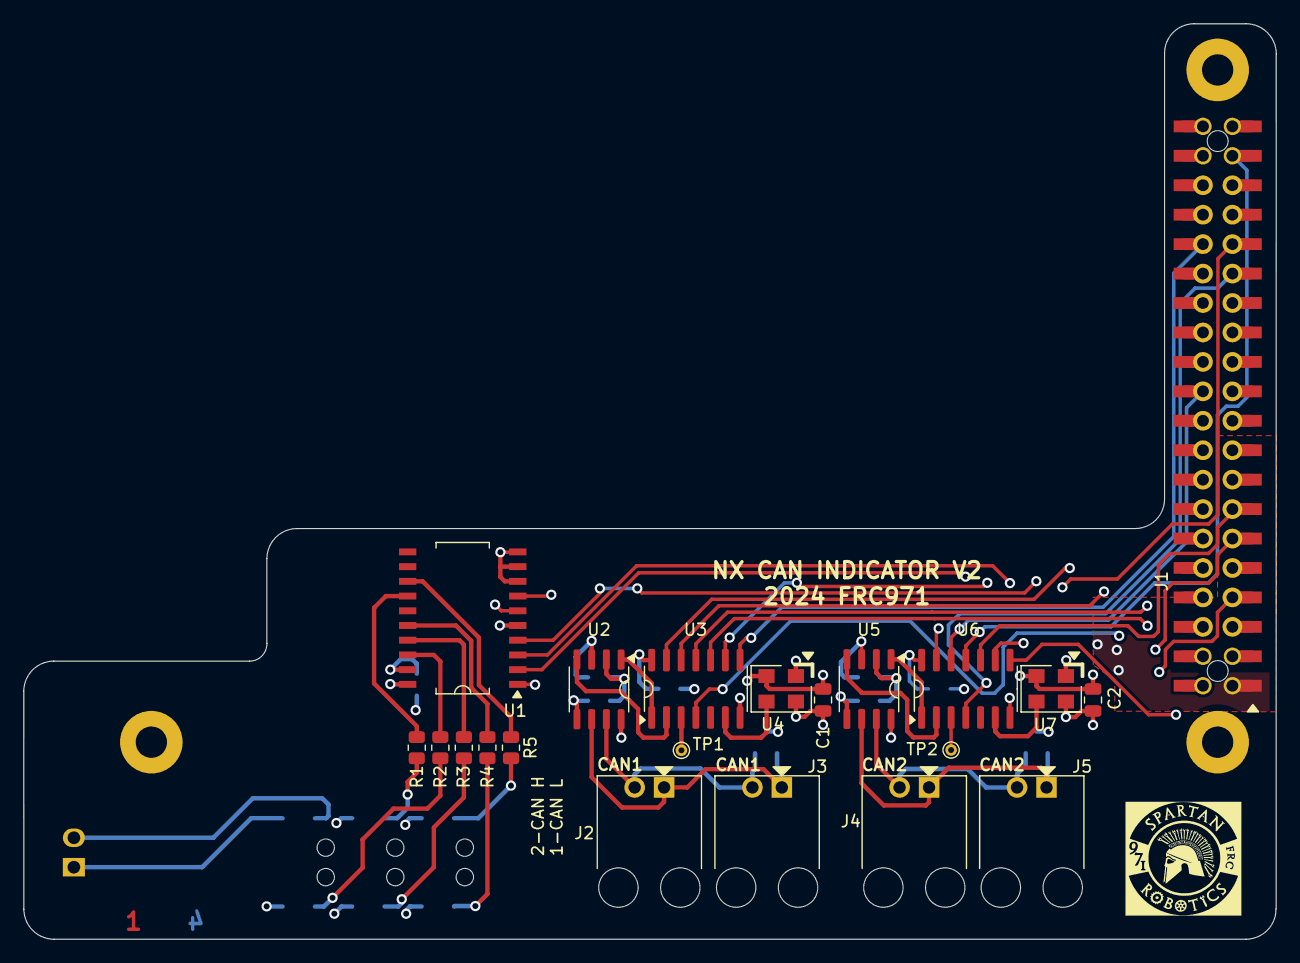
[picture p171: board NX-IndicatorBoard.kicad_pcb from above]

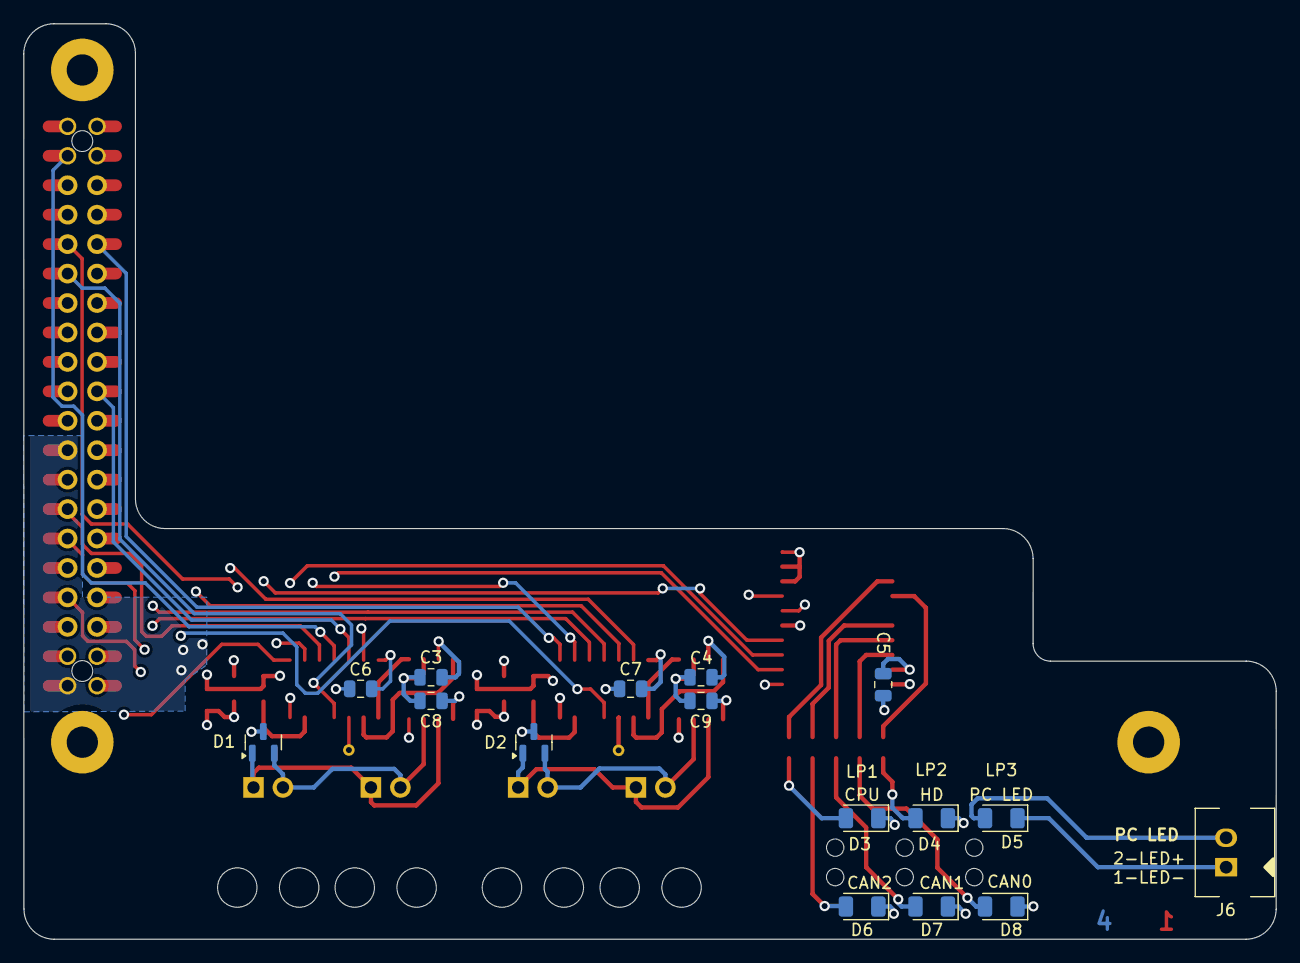
[picture p172: board NX-IndicatorBoard.kicad_pcb from below]

Board: 4 copper layers, 108.1 x 79.0 mm, 44 parts (19 on the bottom side), 46 nets.

Other parts of the board:
G1: LOGO; Spartan Logo-FrontSilk
