frc971/electrical/circuit-boards/tools/kraken-pwm-controller/kraken-pwm-controller.kicad_pcb

## KiCad design circuit-boards/tools/kraken-pwm-controller/kraken-pwm-controller.kicad_pcb (2024-07-30)

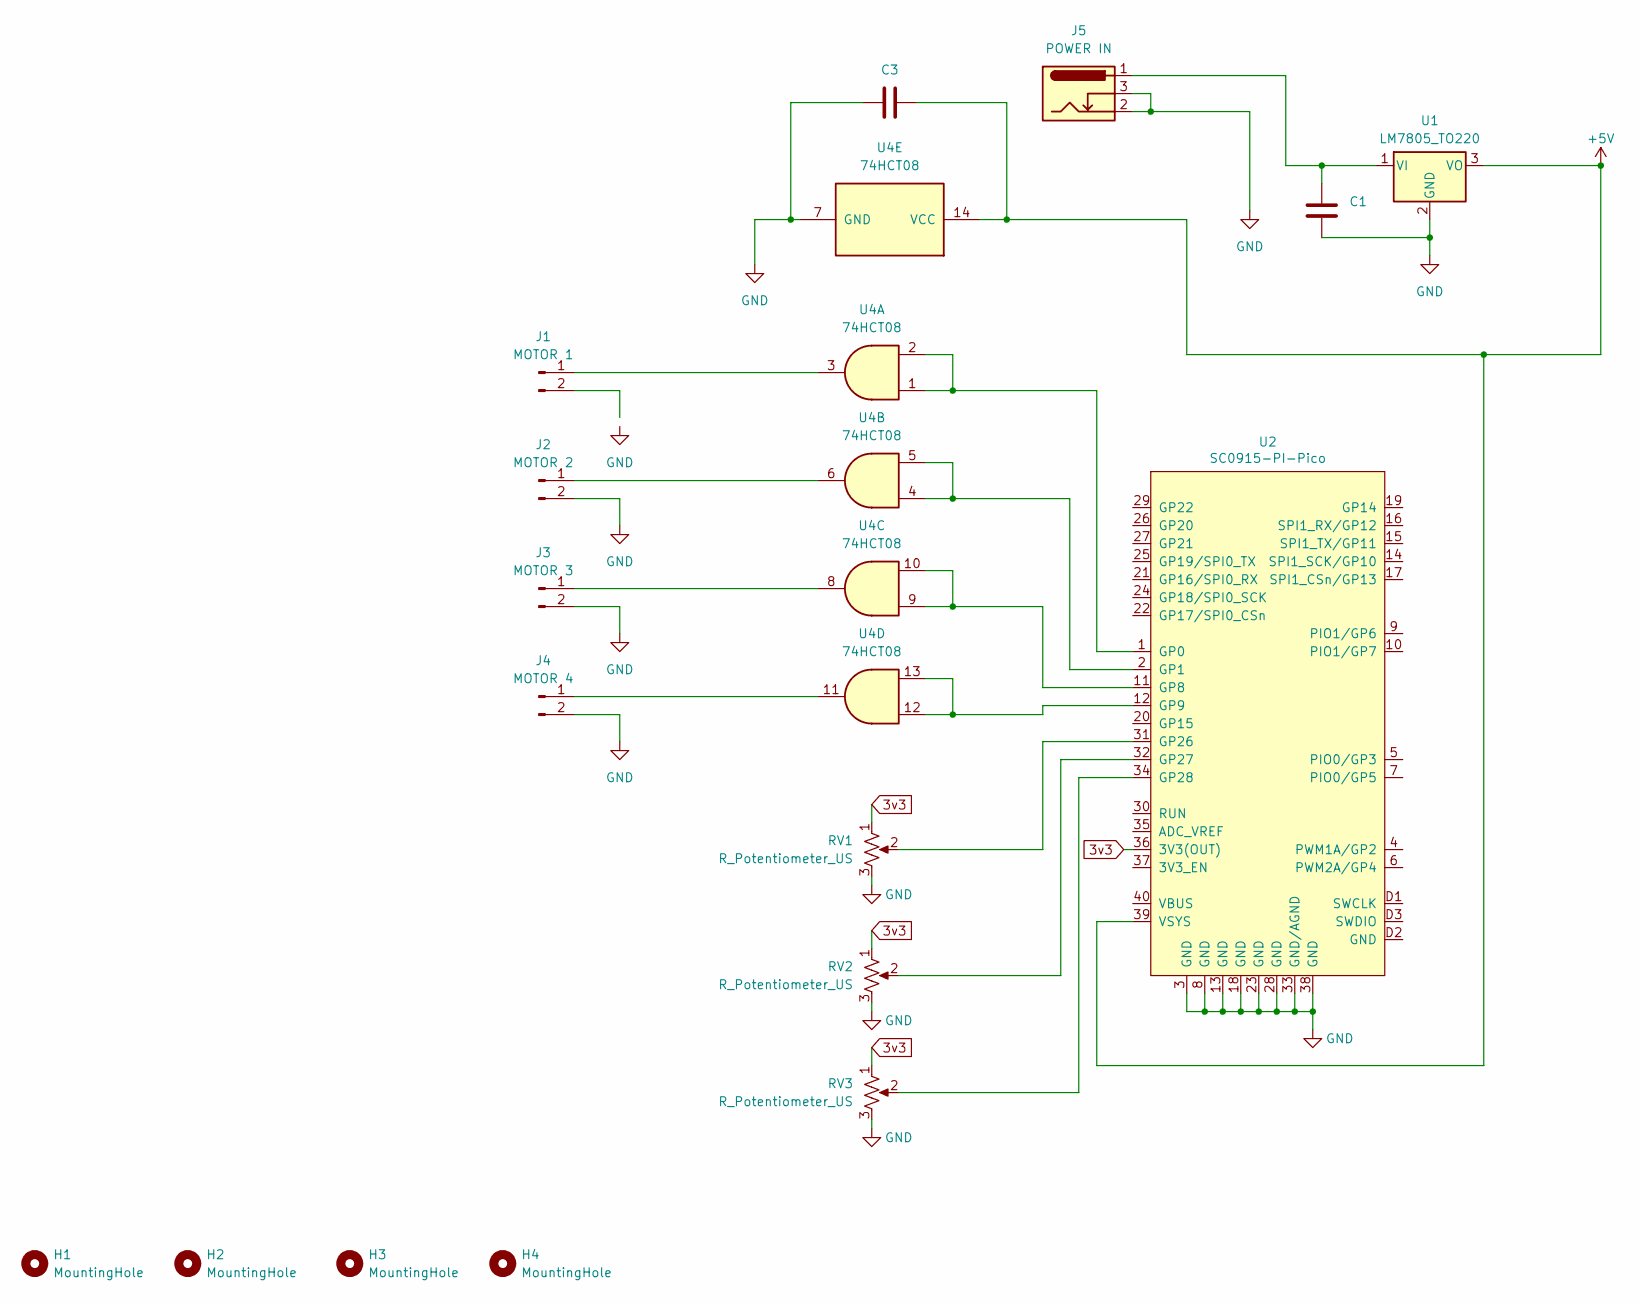
[picture p173: schematic kraken-pwm-controller.kicad_sch]

Parts:
C1, C3: CAP_R82D-7P4X3P6-5P0_KEM
H1, H2, H3, H4: MountingHole; MountingHole_3.2mm_M3
J1: MOTOR 1; 2 PIN RIGHT ANGLE MOLEX SL
J2: MOTOR 2; 2 PIN RIGHT ANGLE MOLEX SL
J3: MOTOR 3; 2 PIN RIGHT ANGLE MOLEX SL
J4: MOTOR 4; 2 PIN RIGHT ANGLE MOLEX SL
J5: POWER IN; BARREL JACK CONNECTOR
RV1, RV2, RV3: R_Potentiometer_US; PTV09A4020FB103
U1: LM7805_TO220; TO-220-3_Vertical
U2: SC0915-PI-Pico; PICO
U4: 74HCT08; N14

Connections:
3v3: RV1.1, RV2.1, RV3.1, U2.36 (3V3(OUT))
+5V: C3.1, U1.3 (VO), U2.39 (VSYS), U4.14 (VCC)
GND: C1.1, C3.2, J2.2, J3.2, J4.2, J5.2, J5.3, RV1.3, RV2.3, RV3.3, U1.2 (GND), U2.3 (GND), U2.8 (GND), U2.13 (GND), U2.18 (GND), U2.23 (GND), U2.28 (GND), U2.33 (GND/AGND), U2.38 (GND), U4.7 (GND)
unnamed: J1.1, U4.3
unnamed: J2.1, U4.6
unnamed: J3.1, U4.8
unnamed: J4.1, U4.11
unnamed: C1.2, J5.1, U1.1 (VI)
unnamed: U2.1 (GP0), U4.1, U4.2
unnamed: U2.2 (GP1), U4.4, U4.5
unnamed: U2.11 (GP8), U4.9, U4.10
unnamed: U2.12 (GP9), U4.12, U4.13
unnamed: RV1.2, U2.31 (GP26)
unnamed: RV2.2, U2.32 (GP27)
unnamed: RV3.2, U2.34 (GP28)

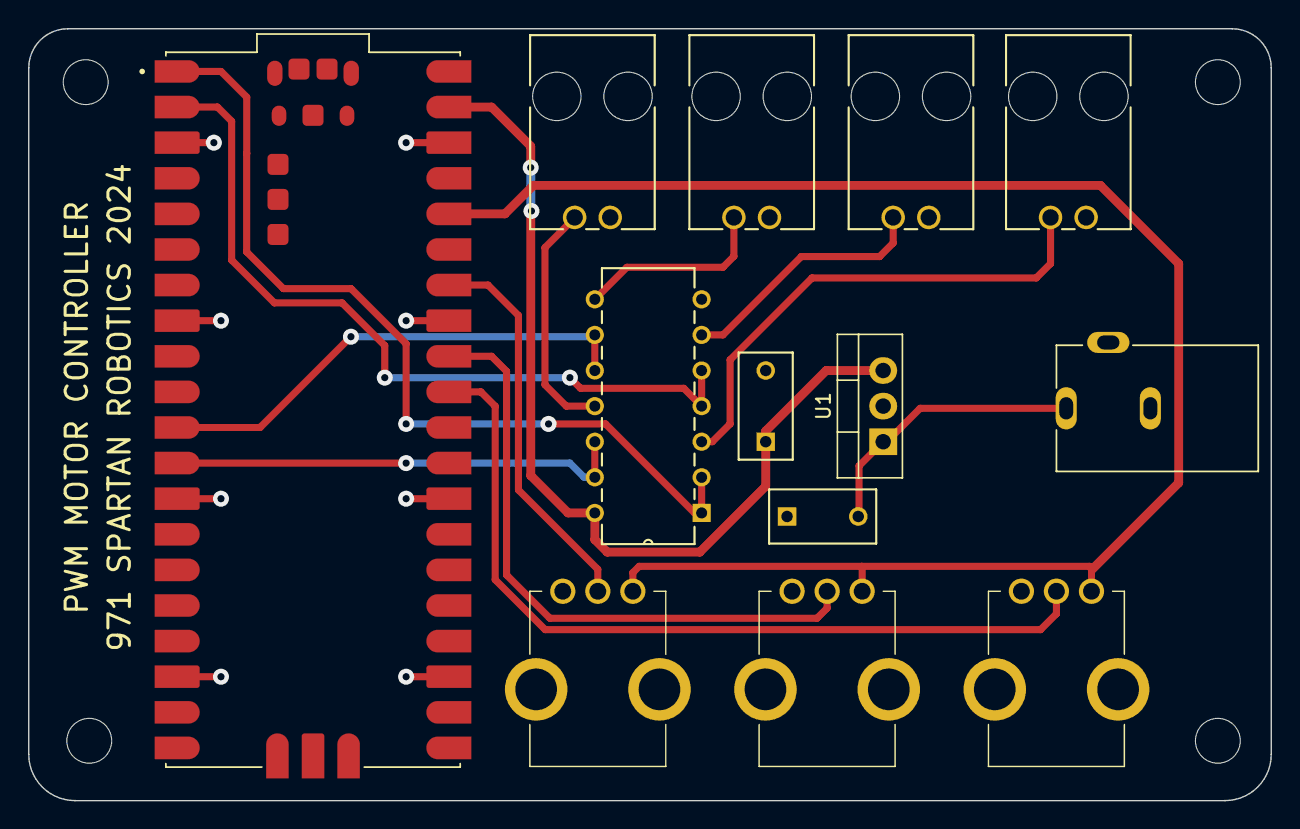
[picture p174: board kraken-pwm-controller.kicad_pcb from above]

Board: 2 copper layers, 88.6 x 55.1 mm, 17 parts (0 on the bottom side), 15 nets.
