frc971/electrical/circuit-boards/driver-station/ButtonBd2-v2/ButtonBd2.kicad_pcb

## KiCad design circuit-boards/driver-station/ButtonBd2-v2/ButtonBd2.kicad_pcb (2024-06-30)

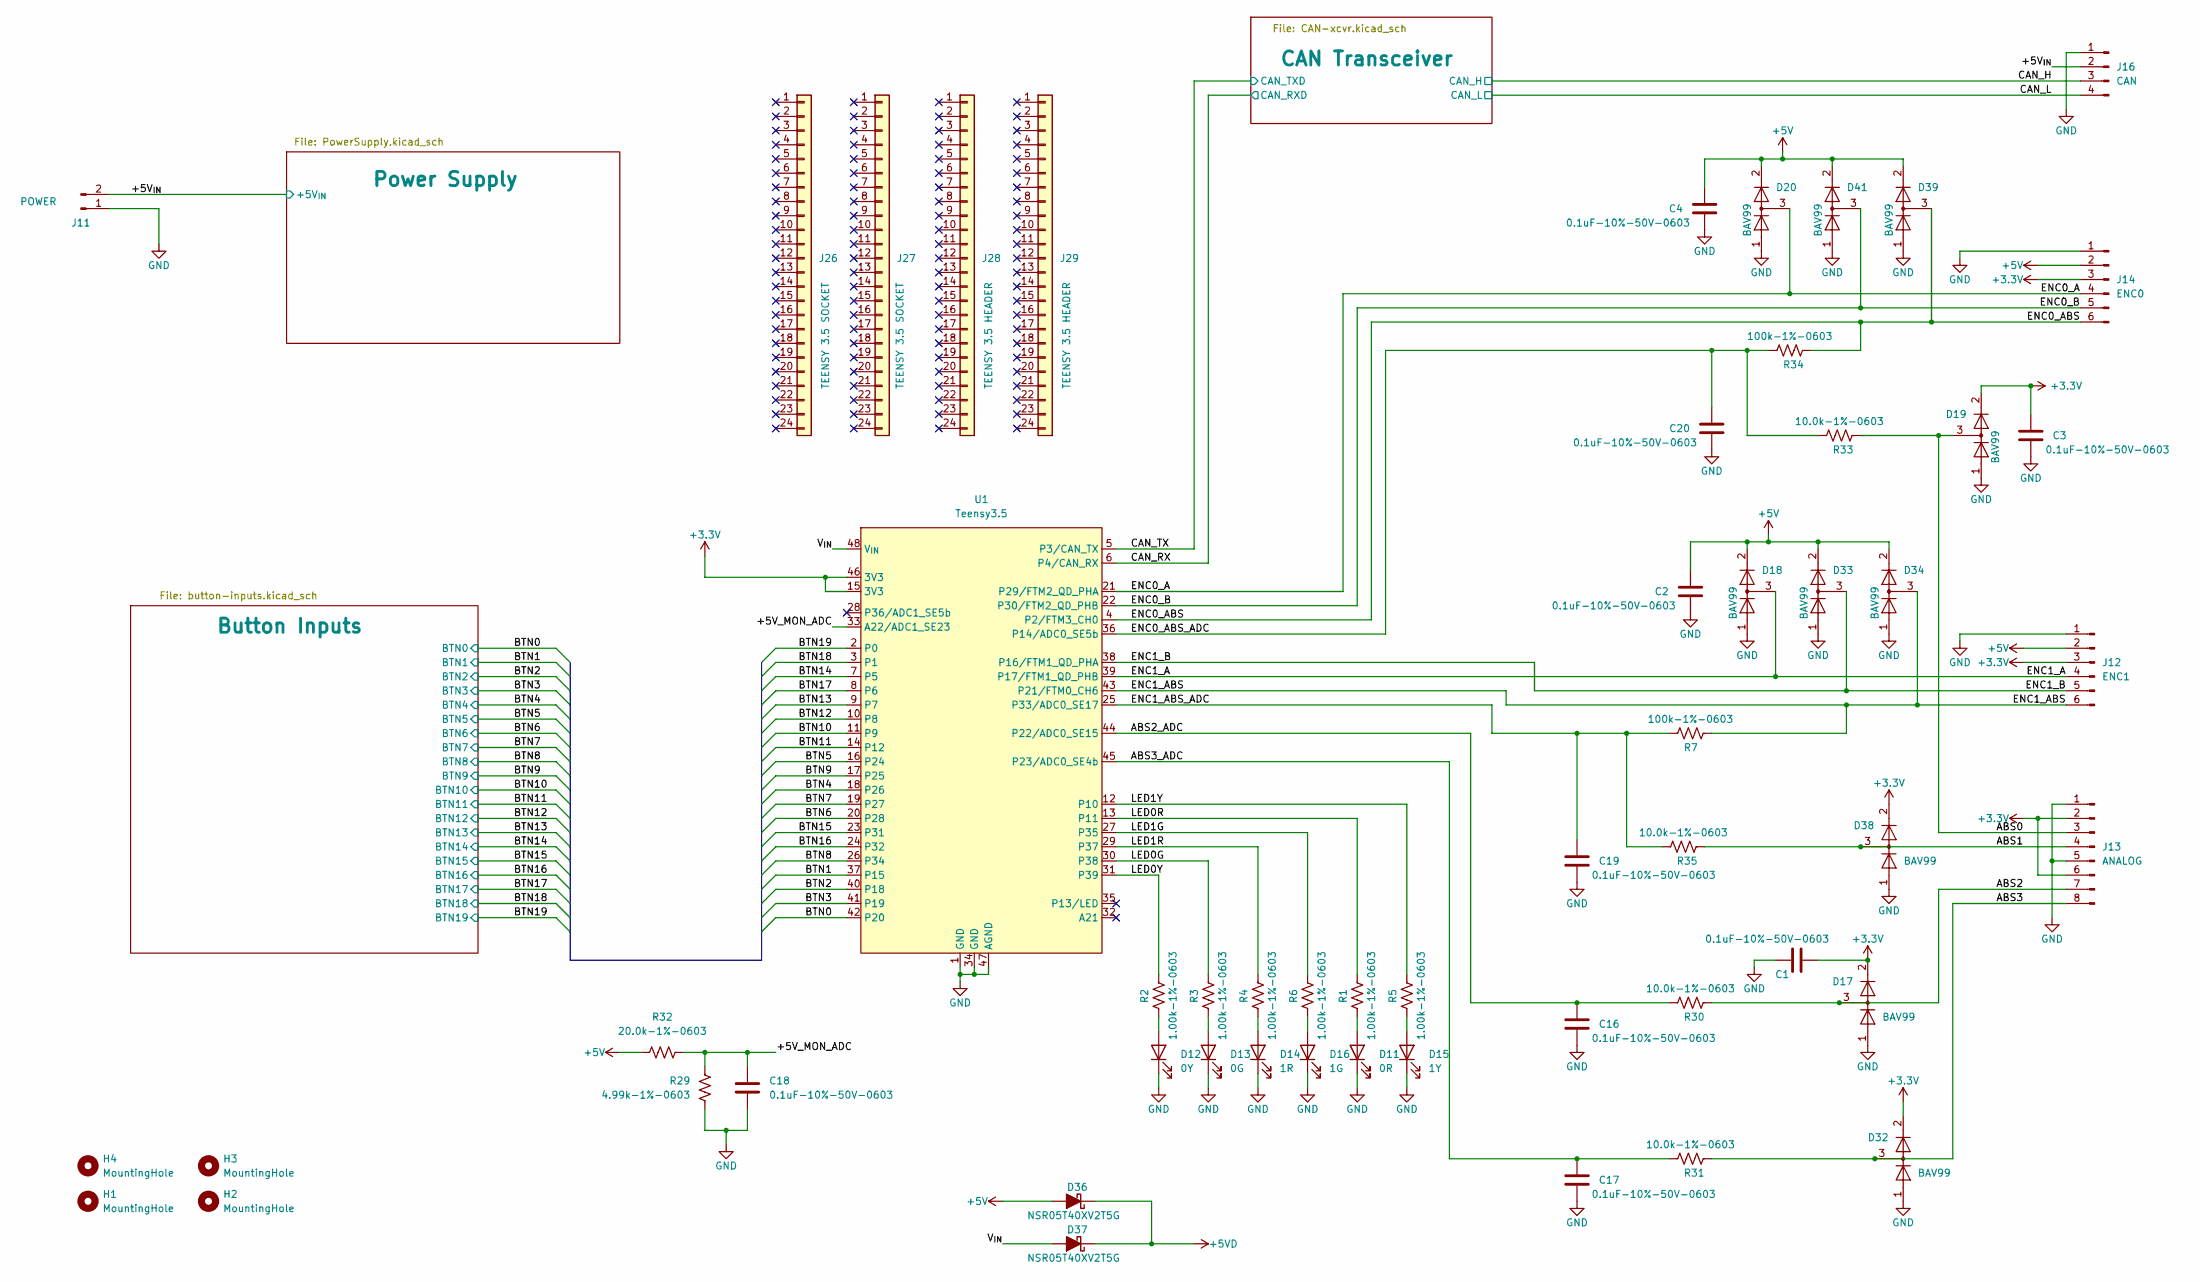
[picture p175: schematic ButtonBd2.kicad_sch, Button Board 2]

Parts:
C1, C2, C3, C4, C16, C17, C18, C19, C20: 0.1uF-10%-50V-0603; C_0603_1608Metric; MFG P/N CL10B104KB8NNNC
D11: 0R; LED_0603_1608Metric; MFG P/N 150060RS75000
D12: 0Y; LED_0603_1608Metric; MFG P/N 150060YS75000
D13: 0G; LED_0603_1608Metric; MFG P/N 150060GS75000
D14: 1R; LED_0603_1608Metric; MFG P/N 150060RS75000
D15: 1Y; LED_0603_1608Metric; MFG P/N 150060YS75000
D16: 1G; LED_0603_1608Metric; MFG P/N 150060GS75000
D17, D18, D19, D20, D32, D33, D34, D38, D39, D41: BAV99; SOT-23; MFG P/N BAV99,235
D36, D37: NSR05T40XV2T5G; D_SOD-523; MFG P/N BAT54KFILM
H1, H2, H3, H4: MountingHole; MountingHole_3.2mm_M3
J11: POWER; 70543-0001; MFG P/N 0705430001
J12: ENC1; 70543-0005; MFG P/N 0705430005
J13: ANALOG; 70543-0007; MFG P/N 0705430007
J14: ENC0; 70543-0005; MFG P/N 0705430005
J16: CAN; 70543-0003; MFG P/N 0705430003
J26, J27: TEENSY 3.5 SOCKET; MFG P/N PPPC241LFBN-RC
J28, J29: TEENSY 3.5 HEADER; MFG P/N 0022284245
R1, R2, R3, R4, R5, R6: 1.00k-1%-0603; R_0603_1608Metric; MFG P/N RNCP0603FTD1K00
R7, R34: 100k-1%-0603; R_0603_1608Metric; MFG P/N RC0603FR-07100KL
R29: 4.99k-1%-0603; R_0603_1608Metric; MFG P/N RMCF0603FT4K99
R30, R31, R33, R35: 10.0k-1%-0603; R_0603_1608Metric; MFG P/N RC0603FR-0710KL
R32: 20.0k-1%-0603; R_0603_1608Metric; MFG P/N RC0603FR-0720KL
U1: Teensy3.5; Teensy-DIP-49_W15.24mm_Socket; MFG P/N TEENSY 3.5

Connections:
+3.3V: C1.2, C3.1, D17.2 (A), D19.2 (A), D32.2 (A), D38.2 (A), J12.3, J13.2, J13.6, J14.3, U1.15 (3V3), U1.46 (3V3); also elsewhere on the board
+5V: C2.1, C4.1, D18.2 (A), D20.2 (A), D33.2 (A), D34.2 (A), D36.2 (A), D39.2 (A), D41.2 (A), J12.2, J14.2, R32.2; also elsewhere on the board
+5VD: D36.1 (K), D37.1 (K); also elsewhere on the board
/+5V_MON_ADC: C18.1, R29.1, R32.1, U1.33 (A22/ADC1_SE23)
/+5V_{IN}: J11.2, J16.2; also elsewhere on the board
/ABS0: D19.3 (K), J13.3, R33.2
/ABS1: D38.3 (K), J13.4, R35.2
/ABS2: D17.3 (K), J13.7, R30.2
/ABS2_ADC: C16.1, R30.1, U1.44 (P22/ADC0_SE15)
/ABS3: D32.3 (K), J13.8, R31.2
/ABS3_ADC: C17.1, R31.1, U1.45 (P23/ADC0_SE4b)
/BTN0: U1.42 (P20); also elsewhere on the board
/BTN1: U1.37 (P15); also elsewhere on the board
/BTN2: U1.40 (P18); also elsewhere on the board
/BTN3: U1.41 (P19); also elsewhere on the board
/BTN4: U1.18 (P26); also elsewhere on the board
/BTN5: U1.16 (P24); also elsewhere on the board
/BTN6: U1.20 (P28); also elsewhere on the board
/BTN7: U1.19 (P27); also elsewhere on the board
/BTN8: U1.26 (P34); also elsewhere on the board
/BTN9: U1.17 (P25); also elsewhere on the board
/BTN10: U1.11 (P9); also elsewhere on the board
/BTN11: U1.14 (P12); also elsewhere on the board
/BTN12: U1.10 (P8); also elsewhere on the board
/BTN13: U1.9 (P7); also elsewhere on the board
/BTN14: U1.7 (P5); also elsewhere on the board
/BTN15: U1.23 (P31); also elsewhere on the board
/BTN16: U1.24 (P32); also elsewhere on the board
/BTN17: U1.8 (P6); also elsewhere on the board
/BTN18: U1.3 (P1); also elsewhere on the board
/BTN19: U1.2 (P0); also elsewhere on the board
/CAN_H: J16.3; also elsewhere on the board
/CAN_L: J16.4; also elsewhere on the board
/CAN_RX: U1.6 (P4/CAN_RX); also elsewhere on the board
/CAN_TX: U1.5 (P3/CAN_TX); also elsewhere on the board
/ENC0_A: D20.3 (K), J14.4, U1.21 (P29/FTM2_QD_PHA)
/ENC0_ABS: D39.3 (K), J14.6, R34.2, U1.4 (P2/FTM3_CH0)
/ENC0_ABS_ADC: C20.1, R33.1, R34.1, U1.36 (P14/ADC0_SE5b)
/ENC0_B: D41.3 (K), J14.5, U1.22 (P30/FTM2_QD_PHB)
/ENC1_A: D18.3 (K), J12.4, U1.39 (P17/FTM1_QD_PHB)
/ENC1_ABS: D34.3 (K), J12.6, R7.2, U1.43 (P21/FTM0_CH6)
/ENC1_ABS_ADC: C19.1, R7.1, R35.1, U1.25 (P33/ADC0_SE17)
/ENC1_B: D33.3 (K), J12.5, U1.38 (P16/FTM1_QD_PHA)
/LED0G: R3.1, U1.30 (P38)
/LED0R: R1.1, U1.13 (P11)
/LED0Y: R2.1, U1.31 (P39)
/LED1G: R6.1, U1.27 (P35)
/LED1R: R4.1, U1.29 (P37)
/LED1Y: R5.1, U1.12 (P10)
/V_{IN}: D37.2 (A), U1.48 (V_{IN})
GND: C1.1, C2.2, C3.2, C4.2, C16.2, C17.2, C18.2, C19.2, C20.2, D11.1 (K), D12.1 (K), D13.1 (K), D14.1 (K), D15.1 (K), D16.1 (K), D17.1 (K), D18.1 (K), D19.1 (K), D20.1 (K), D32.1 (K), D33.1 (K), D34.1 (K), D38.1 (K), D39.1 (K), D41.1 (K), J11.1, J12.1, J13.1, J13.5, J14.1, J16.1, R29.2, U1.1 (GND), U1.34 (GND), U1.47 (AGND); also elsewhere on the board
unnamed: D11.2 (A), R1.2
unnamed: D12.2 (A), R2.2
unnamed: D13.2 (A), R3.2
unnamed: D14.2 (A), R4.2
unnamed: D15.2 (A), R5.2
unnamed: D16.2 (A), R6.2

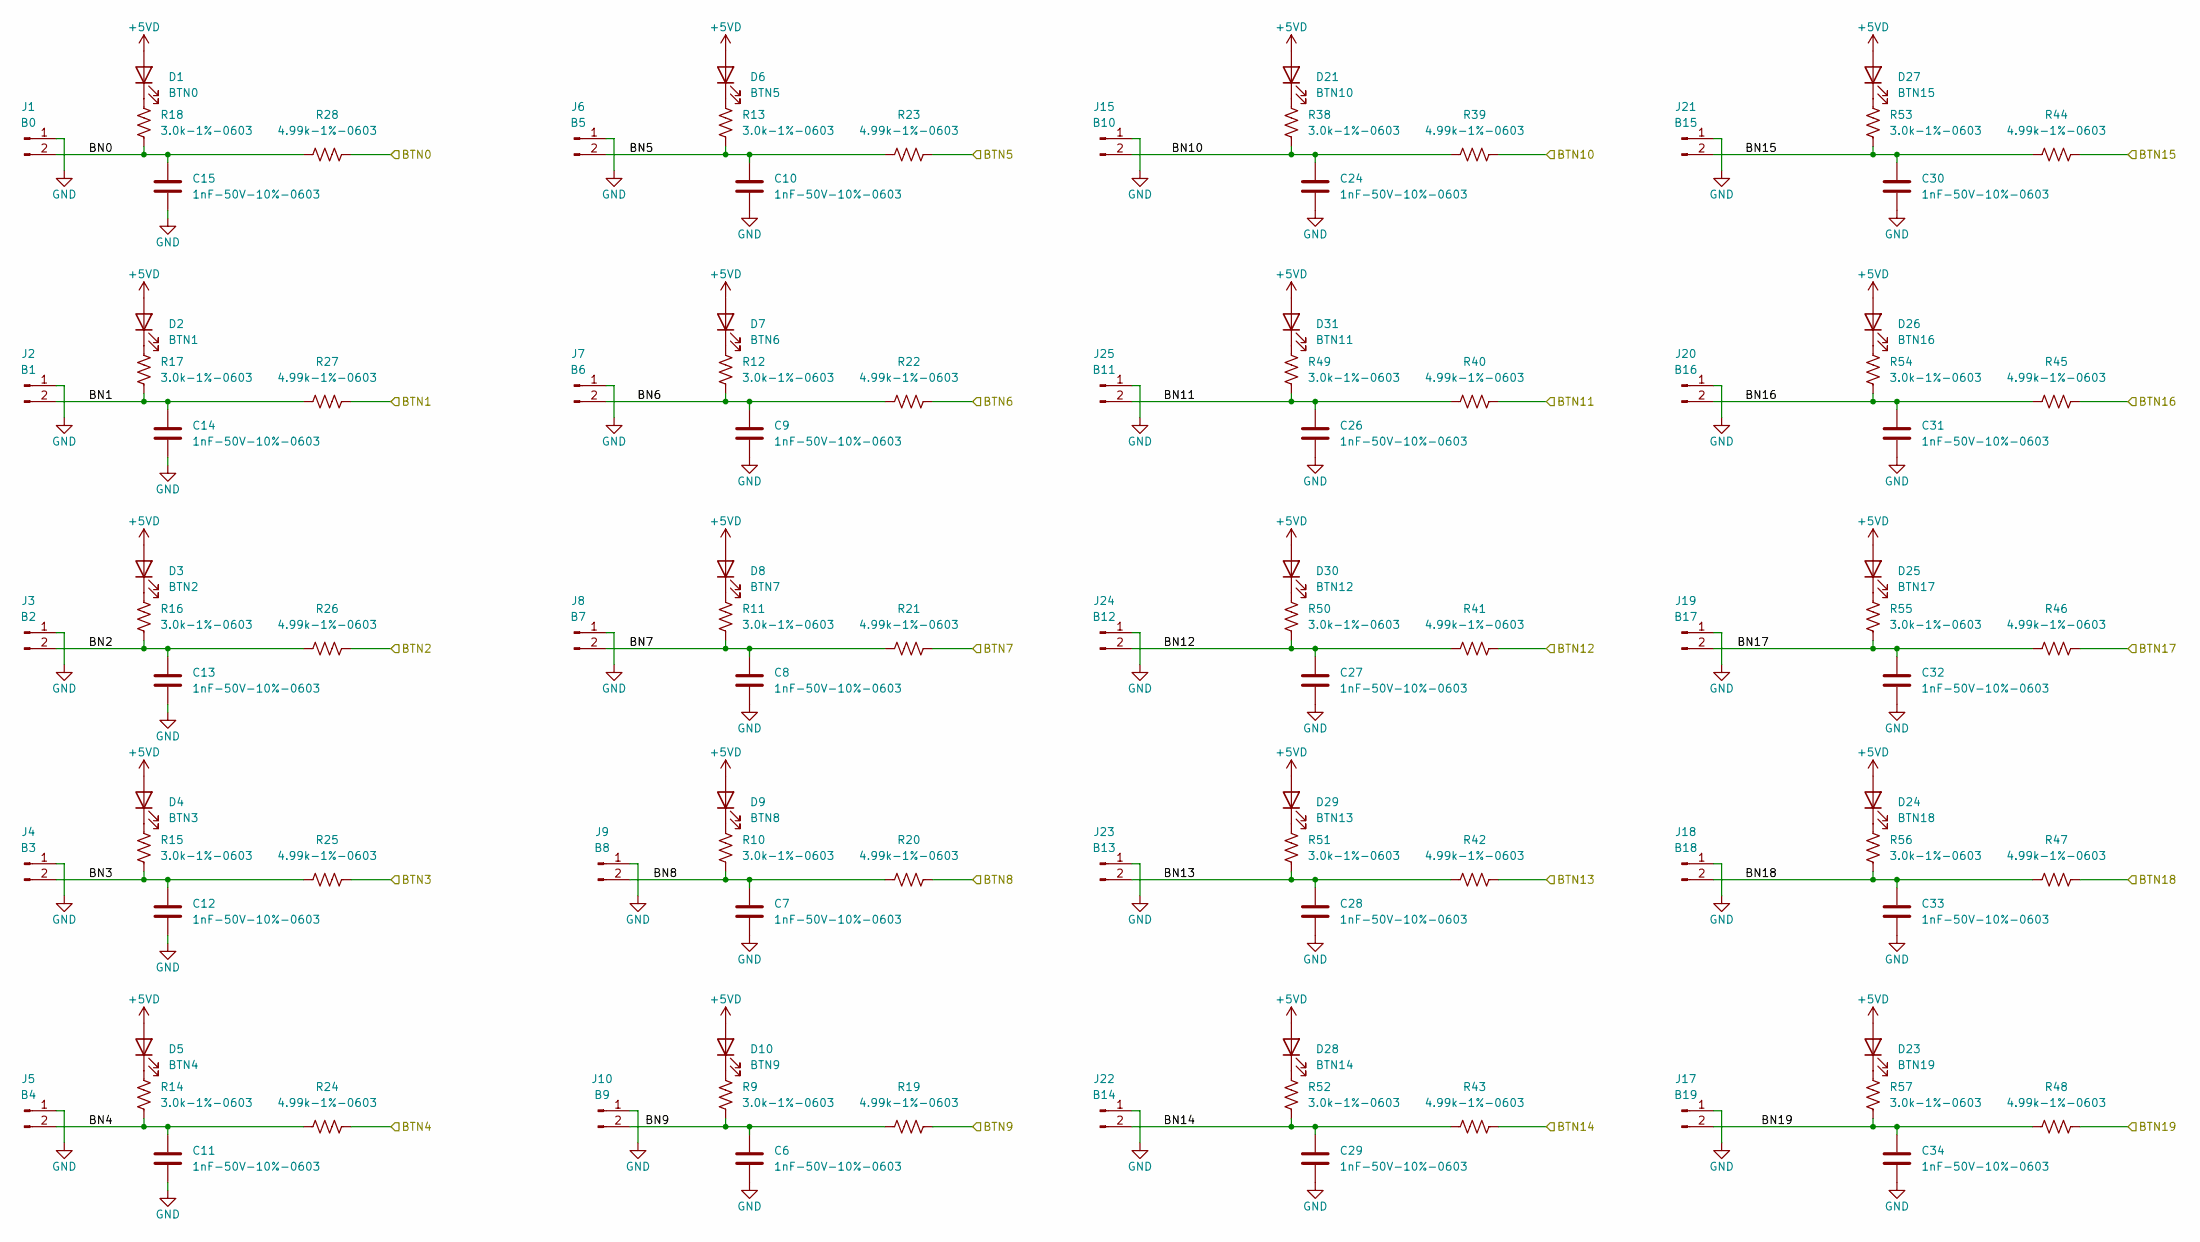
[picture p176: schematic button-inputs.kicad_sch, Button Board 2]

Parts:
C6, C7, C8, C9, C10, C11, C12, C13, C14, C15, C24, C26, C27, C28, C29, C30, C31, C32, C33, C34: 1nF-50V-10%-0603; C_0603_1608Metric; MFG P/N CL10B102KB8NNNC
D1: BTN0; LED_0603_1608Metric; MFG P/N 150060YS75000
D2: BTN1; LED_0603_1608Metric; MFG P/N 150060YS75000
D3: BTN2; LED_0603_1608Metric; MFG P/N 150060YS75000
D4: BTN3; LED_0603_1608Metric; MFG P/N 150060YS75000
D5: BTN4; LED_0603_1608Metric; MFG P/N 150060YS75000
D6: BTN5; LED_0603_1608Metric; MFG P/N 150060YS75000
D7: BTN6; LED_0603_1608Metric; MFG P/N 150060YS75000
D8: BTN7; LED_0603_1608Metric; MFG P/N 150060YS75000
D9: BTN8; LED_0603_1608Metric; MFG P/N 150060YS75000
D10: BTN9; LED_0603_1608Metric; MFG P/N 150060YS75000
D21: BTN10; LED_0603_1608Metric; MFG P/N 150060YS75000
D23: BTN19; LED_0603_1608Metric; MFG P/N 150060YS75000
D24: BTN18; LED_0603_1608Metric; MFG P/N 150060YS75000
D25: BTN17; LED_0603_1608Metric; MFG P/N 150060YS75000
D26: BTN16; LED_0603_1608Metric; MFG P/N 150060YS75000
D27: BTN15; LED_0603_1608Metric; MFG P/N 150060YS75000
D28: BTN14; LED_0603_1608Metric; MFG P/N 150060YS75000
D29: BTN13; LED_0603_1608Metric; MFG P/N 150060YS75000
D30: BTN12; LED_0603_1608Metric; MFG P/N 150060YS75000
D31: BTN11; LED_0603_1608Metric; MFG P/N 150060YS75000
J1: B0; 70543-0001; MFG P/N 0705430001
J2: B1; 70543-0001; MFG P/N 0705430001
J3: B2; 70543-0001; MFG P/N 0705430001
J4: B3; 70543-0001; MFG P/N 0705430001
J5: B4; 70543-0001; MFG P/N 0705430001
J6: B5; 70543-0001; MFG P/N 0705430001
J7: B6; 70543-0001; MFG P/N 0705430001
J8: B7; 70543-0001; MFG P/N 0705430001
J9: B8; 70543-0001; MFG P/N 0705430001
J10: B9; 70543-0001; MFG P/N 0705430001
J15: B10; 70543-0001; MFG P/N 0705430001
J17: B19; 70543-0001; MFG P/N 0705430001
J18: B18; 70543-0001; MFG P/N 0705430001
J19: B17; 70543-0001; MFG P/N 0705430001
J20: B16; 70543-0001; MFG P/N 0705430001
J21: B15; 70543-0001; MFG P/N 0705430001
J22: B14; 70543-0001; MFG P/N 0705430001
J23: B13; 70543-0001; MFG P/N 0705430001
J24: B12; 70543-0001; MFG P/N 0705430001
J25: B11; 70543-0001; MFG P/N 0705430001
R9, R10, R11, R12, R13, R14, R15, R16, R17, R18, R38, R49, R50, R51, R52, R53, R54, R55, R56, R57: 3.0k-1%-0603; R_0603_1608Metric; MFG P/N RC0603FR-073KL
R19, R20, R21, R22, R23, R24, R25, R26, R27, R28, R39, R40, R41, R42, R43, R44, R45, R46, R47, R48: 4.99k-1%-0603; R_0603_1608Metric; MFG P/N RMCF0603FT4K99

Connections:
+5VD: D1.2 (A), D2.2 (A), D3.2 (A), D4.2 (A), D5.2 (A), D6.2 (A), D7.2 (A), D8.2 (A), D9.2 (A), D10.2 (A), D21.2 (A), D23.2 (A), D24.2 (A), D25.2 (A), D26.2 (A), D27.2 (A), D28.2 (A), D29.2 (A), D30.2 (A), D31.2 (A); also elsewhere on the board
/BTN0: R28.2; also elsewhere on the board
/BTN1: R27.2; also elsewhere on the board
/BTN2: R26.2; also elsewhere on the board
/BTN3: R25.2; also elsewhere on the board
/BTN4: R24.2; also elsewhere on the board
/BTN5: R23.2; also elsewhere on the board
/BTN6: R22.2; also elsewhere on the board
/BTN7: R21.2; also elsewhere on the board
/BTN8: R20.2; also elsewhere on the board
/BTN9: R19.2; also elsewhere on the board
/BTN10: R39.2; also elsewhere on the board
/BTN11: R40.2; also elsewhere on the board
/BTN12: R41.2; also elsewhere on the board
/BTN13: R42.2; also elsewhere on the board
/BTN14: R43.2; also elsewhere on the board
/BTN15: R44.2; also elsewhere on the board
/BTN16: R45.2; also elsewhere on the board
/BTN17: R46.2; also elsewhere on the board
/BTN18: R47.2; also elsewhere on the board
/BTN19: R48.2; also elsewhere on the board
/Button Inputs/BN0: C15.1, J1.2, R18.2, R28.1
/Button Inputs/BN1: C14.1, J2.2, R17.2, R27.1
/Button Inputs/BN2: C13.1, J3.2, R16.2, R26.1
/Button Inputs/BN3: C12.1, J4.2, R15.2, R25.1
/Button Inputs/BN4: C11.1, J5.2, R14.2, R24.1
/Button Inputs/BN5: C10.1, J6.2, R13.2, R23.1
/Button Inputs/BN6: C9.1, J7.2, R12.2, R22.1
/Button Inputs/BN7: C8.1, J8.2, R11.2, R21.1
/Button Inputs/BN8: C7.1, J9.2, R10.2, R20.1
/Button Inputs/BN9: C6.1, J10.2, R9.2, R19.1
/Button Inputs/BN10: C24.1, J15.2, R38.2, R39.1
/Button Inputs/BN11: C26.1, J25.2, R40.1, R49.2
/Button Inputs/BN12: C27.1, J24.2, R41.1, R50.2
/Button Inputs/BN13: C28.1, J23.2, R42.1, R51.2
/Button Inputs/BN14: C29.1, J22.2, R43.1, R52.2
/Button Inputs/BN15: C30.1, J21.2, R44.1, R53.2
/Button Inputs/BN16: C31.1, J20.2, R45.1, R54.2
/Button Inputs/BN17: C32.1, J19.2, R46.1, R55.2
/Button Inputs/BN18: C33.1, J18.2, R47.1, R56.2
/Button Inputs/BN19: C34.1, J17.2, R48.1, R57.2
GND: C6.2, C7.2, C8.2, C9.2, C10.2, C11.2, C12.2, C13.2, C14.2, C15.2, C24.2, C26.2, C27.2, C28.2, C29.2, C30.2, C31.2, C32.2, C33.2, C34.2, J1.1, J2.1, J3.1, J4.1, J5.1, J6.1, J7.1, J8.1, J9.1, J10.1, J15.1, J17.1, J18.1, J19.1, J20.1, J21.1, J22.1, J23.1, J24.1, J25.1; also elsewhere on the board
unnamed: D1.1 (K), R18.1
unnamed: D2.1 (K), R17.1
unnamed: D3.1 (K), R16.1
unnamed: D4.1 (K), R15.1
unnamed: D5.1 (K), R14.1
unnamed: D6.1 (K), R13.1
unnamed: D7.1 (K), R12.1
unnamed: D8.1 (K), R11.1
unnamed: D9.1 (K), R10.1
unnamed: D10.1 (K), R9.1
unnamed: D21.1 (K), R38.1
unnamed: D23.1 (K), R57.1
unnamed: D24.1 (K), R56.1
unnamed: D25.1 (K), R55.1
unnamed: D26.1 (K), R54.1
unnamed: D27.1 (K), R53.1
unnamed: D28.1 (K), R52.1
unnamed: D29.1 (K), R51.1
unnamed: D30.1 (K), R50.1
unnamed: D31.1 (K), R49.1

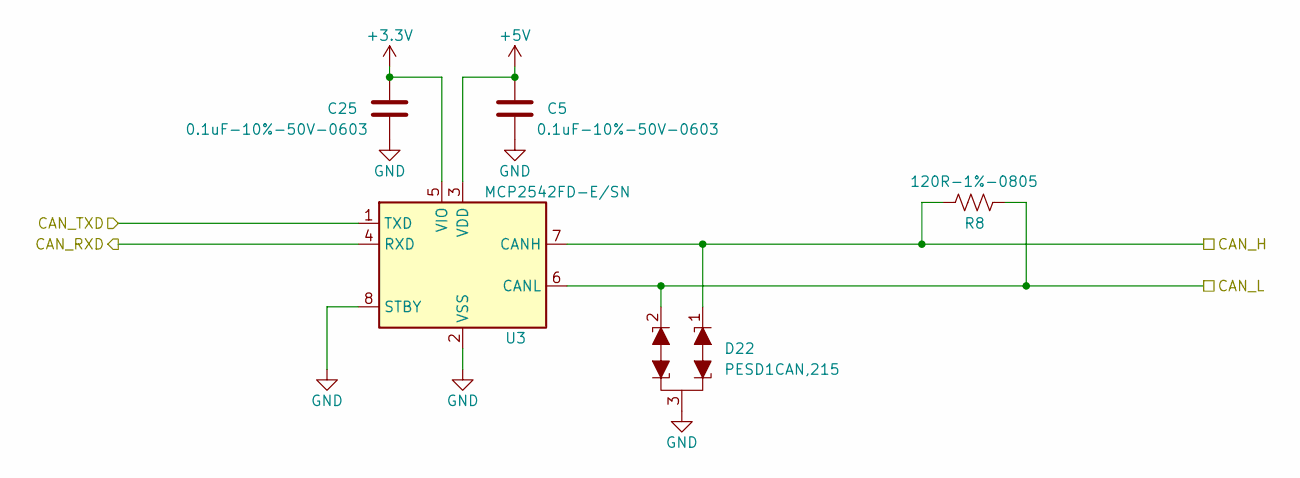
[picture p177: schematic CAN-xcvr.kicad_sch, Button Board 2]

Parts:
C5, C25: 0.1uF-10%-50V-0603; C_0603_1608Metric; MFG P/N CL10B104KB8NNNC
D22: PESD1CAN; SOT-23; MFG P/N PESD1CAN,215
R8: 120R-1%-0805; R_0805_2012Metric; MFG P/N RMCF0805FT120R
U3: MCP2542FD-E/SN; SO-8_3.9x4.9mm_P1.27mm; MFG P/N MCP2542FD-E/SN

Connections:
+3.3V: C25.1, U3.5 (VIO); also elsewhere on the board
+5V: C5.1, U3.3 (VDD); also elsewhere on the board
/CAN_H: D22.1 (K1), R8.1, U3.7 (CANH); also elsewhere on the board
/CAN_L: D22.2 (K1), R8.2, U3.6 (CANL); also elsewhere on the board
/CAN_RX: U3.4 (RXD); also elsewhere on the board
/CAN_TX: U3.1 (TXD); also elsewhere on the board
GND: C5.2, C25.2, D22.3 (KK), U3.2 (VSS), U3.8 (STBY); also elsewhere on the board

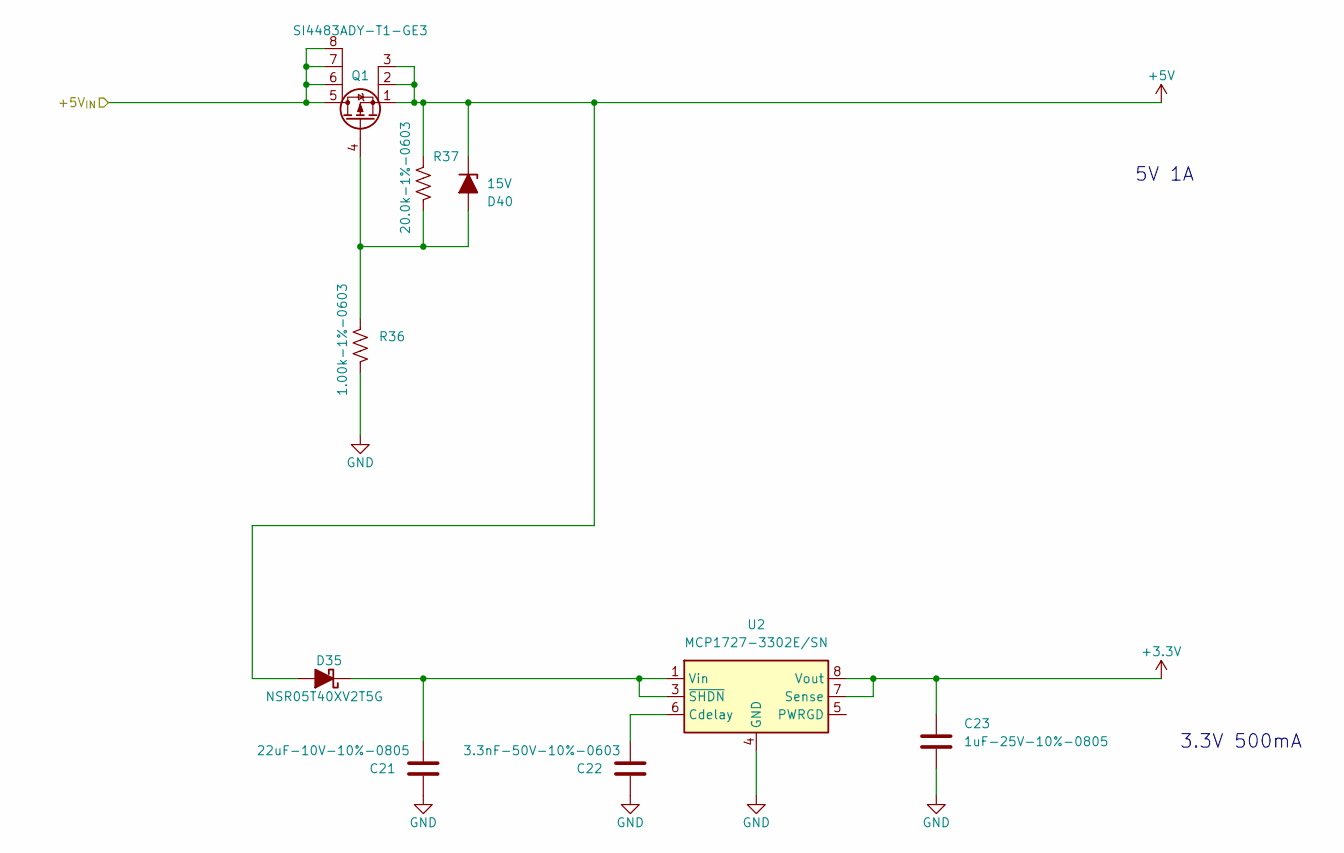
[picture p178: schematic PowerSupply.kicad_sch, Button Board 2]

Parts:
C21: 22uF-10V-10%-0805; C_0805_2012Metric; MFG P/N CL21A226KPCLRNC
C22: 3.3nF-50V-10%-0603; C_0603_1608Metric; MFG P/N CL10B332KB8NNNC
C23: 1uF-25V-10%-0805; C_0805_2012Metric; MFG P/N CL21B105KAFNNNE
D35: NSR05T40XV2T5G; D_SOD-523; MFG P/N BAT54KFILM
D40: 15V; D_SOD-123F; MFG P/N BZT52H-C15,115
Q1: SI4483ADY-T1-GE3; SOIC-8_3.9x4.9mm_P1.27mm; MFG P/N SI4483ADY-T1-GE3
R36: 1.00k-1%-0603; R_0603_1608Metric; MFG P/N RNCP0603FTD1K00
R37: 20.0k-1%-0603; R_0603_1608Metric; MFG P/N RC0603FR-0720KL
U2: MCP1727-3302E/SN; SOIC-8_3.9x4.9mm_P1.27mm; MFG P/N MCP1727-3302E/SN

Connections:
+3.3V: C23.1, U2.7 (Sense), U2.8 (Vout); also elsewhere on the board
+5V: D35.2 (A), D40.1 (K), Q1.1 (S), Q1.2 (S), Q1.3 (S), R37.2; also elsewhere on the board
/+5V_{IN}: Q1.5 (D), Q1.6 (D), Q1.7 (D), Q1.8 (D); also elsewhere on the board
GND: C21.2, C22.2, C23.2, R36.1, U2.4 (GND); also elsewhere on the board
unnamed: C21.1, D35.1 (K), U2.1 (Vin), U2.2 (Vin), U2.3 (~SHDN)
unnamed: D40.2 (A), Q1.4 (G), R36.2, R37.1
unnamed: C22.1, U2.6 (Cdelay)

Notes on the sheet:
3.3V 500mA
5V 1A

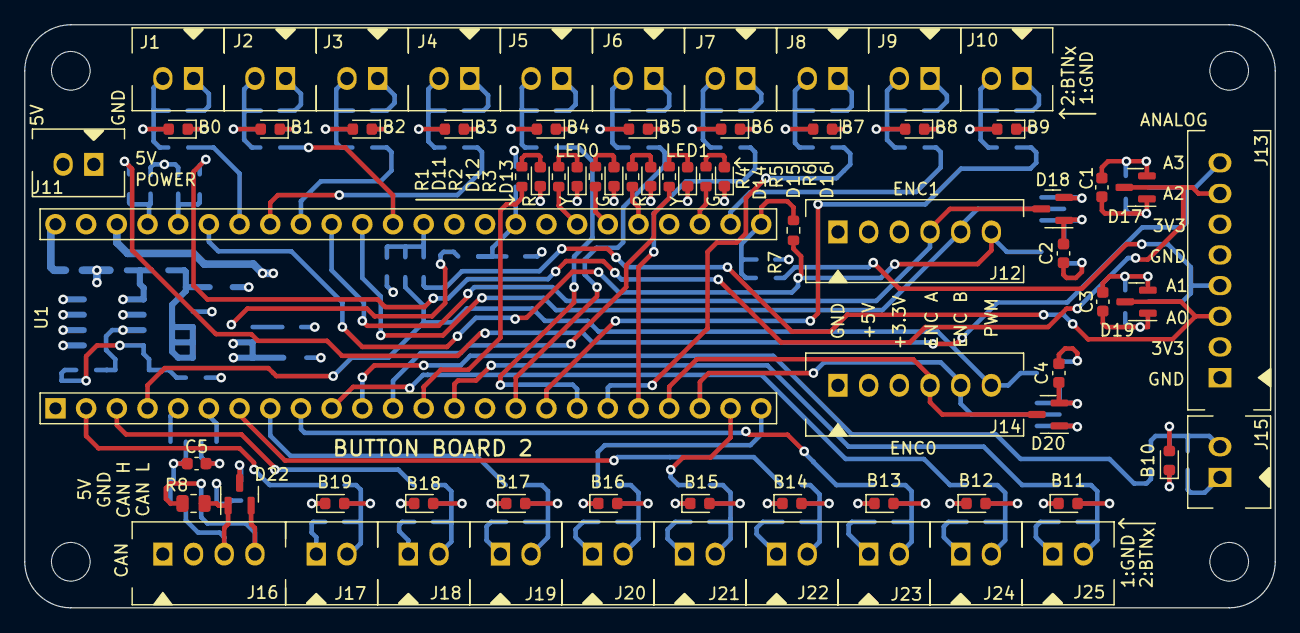
[picture p179: board ButtonBd2.kicad_pcb from above]

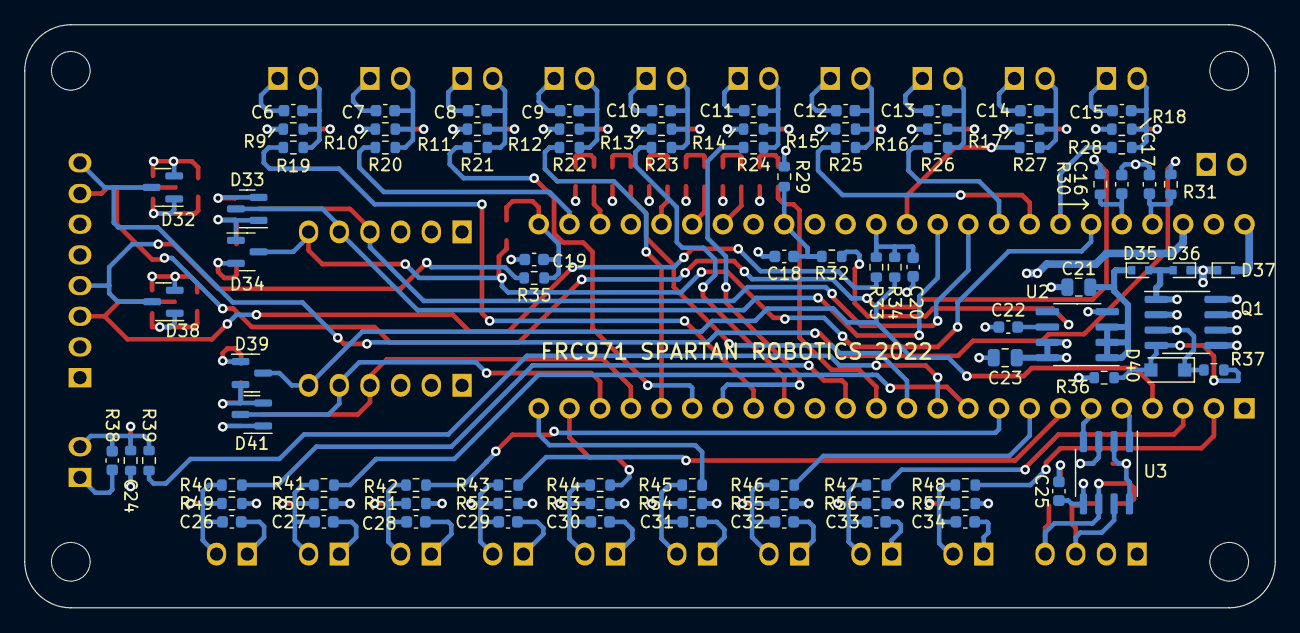
[picture p180: board ButtonBd2.kicad_pcb from below]

Board: 4 copper layers, 103.5 x 48.3 mm, 165 parts (91 on the bottom side), 100 nets.
