frc971/electrical/circuit-boards/connector_boards/kraken-can-adapter-V2/kraken-can-adapter.kicad_pcb

## KiCad design circuit-boards/connector_boards/kraken-can-adapter-V2/kraken-can-adapter.kicad_pcb (2024-06-22)

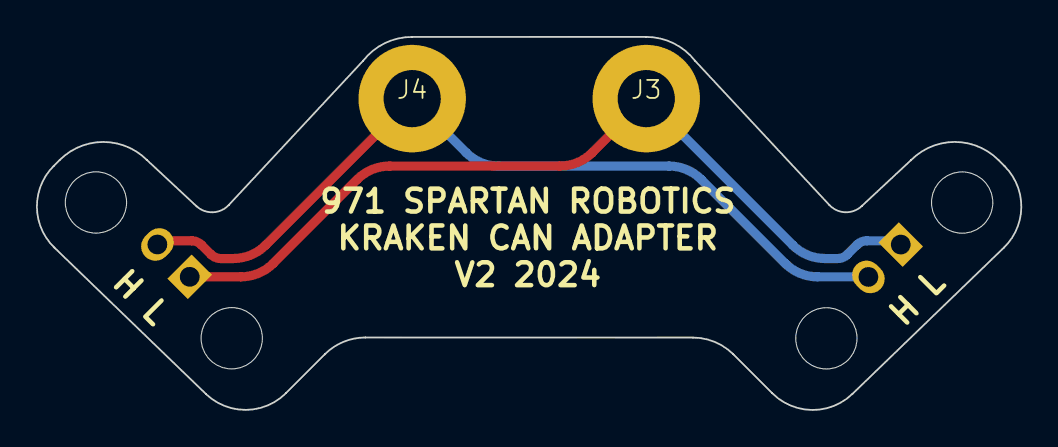
[picture p181: board kraken-can-adapter.kicad_pcb from above]

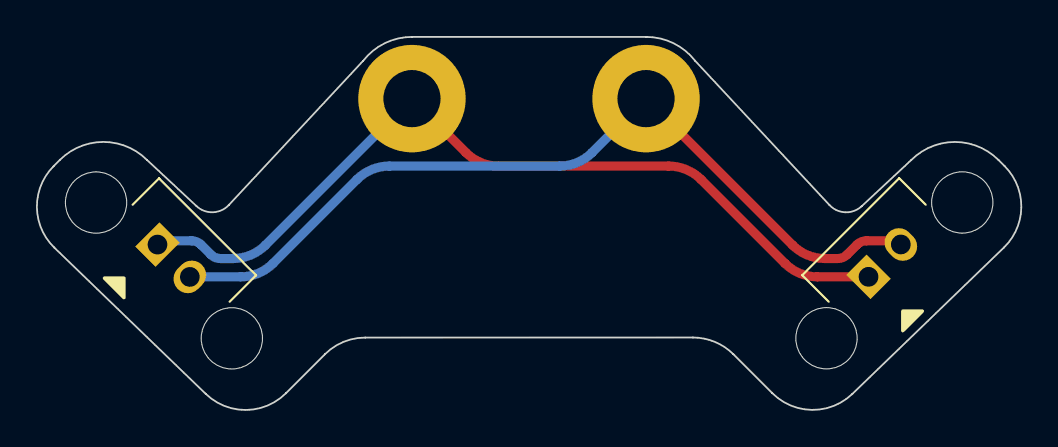
[picture p182: board kraken-can-adapter.kicad_pcb from below]

Board: 2 copper layers, 54.7 x 20.7 mm, 4 parts (2 on the bottom side), 2 nets.

Parts:
J1, J2: CAN; 70541-0001
J3: CAN_L; ScrewTerminal-#4
J4: CAN_H; ScrewTerminal-#4

Connections:
/CAN_H: J1.2, J2.2, J4.1
/CAN_L: J1.1, J2.1, J3.1
