frc971/electrical/circuit-boards/connector_boards/encoder_adapter/encoder_adapter.kicad_pcb

## KiCad design circuit-boards/connector_boards/encoder_adapter/encoder_adapter.kicad_pcb (2024-01-21)

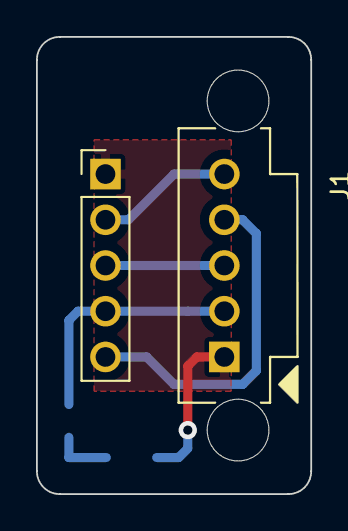
[picture p183: board encoder_adapter.kicad_pcb from above]

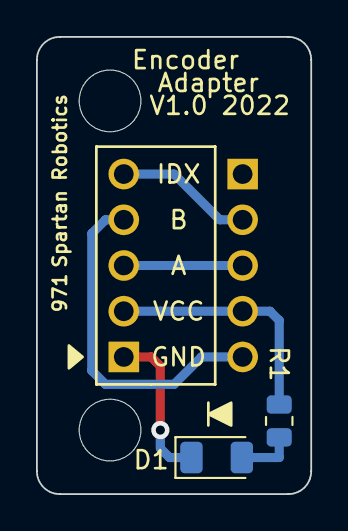
[picture p184: board encoder_adapter.kicad_pcb from below]

Board: 2 copper layers, 15.2 x 25.4 mm, 4 parts (2 on the bottom side), 6 nets.

Parts:
D1: LED; LED_1206_3216Metric
J1: Encoder; MOLEX_0705410074
J2: Conn_01x05_Male; PinHeader_1x05_P2.54mm_Vertical
R1: R; R_0805_2012Metric

Connections:
/A: J1.3, J2.3
/B: J1.4, J2.5
/GND: D1.1 (K), J1.1, J2.1
/IDX: J1.5, J2.2
/VCC: J1.2, J2.4, R1.1
unnamed: D1.2 (A), R1.2
