frc971/electrical/circuit-boards/Orin-NX-PCBs/NX-ButtonInterface/NX-ButtonInterface.kicad_pcb

## KiCad design circuit-boards/Orin-NX-PCBs/NX-ButtonInterface/NX-ButtonInterface.kicad_pcb (2024-01-07, an earlier design)

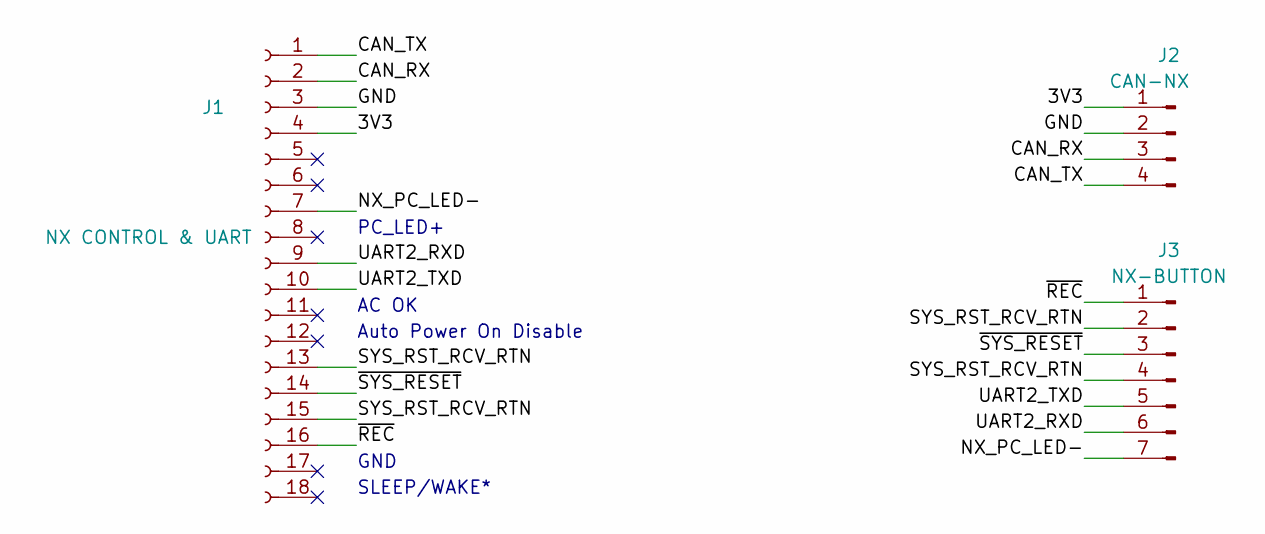
[picture p185: schematic NX-ButtonInterface.kicad_sch, Button Interface]

Parts:
J1: NX CONTROL & UART; PinSocket_1x18_P2.54mm_Vertical; MFG P/N PPTC181LFBN-RC
J2: CAN-NX; 4-pin-solder-pads
J3: NX-BUTTON; 7-pin-solder-pads

Connections:
/3V3: J1.4, J2.1
/CAN_RX: J1.2, J2.3
/CAN_TX: J1.1, J2.4
/GND: J1.3, J2.2
/NX_PC_LED-: J1.7, J3.7
/SYS_RST_RCV_RTN: J1.13, J1.15, J3.2, J3.4
/UART2_RXD: J1.9, J3.6
/UART2_TXD: J1.10, J3.5
/~REC: J1.16, J3.1
/~SYS_RESET: J1.14, J3.3

Notes on the sheet:
AC OK
GND
PC_LED+
Auto Power On Disable
SLEEP/WAKE*
