frc971/electrical/circuit-boards/Orin-NX-PCBs/NX-ButtonInterface/NX-ButtonInterface.kicad_pcb

## KiCad design circuit-boards/Orin-NX-PCBs/NX-ButtonInterface/NX-ButtonInterface.kicad_pcb (continued)

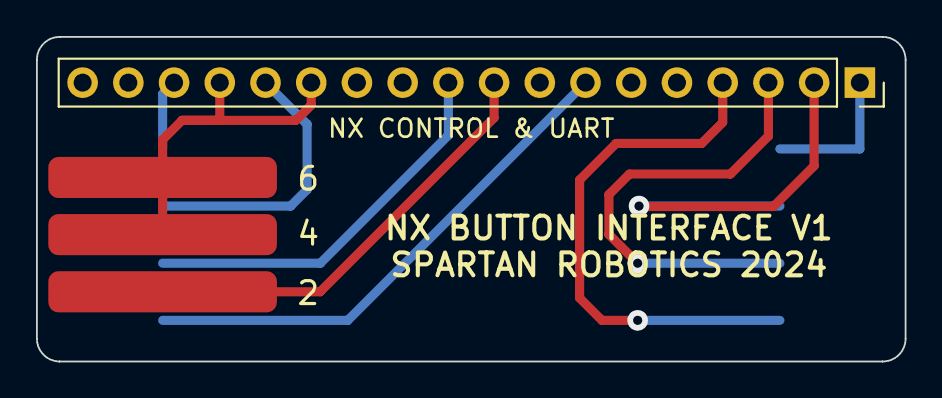
[picture p186: board circuit-boards/Orin-NX-PCBs/NX-ButtonInterface/NX-ButtonInterface.kic… from above]

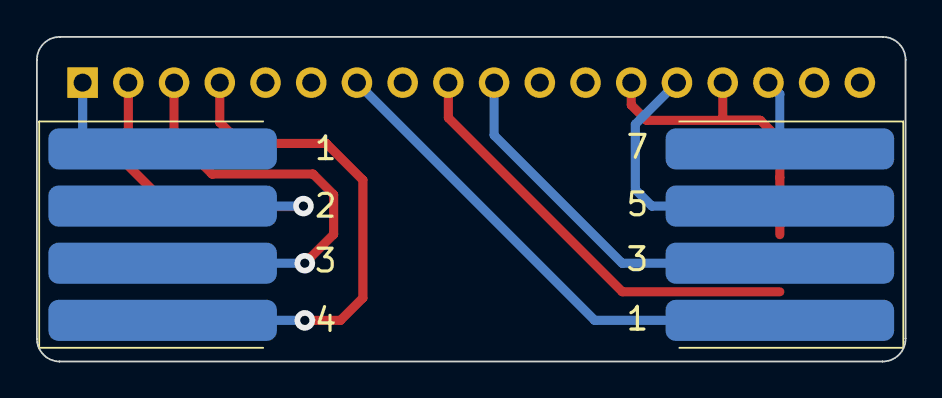
[picture p187: board circuit-boards/Orin-NX-PCBs/NX-ButtonInterface/NX-ButtonInterface.kic… from below]

Board: 2 copper layers, 48.3 x 18.0 mm, 3 parts (2 on the bottom side), 10 nets.
