frc971/electrical/circuit-boards/connector_boards/kraken-power-adapter/kraken-power-adapter.kicad_pcb

## KiCad design circuit-boards/connector_boards/kraken-power-adapter/kraken-power-adapter.kicad_pcb (2024-01-02)

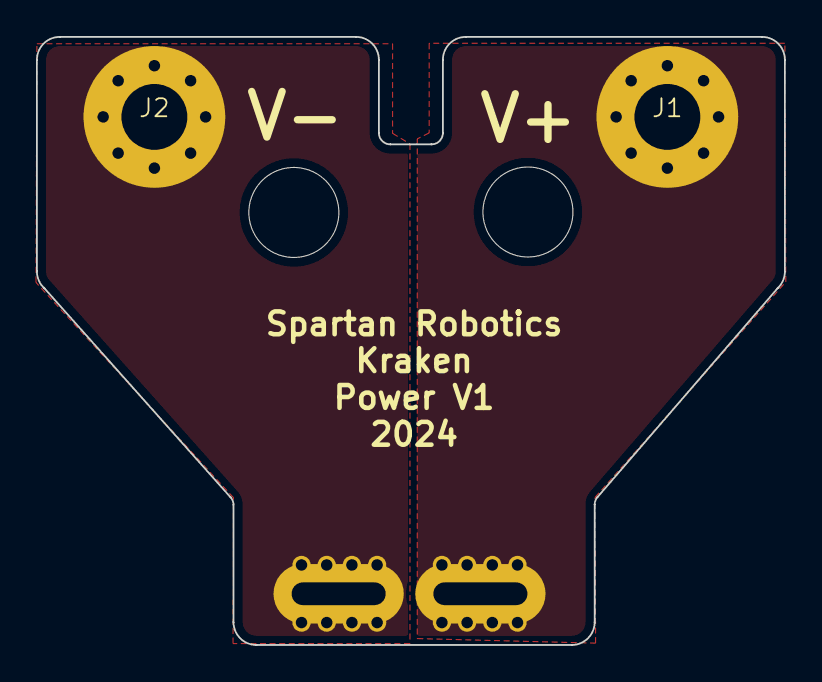
[picture p188: board kraken-power-adapter.kicad_pcb from above]

Board: 4 copper layers, 41.6 x 33.8 mm, 5 parts (1 on the bottom side), 2 nets.

Parts:
H1, H2: CAN Screw Clearance Hole; MountingHole_5mm
J1: Vbat+; ScrewTerminal-#6
J2: Vbat-; ScrewTerminal-#6
J3: Vbat PP15-45; Dual-side-by-side-1335G1

Connections:
/Vbat+: J1.1, J3.2
/Vbat-: J2.1, J3.1
