frc971/electrical/circuit-boards/Orin-NX-PCBs/MIPI2HDMI/MIPI2HDMI.kicad_pcb

## KiCad design circuit-boards/Orin-NX-PCBs/MIPI2HDMI/MIPI2HDMI.kicad_pcb (2023-12-23)

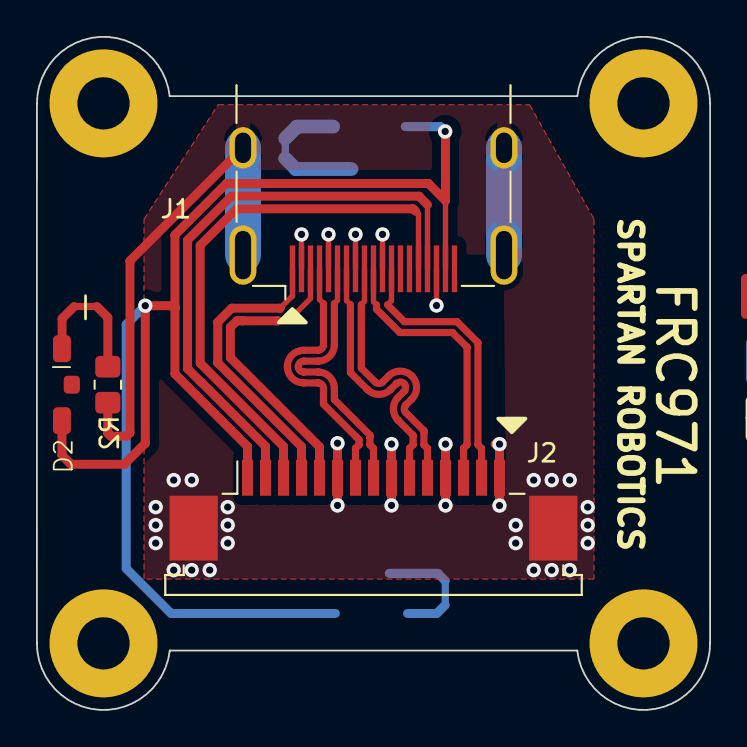
[picture p191: board MIPI2HDMI.kicad_pcb from above]

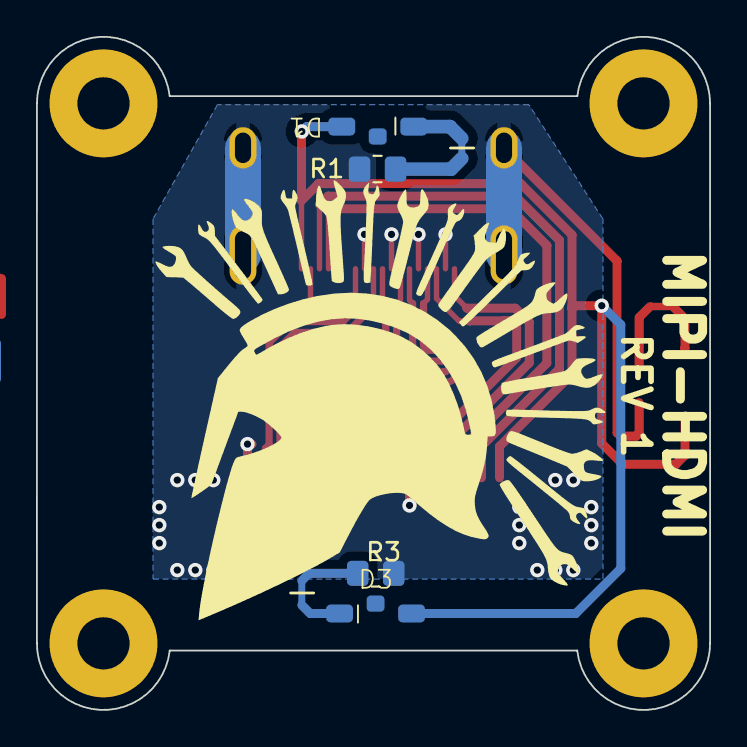
[picture p192: board MIPI2HDMI.kicad_pcb from below]

Board: 2 copper layers, 37.4 x 37.4 mm, 12 parts (4 on the bottom side), 15 nets.

Parts:
D1, D2, D3: LED; SM1204PGC
H1, H2, H3, H4: M2.5 Mounting Hole; MountingHole_2.7mm_Pad
J1: HDMI; HDMI_A_Molex_208658-1001_Horizontal
J2: 1-84953-5; TE_1-84953-5_1x15-1MP_P1.0mm_Horizontal
R1, R2, R3: 60; R_0805_2012Metric_Pad1.20x1.40mm_HandSolder

Connections:
+3V3: D1.1 (A), D2.1 (A), D3.1 (A), J1.18 (+5V), J2.15
/CAM_CK_N: J1.6 (D1-), J2.8
/CAM_CK_P: J1.4 (D1+), J2.9
/CAM_D0_N: J1.12 (CK-), J2.2
/CAM_D0_P: J1.10 (CK+), J2.3
/CAM_D1_N: J1.9 (D0-), J2.5
/CAM_D1_P: J1.7 (D0+), J2.6
/CAM_MCLK: J1.1 (D2+), J2.12
/CAM_SCL: J1.15 (SCL), J2.13
/CAM_SDA: J1.16 (SDA), J2.14
/PWR_DN_LS: J1.3 (D2-), J2.11
GND: J1.2 (D2S), J1.5 (D1S), J1.8 (D0S), J1.11 (CKS), J1.17 (GND), J1.SH, J2.1, J2.4, J2.7, J2.10, J2.16, J2.17, R1.2, R2.2, R3.2
unnamed: D1.2 (K), R1.1
unnamed: D2.2 (K), R2.1
unnamed: D3.2 (K), R3.1
