frc971/electrical/circuit-boards/RspPiPicoIMU/RspPiPicoIMU.kicad_pcb

## KiCad design circuit-boards/RspPiPicoIMU/RspPiPicoIMU.kicad_pcb (2023-12-23)

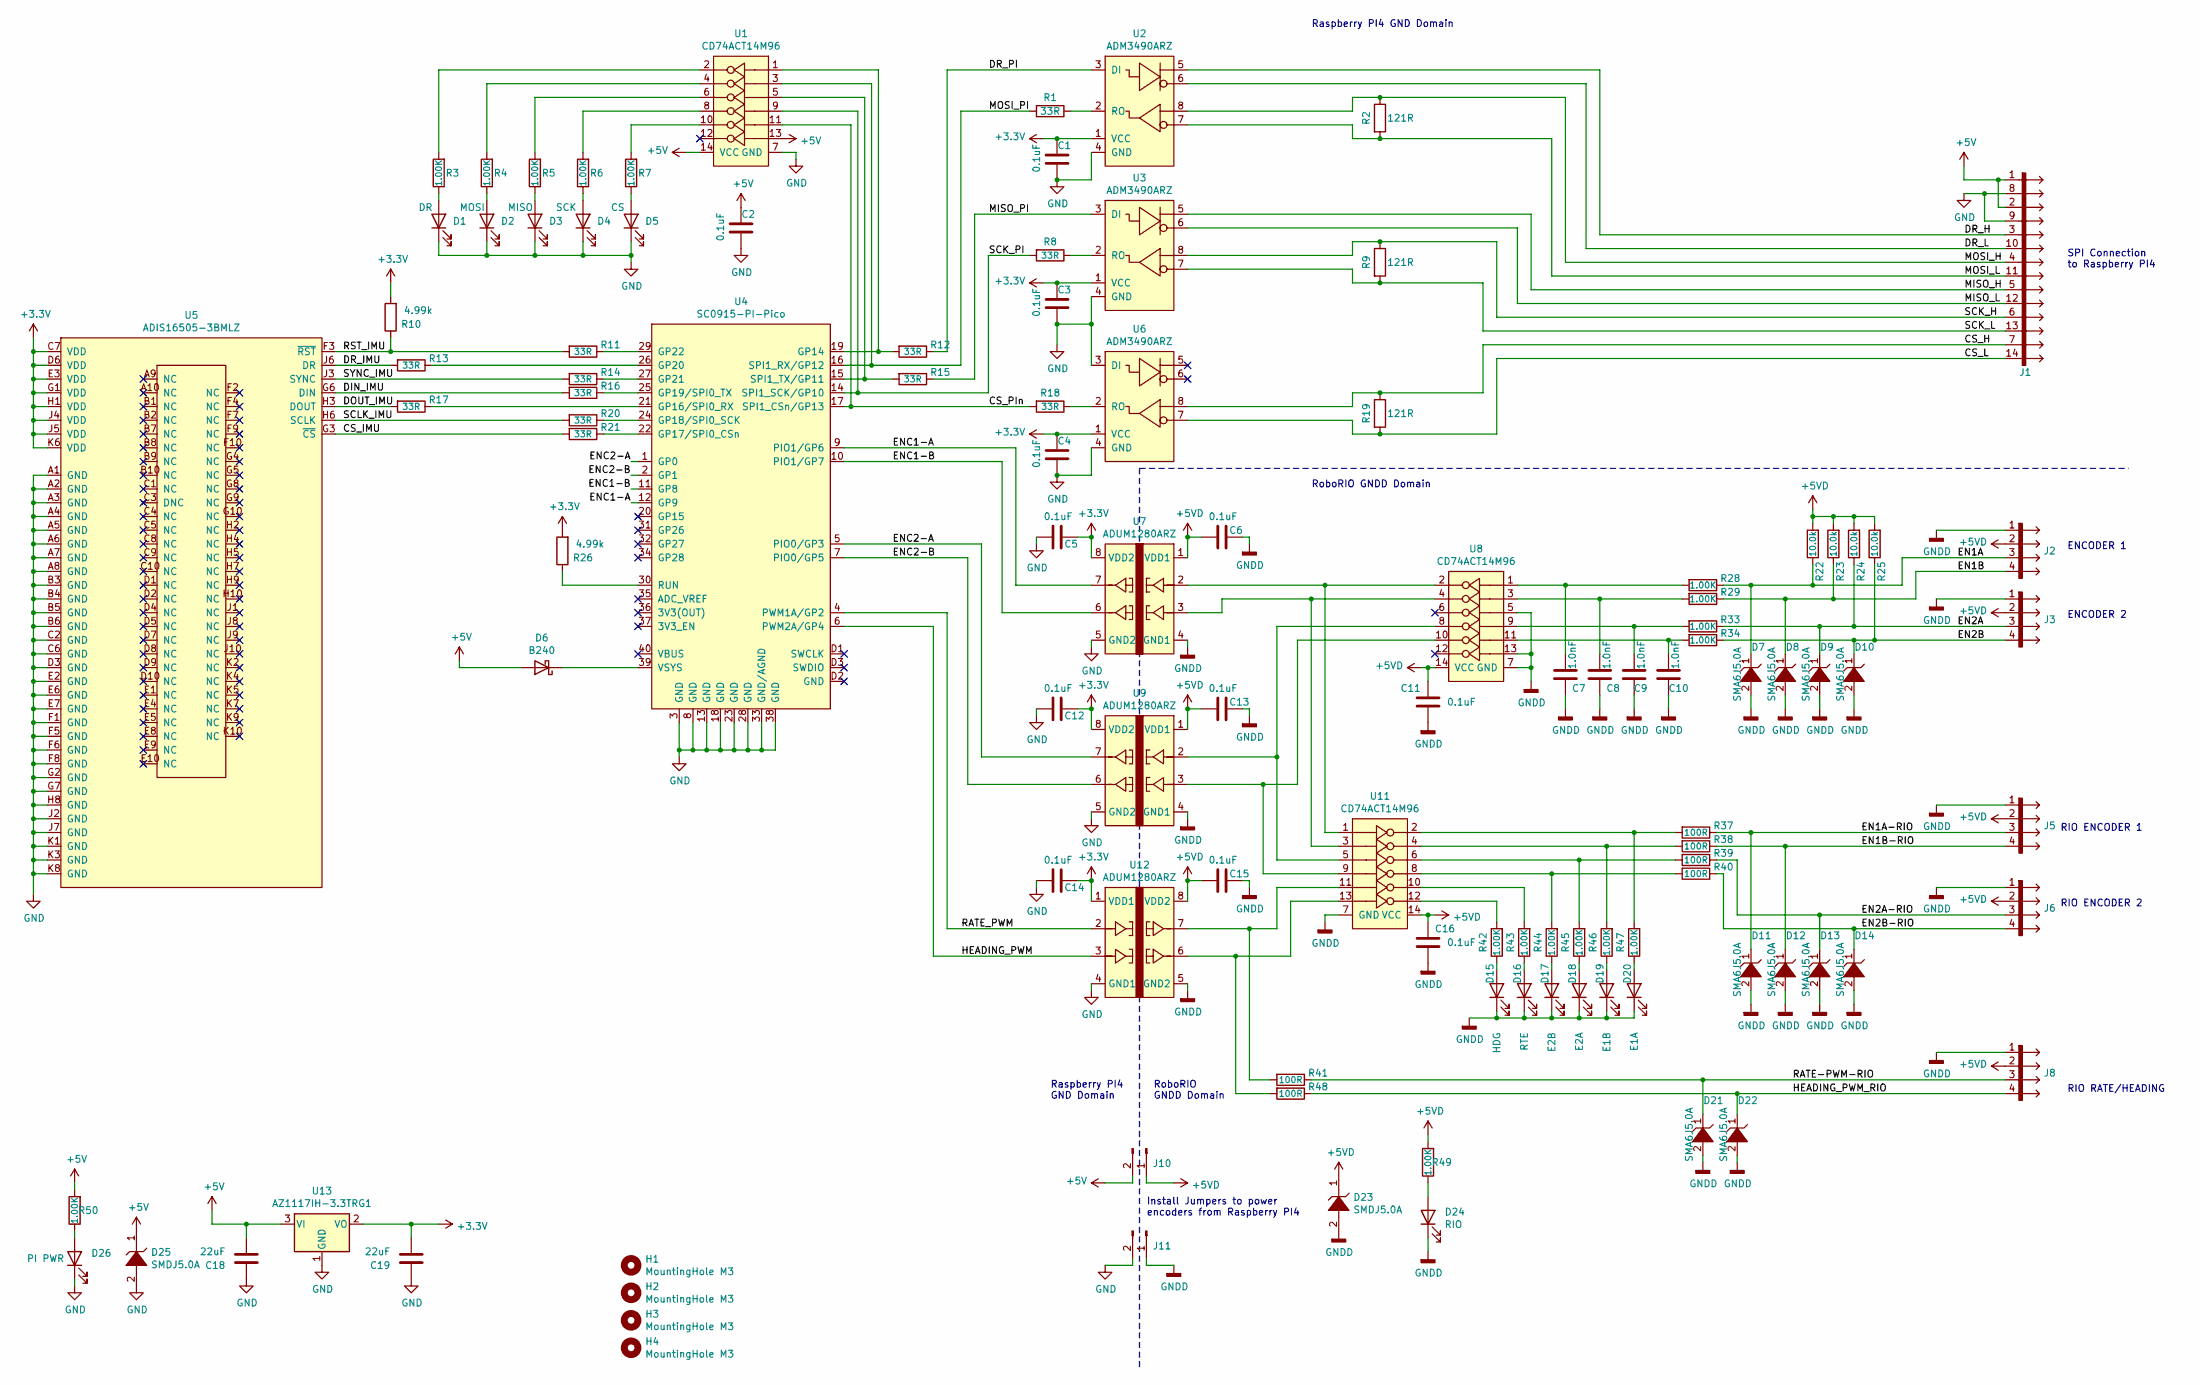
[picture p193: schematic RspPiPicoIMU.sch, Raspberry Pi Pico IMU]

Parts:
C1, C2, C3, C4, C5, C6, C11, C12, C13, C14, C15, C16: 0.1uF; C_0805_2012Metric
C7, C8, C9, C10: 1.0nF; C_0805_2012Metric
C18, C19: 22uF; C_1206_3216Metric
D1: DR; LED_1206_3216Metric
D2: MOSI; LED_1206_3216Metric
D3: MISO; LED_1206_3216Metric
D4: SCK; LED_1206_3216Metric
D5: CS; LED_1206_3216Metric
D6: B240; D_SMB
D7, D8, D9, D10, D11, D12, D13, D14, D21, D22: SMA6J5.0A; D_SMA
D15: HDG; LED_1206_3216Metric
D16: RTE; LED_1206_3216Metric
D17: E2B; LED_1206_3216Metric
D18: E2A; LED_1206_3216Metric
D19: E1B; LED_1206_3216Metric
D20: E1A; LED_1206_3216Metric
D23, D25: SMDJ5.0A; D_SMC
D24: RIO; LED_1206_3216Metric
D26: PI PWR; LED_1206_3216Metric
H1, H2, H3, H4: MountingHole M3; MountingHole_3.2mm_M3
J1: MICROFIT-VERT-2x7; Molex430451425
J2: ENCODER 1; Molex_KK-254_AE-6410-04A_1x04_P2.54mm_Vertical
J3: ENCODER 2; Molex_KK-254_AE-6410-04A_1x04_P2.54mm_Vertical
J5: RIO ENC 1; Molex_KK-254_AE-6410-04A_1x04_P2.54mm_Vertical
J6: RIO ENC 2; Molex_KK-254_AE-6410-04A_1x04_P2.54mm_Vertical
J8: RIO PWM; Molex_KK-254_AE-6410-04A_1x04_P2.54mm_Vertical
J10, J11: Conn_01x02_Male; PinHeader_1x02_P2.54mm_Vertical
R1, R8, R11, R12, R13, R14, R15, R16, R17, R18, R20, R21: 33R; R_0805_2012Metric
R2, R9, R19: 121R; R_0805_2012Metric
R3, R4, R5, R6, R7, R28, R29, R33, R34, R42, R43, R44, R45, R46, R47, R49, R50: 1.00K; R_0805_2012Metric
R10, R26: 4.99k; R_0805_2012Metric
R22, R23, R24, R25: 10.0k; R_0805_2012Metric
R37, R38, R39, R40, R41, R48: 100R; R_0805_2012Metric
U1, U8, U11: CD74ACT14M96; SO-14_3.9x8.65mm_P1.27mm
U2, U3, U6: ADM3490ARZ; SO-8_3.9x4.9mm_P1.27mm
U4: SC0915-PI-Pico; PICO
U5: ADIS16505-3BMLZ; BGA-100_10x10_15.0x15.0mm
U7, U9, U12: ADUM1280ARZ; SO-8_3.9x4.9mm_P1.27mm
U13: AZ1117IH-3.3TRG1; SOT-223

Connections:
+3V3: C1.1, C3.1, C4.1, C5.1, C12.1, C14.1, C19.2, R10.2, R26.2, U2.1 (VCC), U3.1 (VCC), U5.C7 (VDD), U5.D6 (VDD), U5.E3 (VDD), U5.G1 (VDD), U5.H1 (VDD), U5.J4 (VDD), U5.J5 (VDD), U5.K6 (VDD), U6.1 (VCC), U7.8 (VDD2), U9.8 (VDD2), U12.1 (VDD1), U13.2 (VO), U13.4
+5V: C2.1, C18.2, D6.2 (A), D25.1, J1.1, J1.2, J10.2, R50.2, U1.13, U1.14 (VCC), U13.3 (VI)
+5VD: C6.2, C11.2, C13.2, C15.2, C16.2, D23.1, J2.2, J3.2, J5.2, J6.2, J8.2, J10.1, R22.2, R23.2, R24.2, R25.2, R49.2, U7.1 (VDD1), U8.14 (VCC), U9.1 (VDD1), U11.14 (VCC), U12.8 (VDD2)
/CS_H: J1.7, R19.1, U6.8
/CS_IMU: R21.2, U5.G3 (~CS)
/CS_L: J1.14, R19.2, U6.7
/CS_PIn: R18.2, U1.11, U4.17 (SPI1_CSn/GP13)
/DIN_IMU: R16.2, U5.G6 (DIN)
/DOUT_IMU: R17.2, U5.H3 (DOUT)
/DR_H: J1.3, U2.5
/DR_IMU: R13.2, U5.J6 (DR)
/DR_L: J1.10, U2.6
/DR_PI: R12.1, U2.3 (DI)
/EN1A: D7.1, J2.3, R22.1, R28.1
/EN1A-RIO: D11.1, J5.3, R37.1
/EN1B: D8.1, J2.4, R23.1, R29.1
/EN1B-RIO: D12.1, J5.4, R38.1
/EN2A: D9.1, J3.3, R24.1, R33.1
/EN2A-RIO: D13.1, J6.3, R39.1
/EN2B: D10.1, J3.4, R25.1, R34.1
/EN2B-RIO: D14.1, J6.4, R40.1
/ENC1-A: U4.9 (PIO1/GP6), U4.12 (GP9), U7.7
/ENC1-B: U4.10 (PIO1/GP7), U4.11 (GP8), U7.6
/ENC2-A: U4.1 (GP0), U4.5 (PIO0/GP3), U9.7
/ENC2-B: U4.2 (GP1), U4.7 (PIO0/GP5), U9.6
/HEADING_PWM: U4.6 (PWM2A/GP4), U12.3
/HEADING_PWM_RIO: D22.1, J8.4, R48.1
/MISO_H: J1.5, U3.5
/MISO_L: J1.12, U3.6
/MISO_PI: R15.1, U3.3 (DI)
/MOSI_H: J1.4, R2.1, U2.8
/MOSI_L: J1.11, R2.2, U2.7
/MOSI_PI: R1.2, U1.3, U4.16 (SPI1_RX/GP12)
/RATE-PWM-RIO: D21.1, J8.3, R41.1
/RATE_PWM: U4.4 (PWM1A/GP2), U12.2
/RST_IMU: R10.1, R11.2, U5.F3 (~RST)
/SCK_H: J1.6, R9.1, U3.8
/SCK_L: J1.13, R9.2, U3.7
/SCK_PI: R8.2, U1.9, U4.14 (SPI1_SCK/GP10)
/SCLK_IMU: R20.2, U5.H6 (SCLK)
/SYNC_IMU: R14.2, U5.J3 (SYNC)
GND: C1.2, C2.2, C3.2, C4.2, C5.2, C12.2, C14.2, C18.1, C19.1, D1.1 (K), D2.1 (K), D3.1 (K), D4.1 (K), D5.1 (K), D25.2, D26.1 (K), J1.8, J1.9, J11.2, U1.7 (GND), U2.4 (GND), U3.4 (GND), U4.3 (GND), U4.8 (GND), U4.13 (GND), U4.18 (GND), U4.23 (GND), U4.28 (GND), U4.33 (GND/AGND), U4.38 (GND), U5.A1 (GND), U5.A2 (GND), U5.A3 (GND), U5.A4 (GND), U5.A5 (GND), U5.A6 (GND), U5.A7 (GND), U5.A8 (GND), U5.B3 (GND), U5.B4 (GND), U5.B5 (GND), U5.B6 (GND), U5.C2 (GND), U5.C6 (GND), U5.D3 (GND), U5.E2 (GND), U5.E6 (GND), U5.E7 (GND), U5.F1 (GND), U5.F5 (GND), U5.F6 (GND), U5.F8 (GND), U5.G2 (GND), U5.G7 (GND), U5.H8 (GND), U5.J2 (GND), U5.J7 (GND), U5.K1 (GND), U5.K3 (GND), U5.K8 (GND), U6.3 (DI), U6.4 (GND), U7.5 (GND2), U9.5 (GND2), U12.4 (GND1), U13.1 (GND)
GNDD: C6.1, C7.1, C8.1, C9.1, C10.1, C11.1, C13.1, C15.1, C16.1, D7.2, D8.2, D9.2, D10.2, D11.2, D12.2, D13.2, D14.2, D15.1 (K), D16.1 (K), D17.1 (K), D18.1 (K), D19.1 (K), D20.1 (K), D21.2, D22.2, D23.2, D24.1 (K), J2.1, J3.1, J5.1, J6.1, J8.1, J11.1, U7.4 (GND1), U8.5, U8.7 (GND), U8.13, U9.4 (GND1), U11.7 (GND), U12.5 (GND2)
unnamed: C7.2, R28.2, U8.1
unnamed: C8.2, R29.2, U8.3
unnamed: C9.2, R33.2, U8.9
unnamed: C10.2, R34.2, U8.11
unnamed: D1.2 (A), R3.1
unnamed: D2.2 (A), R4.1
unnamed: D3.2 (A), R5.1
unnamed: D4.2 (A), R6.1
unnamed: D5.2 (A), R7.1
unnamed: D6.1 (K), U4.39 (VSYS)
unnamed: D15.2 (A), R42.1
unnamed: D16.2 (A), R43.1
unnamed: D17.2 (A), R44.1
unnamed: D18.2 (A), R45.1
unnamed: D19.2 (A), R46.1
unnamed: D20.2 (A), R47.1
unnamed: D24.2 (A), R49.1
unnamed: D26.2 (A), R50.1
unnamed: R1.1, U2.2 (RO)
unnamed: R3.2, U1.2
unnamed: R4.2, U1.4
unnamed: R5.2, U1.6
unnamed: R6.2, U1.8
unnamed: R7.2, U1.10
unnamed: R8.1, U3.2 (RO)
unnamed: R11.1, U4.29 (GP22)
unnamed: R12.2, U1.1, U4.19 (GP14)
unnamed: R13.1, U4.26 (GP20)
unnamed: R14.1, U4.27 (GP21)
unnamed: R15.2, U1.5, U4.15 (SPI1_TX/GP11)
unnamed: R16.1, U4.25 (GP19/SPI0_TX)
unnamed: R17.1, U4.21 (GP16/SPI0_RX)
unnamed: R18.1, U6.2 (RO)
unnamed: R20.1, U4.24 (GP18/SPI0_SCK)
unnamed: R21.1, U4.22 (GP17/SPI0_CSn)
unnamed: R26.1, U4.30 (RUN)
unnamed: R37.2, R47.2, U11.2
unnamed: R38.2, R46.2, U11.4
unnamed: R39.2, R45.2, U11.6
unnamed: R40.2, R44.2, U11.8
unnamed: R41.2, U11.11, U12.7
unnamed: R42.2, U11.12
unnamed: R43.2, U11.10
unnamed: R48.2, U11.13, U12.6
unnamed: U7.2, U8.2, U11.1
unnamed: U7.3, U8.4, U11.3
unnamed: U8.8, U9.2, U11.5
unnamed: U8.10, U9.3, U11.9

Notes on the sheet:
ENCODER 1
ENCODER 2
RIO ENCODER 2
RIO RATE/HEADING
RoboRIO GNDD Domain
Raspberry PI4 GND Domain
Raspberry PI4 GND Domain
RoboRIO GNDD Domain
Install Jumpers to power encoders from Raspberry PI4
SPI Connection to Raspberry PI4
RIO ENCODER 1

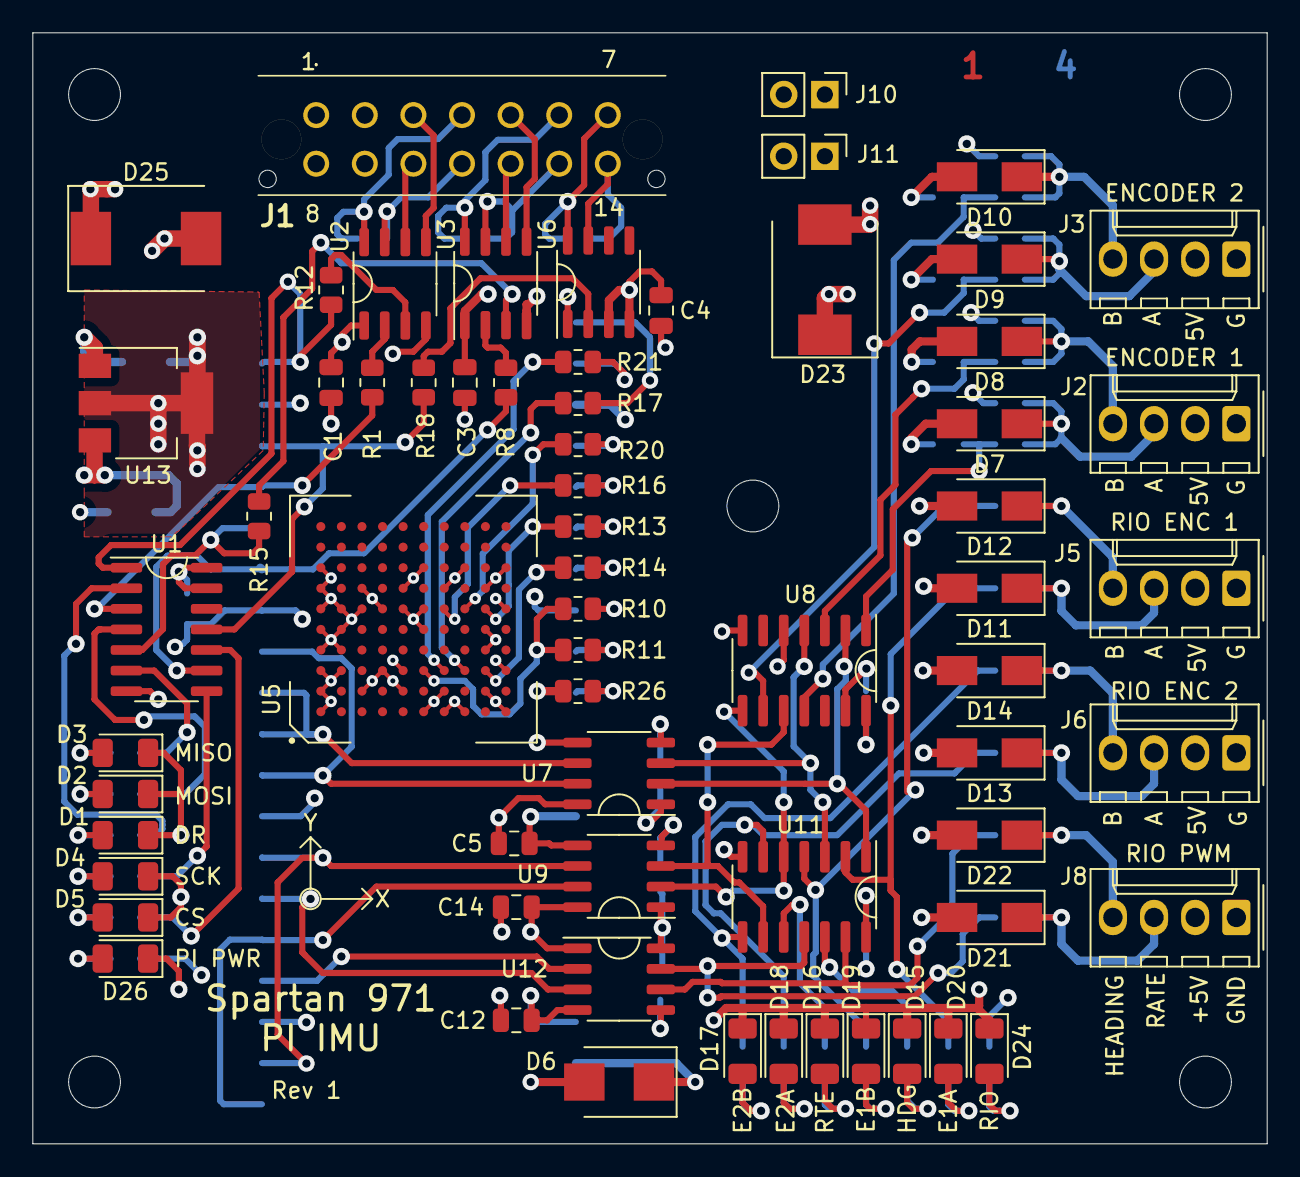
[picture p194: board RspPiPicoIMU.kicad_pcb from above]

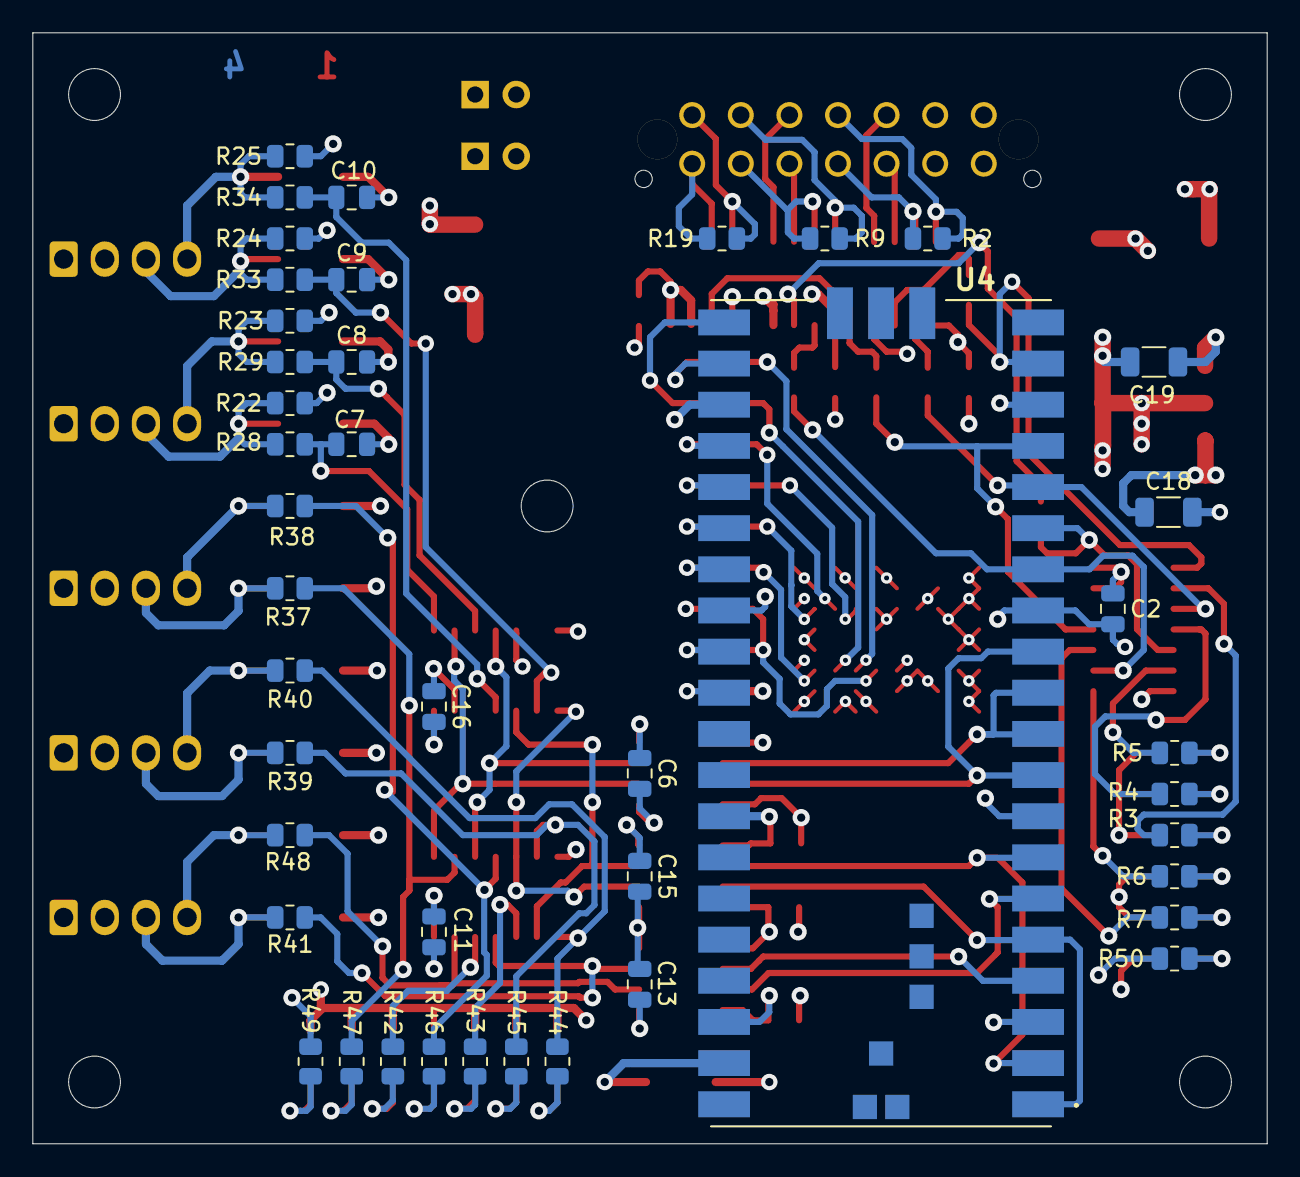
[picture p195: board RspPiPicoIMU.kicad_pcb from below]

Board: 4 copper layers, 76.2 x 68.6 mm, 113 parts (43 on the bottom side), 91 nets.

Other parts of the board:
H4#2: MountingHole M3; MountingHole_3.2mm_M3
