frc971/electrical/circuit-boards/RPI-Power-Boards/RockPI-Power-Board/PI-Power-Board.kicad_pcb

## KiCad design circuit-boards/RPI-Power-Boards/RockPI-Power-Board/PI-Power-Board.kicad_pcb (2023-12-23)

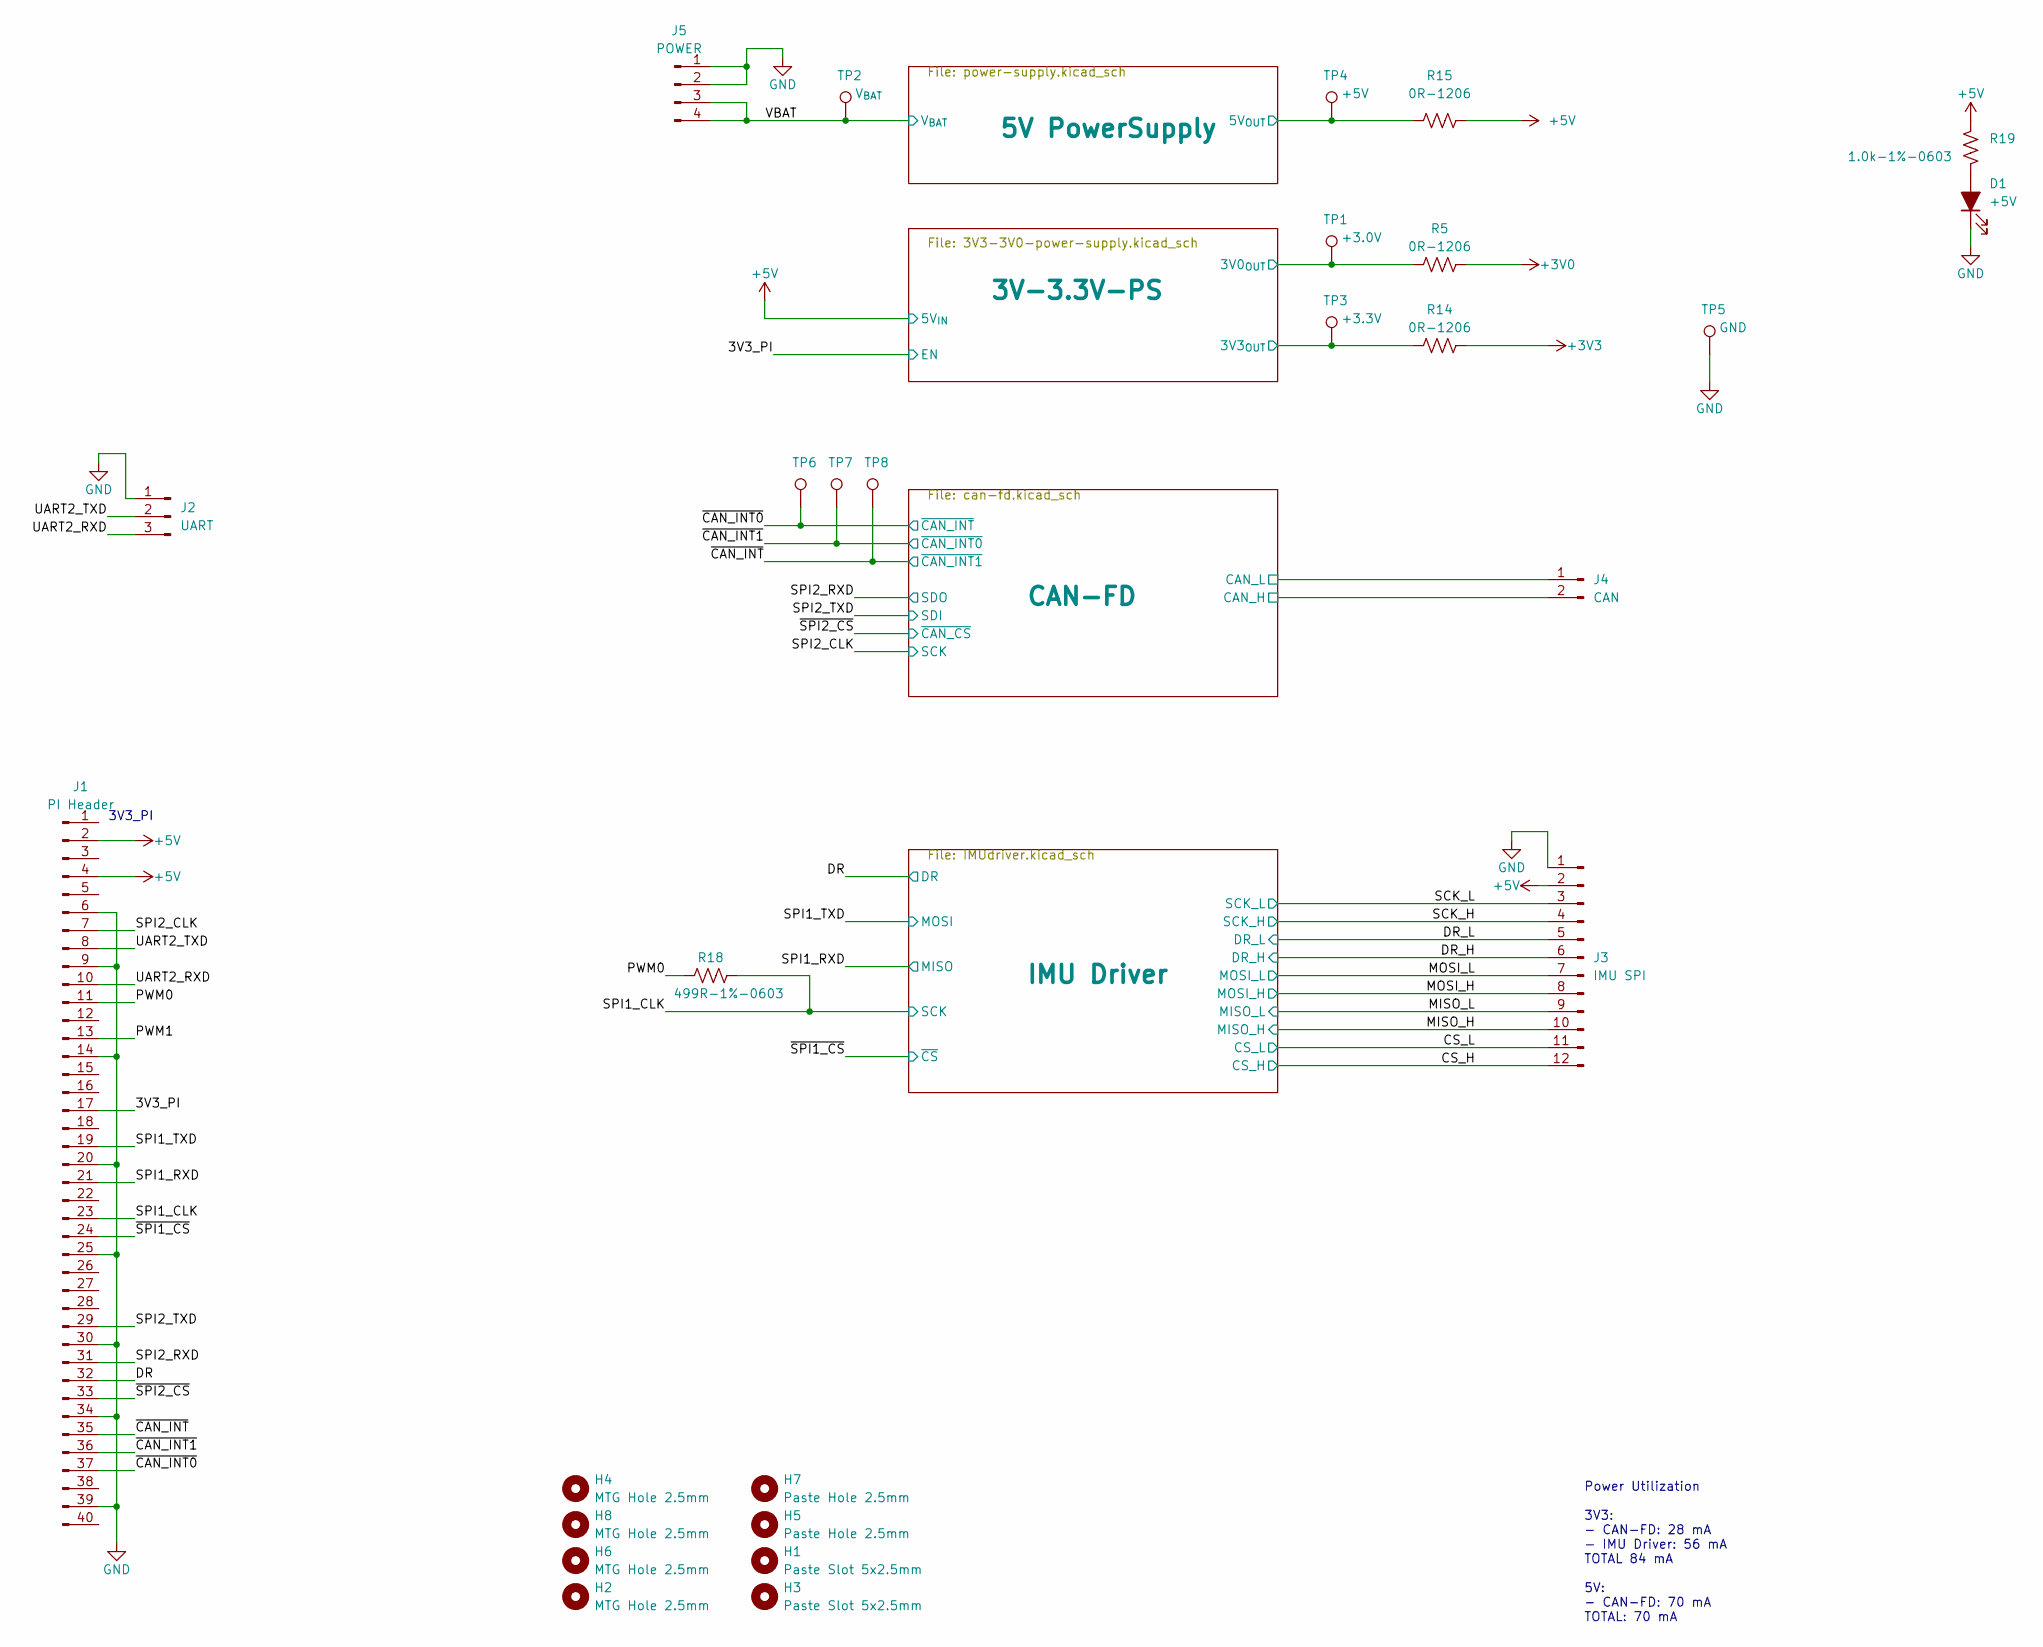
[picture p196: schematic PI-Power-Board.kicad_sch, Pi Power Board 2]

Parts:
D1: +5V; LED_1206_3216Metric; MFG P/N QTLP650D4TR
H1, H3: Paste Slot 5x2.5mm; PASTE-SLOT-5x2.5mm
H2, H4, H6, H8: MTG Hole 2.5mm; MountingHole_2.5mm
H5, H7: Paste Hole 2.5mm; PASTE-HOLE-2.5mm
J1: PI Header; M20-782045; MFG P/N M20-7812045
J2: UART; 70555-0002; MFG P/N 70555-0002
J3: IMU SPI; 70555-0011; MFG P/N 70555-0011
J4: CAN; 70555-0001; MFG P/N 70555-0001
J5: POWER; 70555-0003; MFG P/N 70555-0003
R5, R14, R15: 0R-1206; R_1206_3216Metric; MFG P/N RC1206JR-070RL
R18: 499R-1%-0603; R_0603_1608Metric; MFG P/N RC0603FR-07499RL
R19: 1.0k-1%-0603; R_0603_1608Metric; MFG P/N RC0603FR-071KL
TP1: +3.0V; TestPoint_Keystone_5000-5004_Miniature; MFG P/N 5002
TP2: V_{BAT}; TestPoint_Keystone_5000-5004_Miniature; MFG P/N 5002
TP3, TP6, TP7, TP8: +3.3V; TestPoint_Keystone_5000-5004_Miniature; MFG P/N 5002
TP4: +5V; TestPoint_Keystone_5000-5004_Miniature; MFG P/N 5002
TP5: GND; TestPoint_Keystone_5000-5004_Miniature; MFG P/N 5002

Connections:
+3V0: R5.2; also elsewhere on the board
+3V3: R14.2; also elsewhere on the board
+5V: J1.2, J1.4, J3.2, R15.2, R19.2; also elsewhere on the board
/3V3_PI: J1.17; also elsewhere on the board
/3V-3.3V-PS/3V0_{OUT}: R5.1, TP1.1; also elsewhere on the board
/3V-3.3V-PS/3V3_{OUT}: R14.1, TP3.1; also elsewhere on the board
/5V PowerSupply/V_{OSNS}: R15.1, TP4.1; also elsewhere on the board
/CAN-FD/CAN_H: J4.2; also elsewhere on the board
/CAN-FD/CAN_L: J4.1; also elsewhere on the board
/CS_H: J3.12; also elsewhere on the board
/CS_L: J3.11; also elsewhere on the board
/DR: J1.32; also elsewhere on the board
/DR_H: J3.6; also elsewhere on the board
/DR_L: J3.5; also elsewhere on the board
/MISO_H: J3.10; also elsewhere on the board
/MISO_L: J3.9; also elsewhere on the board
/MOSI_H: J3.8; also elsewhere on the board
/MOSI_L: J3.7; also elsewhere on the board
/PWM0: J1.11, R18.1
/PWM1: J1.13
/SCK_H: J3.4; also elsewhere on the board
/SCK_L: J3.3; also elsewhere on the board
/SPI1_CLK: J1.23, R18.2; also elsewhere on the board
/SPI1_RXD: J1.21; also elsewhere on the board
/SPI1_TXD: J1.19; also elsewhere on the board
/SPI2_CLK: J1.7; also elsewhere on the board
/SPI2_RXD: J1.31; also elsewhere on the board
/SPI2_TXD: J1.29; also elsewhere on the board
/UART2_RXD: J1.10, J2.3
/UART2_TXD: J1.8, J2.2
/VBAT: J5.3, J5.4, TP2.1; also elsewhere on the board
/~CAN_INT0: J1.37, TP6.1; also elsewhere on the board
/~CAN_INT1: J1.36, TP7.1; also elsewhere on the board
/~CAN_INT: J1.35, TP8.1; also elsewhere on the board
/~SPI1_CS: J1.24; also elsewhere on the board
/~SPI2_CS: J1.33; also elsewhere on the board
GND: D1.1 (K), J1.6, J1.9, J1.14, J1.20, J1.25, J1.30, J1.34, J1.39, J2.1, J3.1, J5.1, J5.2, TP5.1; also elsewhere on the board
unnamed: D1.2 (A), R19.1

Notes on the sheet:
3V3_PI
Power Utilization 3V3: - CAN-FD: 28 mA - IMU Driver: 56 mA TOTAL 84 mA 5V: - CAN-FD: 70 mA TOTAL: 70 mA

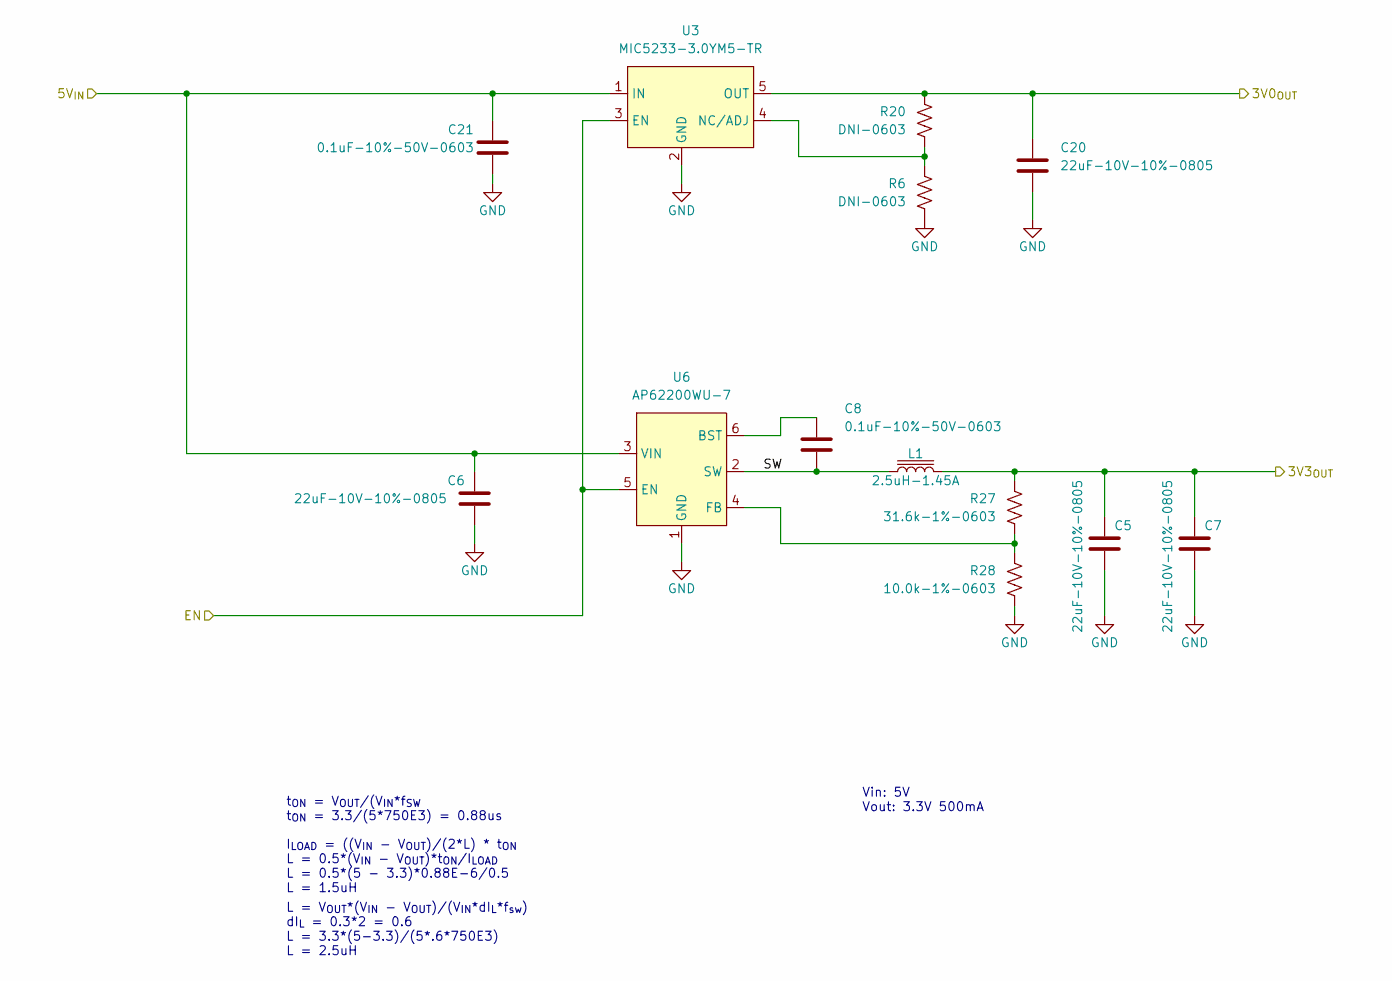
[picture p197: schematic 3V3-3V0-power-supply.kicad_sch, Pi Power Board 2]

Parts:
C5, C6, C7, C20: 22uF-10V-10%-0805; C_0805_2012Metric; MFG P/N CL21A226KPCLRNC
C8, C21: 0.1uF-10%-50V-0603; C_0603_1608Metric; MFG P/N CL10B104KB8NNNC
L1: 2.5uH-1.45A; WE-TPC-744031002; MFG P/N 744031002
R6, R20: DNI-0603; R_0603_1608Metric
R27: 31.6k-1%-0603; R_0603_1608Metric; MFG P/N RMCF0603FT31K6
R28: 10.0k-1%-0603; R_0603_1608Metric; MFG P/N RC0603FR-0710KL
U3: MIC5233-3.0YM5-TR; SOT-23-5; MFG P/N MIC5233-3.0YM5-TR
U6: AP62200WU-7; TSOT-23-6; MFG P/N AP62200WU-7

Connections:
+5V: C6.1, C21.1, U3.1 (IN), U6.3 (VIN); also elsewhere on the board
/3V3_PI: U3.3 (EN), U6.5 (EN); also elsewhere on the board
/3V-3.3V-PS/3V0_{OUT}: C20.1, R20.1, U3.5 (OUT); also elsewhere on the board
/3V-3.3V-PS/3V3_{OUT}: C5.1, C7.1, L1.2, R27.1; also elsewhere on the board
/3V-3.3V-PS/SW: C8.2, L1.1, U6.2 (SW)
GND: C5.2, C6.2, C7.2, C20.2, C21.2, R6.2, R28.2, U3.2 (GND), U6.1 (GND); also elsewhere on the board
unnamed: C8.1, U6.6 (BST)
unnamed: R6.1, R20.2, U3.4 (NC/ADJ)
unnamed: R27.2, R28.1, U6.4 (FB)

Notes on the sheet:
Vin: 5V Vout: 3.3V 500mA
I_{LOAD} = ((V_{IN} - V_{OUT})/(2*L) * t_{ON} L = 0.5*(V_{IN} - V_{OUT})*t_{ON}/I_{LOAD} L = 0.5*(5 - 3.3)*0.88E-6/0.5 L = 1.5uH
L = V_{OUT}*(V_{IN} - V_{OUT})/(V_{IN}*dI_{L}*f_{sw}) dI_{L} = 0.3*2 = 0.6 L = 3.3*(5-3.3)/(5*.6*750E3) L = 2.5uH
t_{ON} = V_{OUT}/(V_{IN}*f_{SW} t_{ON} = 3.3/(5*750E3) = 0.88us
