frc971/electrical/circuit-boards/beambreak/beambreak.kicad_pcb

## KiCad design circuit-boards/beambreak/beambreak.kicad_pcb (2023-12-23)

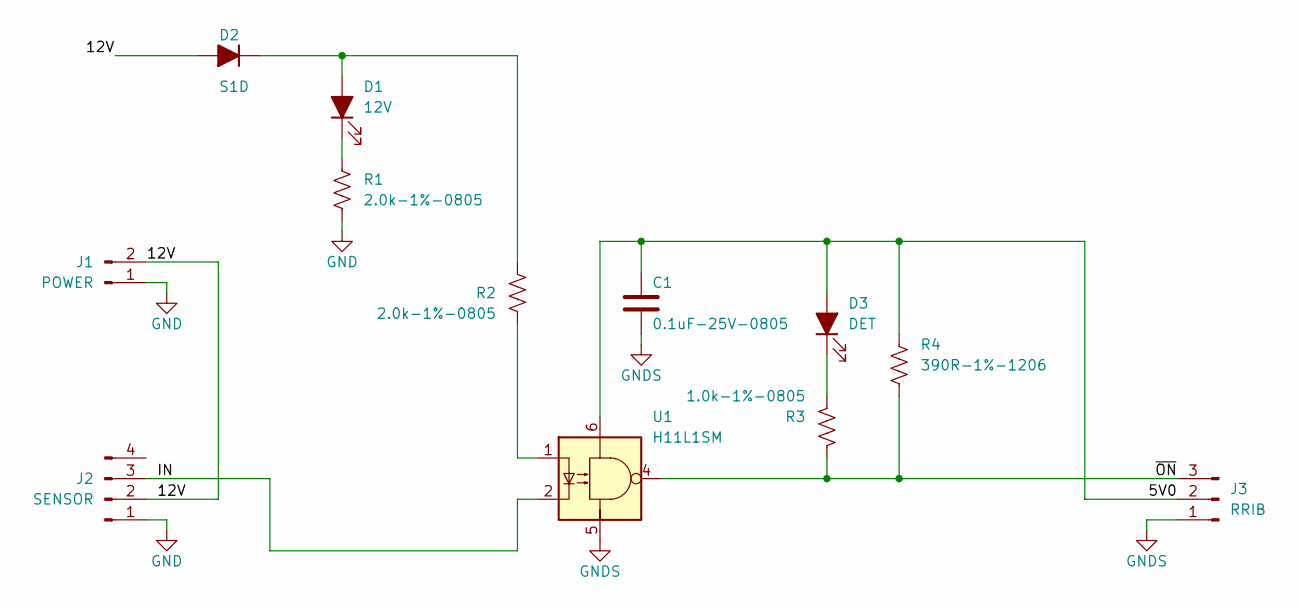
[picture p203: schematic beambreak.kicad_sch, Beam Break Monitor]

Parts:
C1: 0.1uF-25V-0805; C_0805_2012Metric
D1: 12V; LED_1206_3216Metric
D2: S1D; D_SMA; MFG P/N S1D-13-F
D3: DET; LED_1206_3216Metric
J1: POWER; Molex-705550001; MFG P/N 705550001
J2: SENSOR; Molex-705550003; MFG P/N 705550003
J3: RRIB; Molex-705550002; MFG P/N 705550002
R1: 2.0k-1%-0805; R_0805_2012Metric; MFG P/N RNCP0805FTD2K00
R2: 2.0k-1%-0805; R_0805_2012Metric
R3: 1.0k-1%-0805; R_0805_2012Metric; MFG P/N RNCP0805FTD1K00
R4: 390R-1%-1206; R_1206_3216Metric; MFG P/N RMCF1206FT390R
U1: H11L1SM; SMDIP-6_W9.53mm; MFG P/N H11L1SM

Connections:
/5V0: C1.1, D3.2 (A), J3.2, R4.2, U1.6
/12V: D2.2 (A), J1.2, J2.2
/IN: J2.3, U1.2
/~ON: J3.3, R3.1, R4.1, U1.4
GND: J1.1, J2.1, R1.1
GNDS: C1.2, J3.1, U1.5
unnamed: D1.1 (K), R1.2
unnamed: D3.1 (K), R3.2
unnamed: D1.2 (A), D2.1 (K), R2.1
unnamed: R2.2, U1.1

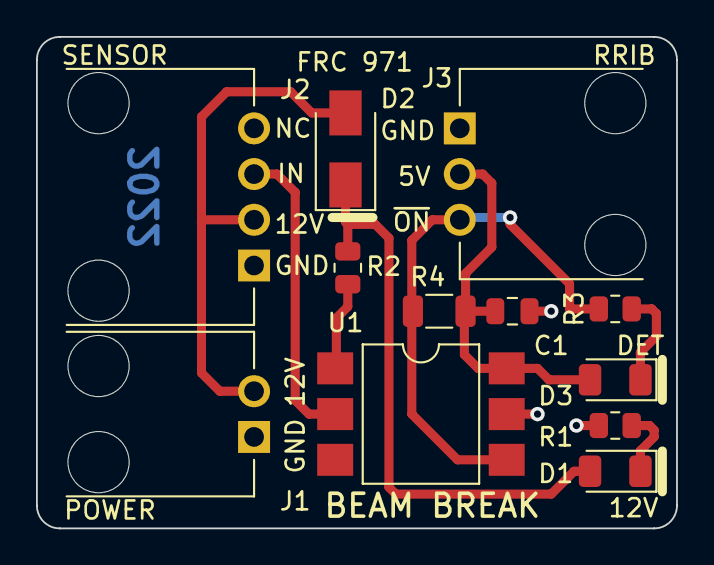
[picture p204: board beambreak.kicad_pcb from above]

Board: 2 copper layers, 35.6 x 27.3 mm, 12 parts (0 on the bottom side), 10 nets.
