frc971/electrical/circuit-boards/connector_boards/potentiometer_adapter/potentiometer_adapter.kicad_pcb

## KiCad design circuit-boards/connector_boards/potentiometer_adapter/potentiometer_adapter.kicad_pcb (2023-12-23)

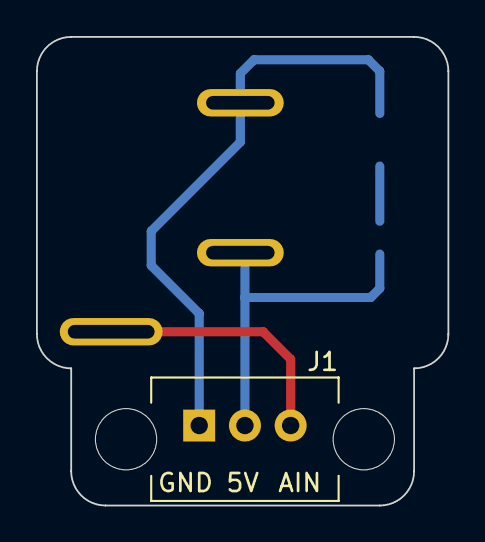
[picture p206: board potentiometer_adapter.kicad_pcb from above]

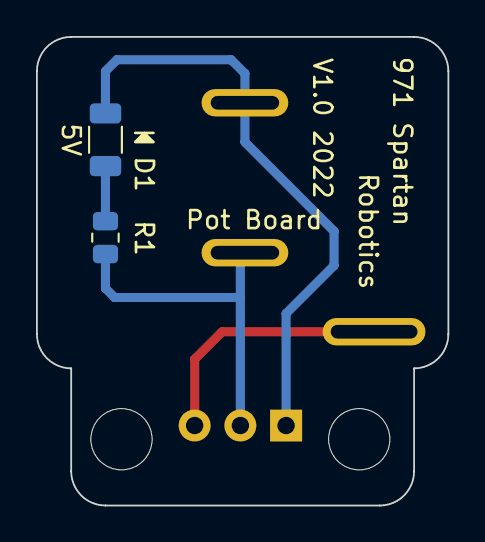
[picture p207: board potentiometer_adapter.kicad_pcb from below]

Board: 2 copper layers, 22.9 x 26.0 mm, 4 parts (2 on the bottom side), 4 nets.

Parts:
D1: 5V; R_1206_3216Metric
J1: Conn_01x03_Male; 70541-0037
R1: 2K 1%; R_0805_2012Metric
RV1: R_Potentiometer; Bourns3647

Connections:
/5V0: J1.2, R1.1, RV1.1
/AIN: J1.3, RV1.2
/GND: D1.1 (K), J1.1, RV1.3
unnamed: D1.2 (A), R1.2
