frc971/electrical/circuit-boards/led-ring-driver/kicad/led-ring-driver.kicad_pcb

## KiCad design circuit-boards/led-ring-driver/kicad/led-ring-driver.kicad_pcb (2023-12-23)

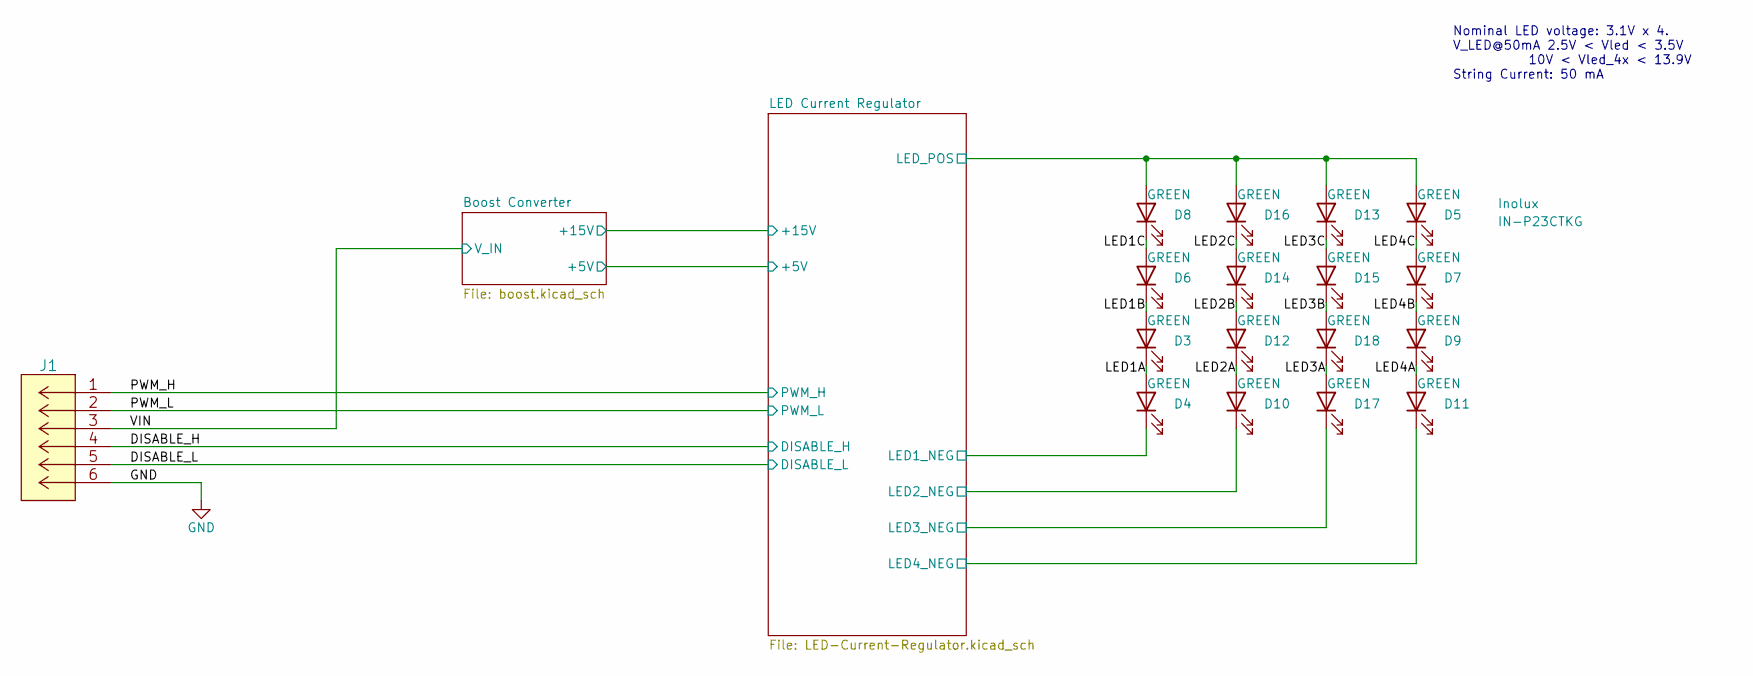
[picture p208: schematic led-ring-driver.kicad_sch, LED RING DRIVER]

Parts:
D3, D4, D5, D6, D7, D8, D9, D10, D11, D12, D13, D14, D15, D16, D17, D18: GREEN; LED_PLCC_2835
J1: 430450601

Connections:
/Boost Converter/+15V: D5.2 (A), D8.2 (A), D13.2 (A), D16.2 (A); also elsewhere on the board
/DISABLE_H: J1.4; also elsewhere on the board
/DISABLE_L: J1.5; also elsewhere on the board
/LED1A: D3.1 (K), D4.2 (A)
/LED1B: D3.2 (A), D6.1 (K)
/LED1C: D6.2 (A), D8.1 (K)
/LED2A: D10.2 (A), D12.1 (K)
/LED2B: D12.2 (A), D14.1 (K)
/LED2C: D14.2 (A), D16.1 (K)
/LED3A: D17.2 (A), D18.1 (K)
/LED3B: D15.1 (K), D18.2 (A)
/LED3C: D13.1 (K), D15.2 (A)
/LED4A: D9.1 (K), D11.2 (A)
/LED4B: D7.1 (K), D9.2 (A)
/LED4C: D5.1 (K), D7.2 (A)
/LED Current Regulator/LED1_NEG: D4.1 (K); also elsewhere on the board
/LED Current Regulator/LED2_NEG: D10.1 (K); also elsewhere on the board
/LED Current Regulator/LED3_NEG: D17.1 (K); also elsewhere on the board
/LED Current Regulator/LED4_NEG: D11.1 (K); also elsewhere on the board
/PWM_H: J1.1; also elsewhere on the board
/PWM_L: J1.2; also elsewhere on the board
/VIN: J1.3; also elsewhere on the board
GND: J1.6; also elsewhere on the board

Notes on the sheet:
Nominal LED voltage: 3.1V x 4. V_LED@50mA 2.5V < Vled < 3.5V 10V < Vled_4x < 13.9V String Current: 50 mA

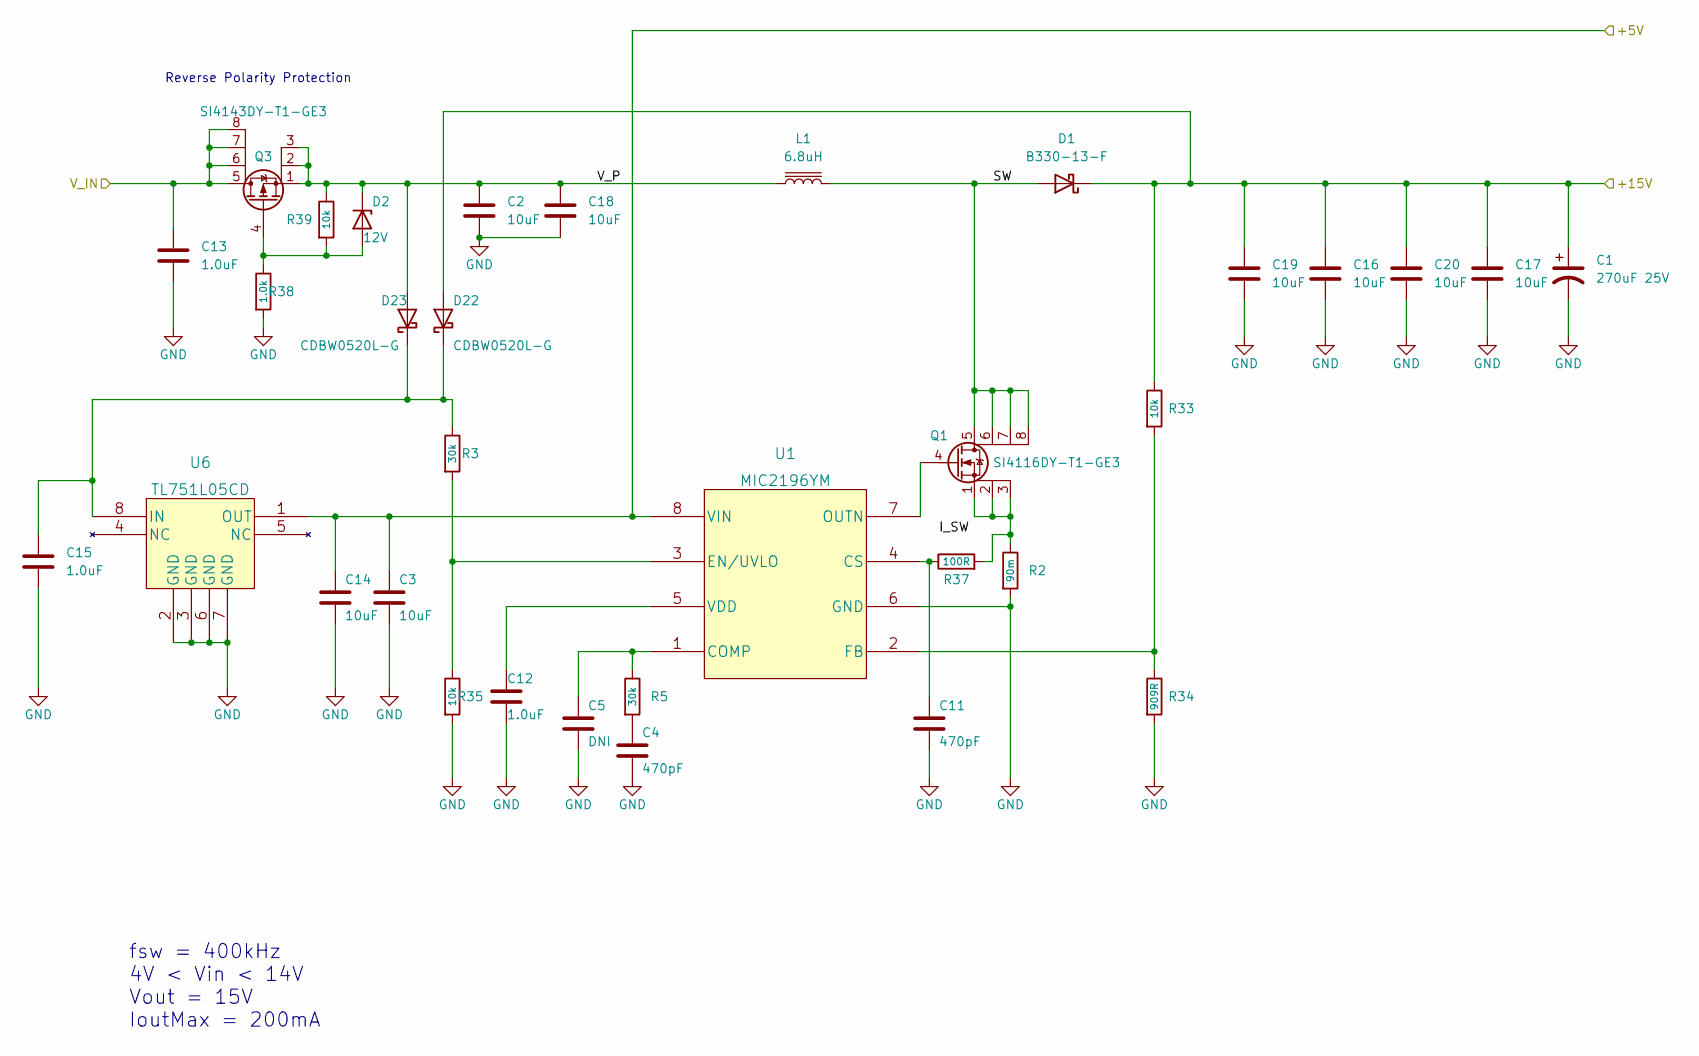
[picture p209: schematic boost.kicad_sch, LED RING DRIVER]

Parts:
C1: 270uF 25V; CAPPRD500W60D1000H950
C2, C3, C14, C16, C17, C18, C19, C20: 10uF; C_1206_3216Metric
C4, C11: 470pF; C_0805_2012Metric
C5: DNI; C_0805_2012Metric
C12, C13, C15: 1.0uF; C_0805_2012Metric
D1: B330-13-F; D_SMC
D2: 12V; D_SMB
D22, D23: CDBW0520L-G; D_SOD-123
L1: 6.8uH; SRP3020C-1R0M
Q1: SI4116DY-T1-GE3; SO-8_3.9x4.9mm_P1.27mm
Q3: SI4143DY-T1-GE3; SOIC-8_3.9x4.9mm_P1.27mm
R2: 90m; R_1206_3216Metric
R3, R5: 30k; R_0805_2012Metric
R33, R35, R39: 10k; R_0805_2012Metric
R34: 909R; R_0805_2012Metric
R37: 100R; R_0805_2012Metric
R38: 1.0k; R_0805_2012Metric
U1: MIC2196YM; SO-8_3.9x4.9mm_P1.27mm
U6: TL751L05CD; SO-8_3.9x4.9mm_P1.27mm

Connections:
+5V: C3.1, C14.1, U1.8 (VIN), U6.1 (OUT); also elsewhere on the board
/Boost Converter/+15V: C1.P, C16.1, C17.1, C19.1, C20.1, D1.1 (K), D22.2 (A), R33.1; also elsewhere on the board
/Boost Converter/SW: D1.2 (A), L1.2, Q1.5 (D), Q1.6 (D), Q1.7 (D), Q1.8 (D)
/Boost Converter/V_P: C2.1, C18.1, D2.1 (K), D23.2 (A), L1.1, Q3.1 (S), Q3.2 (S), Q3.3 (S), R39.1
/VIN: C13.1, Q3.5 (D), Q3.6 (D), Q3.7 (D), Q3.8 (D); also elsewhere on the board
GND: C1.N, C2.2, C3.2, C4.2, C5.2, C11.2, C12.2, C13.2, C14.2, C15.2, C16.2, C17.2, C18.2, C19.2, C20.2, R2.2, R34.2, R35.2, R38.2, U1.6 (GND), U6.2 (GND), U6.3 (GND), U6.6 (GND), U6.7 (GND); also elsewhere on the board
unnamed: C4.1, R5.2
unnamed: C5.1, R5.1, U1.1 (COMP)
unnamed: C11.1, R37.1, U1.4 (CS)
unnamed: C12.1, U1.5 (VDD)
unnamed: C15.1, D22.1 (K), D23.1 (K), R3.1, U6.8 (IN)
unnamed: D2.2 (A), Q3.4 (G), R38.1, R39.2
unnamed: Q1.1 (S), Q1.2 (S), Q1.3 (S), R2.1, R37.2
unnamed: Q1.4 (G), U1.7 (OUTN)
unnamed: R3.2, R35.1, U1.3 (EN/UVLO)
unnamed: R33.2, R34.1, U1.2 (FB)

Notes on the sheet:
Reverse Polarity Protection
fsw = 400kHz 4V < Vin < 14V Vout = 15V IoutMax = 200mA
