frc971/electrical/circuit-boards/led-ring-driver/kicad/led-ring-driver.kicad_pcb

## KiCad design circuit-boards/led-ring-driver/kicad/led-ring-driver.kicad_pcb (continued)

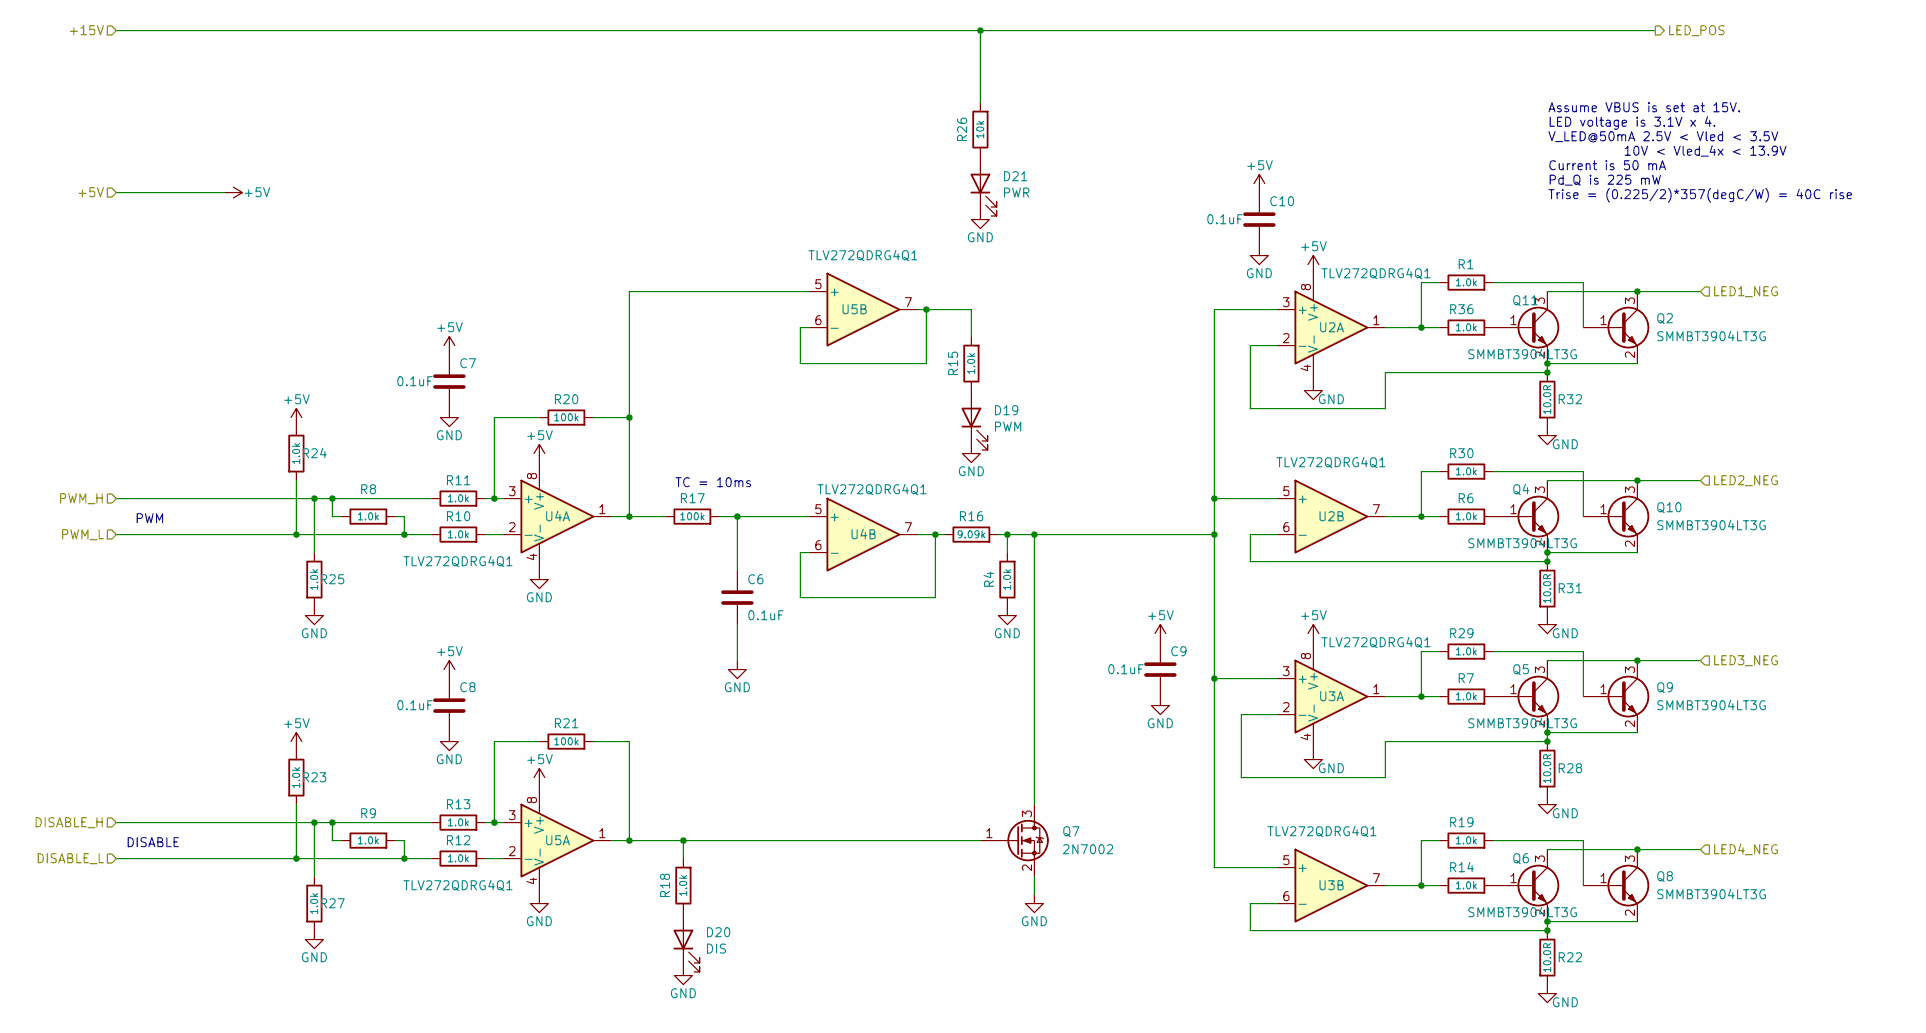
[picture p210: schematic LED-Current-Regulator.kicad_sch, LED RING DRIVER]

Parts:
C6, C7, C8, C9, C10: 0.1uF; C_0805_2012Metric
D19: PWM; LED_1206_3216Metric
D20: DIS; LED_1206_3216Metric
D21: PWR; LED_1206_3216Metric
Q2, Q4, Q5, Q6, Q8, Q9, Q10, Q11: SMMBT3904LT3G; SOT-23
Q7: 2N7002; SOT-23
R1, R4, R6, R7, R8, R9, R10, R11, R12, R13, R14, R15, R18, R19, R23, R24, R25, R27, R29, R30, R36: 1.0k; R_0805_2012Metric
R16: 9.09k; R_0805_2012Metric
R17, R20, R21: 100k; R_0805_2012Metric
R22, R28, R31, R32: 10.0R; R_0805_2012Metric
R26: 10k; R_0805_2012Metric
U2, U3, U4, U5: TLV272QDRG4Q1; SO-8_3.9x4.9mm_P1.27mm

Connections:
+5V: C7.1, C8.1, C9.1, C10.1, R23.1, R24.1, U2.8 (V+), U3.8 (V+), U4.8 (V+), U5.8 (V+); also elsewhere on the board
/Boost Converter/+15V: R26.2; also elsewhere on the board
/DISABLE_H: R9.1, R13.1, R27.1; also elsewhere on the board
/DISABLE_L: R9.2, R12.1, R23.2; also elsewhere on the board
/LED Current Regulator/LED1_NEG: Q2.3 (C), Q11.3 (C); also elsewhere on the board
/LED Current Regulator/LED2_NEG: Q4.3 (C), Q10.3 (C); also elsewhere on the board
/LED Current Regulator/LED3_NEG: Q5.3 (C), Q9.3 (C); also elsewhere on the board
/LED Current Regulator/LED4_NEG: Q6.3 (C), Q8.3 (C); also elsewhere on the board
/PWM_H: R8.1, R11.1, R25.1; also elsewhere on the board
/PWM_L: R8.2, R10.1, R24.2; also elsewhere on the board
GND: C6.2, C7.2, C8.2, C9.2, C10.2, D19.1 (K), D20.1 (K), D21.1 (K), Q7.2 (S), R4.1, R22.2, R25.2, R27.2, R28.2, R31.2, R32.2, U2.4 (V-), U3.4 (V-), U4.4 (V-), U5.4 (V-); also elsewhere on the board
unnamed: C6.1, R17.2, U4.5 (+)
unnamed: D19.2 (A), R15.1
unnamed: D20.2 (A), R18.1
unnamed: D21.2 (A), R26.1
unnamed: Q2.1 (B), R1.2
unnamed: Q4.1 (B), R6.2
unnamed: Q5.1 (B), R7.2
unnamed: Q5.2 (E), Q9.2 (E), R28.1, U3.2 (-)
unnamed: Q6.1 (B), R14.2
unnamed: Q6.2 (E), Q8.2 (E), R22.1, U3.6 (-)
unnamed: Q7.1 (G), R18.2, R21.2, U5.1
unnamed: Q7.3 (D), R4.2, R16.2, U2.3 (+), U2.5 (+), U3.3 (+), U3.5 (+)
unnamed: Q8.1 (B), R19.2
unnamed: Q9.1 (B), R29.2
unnamed: Q10.1 (B), R30.2
unnamed: Q4.2 (E), Q10.2 (E), R31.1, U2.6 (-)
unnamed: Q11.1 (B), R36.2
unnamed: Q2.2 (E), Q11.2 (E), R32.1, U2.2 (-)
unnamed: R1.1, R36.1, U2.1
unnamed: R10.2, U4.2 (-)
unnamed: R11.2, R20.1, U4.3 (+)
unnamed: R12.2, U5.2 (-)
unnamed: R13.2, R21.1, U5.3 (+)
unnamed: R14.1, R19.1, U3.7
unnamed: R15.2, U5.6 (-), U5.7
unnamed: R16.1, U4.6 (-), U4.7
unnamed: R17.1, R20.2, U4.1, U5.5 (+)
unnamed: R7.1, R29.1, U3.1
unnamed: R6.1, R30.1, U2.7

Notes on the sheet:
DISABLE
TC = 10ms
PWM
Assume VBUS is set at 15V. LED voltage is 3.1V x 4. V_LED@50mA 2.5V < Vled < 3.5V 10V < Vled_4x < 13.9V Current is 50 mA Pd_Q is 225 mW Trise = (0.225/2)*357(degC/W) = 40C rise

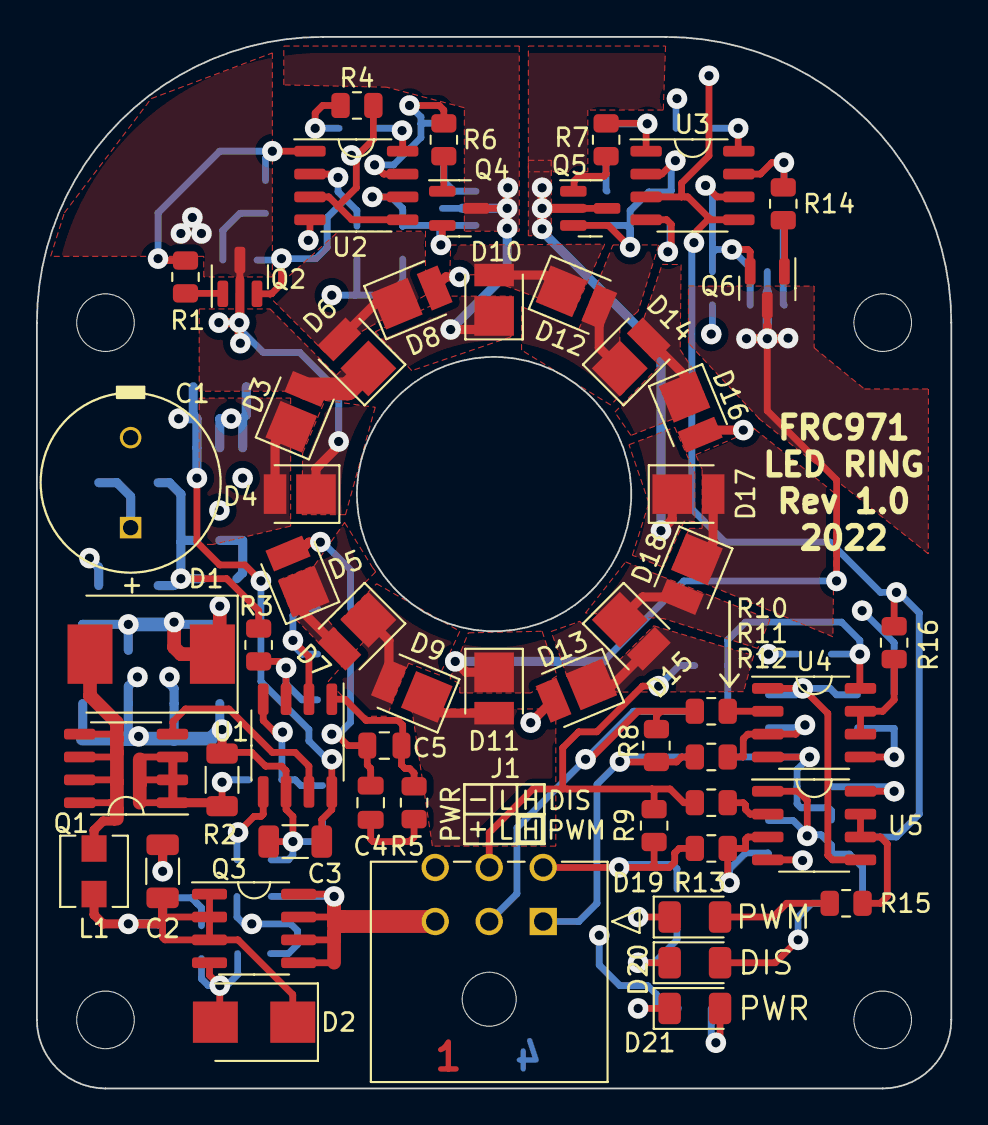
[picture p211: board led-ring-driver.kicad_pcb from above]

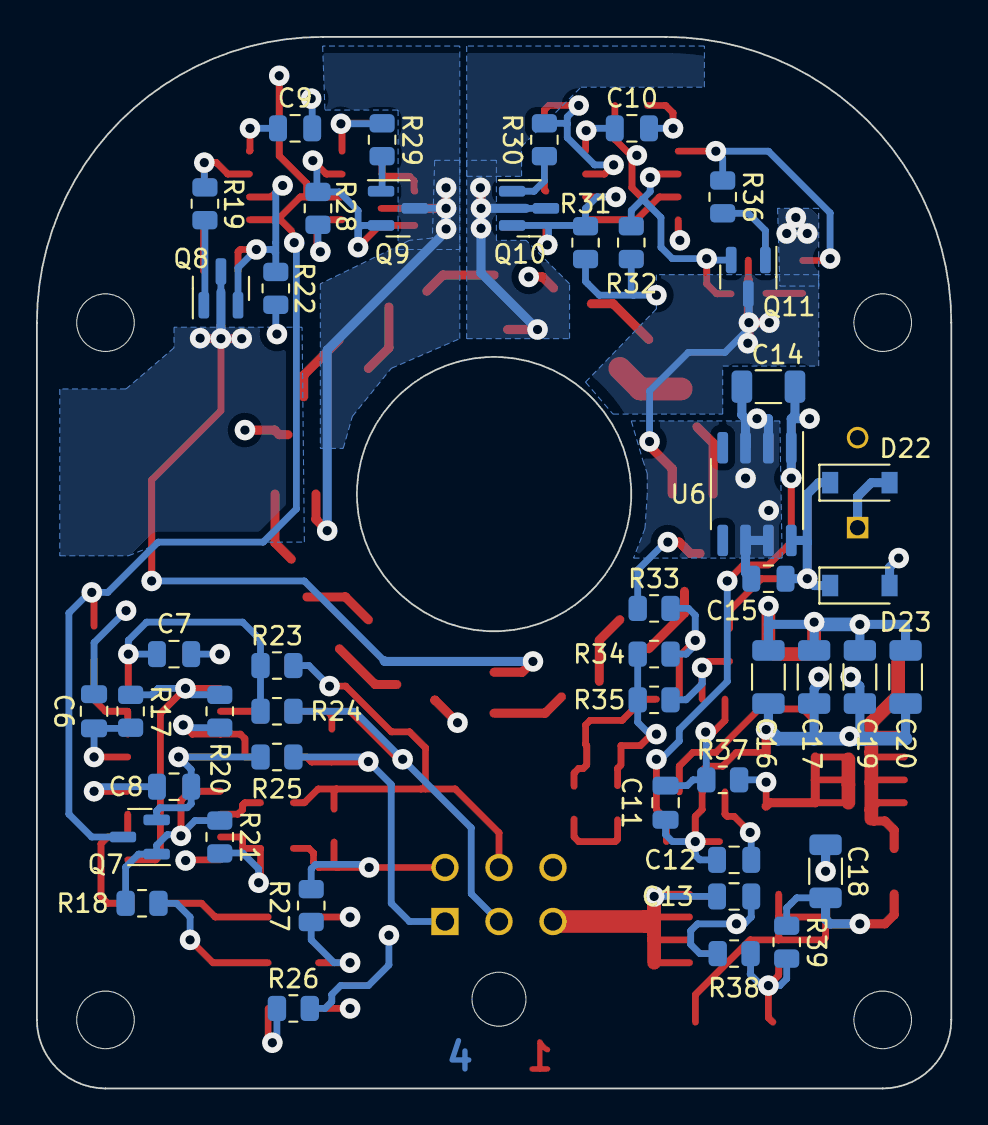
[picture p212: board led-ring-driver.kicad_pcb from below]

Board: 4 copper layers, 50.8 x 58.4 mm, 101 parts (46 on the bottom side), 65 nets.
