frc971/electrical/robots/2023/driver-station/DriverStation.kicad_sch

## KiCad design robots/2023/driver-station/DriverStation.kicad_sch (2024-02-22)

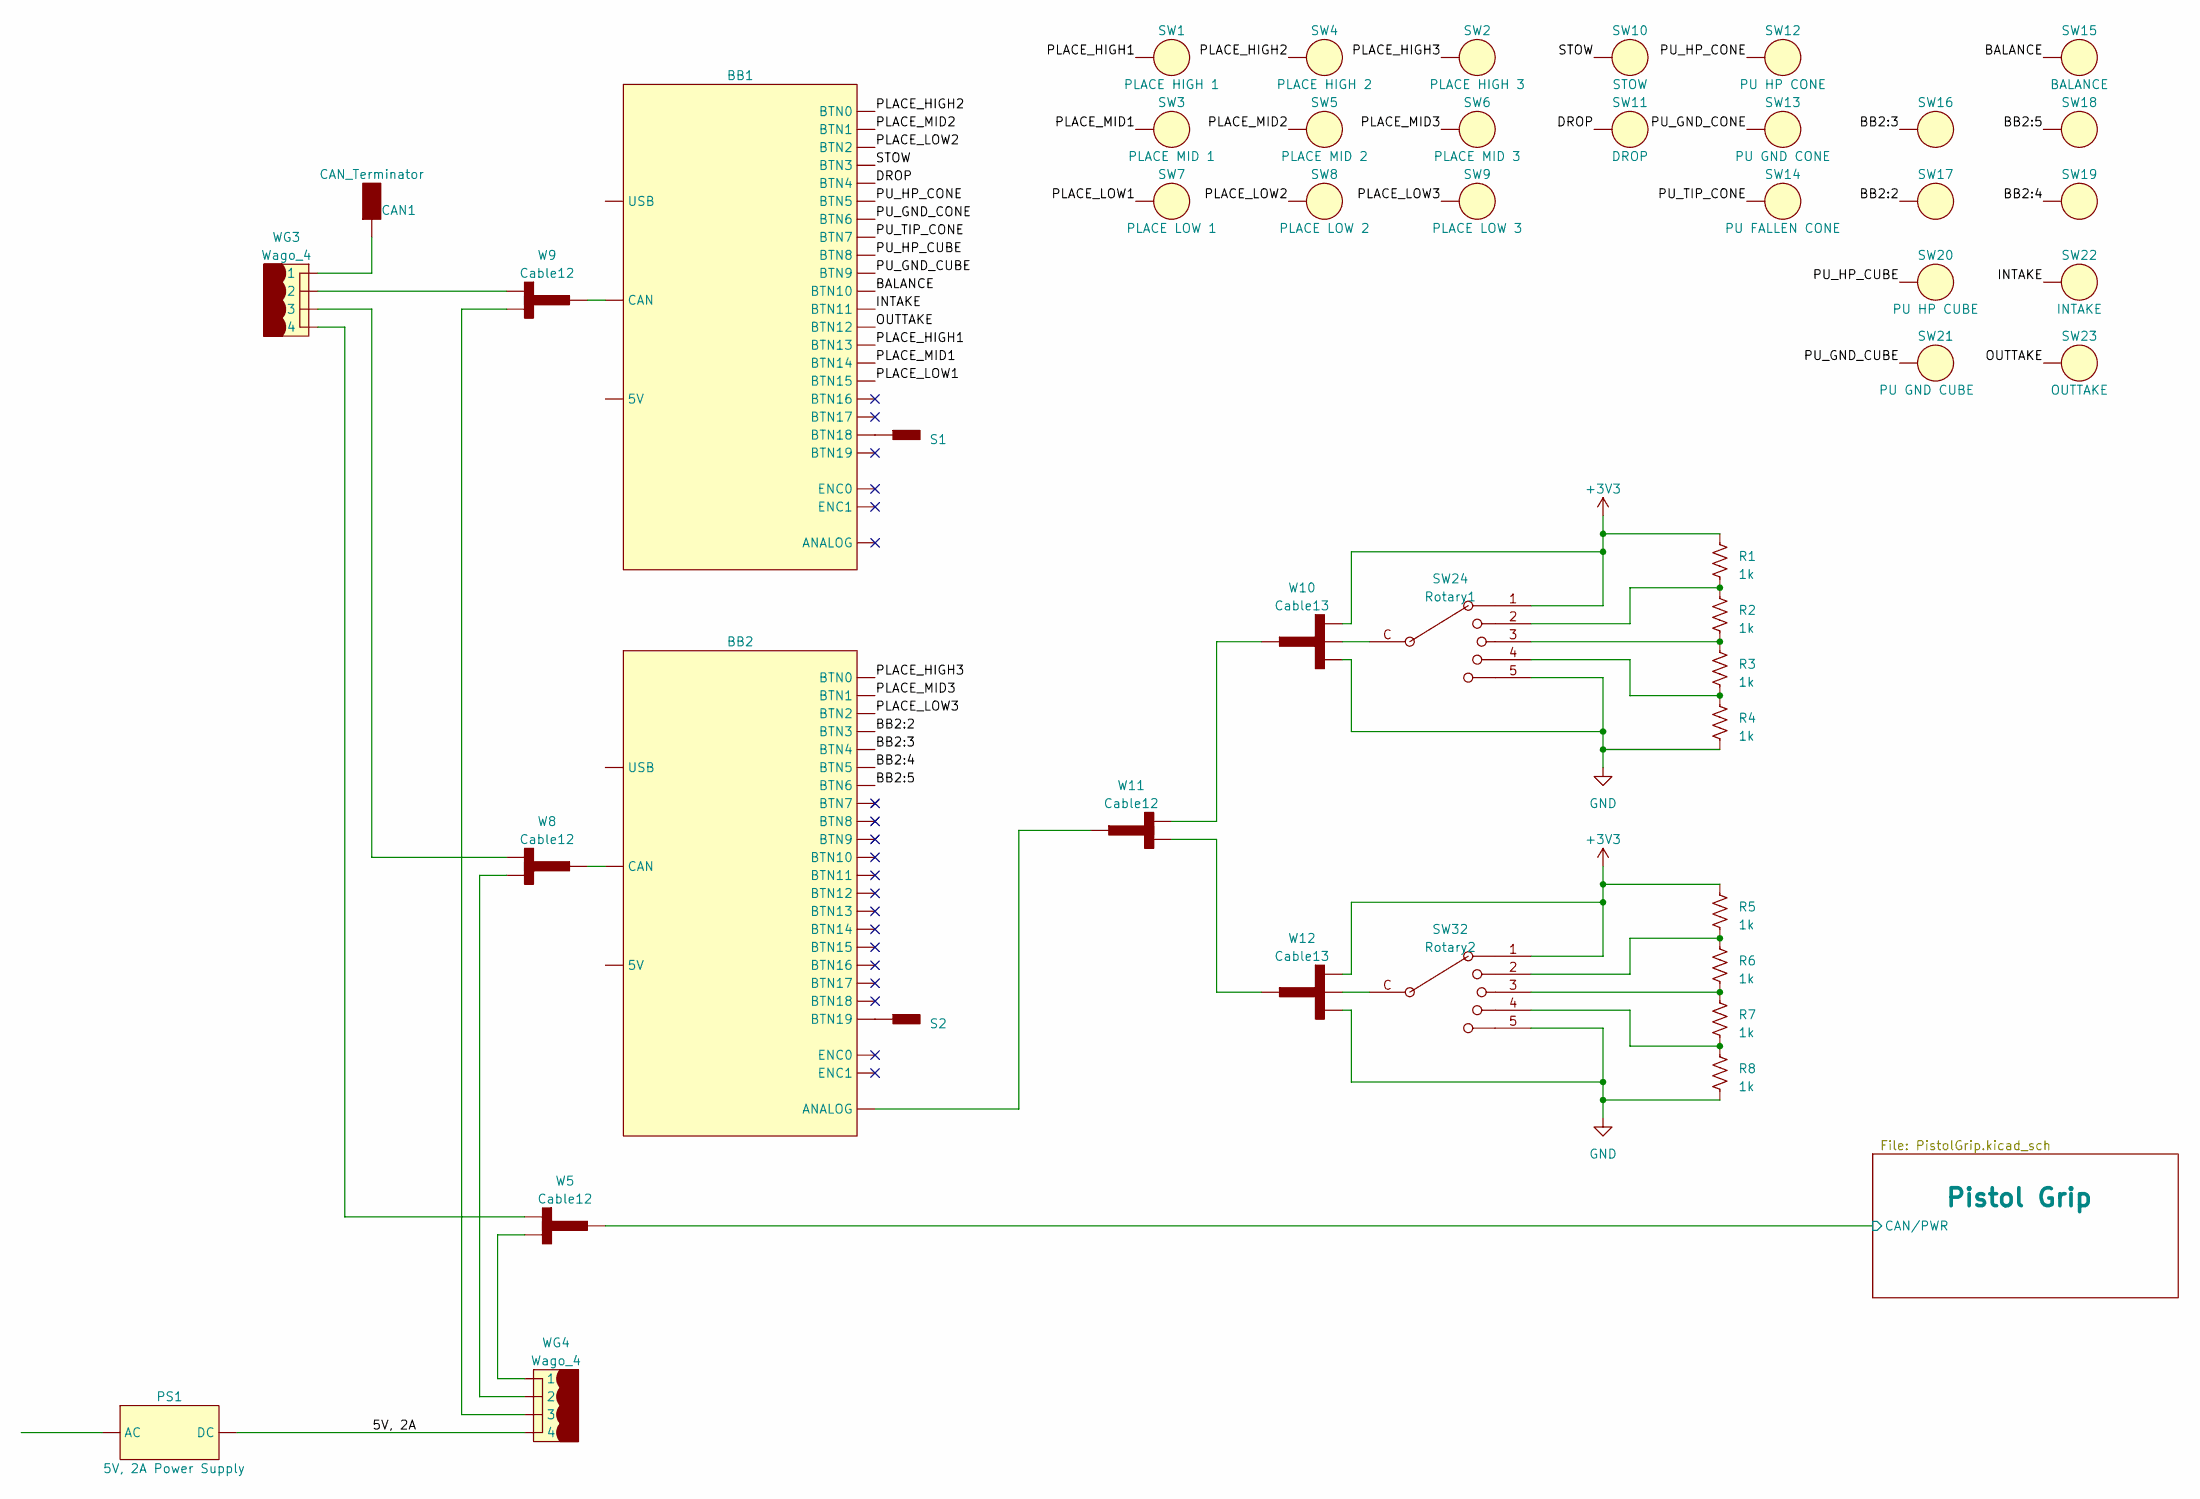
[picture p213: schematic DriverStation.kicad_sch]

Parts:
BB1, BB2: (no value)
CAN1: CAN_Terminator
PS1: 5V, 2A Power Supply
R1, R2, R3, R4, R5, R6, R7, R8: 1k
S1, S2: (no value)
SW1: PLACE HIGH 1
SW2: PLACE HIGH 3
SW3: PLACE MID 1
SW4: PLACE HIGH 2
SW5: PLACE MID 2
SW6: PLACE MID 3
SW7: PLACE LOW 1
SW8: PLACE LOW 2
SW9: PLACE LOW 3
SW10: STOW
SW11: DROP
SW12: PU HP CONE
SW13: PU GND CONE
SW14: PU FALLEN CONE
SW15: BALANCE
SW16, SW17, SW18, SW19: (no value)
SW20: PU HP CUBE
SW21: PU GND CUBE
SW22: INTAKE
SW23: OUTTAKE
SW24: Rotary1
SW32: Rotary2
W5, W8, W9, W11: Cable12
W10, W12: Cable13
WG3, WG4: Wago_4

Connections:
5V, 2A: PS1.2 (DC), WG4.
+3V3: R1.1, R5.1, SW24.1, SW32.1, W10.1, W12.1
BALANCE: BB1., SW15.
BB2:2: BB2., SW17.
BB2:3: BB2., SW16.
BB2:4: BB2., SW19.
BB2:5: BB2., SW18.
CAN/PWR: W5.1
DROP: BB1., SW11.
GND: R4.2, R8.2, SW24.5, SW32.5, W10.1, W12.1
INTAKE: BB1., SW22.
unnamed: BB1., S1., W9.1
unnamed: BB2., S2., W8.1, W11.1
unnamed: CAN1., WG3.
unnamed: R1.2, R2.1, SW24.2
unnamed: R2.2, R3.1, SW24.3
unnamed: R3.2, R4.1, SW24.4
unnamed: R5.2, R6.1, SW32.2
unnamed: R6.2, R7.1, SW32.3
unnamed: R7.2, R8.1, SW32.4
unnamed: SW24.C, W10.1
unnamed: SW32.C, W12.1
unnamed: W5.1, WG3., WG4.
unnamed: W8.1, WG3., WG4.
unnamed: W9.1, WG3., WG4.
unnamed: W10.1, W11.1
unnamed: W11.1, W12.1
OUTTAKE: BB1., SW23.
PLACE_HIGH1: BB1., SW1.
PLACE_HIGH2: BB1., SW4.
PLACE_HIGH3: BB2., SW2.
PLACE_LOW1: BB1., SW7.
PLACE_LOW2: BB1., SW8.
PLACE_LOW3: BB2., SW9.
PLACE_MID1: BB1., SW3.
PLACE_MID2: BB1., SW5.
PLACE_MID3: BB2., SW6.
PU_GND_CONE: BB1., SW13.
PU_GND_CUBE: BB1., SW21.
PU_HP_CONE: BB1., SW12.
PU_HP_CUBE: BB1., SW20.
PU_TIP_CONE: BB1., SW14.
STOW: BB1., SW10.
