frc971/electrical/robots/2023/driver-station/PistolGrip.kicad_sch

## KiCad design robots/2023/driver-station/PistolGrip.kicad_sch (2024-02-22)

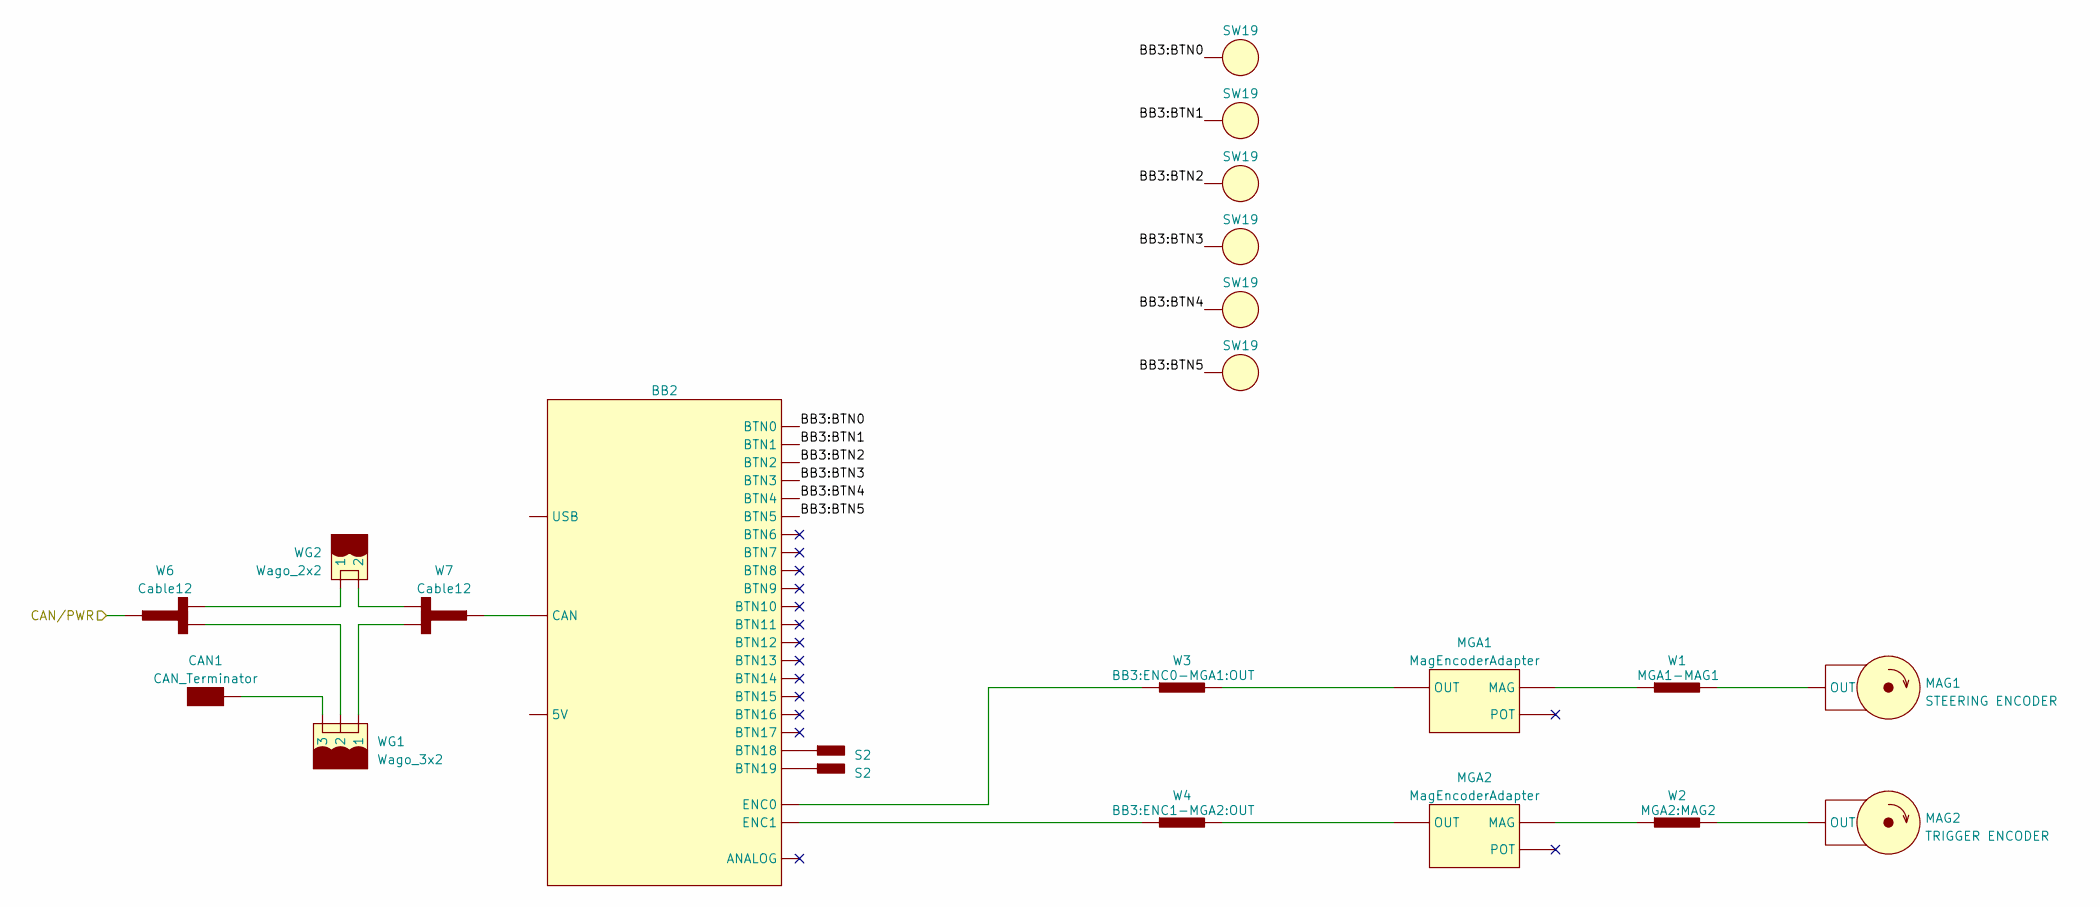
[picture p214: schematic PistolGrip.kicad_sch]

Parts:
BB2: (no value)
CAN1: CAN_Terminator
MAG1: STEERING ENCODER
MAG2: TRIGGER ENCODER
MGA1, MGA2: MagEncoderAdapter
S2: (no value)
SW19: (no value)
W1: MGA1-MAG1
W2: MGA2:MAG2
W3: BB3:ENC0-MGA1:OUT
W4: BB3:ENC1-MGA2:OUT
W6, W7: Cable12
WG1: Wago_3x2
WG2: Wago_2x2

Connections:
BB3:BTN0: BB2., SW19.
BB3:BTN1: BB2., SW19.
BB3:BTN2: BB2., SW19.
BB3:BTN3: BB2., SW19.
BB3:BTN4: BB2., SW19.
BB3:BTN5: BB2., SW19.
CAN/PWR: W6.1
unnamed: BB2., S2., W3.1, W4.1, W7.1
unnamed: CAN1., WG1.
unnamed: MAG1., W1.1
unnamed: MAG2., W2.1
unnamed: MGA1., W1.1, W3.1
unnamed: MGA2., W2.1, W4.1
unnamed: W6.1, WG1., WG2.
unnamed: W7.1, WG1., WG2.
