frc971/electrical/circuit-boards/connector_boards/CAN_Hub/CAN Hub Real/CAN Hub Real.kicad_sch

## KiCad design circuit-boards/connector_boards/CAN_Hub/CAN Hub Real/CAN Hub Real.kicad_sch (2026-11-06)

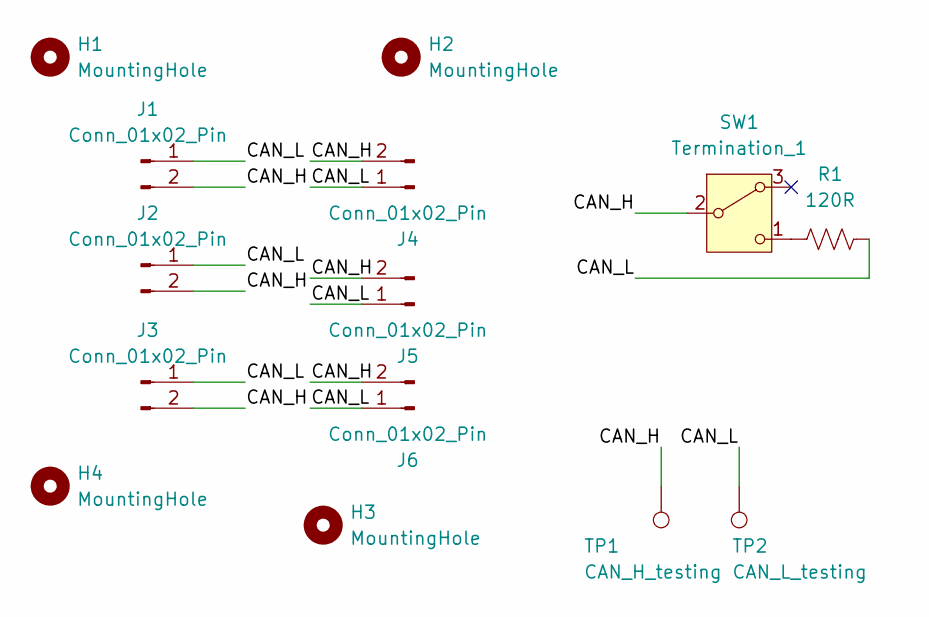
[picture p215: schematic CAN Hub Real.kicad_sch]

Parts:
H1, H2, H3, H4: MountingHole; MountingHole_2.1mm
J1, J2, J3, J4, J5, J6: Conn_01x02_Pin; 70541-0001
R1: 120R; R_0805_2012Metric
SW1: Termination_1; Nidec_Copal_CAS-120A
TP1: CAN_H_testing; TestPoint_Bridge_Pitch2.54mm_Drill1.0mm
TP2: CAN_L_testing; TestPoint_Bridge_Pitch2.54mm_Drill1.0mm

Connections:
CAN_H: J1.2, J2.2, J3.2, J4.2, J5.2, J6.2, SW1.2 (B), TP1.1
CAN_L: J1.1, J2.1, J3.1, J4.1, J5.1, J6.1, R1.2, TP2.1
unnamed: R1.1, SW1.1 (C)
