frc971/electrical/robots/2023/system-drawing/kicad-schematic/2023-SystemDiagram.kicad_sch

## KiCad design robots/2023/system-drawing/kicad-schematic/2023-SystemDiagram.kicad_sch (2023-12-23)

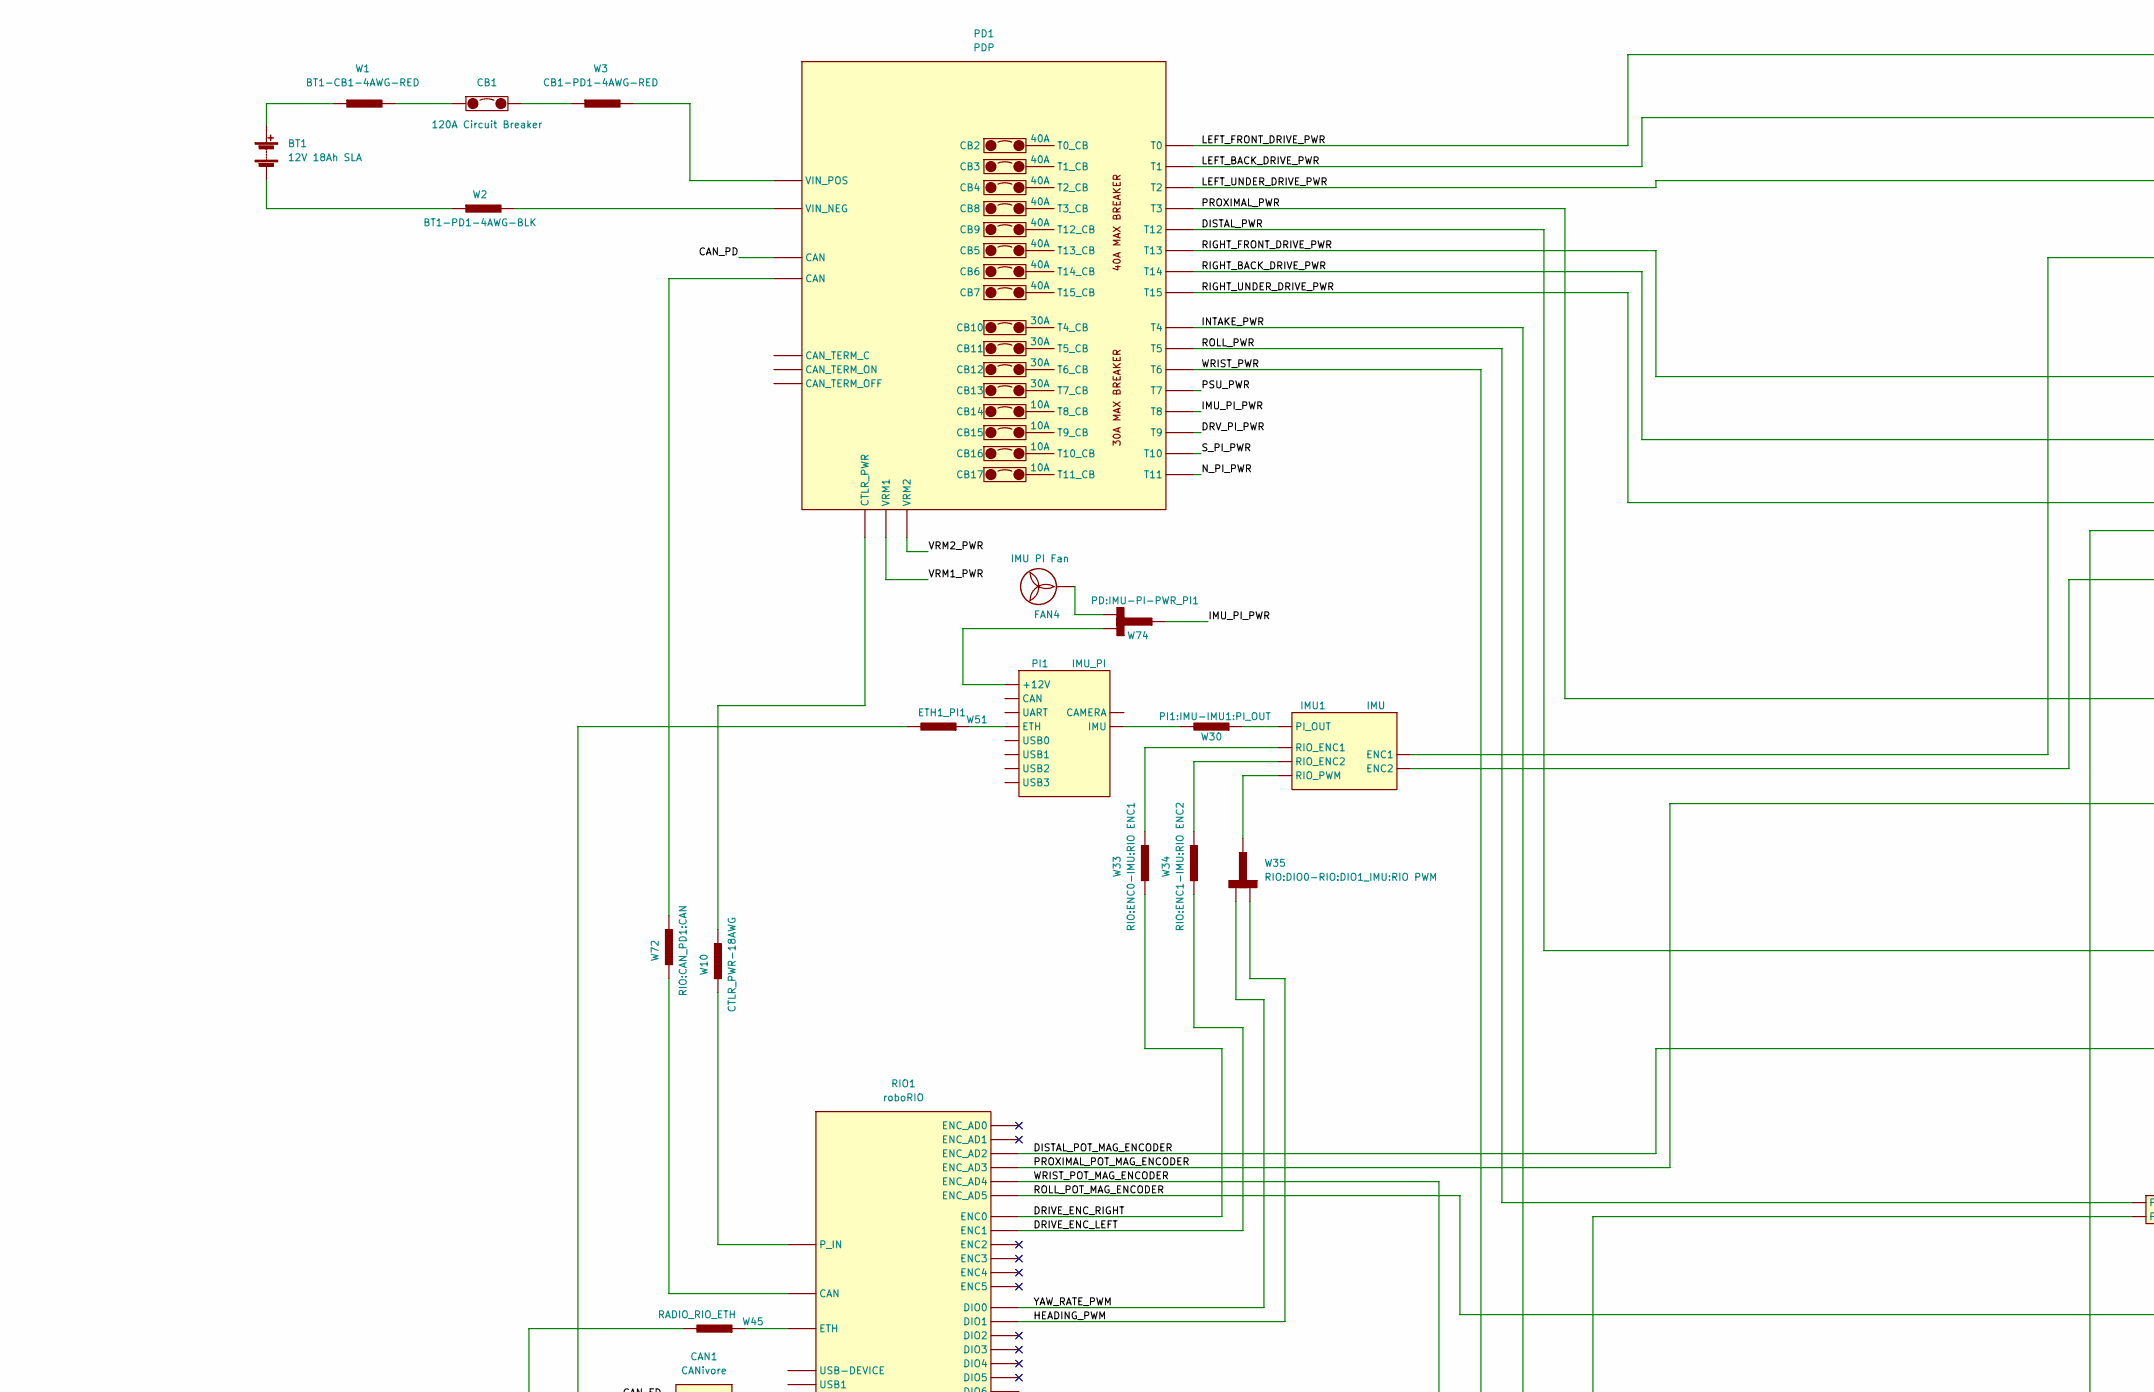
[picture p216: schematic 2023-SystemDiagram.kicad_sch, part in row 1, column 1]

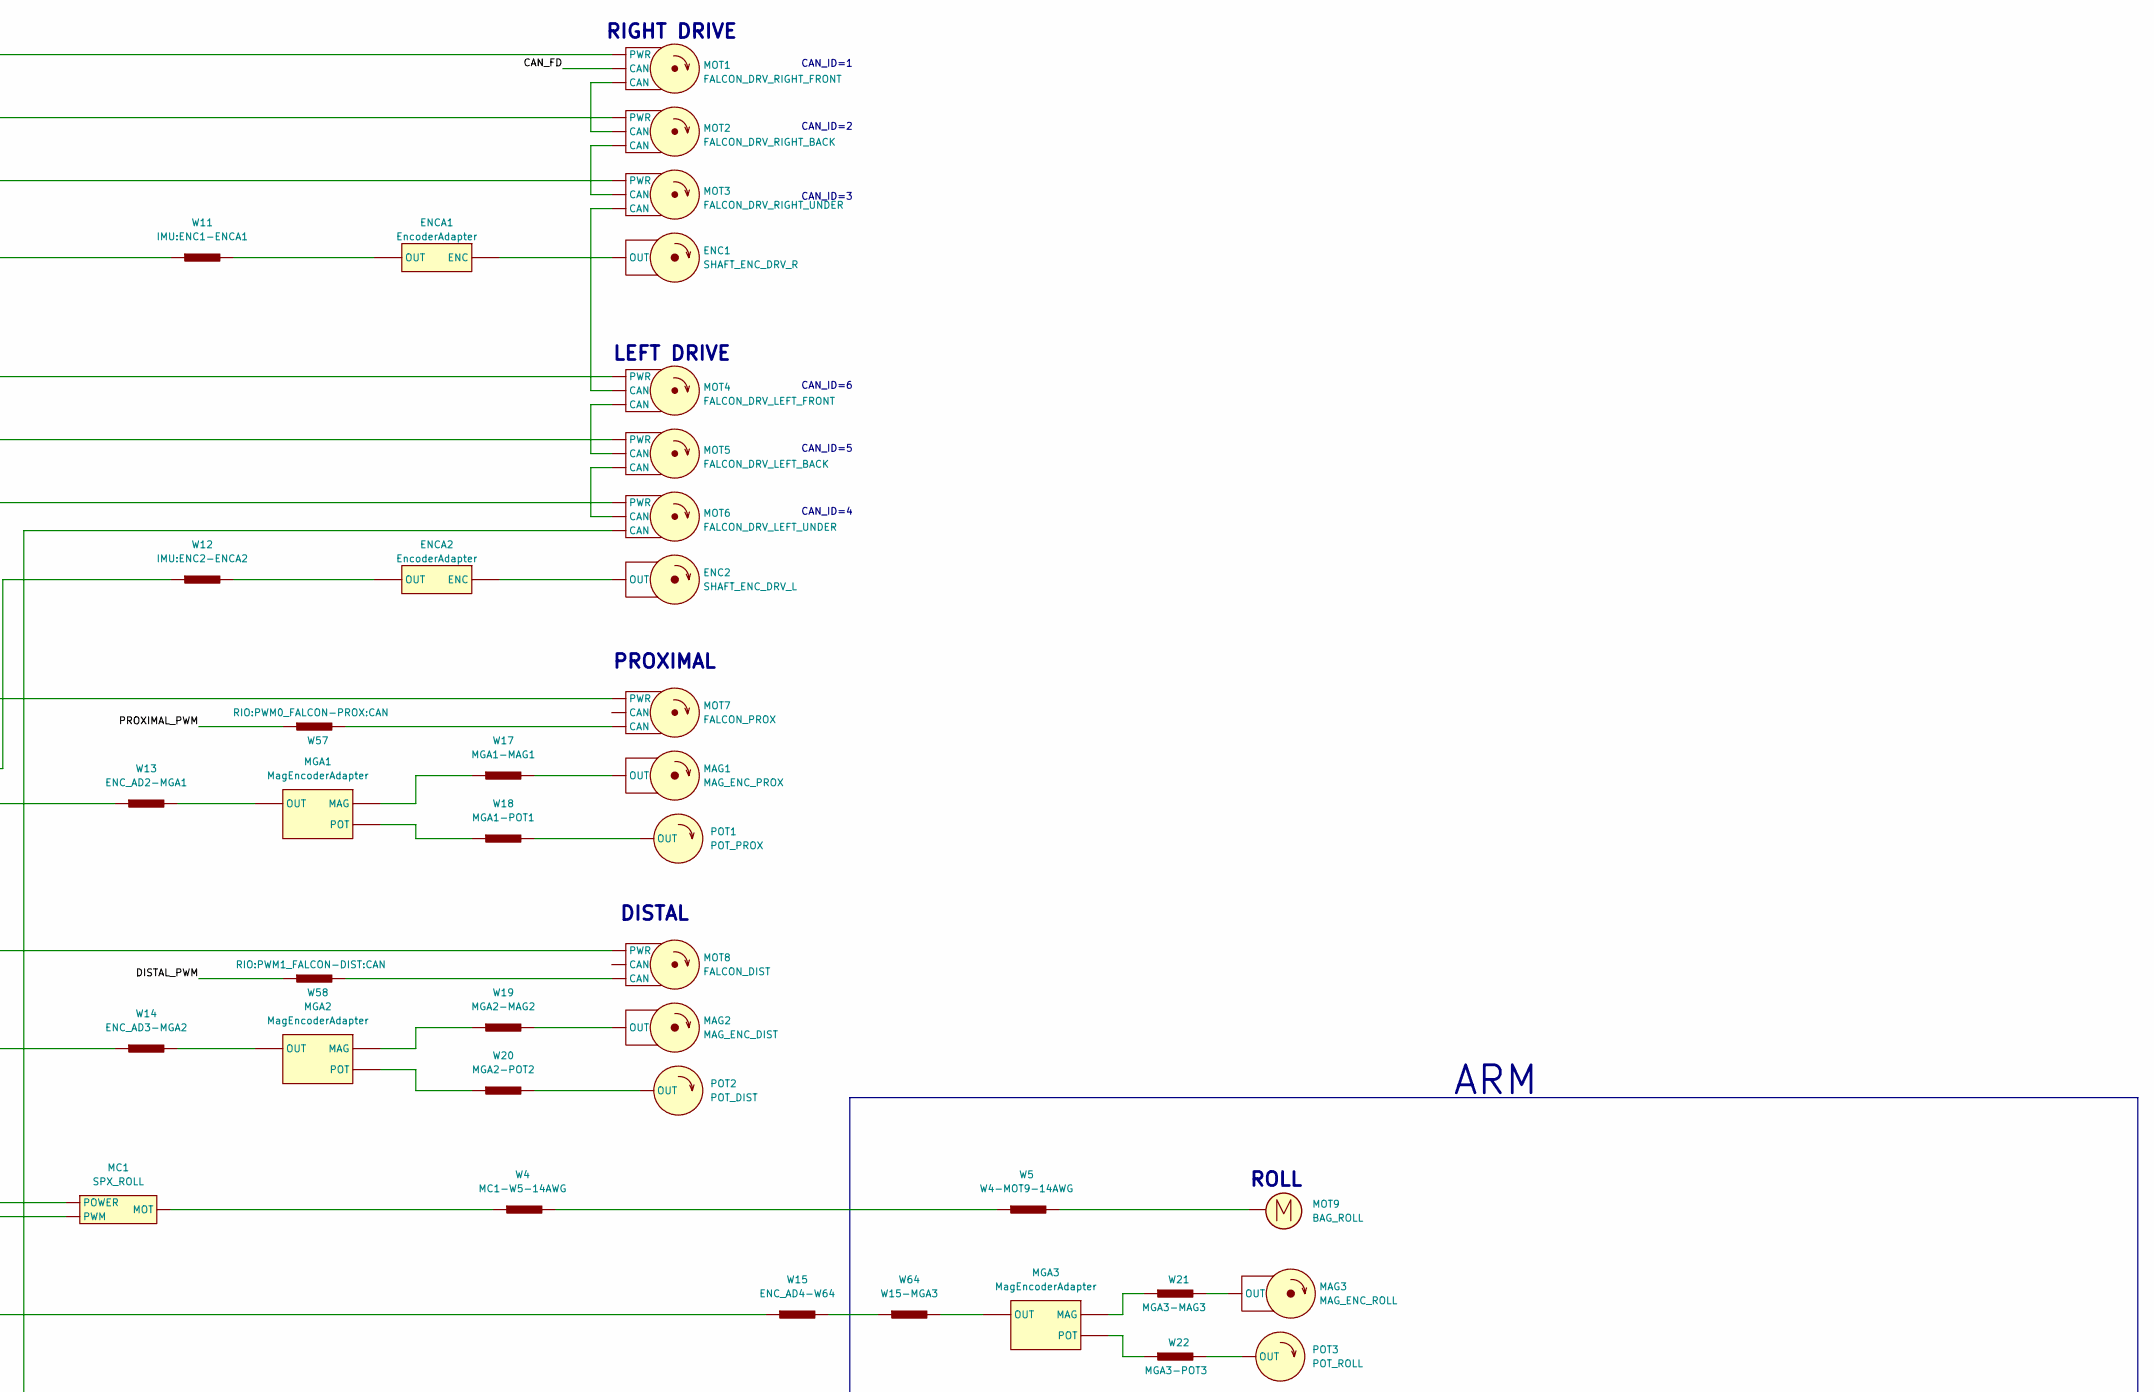
[picture p217: schematic 2023-SystemDiagram.kicad_sch, part in row 1, column 2]

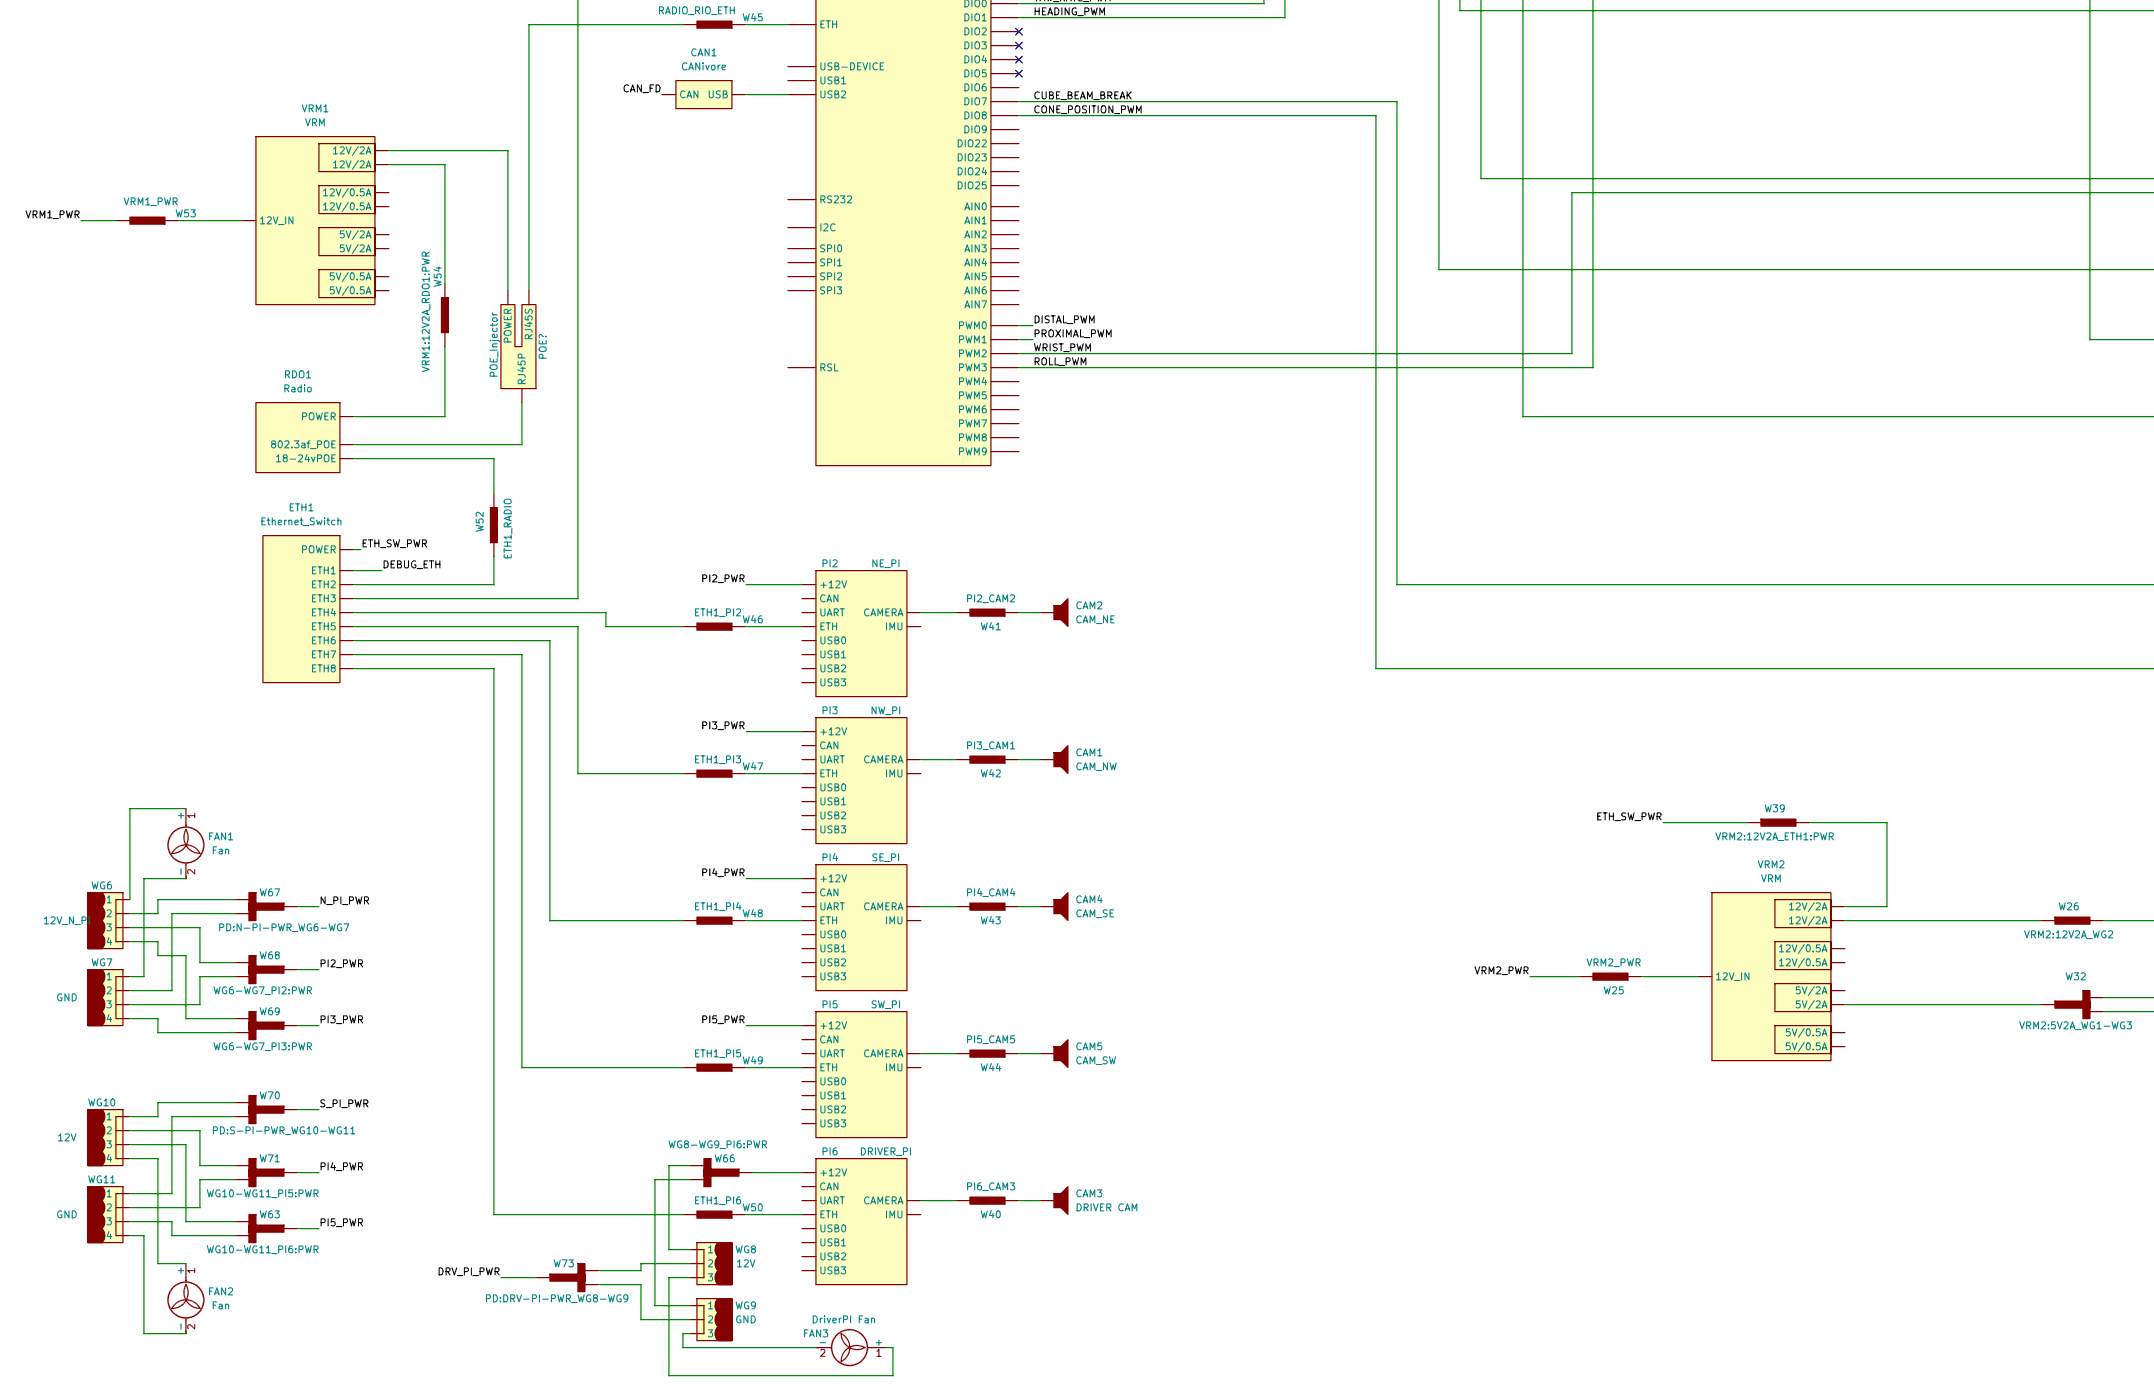
[picture p218: schematic 2023-SystemDiagram.kicad_sch, part in row 2, column 1]

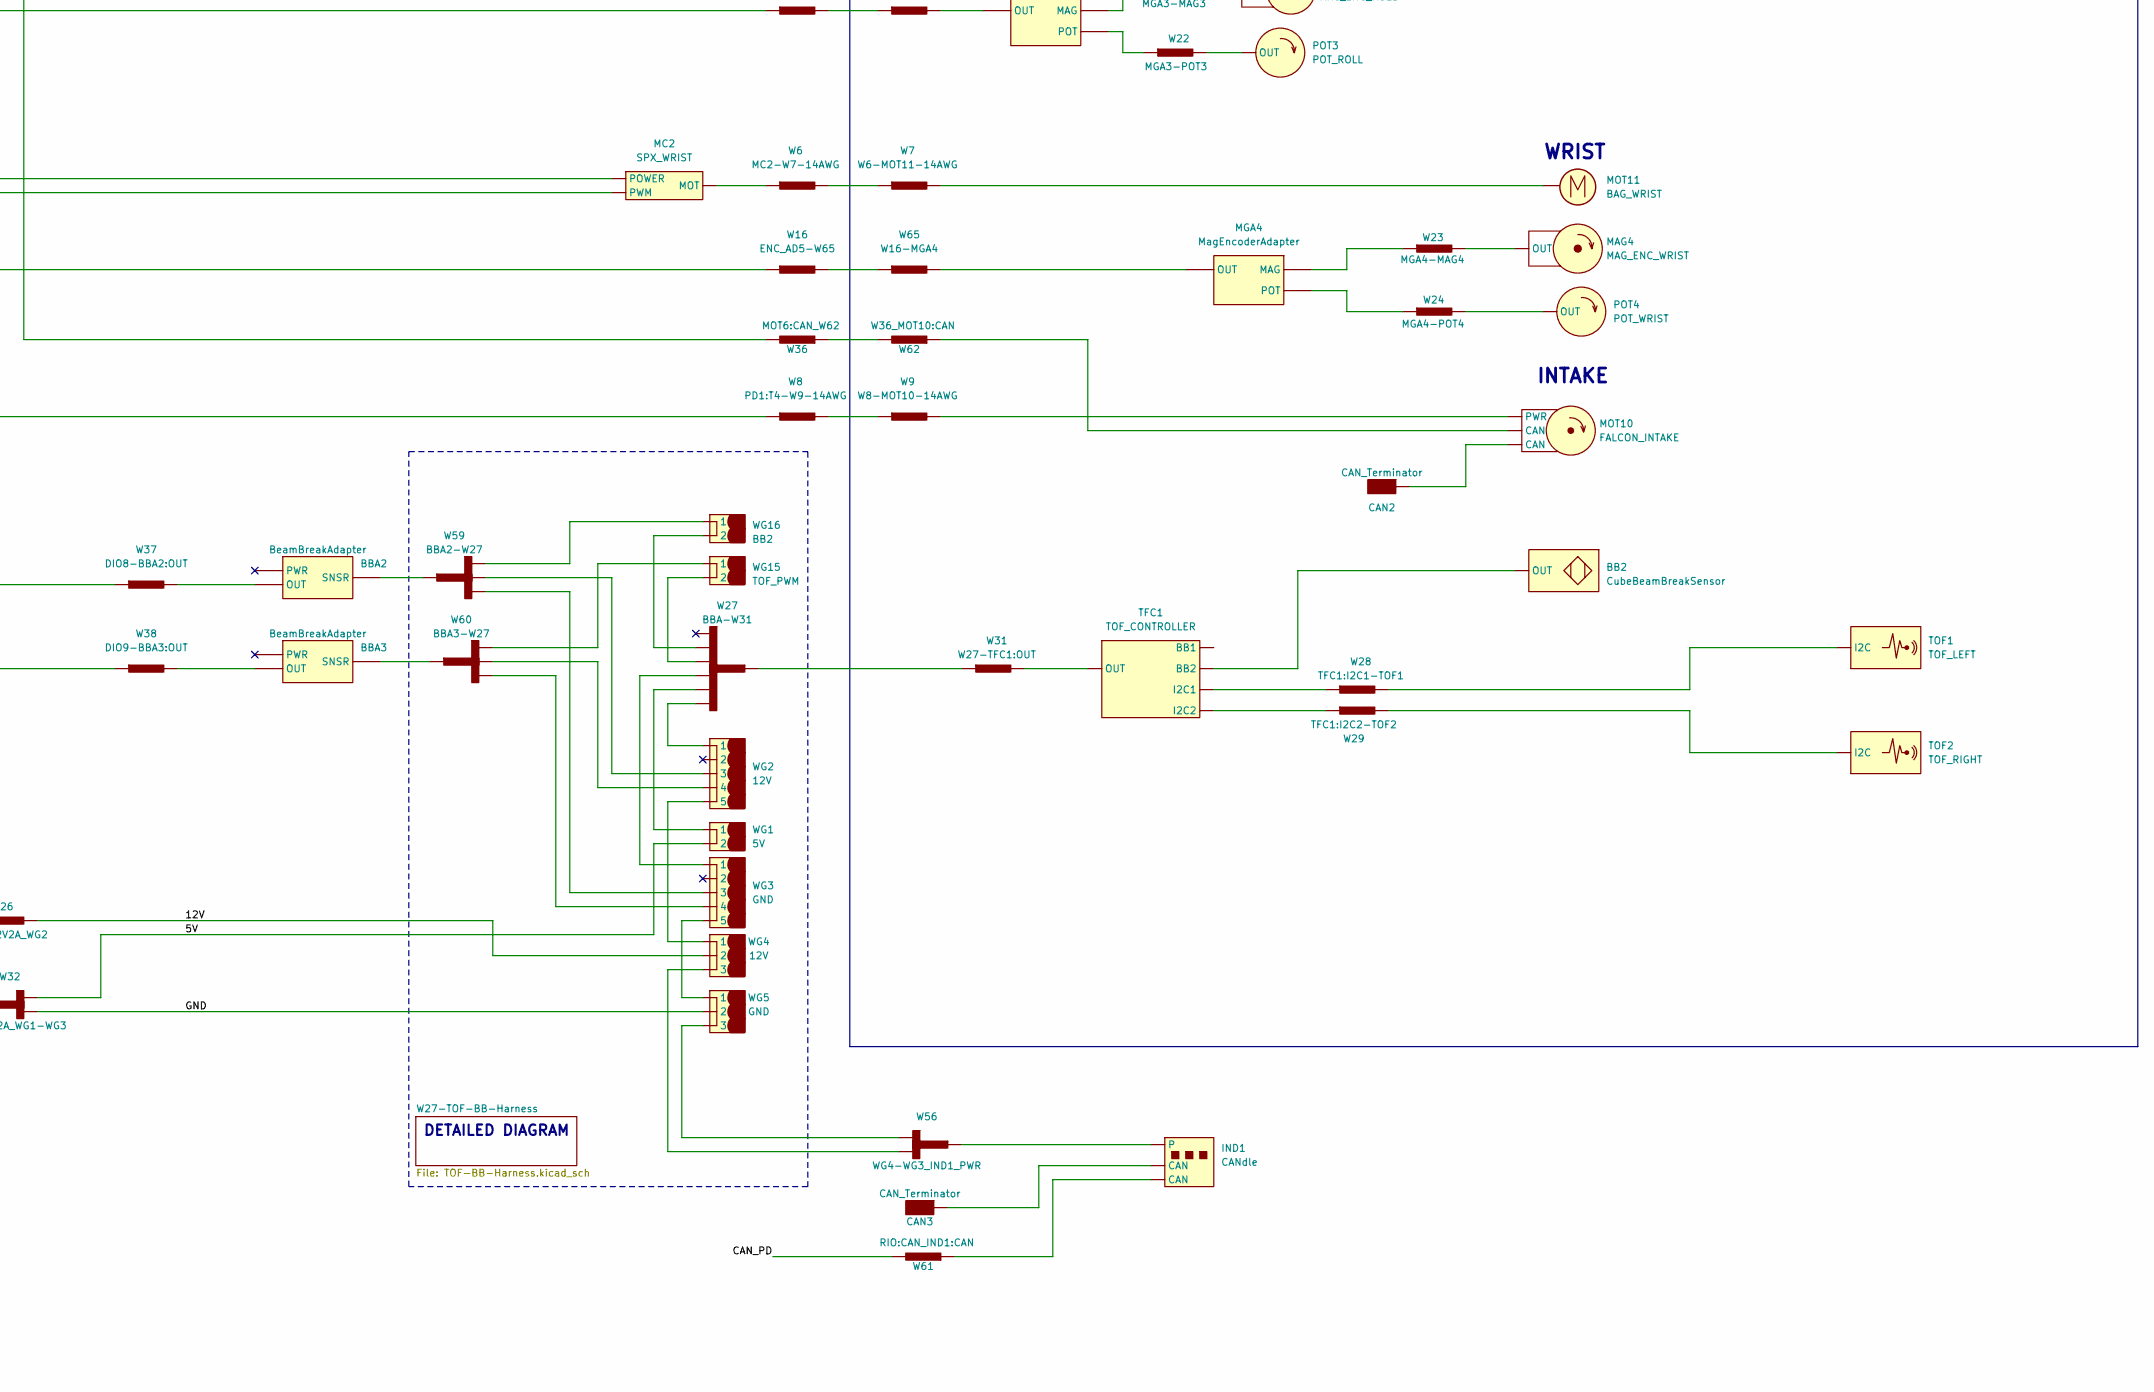
[picture p219: schematic 2023-SystemDiagram.kicad_sch, part in row 2, column 2]

Parts:
BB2: CubeBeamBreakSensor
BBA2, BBA3: BeamBreakAdapter
BT1: 12V 18Ah SLA
CAM1: CAM_NW
CAM2: CAM_NE
CAM3: DRIVER CAM
CAM4: CAM_SE
CAM5: CAM_SW
CAN1: CANivore
CAN2, CAN3: CAN_Terminator
CB1: 120A Circuit Breaker
CB2, CB3, CB4, CB5, CB6, CB7, CB8, CB9: 40A
CB10, CB11, CB12, CB13: 30A
CB14, CB15, CB16, CB17: 10A
ENC1: SHAFT_ENC_DRV_R
ENC2: SHAFT_ENC_DRV_L
ENCA1, ENCA2: EncoderAdapter
ETH1: Ethernet_Switch
FAN1, FAN2: Fan
FAN3: DriverPI Fan
FAN4: IMU PI Fan
IMU1: IMU
IND1: CANdle
MAG1: MAG_ENC_PROX; MFG P/N SRX MAG ENCODER
MAG2: MAG_ENC_DIST; MFG P/N SRX MAG ENCODER
MAG3: MAG_ENC_ROLL; MFG P/N SRX MAG ENCODER
MAG4: MAG_ENC_WRIST; MFG P/N SRX MAG ENCODER
MC1: SPX_ROLL; MFG P/N 217-9191
MC2: SPX_WRIST; MFG P/N 217-9191
MGA1, MGA2, MGA3, MGA4: MagEncoderAdapter
MOT1: FALCON_DRV_RIGHT_FRONT
MOT2: FALCON_DRV_RIGHT_BACK
MOT3: FALCON_DRV_RIGHT_UNDER
MOT4: FALCON_DRV_LEFT_FRONT
MOT5: FALCON_DRV_LEFT_BACK
MOT6: FALCON_DRV_LEFT_UNDER
MOT7: FALCON_PROX
MOT8: FALCON_DIST
MOT9: BAG_ROLL; MFG P/N 217-3351
MOT10: FALCON_INTAKE
MOT11: BAG_WRIST; MFG P/N 217-3351
PD1: PDP; MFG P/N Power Distribution Panel
PI1: IMU_PI
PI2: NE_PI
PI3: NW_PI
PI4: SE_PI
PI5: SW_PI
PI6: DRIVER_PI
POT1: POT_PROX
POT2: POT_DIST
POT3: POT_ROLL
POT4: POT_WRIST
RDO1: Radio
RIO1: roboRIO
TFC1: TOF_CONTROLLER
TOF1: TOF_LEFT
TOF2: TOF_RIGHT
VRM1, VRM2: VRM
W1: BT1-CB1-4AWG-RED
W2: BT1-PD1-4AWG-BLK
W3: CB1-PD1-4AWG-RED
W4: MC1-W5-14AWG
W5: W4-MOT9-14AWG
W6: MC2-W7-14AWG
W7: W6-MOT11-14AWG
W8: PD1:T4-W9-14AWG
W9: W8-MOT10-14AWG
W10: CTLR_PWR-18AWG
W11: IMU:ENC1-ENCA1
W12: IMU:ENC2-ENCA2
W13: ENC_AD2-MGA1
W14: ENC_AD3-MGA2
W15: ENC_AD4-W64
W16: ENC_AD5-W65
W17: MGA1-MAG1
W18: MGA1-POT1
W19: MGA2-MAG2
W20: MGA2-POT2
W21: MGA3-MAG3
W22: MGA3-POT3
W23: MGA4-MAG4
W24: MGA4-POT4
W25: VRM2_PWR
W26: VRM2:12V2A_WG2
W27: BBA-W31
W28: TFC1:I2C1-TOF1
W29: TFC1:I2C2-TOF2
W30: PI1:IMU-IMU1:PI_OUT
W31: W27-TFC1:OUT
W32: VRM2:5V2A_WG1-WG3
W33: RIO:ENC0-IMU:RIO ENC1
W34: RIO:ENC1-IMU:RIO ENC2
W35: RIO:DIO0-RIO:DIO1_IMU:RIO PWM
W36: MOT6:CAN_W62
W37: DIO8-BBA2:OUT
W38: DIO9-BBA3:OUT
W39: VRM2:12V2A_ETH1:PWR
W40: PI6_CAM3
W41: PI2_CAM2
W42: PI3_CAM1
W43: PI4_CAM4
W44: PI5_CAM5
W45: RADIO_RIO_ETH
W46: ETH1_PI2
W47: ETH1_PI3
W48: ETH1_PI4
W49: ETH1_PI5
W50: ETH1_PI6
W51: ETH1_PI1
W52: ETH1_RADIO
W53: VRM1_PWR
W54: VRM1:12V2A_RDO1:PWR
W56: WG4-WG3_IND1_PWR
W57: RIO:PWM0_FALCON-PROX:CAN
W58: RIO:PWM1_FALCON-DIST:CAN
W59: BBA2-W27
W60: BBA3-W27
W61: RIO:CAN_IND1:CAN
W62: W36_MOT10:CAN
W63: WG10-WG11_PI6:PWR
W64: W15-MGA3
W65: W16-MGA4
W66: WG8-WG9_PI6:PWR
W67: PD:N-PI-PWR_WG6-WG7
W68: WG6-WG7_PI2:PWR
W69: WG6-WG7_PI3:PWR
W70: PD:S-PI-PWR_WG10-WG11
W71: WG10-WG11_PI5:PWR
W72: RIO:CAN_PD1:CAN
W73: PD:DRV-PI-PWR_WG8-WG9
W74: PD:IMU-PI-PWR_PI1
WG1: 5V
WG2, WG4, WG8, WG10: 12V
WG3, WG5, WG7, WG9, WG11: GND
WG6: 12V_N_PI
WG15: TOF_PWM
WG16: BB2

Connections:
5V: W32.1, WG1.
12V: W26.1, WG4.
CAN_FD: CAN1., MOT1.
CAN_PD: PD1.CAN, W61.1
CONE_POSITION_PWM: RIO1.DIO8, W38.1
CUBE_BEAM_BREAK: RIO1.DIO7, W37.1
DEBUG_ETH: ETH1.
DISTAL_POT_MAG_ENCODER: RIO1.ENC_AD2, W14.1
DISTAL_PWM: RIO1.PWM0, W58.1
DISTAL_PWR: MOT8., PD1.T12
DRIVE_ENC_LEFT: RIO1.ENC1, W34.1
DRIVE_ENC_RIGHT: RIO1.ENC0, W33.1
DRV_PI_PWR: PD1.T9, W73.1
ETH_SW_PWR: ETH1., W39.1
GND: W32.1, WG5.
HEADING_PWM: RIO1.DIO1, W35.1
IMU_PI_PWR: PD1.T8, W74.1
INTAKE_PWR: PD1.T4, W8.1
LEFT_BACK_DRIVE_PWR: MOT2., PD1.T1
LEFT_FRONT_DRIVE_PWR: MOT1., PD1.T0
LEFT_UNDER_DRIVE_PWR: MOT3., PD1.T2
N_PI_PWR: PD1.T11, W67.1
unnamed: BB2., TFC1.
unnamed: BBA2., W37.1, W59.1
unnamed: BBA3., W38.1, W60.1
unnamed: BT1.1 (+), W1.1
unnamed: BT1.2 (-), W2.1
unnamed: CAM1., W42.1
unnamed: CAM2., W41.1
unnamed: CAM3., W40.1
unnamed: CAM4., W43.1
unnamed: CAM5., W44.1
unnamed: CAN1., RIO1.USB2
unnamed: CAN2., MOT10.
unnamed: CAN3., IND1.
unnamed: CB1.CB, W1.1, W3.1
unnamed: CB2.CB, PD1.T0_CB+ (T0_CB)
unnamed: CB3.CB, PD1.T1_CB+ (T1_CB)
unnamed: CB4.CB, PD1.T2_CB+ (T2_CB)
unnamed: CB5.CB, PD1.T13_CB+ (T13_CB)
unnamed: CB6.CB, PD1.T14_CB+ (T14_CB)
unnamed: CB7.CB, PD1.T15_CB+ (T15_CB)
unnamed: CB8.CB, PD1.T3_CB+ (T3_CB)
unnamed: CB9.CB, PD1.T12_CB+ (T12_CB)
unnamed: CB10.CB, PD1.T4_CB+ (T4_CB)
unnamed: CB11.CB, PD1.T5_CB+ (T5_CB)
unnamed: CB12.CB, PD1.T6_CB+ (T6_CB)
unnamed: CB13.CB, PD1.T7_CB+ (T7_CB)
unnamed: CB14.CB, PD1.T8_CB+ (T8_CB)
unnamed: CB15.CB, PD1.T9_CB+ (T9_CB)
unnamed: CB16.CB, PD1.T10_CB+ (T10_CB)
unnamed: CB17.CB, PD1.T11_CB+ (T11_CB)
unnamed: ENC1., ENCA1.
unnamed: ENC2., ENCA2.
unnamed: ENCA1., W11.1
unnamed: ENCA2., W12.1
unnamed: ETH1., W46.1, W47.1, W48.1, W49.1, W50.1, W51.1, W52.1
unnamed: FAN1.1 (+), WG6.
unnamed: FAN1.2 (-), WG7.
unnamed: FAN2.1 (+), WG10.
unnamed: FAN2.2 (-), WG11.
unnamed: FAN3.1 (+), WG8.
unnamed: FAN3.2 (-), WG9.
unnamed: FAN4., W74.1
unnamed: IMU1., W11.1, W12.1, W30.1, W33.1, W34.1, W35.1
unnamed: IND1., W56.1, W61.1
unnamed: MAG1., W17.1
unnamed: MAG2., W19.1
unnamed: MAG3., W21.1
unnamed: MAG4., W23.1
unnamed: MC1., W4.1
unnamed: MC2., W6.1
unnamed: MGA1., W13.1, W17.1, W18.1
unnamed: MGA2., W14.1, W19.1, W20.1
unnamed: MGA3., W21.1, W22.1, W64.1
unnamed: MGA4., W23.1, W24.1, W65.1
unnamed: MOT1., MOT2.
unnamed: MOT2., MOT3.
unnamed: MOT3., MOT4.
unnamed: MOT4., MOT5.
unnamed: MOT5., MOT6.
unnamed: MOT6., W36.1
unnamed: MOT7., W57.1
unnamed: MOT8., W58.1
unnamed: MOT9., W5.1
unnamed: MOT10., W9.1, W62.1
unnamed: MOT11., W7.1
unnamed: PD1.CAN, W72.1
unnamed: PD1.CTLR_PWR, W10.1
unnamed: PD1.VIN_NEG, W2.1
unnamed: PD1.VIN_POS, W3.1
unnamed: PI1., W30.1, W51.1, W74.1
unnamed: PI2., W41.1, W46.1
unnamed: PI3., W42.1, W47.1
unnamed: PI4., W43.1, W48.1
unnamed: PI5., W44.1, W49.1
unnamed: PI6., W40.1, W50.1, W66.1
unnamed: POT1., W18.1
unnamed: POT2., W20.1
unnamed: POT3., W22.1
unnamed: POT4., W24.1
unnamed: RDO1., W52.1, W54.1
unnamed: RIO1.CAN, W72.1
unnamed: RIO1.ETH, W45.1
unnamed: RIO1.INPUT_V (P_IN), W10.1
unnamed: TFC1., W28.1, W29.1, W31.1
unnamed: TOF1., W28.1
unnamed: TOF2., W29.1
unnamed: VRM1., W53.1, W54.1
unnamed: VRM2., W25.1, W26.1, W32.1, W39.1
unnamed: W4.1, W5.1
unnamed: W6.1, W7.1
unnamed: W8.1, W9.1
unnamed: W15.1, W64.1
unnamed: W16.1, W65.1
unnamed: W27.1, W31.1, WG1., WG2., WG3., WG15., WG16.
unnamed: W36.1, W62.1
unnamed: W56.1, WG4., WG5.
unnamed: W59.1, WG2., WG3., WG16.
unnamed: W60.1, WG2., WG3., WG15.
unnamed: W63.1, WG10., WG11.
unnamed: W66.1, WG8., WG9.
unnamed: W67.1, WG6., WG7.
unnamed: W68.1, WG6., WG7.
unnamed: W69.1, WG6., WG7.
unnamed: W70.1, WG10., WG11.
unnamed: W71.1, WG10., WG11.
unnamed: W73.1, WG8., WG9.
unnamed: WG2., WG4.
unnamed: WG3., WG5.
PI2_PWR: PI2., W68.1
PI3_PWR: PI3., W69.1
PI4_PWR: PI4., W71.1
PI5_PWR: PI5., W63.1
PROXIMAL_POT_MAG_ENCODER: RIO1.ENC_AD3, W13.1
PROXIMAL_PWM: RIO1.PWM1, W57.1
PROXIMAL_PWR: MOT7., PD1.T3
PSU_PWR: PD1.T7
RIGHT_BACK_DRIVE_PWR: MOT5., PD1.T14
RIGHT_FRONT_DRIVE_PWR: MOT4., PD1.T13
RIGHT_UNDER_DRIVE_PWR: MOT6., PD1.T15
ROLL_POT_MAG_ENCODER: RIO1.ENC_AD5, W15.1
ROLL_PWM: MC1., RIO1.PWM3
ROLL_PWR: MC1., PD1.T5
S_PI_PWR: PD1.T10, W70.1
VRM1_PWR: PD1.VRM1, W53.1
VRM2_PWR: PD1.VRM2, W25.1
WRIST_POT_MAG_ENCODER: RIO1.ENC_AD4, W16.1
WRIST_PWM: MC2., RIO1.PWM2
WRIST_PWR: MC2., PD1.T6
YAW_RATE_PWM: RIO1.DIO0, W35.1

Notes on the sheet:
DETAILED DIAGRAM
CAN_ID=1
CAN_ID=2
ARM
RIGHT DRIVE
CAN_ID=4
ROLL
PROXIMAL
INTAKE
CAN_ID=6
LEFT DRIVE
CAN_ID=3
CAN_ID=5
WRIST
DISTAL
