frc971/electrical/robots/2023/system-drawing/kicad-schematic/TOF-BB-Harness.kicad_sch

## KiCad design robots/2023/system-drawing/kicad-schematic/TOF-BB-Harness.kicad_sch (2023-12-23)

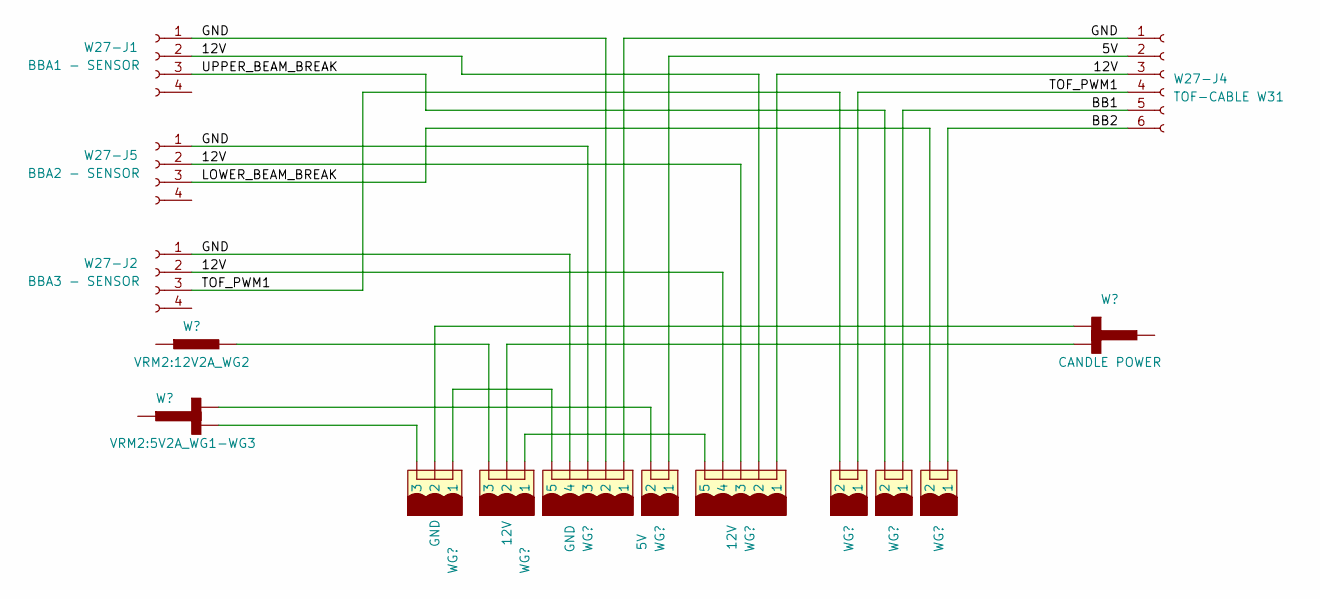
[picture p220: schematic TOF-BB-Harness.kicad_sch]

Parts:
W27-J1: BBA1 - SENSOR
W27-J2: BBA3 - SENSOR
W27-J4: TOF-CABLE W31
W27-J5: BBA2 - SENSOR
W27-W1: VRM2:12V2A_WG2
W27-W2: VRM2:5V2A_WG1-WG3
W27-W55: CANDLE POWER
W27-WG12: 5V
W27-WG13, W27-WG15: 12V
W27-WG14, W27-WG16: GND
WG12, WG13, WG14: 5V

Connections:
5V: W27-J4.2, W27-WG12.
12V: W27-J1.2, W27-J2.2, W27-J4.3, W27-J5.2, W27-WG15.
BB1: W27-J4.5, WG13.
BB2: W27-J4.6, WG14.
GND: W27-J1.1, W27-J2.1, W27-J4.1, W27-J5.1, W27-WG16.
LOWER_BEAM_BREAK: W27-J5.3, WG14.
unnamed: W27-W1.1, W27-WG13.
unnamed: W27-W2.1, W27-WG12., W27-WG14.
unnamed: W27-W55.1, W27-WG13., W27-WG14.
unnamed: W27-WG13., W27-WG15.
unnamed: W27-WG14., W27-WG16.
TOF_PWM1: W27-J2.3, W27-J4.4, WG12.
UPPER_BEAM_BREAK: W27-J1.3, WG13.
