frc971/electrical/circuit-boards/IMU-2X-v3/STM32CubeMX/STM32CubeMX.ioc

Mcu.UserName=STM32G473RETx
PA11.Signal=USB_DM
PA12.Signal=USB_DP
PA13.Signal=SYS_JTMS-SWDIO
PA14.Signal=SYS_JTCK-SWCLK
PA15.Signal=SPI3_NSS
PA3.GPIO_Label=RESET_UNOn
PA3.Signal=GPIO_Output
PA4.Signal=SPI1_NSS
PA5.Signal=SPI1_SCK
PA6.Signal=SPI1_MISO
PA7.Signal=SPI1_MOSI
PA8.Signal=ADC5_IN1
PB12.Signal=SPI2_NSS
PB13.Signal=SPI2_SCK
PB14.Signal=SPI2_MISO
PB15.Signal=SPI2_MOSI
PB3.GPIO_Label=INT_TDK
PB3.Signal=GPIO_Input
PB4.GPIO_Label=TDK_ENn
PB4.Signal=GPIO_Input
PB5.Signal=FDCAN2_RX
PB6.Signal=FDCAN2_TX
PB7.GPIO_Label=FDCAN_STBY
PB7.Signal=GPIO_Output
PC0.GPIO_Label=LED_RED/GRN
PC0.Signal=GPIO_Output
PC1.GPIO_Label=LED_GRN/RED
PC1.Signal=GPIO_Output
PC10.Signal=SPI3_SCK
PC11.Signal=SPI3_MISO
PC12.Signal=SPI3_MOSI
PC4.Signal=USART1_TX
PC5.Signal=USART1_RX
PC6.GPIO_Label=RESET_DUEn
PC6.Signal=GPIO_Output
PD2.GPIO_Label=FSYNC_TDK_ST
PD2.Signal=GPIO_Input
PF0-OSC_IN.Signal=RCC_OSC_IN
