frc971/electrical/(commit log)

2023-12-22 Initial creation of the NX-J401-Adapter board"
    [1-1734248-5.step, 2601-1102.stp, 705410001.stp, 705430001.stp, 705430003.stp, 705550001.stp, 705550002.stp, 705550003.stp]
2023-12-23 Posting 2023 robot schematic
    [2023-SystemDiagram.kicad_pcb, 2023-SystemDiagram.kicad_sch, TOF-BB-Harness.kicad_sch]
2023-12-23 Move NX-J401-Adapter PCB to new location under PCBs
    [1-1734248-5.step, 2601-1102.stp, 705410001.stp, 705430001.stp, 705430003.stp, 705550001.stp, 705550002.stp, 705550003.stp]
2023-12-23 Adding NX-IndicatorBoard to repo
    [705410006.stp, 705430003.stp, 705430005.stp, 705550001.stp, 705550002.stp, 705550003.stp, 705550005.stp, IND_IHLP-1212BZ_VIS.step]
2023-12-23 Adding IMU-2x to the repo. NOTE: Switch footprints are bad.
    [705410001.stp, 705430036.stp, 705550001.stp, 705550002.stp, 705550003.stp, 705550005.stp, CNC-Tech-3220-14-0300-00.step, ECS-5032MV-400-CN-TR.STEP]
2023-12-23 Adding IMU-2X-v2 fixes switch footprint.
    [IMU-2X-B_Cu.gbr, IMU-2X-B_Mask.gbr, IMU-2X-B_Paste.gbr, IMU-2X-B_Silkscreen.gbr, IMU-2X-Edge_Cuts.gbr, IMU-2X-F_Cu.gbr, IMU-2X-F_Mask.gbr, IMU-2X-F_Paste.gbr]
2023-12-23 Add RPI power boards to repo from 971-Robot-Code
    [3V3-3V0-power-supply.kicad_sch, 3V3-power-supply.kicad_sch, 705550001.stp, 705550002.stp, 705550003.stp, 705550011.stp, 744031001_Download_STP_WE-TPC-3816_rev1.stp, ECS-5032MV-400-CN-TR.STEP]
2023-12-23 Moving connector_boards, hall-effect, led-ring-driver, and RspPiPicoIMU
    [015913034.stp, 10 SIZE CODE G-L.stp, 150080AS75000_Download_STP_WL-SMCW-0805_rev1.stp, 20021521-00010XXLFc.stp, 430450601.stp, 705410001.stp, 705410002.stp, 705410003.stp]
2023-12-23 Adding MIPI to HDMI board to repo
    [MIPI2HDMI-B_Cu.gbr, MIPI2HDMI-B_Mask.gbr, MIPI2HDMI-B_Paste.gbr, MIPI2HDMI-B_Silkscreen.gbr, MIPI2HDMI-Edge_Cuts.gbr, MIPI2HDMI-F_Cu.gbr, MIPI2HDMI-F_Mask.gbr, MIPI2HDMI-F_Paste.gbr]
2023-12-23 Add beam break board to repo
    [705550001.stp, 705550002.stp, 705550003.stp, beambreak.kicad_pcb, beambreak.kicad_sch]
2023-12-23 Adding power distribution fuse block
    [PowerDistribution-B_Cu.gbr, PowerDistribution-B_Mask.gbr, PowerDistribution-B_Paste.gbr, PowerDistribution-B_Silkscreen.gbr, PowerDistribution-Edge_Cuts.gbr, PowerDistribution-F_Cu.gbr, PowerDistribution-F_Mask.gbr, PowerDistribution-F_Paste.gbr]
2023-12-23 Add Driver Station ButtonBoard2 to repo.
    [705410001.stp, 705410003.stp, 705410005.stp, 705410007.stp, 705410009.stp, 705430003.stp, 705430005.stp, 705430007.stp]
2023-12-23 Changed PCBs to circuit-boards
    [015913034.stp, 1-1734248-5.step, 10 SIZE CODE G-L.stp, 150080AS75000_Download_STP_WL-SMCW-0805_rev1.stp, 20021521-00010XXLFc.stp, 2601-1102.stp, 3V3-3V0-power-supply.kicad_sch, 3V3-power-supply.kicad_sch]
2023-12-25 Adding IMU-2X v3 which adds rate and heading PWM outputs
    [705410001.stp, 705410002.stp, 705430036.stp, 705550001.stp, 705550002.stp, 705550003.stp, 705550005.stp, CNC-Tech-3220-14-0300-00.step]
2023-12-25 Adding IMU-2X-v3/IMU-2X.kicad_prl
2023-12-26 Add NX-J401-Adapter V2. INCOMPLETE Requires fan connector.
    [1-1734248-5.step, 2601-1102.stp, 705410001.stp, 705430001.stp, 705430003.stp, 705550001.stp, 705550002.stp, 705550003.stp]
2023-12-26 Added debug harness pinout
    [LEDs.kicad_sch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]
2023-12-28 Modified to expand M.2 adapter space, temp sensor connector and pwr LED
    [BM02B-SRSS-TB.STEP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]
2023-12-29 Adding kraken power and can adapters
    [1335G1 IN HSG.STEP, 705410001.stp, 92916A325_Brass Washer.STEP, 93465A103_Brass Socket Head Screw-4-40x3-16.STEP, 93465A103_Brass Socket Head Screw.STEP, 93465A147_Brass Socket Head Screw.STEP, 93661A115_Copper SAE Washer.STEP, 97565A113_Copper Mil. Spec. Washer.STEP]
2023-12-31 Modified kraken power to rotate andersons 90 deg
    [kraken-power-adapter-B_Mask.gbr, kraken-power-adapter-B_Paste.gbr, kraken-power-adapter-B_Silkscreen.gbr, kraken-power-adapter-Edge_Cuts.gbr, kraken-power-adapter-F_Cu.gbr, kraken-power-adapter-F_Mask.gbr, kraken-power-adapter-F_Paste.gbr, kraken-power-adapter-F_Silkscreen.gbr]
2024-01-02 Increased clearance around key on kraken power adapter
    [kraken-power-adapter-B_Cu.gbr, kraken-power-adapter-B_Mask.gbr, kraken-power-adapter-B_Paste.gbr, kraken-power-adapter-B_Silkscreen.gbr, kraken-power-adapter-Edge_Cuts.gbr, kraken-power-adapter-F_Cu.gbr, kraken-power-adapter-F_Mask.gbr, kraken-power-adapter-F_Paste.gbr]
2024-01-02 Increased board area to allow room for VHB between can and power boards.
    [kraken-can-adapter-B_Cu.gbr, kraken-can-adapter-B_Mask.gbr, kraken-can-adapter-B_Paste.gbr, kraken-can-adapter-B_Silkscreen.gbr, kraken-can-adapter-Edge_Cuts.gbr, kraken-can-adapter-F_Cu.gbr, kraken-can-adapter-F_Mask.gbr, kraken-can-adapter-F_Paste.gbr]
2024-01-06 Adding NX Button Interface
    [705410006.stp, 705430003.stp, 705430006.stp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]
2024-01-06 Add NX Button Interface Board
2024-01-07 Change SL connectors to surface mount solder wires.
    [NX-ButtonInterface-B_Mask.gbr, NX-ButtonInterface-B_Paste.gbr, NX-ButtonInterface-B_Silkscreen.gbr, NX-ButtonInterface-Edge_Cuts.gbr, NX-ButtonInterface-F_Cu.gbr, NX-ButtonInterface-F_Mask.gbr, NX-ButtonInterface-F_Paste.gbr, NX-ButtonInterface-F_Silkscreen.gbr]
2024-01-08 Added some part numbers
    [IMU-2X-bom-07Jan2024.csv, IMU-2X.csv, LED.kicad_sch, power-supply.kicad_sch, pwm-heading.kicad_sch]
2024-01-11 Adding 2024 System Diagram skeleton
    [2024-SystemDiagram.kicad_pcb, 2024-SystemDiagram.kicad_sch]
2024-01-11 Removing system drawing kicad backups and add .gitignore for backups
2024-01-13 Add PD fuse and Orin NX symbols
    [2024-SystemDiagram.kicad_sch]
2024-01-15 Add wire tag to use instead of cable symbol.
    [2024-SystemDiagram.kicad_sch]
2024-01-16 Adding initial system drawing that include motors
    [2024-SystemDiagram.kicad_sch]
2024-01-20 Fixing bom and created gerbers for beam break board
    [beambreak-B_Cu.gbr, beambreak-B_Mask.gbr, beambreak-B_Paste.gbr, beambreak-B_Silkscreen.gbr, beambreak-Edge_Cuts.gbr, beambreak-F_Cu.gbr, beambreak-F_Mask.gbr, beambreak-F_Paste.gbr]
2024-01-21 Updated boms and exported output files for connector boards
    [MAG_encoder_adapter-B_Cu.gbr, MAG_encoder_adapter-B_Mask.gbr, MAG_encoder_adapter-B_Paste.gbr, MAG_encoder_adapter-B_Silkscreen.gbr, MAG_encoder_adapter-Edge_Cuts.gbr, MAG_encoder_adapter-F_Cu.gbr, MAG_encoder_adapter-F_Mask.gbr, MAG_encoder_adapter-F_Paste.gbr]
2024-01-21 System diagram update. Initial wiring complete
    [2024-SystemDiagram.kicad_sch]
2024-01-25 Fixed system drawing
    [2024-SystemDiagram.kicad_sch]
2024-01-25 Changed CAN ref des to number greater than 100 to allow future change
    [2024-SystemDiagram.kicad_sch]
2024-01-27 Updated system drawing
    [2024-SystemDiagram.kicad_sch]
2024-01-29 Adding CAN Terminator board
    [705550036.stp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]
2024-01-29 Updated the motor can bus assignments
    [2024-SystemDiagram.kicad_sch]
2024-02-03 Update the CAN-FD bus wiring
    [2024-SystemDiagram.kicad_sch]
2024-02-03 Adding updated system drawing schematic and pdf
    [2024-SystemDiagram.kicad_sch]
2024-02-04 Cleaned up system drawing
    [2024-SystemDiagram.kicad_sch]
2024-02-04 Adding RPI-PowerBoard output files
    [PI-Power-Board-B_Cu.gbr, PI-Power-Board-B_Mask.gbr, PI-Power-Board-B_Paste.gbr, PI-Power-Board-B_Silkscreen.gbr, PI-Power-Board-Edge_Cuts.gbr, PI-Power-Board-F_Cu.gbr, PI-Power-Board-F_Mask.gbr, PI-Power-Board-F_Paste.gbr]
2024-02-12 Add driver station button connector board
    [705510001.stp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]
2024-02-12 Added driver camera to system drawing
    [2024-SystemDiagram.kicad_sch]
2024-02-15 Modified sys dwg rio ethernet, added comment to nx adapter
    [2024-SystemDiagram.kicad_sch, NX-J401-Adapter.kicad_sch]
2024-02-15 Update gitignore for kicad files
2024-02-17 Move right side motor PDB connections
    [2024-SystemDiagram.kicad_sch]
2024-02-18 sat feb 17 system diagram
    [2024-SystemDiagram.kicad_sch]
2024-02-18 Update system diagram can bus
    [2024-SystemDiagram.kicad_sch]
2024-02-18 Change Note Retiontion to Note Hold
    [2024-SystemDiagram.kicad_sch]
2024-02-19 Updating system diagram to reflect the robot wiring
    [2024-SystemDiagram.kicad_sch]
2024-02-20 Adding CAN FD IDs to sys drawing
    [2024-SystemDiagram.kicad_sch]
2024-02-22 Add can ids for remaining motors
    [2024-SystemDiagram.kicad_sch]
2024-02-22 Adding 20203 Driver Station schematic
    [DriverStation.kicad_pcb, DriverStation.kicad_sch, PistolGrip.kicad_sch]
2024-02-24 Change transfer roller beam break circuit to DNP
    [2024-SystemDiagram.kicad_sch]
2024-02-24 Swapped Dump and Extend inputs to PDB on system dwg
    [2024-SystemDiagram.kicad_sch]
2024-02-24 Move Candle to VRM2 in sys dwg
    [2024-SystemDiagram.kicad_sch]
2024-02-26 Sys dwg: Swap right and left robot, move alt and catapult motors to FD
    [2024-SystemDiagram.kicad_sch]
2024-02-27 DNP third Orin-NX and move IMU to 2nd Orin
    [2024-SystemDiagram.kicad_sch]
2024-03-01 Moved extend to CAN-FD. Added NX to CAN-FD bus
    [2024-SystemDiagram.kicad_sch]
2024-03-01 Assigned cameras to the NX modules
    [2024-SystemDiagram.kicad_sch]
2024-03-01 Removing NX from Kraken bus due to CAN-FD conflict
    [2024-SystemDiagram.kicad_sch]
2024-03-17 Update sys diag. IMU CAN radio pwr
    [2024-SystemDiagram.kicad_sch]
2024-03-24 Marked NX indicator pull-down res as DNP to work with interface bd.
    [NX-IndicatorBoard.kicad_sch]
2024-06-09 "Initial check-in of CNC Router ESTOP circuit"
    [RouterEstop.kicad_pcb, RouterEstop.kicad_sch]
2024-06-16 Update CNC router to as-built
    [RouterEstop.kicad_sch]
2024-06-22 Adding kraken-can-adapter-V2 increases connector retention
    [1335G1 IN HSG.STEP, 705410001.stp, 93465A103_Brass Socket Head Screw.STEP, 93465A147_Brass Socket Head Screw.STEP, 93661A115_Copper SAE Washer.STEP, 97565A113_Copper Mil. Spec. Washer.STEP, 97715A424_Brass Button Head Hex Drive Screws.STEP, Kraken-back.dxf]
2024-06-23 CAN Adapter - Adjusted the connector clearance
    [93701A250_Steel Pan Head Torx Screws.STEP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]
2024-06-30 ButtonBd2 - Change connectors to gold plate. Add headers for teensy
    [705410001.stp, 705410003.stp, 705410005.stp, 705410007.stp, 705410009.stp, 705430003.stp, 705430005.stp, 705430007.stp]
2024-07-06 Add circuit board readme from AlexL
2024-07-06 Minor fixes to the circuit board readme
2024-07-14 Initial checkin
    [705410006.stp, 705430003.stp, 705430005.stp, 705430036.stp, 705550001.stp, 705550002.stp, 705550003.stp, 705550005.stp]
2024-07-14 Moved LED connector to clear lower board
    [NX-IndicatorBoard-B_Cu.gbr, NX-IndicatorBoard-B_Mask.gbr, NX-IndicatorBoard-B_Paste.gbr, NX-IndicatorBoard-B_Silkscreen.gbr, NX-IndicatorBoard-Edge_Cuts.gbr, NX-IndicatorBoard-F_Cu.gbr, NX-IndicatorBoard-F_Mask.gbr, NX-IndicatorBoard-F_Paste.gbr]
2024-07-15 Add item increment to kicad-export-fab.sh bom export
2024-07-16 Initial check-in of NX Adapter board v3
    [1-1734248-5.step, 2601-1102.stp, 705410001.stp, 705430001.stp, 705430003.stp, 705430005.stp, 705550001.stp, 705550002.stp]
2024-07-19 Interim checkin of NX Adapter board
    [MIPI-HDMI.kicad_sch, NX-J401-Adapter.kicad_pcb]
2024-07-20 NX Adapter interim checking
    [NX-J401-Adapter.kicad_pcb, NX-J401-Adapter.kicad_sch, PowerSupply.kicad_sch, Vishay-IHLE5050FH.STEP, nx-can.kicad_sch]
2024-07-22 Check in of NX Adapter and Indicator boards. Complete pending review
    [Dialight.step, LEDs.kicad_sch, MIPI-HDMI.kicad_sch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]
2024-07-28 Intermediate checkin of NX-Indicator-board
    [LEDs.kicad_sch, Lumex-LPF-C012303S.stp, NX-ButtonInterface.kicad_sch, NX-IndicatorBoard.kicad_pcb, NX-IndicatorBoard.kicad_sch, nx-can.kicad_sch]
2024-07-29 Checkin of NX Indicator board 2x CAN FD + 6 LEDs
    [LEDs.kicad_sch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]
2024-07-29 Checkin of NX J401 Adapter-V3 Moved mounting holes to match indicator bd
    [NX-J401-Adapter-B_Cu.gbr, NX-J401-Adapter-B_Mask.gbr, NX-J401-Adapter-B_Paste.gbr, NX-J401-Adapter-B_Silkscreen.gbr, NX-J401-Adapter-Edge_Cuts.gbr, NX-J401-Adapter-F_Cu.gbr, NX-J401-Adapter-F_Mask.gbr, NX-J401-Adapter-F_Paste.gbr]
2024-07-30 Initial checkin of kraken pwm controller
    [705510001.stp, CFR_RB3_7.2X7.5X3.5_L7.4H7.6T3.6S5LL18F0.55.step, PJ-102AH.step, PTV09A-4020F-B104.stp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]
2024-08-02 Update power supply inductor to 4.7uF
    [NX-J401-Adapter-B_Cu.gbr, NX-J401-Adapter-B_Mask.gbr, NX-J401-Adapter-B_Paste.gbr, NX-J401-Adapter-B_Silkscreen.gbr, NX-J401-Adapter-Edge_Cuts.gbr, NX-J401-Adapter-F_Cu.gbr, NX-J401-Adapter-F_Mask.gbr, NX-J401-Adapter-F_Paste.gbr]
2024-08-05 Minor update to NX-J401-Adapter-v3
    [Dialight.step, MIPI-HDMI.kicad_sch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]
2024-08-05 Fix bom. Made LVC245 an SO-20 part
    [LEDs.kicad_sch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]
2024-08-05 Minor BOM fix
    [NX-IndicatorBoard-B_Cu.gbr, NX-IndicatorBoard-B_Mask.gbr, NX-IndicatorBoard-B_Paste.gbr, NX-IndicatorBoard-B_Silkscreen.gbr, NX-IndicatorBoard-Edge_Cuts.gbr, NX-IndicatorBoard-F_Cu.gbr, NX-IndicatorBoard-F_Mask.gbr, NX-IndicatorBoard-F_Paste.gbr]
2024-08-09 Changed NX-adapter diff pairs to non-coplaner wave guide
    [NX-J401-Adapter-B_Cu.gbr, NX-J401-Adapter-B_Mask.gbr, NX-J401-Adapter-B_Paste.gbr, NX-J401-Adapter-B_Silkscreen.gbr, NX-J401-Adapter-Edge_Cuts.gbr, NX-J401-Adapter-F_Cu.gbr, NX-J401-Adapter-F_Mask.gbr, NX-J401-Adapter-F_Paste.gbr]
2024-08-10 Updated diff pairs and power supply layout
    [MIPI-HDMI.kicad_sch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]
2024-08-11 minor update to boost converter layout
    [NX-J401-Adapter-B_Cu.gbr, NX-J401-Adapter-B_Mask.gbr, NX-J401-Adapter-B_Paste.gbr, NX-J401-Adapter-B_Silkscreen.gbr, NX-J401-Adapter-Edge_Cuts.gbr, NX-J401-Adapter-F_Cu.gbr, NX-J401-Adapter-F_Mask.gbr, NX-J401-Adapter-F_Paste.gbr]
2024-08-11 Checkin of NX-Button Interface V2
    [705410006.stp, 705430003.stp, 705430006.stp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]
2024-08-17 Add NX Button Interface V2
    [BM02B-SURS-TF.STEP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]
2024-08-18 Add ground vias near diff pair vias to improve signal integrity.
    [NX-J401-Adapter-B_Cu.gbr, NX-J401-Adapter-B_Mask.gbr, NX-J401-Adapter-B_Paste.gbr, NX-J401-Adapter-B_Silkscreen.gbr, NX-J401-Adapter-Edge_Cuts.gbr, NX-J401-Adapter-F_Cu.gbr, NX-J401-Adapter-F_Mask.gbr, NX-J401-Adapter-F_Paste.gbr]
2024-08-21 initial checkin of mag encoder.
    [70555-0005--3DModel-STEP-361473.STEP, Molex-015912055.stp, SOT765-1.step, mag-encoder-drl_map.dxf, mag-encoder.kicad_pcb, mag-encoder.kicad_sch]
2024-08-22 Add SPI header for config. Center mounting holes on sensor
    [mag-encoder.kicad_pcb, mag-encoder.kicad_sch]
2024-08-24 Checking in 2 options of mag-encoder. WIP
    [70555-0005--3DModel-STEP-361473.STEP, Molex-015912055.stp, SOT765-1.step, mag-encoder-drl_map.dxf, mag-encoder.kicad_pcb, mag-encoder.kicad_sch]
2024-08-25 checkin of mag encoder
    [70555-0005--3DModel-STEP-361473.STEP, Molex-015912055.stp, SOT765-1.step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]
2024-08-25 removing directory for mag-encoder3
    [70555-0005--3DModel-STEP-361473.STEP, Molex-015912055.stp, SOT765-1.step, mag-encoder-drl_map.dxf, mag-encoder.kicad_pcb, mag-encoder.kicad_sch]
2024-08-26 changed pins to 0.125". Changed OK LED driver to mosfet.
    [mag-encoder-B_Cu.gbr, mag-encoder-B_Mask.gbr, mag-encoder-B_Paste.gbr, mag-encoder-B_Silkscreen.gbr, mag-encoder-Edge_Cuts.gbr, mag-encoder-F_Cu.gbr, mag-encoder-F_Mask.gbr, mag-encoder-F_Paste.gbr]
2024-08-31 Commit for mag-encoder2 with to fit within 1.25" bearing race
    [70555-0005--3DModel-STEP-361473.STEP, Molex-015912055.stp, SOT765-1.step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]
2024-08-31 Changed power LED to yellow. Reverse polarity diode to 1N4148
    [mag-encoder-B_Cu.gbr, mag-encoder-B_Mask.gbr, mag-encoder-B_Paste.gbr, mag-encoder-B_Silkscreen.gbr, mag-encoder-Edge_Cuts.gbr, mag-encoder-F_Cu.gbr, mag-encoder-F_Mask.gbr, mag-encoder-F_Paste.gbr]
2024-09-08 Adding kicad export scripts
    [kicad-fab.cfg]
2024-09-14 Update the IMU-2X design files ot new kicad rev. Assy files etc.
    [IMU-2X-B_Cu.gbr, IMU-2X-B_Mask.gbr, IMU-2X-B_Paste.gbr, IMU-2X-B_Silkscreen.gbr, IMU-2X-Edge_Cuts.gbr, IMU-2X-F_Cu.gbr, IMU-2X-F_Mask.gbr, IMU-2X-F_Paste.gbr]
2024-09-21 Add PDBv2, HallSwitchv2 and TeeCan
    [70541-0036.stp, 70555-0037.step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]
2024-09-28 Export files for new pcbs + board characteristics
    [HallSwitch-B_Cu.gbr, HallSwitch-B_Mask.gbr, HallSwitch-B_Paste.gbr, HallSwitch-B_Silkscreen.gbr, HallSwitch-Edge_Cuts.gbr, HallSwitch-F_Cu.gbr, HallSwitch-F_Mask.gbr, HallSwitch-F_Paste.gbr]
2024-10-08 Add new boms (gold-plated tee-can)etc
    [TEE-CAN-B_Cu.gbr, TEE-CAN-B_Mask.gbr, TEE-CAN-B_Paste.gbr, TEE-CAN-B_Silkscreen.gbr, TEE-CAN-Edge_Cuts.gbr, TEE-CAN-F_Cu.gbr, TEE-CAN-F_Mask.gbr, TEE-CAN-F_Paste.gbr]
2024-10-12 Fix pcb fab layers
    [70541-0036.stp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]
2024-10-12 Minor Fab fixes
    [PowerDistribution-B_Cu.gbr, PowerDistribution-B_Mask.gbr, PowerDistribution-B_Paste.gbr, PowerDistribution-B_Silkscreen.gbr, PowerDistribution-Edge_Cuts.gbr, PowerDistribution-F_Cu.gbr, PowerDistribution-F_Mask.gbr, PowerDistribution-F_Paste.gbr]
2024-10-15 Checking in Hall Switch Gerbers
    [HallSwitch-B_Cu.gbr, HallSwitch-B_Mask.gbr, HallSwitch-B_Paste.gbr, HallSwitch-B_Silkscreen.gbr, HallSwitch-Edge_Cuts.gbr, HallSwitch-F_Cu.gbr, HallSwitch-F_Mask.gbr, HallSwitch-F_Paste.gbr]
2024-10-15 Updating Power Distribution Board V2 Output Files
    [PowerDistribution-B_Cu.gbr, PowerDistribution-B_Mask.gbr, PowerDistribution-B_Paste.gbr, PowerDistribution-B_Silkscreen.gbr, PowerDistribution-Edge_Cuts.gbr, PowerDistribution-F_Cu.gbr, PowerDistribution-F_Mask.gbr, PowerDistribution-F_Paste.gbr]
2024-10-15 Adding TEE-CAN-SL Output files
    [TEE-CAN-B_Cu.gbr, TEE-CAN-B_Mask.gbr, TEE-CAN-B_Paste.gbr, TEE-CAN-B_Silkscreen.gbr, TEE-CAN-Edge_Cuts.gbr, TEE-CAN-F_Cu.gbr, TEE-CAN-F_Mask.gbr, TEE-CAN-F_Paste.gbr]
2024-10-18 Add thermal relief for resistors
    [PowerDistribution-B_Cu.gbr, PowerDistribution-B_Mask.gbr, PowerDistribution-B_Paste.gbr, PowerDistribution-B_Silkscreen.gbr, PowerDistribution-Edge_Cuts.gbr, PowerDistribution-F_Cu.gbr, PowerDistribution-F_Mask.gbr, PowerDistribution-F_Paste.gbr]
2024-10-19 Add ibom for Power Distribution Board
    [PowerDistribution-B_Cu.gbr, PowerDistribution-B_Mask.gbr, PowerDistribution-B_Paste.gbr, PowerDistribution-B_Silkscreen.gbr, PowerDistribution-Edge_Cuts.gbr, PowerDistribution-F_Cu.gbr, PowerDistribution-F_Mask.gbr, PowerDistribution-F_Paste.gbr]
2024-10-19 WIP checkin of swerve controller harness
    [Joystick-Button-Bd-Harness.kicad_pcb, Joystick-Button-Bd-Harness.kicad_sch]
2024-10-25 Revised mag encoder based on WP feedback
    [70555-0005--3DModel-STEP-361473.STEP, Molex-015912055.stp, SOT765-1.step, kicad-fab.cfg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]
2024-11-11 Add CAN transceiver to button interface
    [705410006.stp, 705430003.stp, 705430006.stp, IHLP1212BZ-11.step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]
2024-11-25 Add mag encoder V4 to add fault handling
    [70555-0005--3DModel-STEP-361473.STEP, BQA0014A.stp, Molex-015912055.stp, SOT765-1.step, kicad-fab.cfg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]
2024-11-26 Minor layout fix to mag encoder
    [mag-encoder-B_Cu.gbr, mag-encoder-B_Mask.gbr, mag-encoder-B_Paste.gbr, mag-encoder-B_Silkscreen.gbr, mag-encoder-Edge_Cuts.gbr, mag-encoder-F_Cu.gbr, mag-encoder-F_Mask.gbr, mag-encoder-F_Paste.gbr]
2024-12-04 Change Green LED current to 5mA
    [mag-encoder-B_Cu.gbr, mag-encoder-B_Mask.gbr, mag-encoder-B_Paste.gbr, mag-encoder-B_Silkscreen.gbr, mag-encoder-Edge_Cuts.gbr, mag-encoder-F_Cu.gbr, mag-encoder-F_Mask.gbr, mag-encoder-F_Paste.gbr]
2024-12-07 Update mag encoder silk and board color
    [mag-encoder-B_Cu.gbr, mag-encoder-B_Mask.gbr, mag-encoder-B_Paste.gbr, mag-encoder-B_Silkscreen.gbr, mag-encoder-Edge_Cuts.gbr, mag-encoder-F_Cu.gbr, mag-encoder-F_Mask.gbr, mag-encoder-F_Paste.gbr]
2026-10-19 Adding files with PWR and CAN in one board
2026-11-01 adding gerbers
2026-11-05 Update CAN Hub PCB layout and schematic
