frc971/electrical/(notices)

Notices in the files:
circuit-boards/Orin-NX-PCBs/NX-J401-Adapter-v3/3dModels/2601-1102.stp:
author */ ('License CC BY-ND 4.0'),
parts and their libraries:
Copyright 2021 Accelerated Designs. All rights reserved.
Copyright 2016 Accelerated Designs. All rights reserved.
